TadeoSinay/planos_industrial_flama/referencias/Dimensionamiento Tecnico (3).docx

# Dimensionamiento Técnico

# Producto

# Procesos

A nivel listado de materiales los matafuegos en sus diferentes tamaños se componen de la cúpula (pieza embutida superior del matafuego), el cuerpo (chapa cilindrada) y el fondo (pieza embutida inferior). Todas ellas se procesan en paralelo con el objetivo de poder realizar la soldadura y ensamblaje y generar un buffer intermedio de cada uno de los semielaborados. Para todas las piezas únicamente para ABC realizadas a continuación se seleccionó un acero hipoeutectoide SAE 1010. Es un acero ordinario al carbono (perteneciente a la serie 10XX) con un muy bajo contenido de carbono, lo que le otorga una excelente ductilidad para ser embutido y soldado.

Sus componentes son Carbono (C): 0,08% - 0,13%, Manganeso (Mn): 0,30% - 0,60%, Fósforo (P): ≤ 0,040% (máximo), Azufre (S): ≤ 0,050% (máximo) y Hierro (Fe): El porcentaje restante (aproximadamente 99%), En el diagrama de hierro - carbono se ubica en el acero laminado en frío. En la escala de x se ubica en 0,10% de Carbono, lejos del punto eutectoide del 0,8% de carbono y su microestructura a temperatura ambiente (fase estable) está por debajo de la línea crítica inferior compuesto principalmente por ferrita (hierro alfa, muy blando y maleable) y perlita (láminas alternas de ferrita y cementita).

Fabricación de la cúpula del matafuego (formato 1, 2,5, 5, 10 kg ABC)

Se parte de una bobina de acero que se desenrolla como fleje continuo. Mediante un balancín, se corta un disco circular cuyo diámetro está calculado para conservar la superficie de chapa necesaria para la deformación plástica posterior. El sobrante de la tira, la bandera o scrap, es el material que queda alrededor del círculo recortado y va directo al chatarrero cómo recupero de chapa.

El disco se coloca sobre la matriz de embutido, cuya cavidad tiene tallada la forma negativa de la cúpula. El pisador sujeta el borde del disco con una fuerza controlada para evitar que la chapa se arrugue durante el flujo del material. El punzón desciende desde arriba y empuja el centro del disco hacia el interior de la cavidad, generando una deformación plástica progresiva. El borde periférico del disco fluye radialmente hacia adentro, se dobla sobre el radio de entrada de la matriz y se convierte en la virola, mientras el punzón le imprime al fondo la geometría levemente aplanada característica de la cúpula. Al finalizar el recorrido, el expulsor extrae la pieza de la cavidad.

Luego se punzona el orificio central donde irá el cuello, se le introduce un mandril simulando la válvula para marcar la posición angular de referencia, y finalmente el cuello se suelda a la cúpula en una soldadura orbital automática que rota la pieza 360° generando un cordón continuo y homogéneo apto para recipientes a presión.

PROPUESTA TÉCNICA (REVISAR CON ESPECIFICACIONES)

Sin conocer el diámetro exacto del disco ni el diámetro final de la cúpula no podemos calcular los valores reales, pero a modo orientativo para una cúpula de matafuego de 5 kg los órdenes de magnitud típicos son los siguientes.

La fuerza de embutido depende principalmente del perímetro del punzón, el espesor de chapa y la resistencia a la tracción del material. Para un acero SAE 1010 de 1.5 mm de espesor y un diámetro de punzón del orden de 130 mm, la fuerza de embutido ronda entre 70 y 100 kN. A esto se suma la fuerza del pisador, que suele representar entre el 20 y el 30% de la fuerza de embutido[^1] y resulta crítica para controlar el flujo del material sin generar arrugas ni adelgazamiento excesivo de la virola.

La holgura entre punzón y matriz se fija entre 1.1 y 1.3 veces el espesor de chapa, en este caso entre 1.65 y 1.95 mm, lo que permite el flujo del material sin reducir intencionalmente el espesor de la pared. El radio de entrada de la matriz suele ser entre 4 y 8 veces el espesor, es decir entre 6 y 12 mm, valor que condiciona directamente el riesgo de fractura en la zona de transición entre el fondo y la virola. La relación de embutido, definida como el cociente entre el diámetro del disco y el diámetro del punzón, no debe superar 2.0 para el SAE 1010[^2], límite a partir del cual sería necesario realizar la operación en dos o más pasadas con recocido intermedio.

Fabricación del cuerpo del matafuego (formato 2,5, 5, 10 kg ABC)

Se parte de una plancha de acero, cortada previamente en forma rectangular con las dimensiones exactas que determinarán el desarrollo plano del cilindro, es decir su longitud corresponde al perímetro final del cuerpo y su ancho a la altura del mismo.

Antes de cualquier conformado, la plancha plana recibe un grabado de identificación de lote mediante una estampa de punzonado. Un troquel con caracteres en relieve impacta sobre la superficie de la chapa generando una deformación plástica localizada que imprime la marca sin perforar el material. Esta operación se realiza sobre la chapa plana porque una vez conformado el cilindro resulta inaccesible para cualquier herramienta de estampado interior.

La plancha pasa luego a una roladora de tres rodillos, que es la máquina encargada de transformar la geometría plana en cilíndrica. Los tres rodillos están dispuestos en forma triangular: dos inferiores fijos que sirven de apoyo y uno superior regulable que ejerce la fuerza de curvatura descendiendo sobre la chapa. Al hacer pasar la plancha entre ellos, el rodillo superior aplica una carga perpendicular que supera el límite elástico del material generando una deformación plástica progresiva y continua a lo largo de toda la longitud de la chapa. La curvatura final depende de la distancia entre los rodillos inferiores y de la posición del rodillo superior. Cuanto más desciende este último, mayor es la curvatura impuesta. El proceso se regula hasta que los dos extremos de la plancha quedan enfrentados y alineados, conformando así un cilindro abierto en su costura longitudinal.

En este punto la pieza pasa a la etapa de soldadura. El operario presenta los extremos enfrentados de la plancha y ejecuta un cordón de soldadura longitudinal uniendo ambos bordes. Esta costura es la junta más crítica del cuerpo del matafuego ya que es la zona de mayor concentración de tensiones cuando el recipiente está bajo presión interna, razón por la cual la marca de la cúpula se alinea deliberadamente con ella durante el ensamble final para que la válvula no quede sobre esa línea. El resultado es un cilindro cerrado, con el cuerpo estructural del matafuego conformado y listo para recibir la cúpula y la base.

Fabricación del cuerpo del matafuego (formato 1 kg ABC)

En este caso, no se realiza ni numerado ni cilindrado. Se compran tubos de 6 metros de largo con un diámetro de 76 milímetros, los cuales se cortan con un largo de 2,25 metros para formar el cuerpo, sin requerir de soldadura longitudinal.

Fabricación del fondo del matafuego (formato 1, 2,5, 5, 10 kg ABC)

El proceso de obtención del fondo es análogo al de la cúpula. Se parte de la misma bobina, se corta un disco circular mediante balancín y el scrap resultante va directo al chatarrero. El disco se embute siguiendo el mismo principio ya descrito de deformación plástica progresiva con pisador, punzón y expulsor.

La diferencia respecto a la cúpula reside únicamente en la geometría de la matriz. El fondo es más simple, sin orificio central ni operaciones posteriores, y su curvatura cóncava hacia el interior del recipiente es más suave y uniforme, lo que garantiza una distribución homogénea de la presión interna en servicio. Al finalizar el recorrido del punzón el expulsor extrae la pieza y el proceso concluye.

Unión cuerpo y fondo (formato 1, 2,5, 5, 10 kg ABC)

Dado que el diámetro de la virola del fondo es ligeramente mayor que el diámetro interior del cuerpo, su inserción requiere una máquina con mandril expansor. El mandril ingresa contraído dentro de la concavidad del fondo, se expande radialmente hasta acoplar su geometría a la superficie interior del fondo y lo empuja axialmente desde la parte superior del cuerpo hacia abajo. La presión axial ejercida expande el diámetro del cuerpo lo suficiente para que la virola del fondo lo atraviese. Al llegar a su posición definitiva el cuerpo recupera su geometría por elasticidad y el fondo queda mecánicamente retenido por interferencia. En esta instancia no hay soldadura.

Bordoneado del extremo superior del cuerpo (formato 1, 2,5, 5, 10 kg ABC)

En el extremo superior del cuerpo, es decir el lado opuesto al fondo y abierto hacia el interior, se realiza un bordoneado mediante una máquina de rodillos. Un rodillo exterior y uno interior actúan simultáneamente sobre la pared del cilindro generando por deformación plástica localizada un resalto perimetral continuo hacia el interior del cilindro, sin remoción de material. Este reborde reduce localmente el diámetro interior del extremo superior y actúa como tope mecánico. Cuando la cúpula es presentada desde afuera, su pestaña apoya sobre ese reborde quedando retenida en posición y alineada respecto al cuerpo, a la espera de la soldadura orbital que completará la unión.

Soldadura del matafuego (formato 1, 2,5, 5, 10 kg ABC)

Una vez presentadas las tres piezas, fondo, cuerpo y cúpula, la unión estructural se realiza mediante dos procesos de soldadura MIG (GMAW) con alambre sólido ER70S-6 y gas de protección mixto 90% Argón / 10% CO₂. Este alambre de acero bajo carbono con alto contenido de manganeso y silicio garantiza cordones limpios, sin porosidad y con resistencia a la tracción mínima de 500 MPa según norma AWS A5.18, apto para recipientes a presión bajo norma IRAM 3523.

Vale aclarar que el matafuego de 1 kg no requiere de soldadura longitudinal, ya que su cuerpo proviene de tubos comprados directamente al proveedor. La descripción que sigue aplica a los modelos de acero SAE 1010: 1 kg versión acero, 2.5, 5 y 10 kg.

Soldadura longitudinal del cuerpo (formato 2,5, 5, 10 kg ABC)

La costura longitudinal, los dos bordes de la plancha enrollada que quedaron enfrentados, se ejecuta en una soldadora longitudinal automática de hilo continuo (linear seam welding machine). La máquina sujeta el cuerpo cilíndrico mediante mordazas de cobre que alinean y comprimen los bordes a tope, y un carro motorizado desplaza la antorcha MIG en dirección axial a velocidad constante y controlada por PLC (en axo welding) generando un cordón de penetración completa a lo largo de toda la junta. Las mordazas de cobre cumplen una doble función. Mantienen la alineación de los bordes y actúan como disipadores térmicos que evitan la deformación del cilindro por calor. Esta costura es la junta de mayor exigencia estructural del recipiente ya que trabaja bajo tensión circunferencial cuando el matafuego está presurizado.

El diámetro del alambre ER70S-6 se selecciona según el espesor de chapa de cada modelo. Para el de 1 kg acero (chapa ≈ 1.0 mm) se utiliza alambre de 0.6 mm con corriente de 40 a 80 A. Para los de 2.5 y 5 kg (chapa ≈ 1.5 mm) se utiliza 0.8 mm con corriente de 80 a 140 A. Para el de 10 kg (chapa ≈ 2.0 a 2.5 mm) se utiliza 0.8 o 1.0 mm con corriente de 100 a 180 A.

Soldadura circunferencial del fondo y la cúpula (formato 1, 2,5, 5, 10 kg ABC)

Las uniones perimetrales entre el fondo y el cuerpo, y entre la cúpula y el cuerpo, se ejecutan en una soldadura orbital automática de mandril rotante (circumferential seam welding machine). La pieza se posiciona sobre un eje motorizado que la hace rotar 360° a velocidad constante mientras la antorcha MIG permanece fija, generando un cordón circunferencial continuo y homogéneo. Se realizan dos pasadas orbitales. Una para el fondo en el extremo inferior y otra para la cúpula en el extremo superior, con el mismo criterio de selección de diámetro de alambre que la soldadura longitudinal. Con la finalización de estas dos soldaduras el matafuego queda conformado estructuralmente como recipiente cerrado y listo para prueba hidráulica, pintura y carga del agente extintor.

Prueba hidráulica de fabricación (PH de fábrica)

Es el ensayo que se realiza sobre cada recipiente recién soldado antes de salir de la línea de producción, según la norma IRAM 3523 (Matafuegos de polvo bajo presión manuales) con el método de ensayo definido en la norma IRAM 2587 (Cilindros y tubos de acero — Métodos de ensayo de presión hidrostática interna).

El recipiente se llena completamente con agua eliminando todo el aire interior y se lo conecta a una bomba hidráulica de pistón que eleva la presión interna de forma gradual y controlada hasta alcanzar la presión de ensayo de 3.5 MPa (35 kg/cm²), que equivale a 2.5 veces la presión de servicio nominal de 1.4 MPa. Estos valores están confirmados en las fichas técnicas oficiales de fabricantes con sello IRAM, como la del matafuego de 5 kg de Melisam[^3].La presión se mantiene durante el tiempo establecido por norma mientras el operario inspecciona visualmente la totalidad de la superficie del recipiente, prestando especial atención a las tres costuras soldadas. El recipiente aprueba si no presenta deformación permanente, fisuras, exudaciones ni pérdidas en ningún punto. El ensayo es obligatorio para el 100% de las unidades producidas y su resultado queda registrado individualmente, siendo requisito indispensable para obtener el sello IRAM 3523.

Granallado del cilindro ensamblado (formato 1, 2,5, 5, 10 kg ABC)

Una vez conformado y soldado el cuerpo del matafuego, la superficie exterior de acero presenta óxido, escama de laminación y residuos del proceso de soldadura que impedirían una correcta adhesión de la pintura. Para eliminarlos y generar el perfil de rugosidad necesario se realiza el granallado por turbina centrífuga en una cámara cerrada de tratamiento superficial.

El sistema utilizado es del tipo power and free. Los cilindros se cuelgan individualmente de ganchos que circulan suspendidos sobre un riel aéreo mediante un transportador de cadena, avanzando de forma continua e independiente a velocidad controlada a través de la cámara sin intervención del operario una vez cargada la línea.

Dentro de la cámara, las turbinas centrífugas accionadas por motores eléctricos aceleran la granalla mediante fuerza centrífuga. La granalla ingresa al centro de la turbina, un distribuidor la pre acelera hacia las paletas y es en las paletas donde adquiere la máxima velocidad de proyección, alcanzando valores típicos de industria de entre 60 y 90 m/s. A esa velocidad el impacto sobre el acero produce dos efectos simultáneos. Elimina óxido, escama y contaminantes, y genera una rugosidad superficial mediante deformación plástica localizada de la capa exterior, creando un perfil de anclaje que incrementa la superficie de contacto disponible para la pintura.

La granalla utilizada es granalla esférica de acero de alto carbono cuyas especificaciones de dureza, densidad y composición química están definidas por la norma ISO 11124-3, adoptada oficialmente en español por INTECO bajo la referencia INTE ISO 11124-2:2021. [^4]Esta norma establece que la granalla esférica de alto carbono debe contener entre 0,85 y 1,20% de carbono, con estructura interna de martensita revenida que le confiere alta resistencia al impacto repetido y permite su reutilización en cientos de ciclos. La granulometría utilizada para cilindros de este tipo corresponde a las denominaciones S330 o S390 (granalla esférica - centésimas de pulgada) según SAE J444, equivalentes a diámetros de aproximadamente 0,85 a 1,2 mm.

El grado de limpieza superficial obtenido corresponde al nivel Strahlmittelstrahlen (Sa- limpieza por proyección de abrasivo) 2.5 de la norma ISO 8501-1, adoptada oficialmente en español por AENOR bajo la referencia UNE-EN ISO 8501-1:2008 con el título "Preparación de substratos de acero antes de la aplicación de pinturas y productos relacionados. Evaluación visual de la limpieza de las superficies. Parte 1: Grados de óxido y de preparación de substratos de acero no pintados después de eliminar totalmente los recubrimientos anteriores". [^5]El nivel Sa 2.5 se define como granallado muy exhaustivo, con al menos el 95% de cada porción de la superficie libre de cualquier resto visible de óxido, escama o contaminante. El perfil de rugosidad resultante, medido como altura pico a valle (Rz) según norma ISO 8503, se sitúa típicamente entre 40 y 70 micrones para granalla S330/S390 sobre acero de 1,5 mm, rango que garantiza adherencia mecánica adecuada sin generar valles tan profundos que la pintura no alcance a cubrir los picos, lo que derivaría en corrosión prematura.

La granalla no se desperdicia, ya que la cámara cuenta con un sistema de recuperación mecánica continua que recoge, tamiza y recircula el abrasivo, separando los finos agotados y reponiendo únicamente el material en condiciones de uso.

En cuanto a la disposición final de los residuos generados por el proceso, la granalla desgastada y los finos separados por el tamiz son chatarra ferrosa sin carácter peligroso y se entregan al chatarrero como desperdicio final del proceso. El polvo capturado por el colector de mangas, en cambio, contiene partículas finas de óxido, escama y contaminantes superficiales y puede clasificar como residuo especial según la Ley Provincial 11.720 de Residuos Especiales, reglamentada por el Decreto 806/97, que rige en el Partido de Avellaneda como en todo el territorio bonaerense[^6]. Bajo esta normativa, disponible en, el generador está obligado a inscribirse en el Registro de Generadores de Residuos Especiales de la Provincia de Buenos Aires, presentar declaración jurada anual ante el OPDS (Organismo Provincial para el Desarrollo Sostenible) y contratar el retiro, transporte y disposición final del polvo únicamente con operadores y transportistas habilitados por la Provincia, utilizando el manifiesto de transporte establecido por la Resolución 118/11 como documento de trazabilidad obligatorio de cada movimiento de residuo.

Corrección de defectos (formato 1, 2,5, 5, 10 kg ABC)

Es una etapa menor dentro del flujo, de intervención acotada y baja incidencia en el tiempo de ciclo. Durante las soldaduras puede generarse salpicadura, es decir gotas del baño de fusión que saltan durante el arco y solidifican adheridas sobre la superficie exterior, por fuera del cordón. Es un fenómeno intrínseco al MIG/MAG en transferencia por cortocircuito o globular con mezcla rica en CO₂, de aparición intermitente y posición no predecible, por lo que su detección es visual. odos los formatos comparten este fenómeno en la medida en que tienen costura soldada. El de 1 kg, cuyo cuerpo proviene de tubo de acero al carbono SAE 1010 sin costura longitudinal, solo presenta salpicadura en las soldaduras circunferenciales del fondo y la cúpula, no en la generatriz, por lo que su corrección es de menor extensión que la de los formatos cilindrados de 2,5, 5 y 10 kg.

La remoción se resuelve de forma escalonada, con el granallado como operación principal. La mayor parte de la salpicadura (gotas finas y residuo superficial) se elimina durante el granallado, donde el impacto de la granalla a 60–90 m/s remueve las proyecciones de soldadura junto con el óxido y la escama de laminación. En consecuencia, esta etapa se limita al retiro puntual de la salpicadura adherente de mayor tamaño que haya sobrevivido, mediante un golpe seco de cincel (cortafierro) y martillo, ejecutado manualmente por un operario. La herramienta manual se justifica por el carácter intermitente y de posición variable del defecto, que no amortiza una estación automática, y porque el cincel actúa solo sobre la gota superpuesta de unión débil, sin desgastar metal base ni comprometer el espesor de diseño en paredes de 1 a 2,5 mm de recipiente a presión.[^7] El retoque se realiza sobre áreas mínimas y aisladas, sin afectar la preparación superficial del conjunto previa al pintado.

La relevancia de esta etapa depende directamente de la calidad de la soldadura aguas arriba: con transferencia por MIG pulsado y una mezcla de mayor contenido de argón (ver criterio de gas de protección), el volumen de salpicadura se reduce sensiblemente y la corrección tiende a limitarse a un control visual con retoque esporádico.[^8]

Criterio de selección del gas de protección (90/10 Ar/CO₂)

Para las costuras de los formatos de menor espesor se adopta una mezcla de protección 90/10 argón/CO₂, en lugar de la mezcla de propósito general 75/25 (C25). El criterio combina comportamiento de arco, costo y propiedades mecánicas.

En chapa fina, una mayor proporción de argón produce un arco más suave y una mínima generación de salpicadura, mientras que la C25 entrega salpicadura sólo relativamente baja; el CO₂ en mayor proporción vuelve el arco más errático, al punto que el CO₂ puro genera entre 25 y 40% más salpicadura que la 75/25. [^9] Menor salpicadura implica menor limpieza posterior, que es donde está el costo real: en la estructura de costos de soldadura el gas representa apenas un 2–5% del total y la mano de obra es el rubro dominante,[^10] de modo que un incremento menor en el precio del gas se compensa con creces al reducir el retrabajo. Un caso documentado del cambio de C25 a 90/10 registró un leve aumento del costo de gas frente a una reducción del costo total del trabajo del orden del 21%, por menor amolado y menos horas de mano de obra. [^11]

La elección no se lleva al extremo de argón puro por dos razones. Primero, el argón puro sobre acero desestabiliza el arco y produce mala calidad de soldadura, por lo que las mezclas para acero al carbono se mantienen en el rango de 75 a 95% de argón. [^12] Segundo, la composición del gas afecta las propiedades mecánicas: un mayor contenido de argón eleva la resistencia a la tracción y a la fluencia pero reduce la ductilidad, mientras que un mayor contenido de CO₂ mejora la ductilidad y la resistencia a la fisuración. [^13] Para un recipiente a presión, donde se requiere resistencia junto con tenacidad, el óptimo cae en una mezcla balanceada del tipo 85/15 a 90/10, que concilia arco estable, mínima salpicadura, bajo aporte térmico apto para chapa fina y un compromiso mecánico adecuado.

Pintado matafuego granallado (formato 1, 2,5, 5, 10 kg ABC)

Antes de aplicar la pintura el cuerpo del matafuego pasa por una etapa de pretratamiento químico que consta de dos pasos en túnel continuo integrado al sistema power and free. El primero es el desengrasado. La superficie granallada, aunque visualmente limpia, puede presentar trazas de aceite de embutido, lubricantes de soldadura y humedad residual que comprometerían la adherencia de la pintura y alterarían la conductividad eléctrica necesaria para el proceso electrostático. Se aplica un agente desengrasante alcalino por aspersión mientras la pieza avanza suspendida del riel. El segundo paso es el fosfatizado de hierro. Se deposita sobre el acero una capa microcristalina de fosfato que cumple una doble función, generar un perfil de anclaje químico que complementa el perfil mecánico obtenido por granallado, y crear una barrera pasivante que inhibe la oxidación bajo la película de pintura. Ambas etapas se ejecutan en el túnel de aspersión y van seguidas de enjuagues intermedios y un enjuague final antes de ingresar a la cámara de pintura.

La pintura utilizada es pintura en polvo de base poliéster termofija aplicada por el método electrostático en cámara cerrada. El proceso electrostático requiere que la pieza esté conectada a tierra y que su superficie tenga la rugosidad adecuada para que las partículas de polvo cargadas eléctricamente se adhieran de forma mecánica y electrostática antes del curado. Las partículas son cargadas en la pistola pulverizadora y proyectadas hacia el cilindro, generando una atracción que adhiere el polvo de forma uniforme sobre toda la superficie. El polvo no adherido es recuperado por el sistema de la cámara y reutilizado, con una eficiencia de transferencia superior al 90%.

El color es rojo, obligatorio por la norma IRAM 3523 para matafuegos de polvo bajo presión, con la referencia cromática definida en la norma IRAM-DEF D 1054 (Carta de colores para pinturas). La norma IRAM 3517-2 aclara explícitamente que se admiten pequeñas diferencias de tonalidad propias del proceso de fabricación, siendo las muestras de color puestas a disposición del IRAM. En la práctica industrial argentina el rojo aplicado en matafuegos de acero corresponde al RAL 3000 (rojo fuego) como referencia orientativa no obligatoria. Los recipientes de aluminio o acero inoxidable pueden entregarse sin pintar según la misma norma.

El espesor de capa varía según el tamaño del matafuego. Para los modelos de 1 y 2,5 kg se aplica entre 60 y 80 micrones, y para los de 5 y 10 kg entre 80 y 120 micrones. Un espesor insuficiente compromete la resistencia a la corrosión y al impacto; uno excesivo puede generar acumulaciones en bordes y soldaduras y dificultar el curado uniforme.

Una vez aplicado el polvo la pieza ingresa al horno de curado. La temperatura se sitúa entre 180 y 200°C y el tiempo de permanencia es de entre 10 y 20 minutos, parámetros dentro de los cuales el polvo se funde, nivela y polimeriza formando una película continua, homogénea y químicamente reticulada e irreversible. Los matafuegos de mayor masa térmica como el de 10 kg requieren un tiempo de residencia levemente mayor para asegurar que toda la pared del cilindro alcance la temperatura de curado de forma homogénea. El control de tiempo y temperatura se realiza mediante PLC con termocuplas en distintos puntos del horno para evitar el sobrecurado, que produce amarillamiento, pérdida de brillo y degradación de las propiedades mecánicas de la película.

Rellenado y conformado final del PT (formato 1, 2,5, 5, 10 kg ABC)

Con el matafuego pintado y enfriado comienza la etapa de rellenado y ensamblado final, que transforma el recipiente vacío en un equipo operativo listo para su uso.

El primer paso es la carga del polvo químico. Con la boca superior del cuerpo libre, se introduce el agente extintor, polvo químico seco ABC a base de fosfato monoamónico (MAP), por gravedad y vibración hasta alcanzar el peso de carga nominal correspondiente a cada modelo. El polvo debe cumplir con la norma IRAM 3569 para fuegos clase ABC. La carga se realiza antes de colocar la válvula porque una vez roscada el acceso a la boca queda bloqueado.

El segundo paso es el ensamblaje de la válvula. La válvula llega a la línea de ensamblado como un conjunto pre-ensamblado que integra el tubo pescante, el manómetro y el accionador. El tubo pescante es un caño que llega hasta el fondo del recipiente y conduce el polvo desde la base del cilindro hacia la válvula cuando el equipo se activa. Su material se selecciona en función del tamaño del modelo y las propiedades del agente extintor, siguiendo el criterio técnico de que el material debe siempre elegirse en base a los requisitos normativos y a las propiedades del agente extintor utilizado.[^14] En los modelos de 1 y 2,5 kg el tubo pescante puede fabricarse en PVC o PEAD (polietileno de alta densidad). Su menor longitud y la presión relativa del equipo permiten que estos materiales poliméricos mantengan la geometría sin deformaciones durante la vida útil del equipo, siendo además inertes frente al fosfato monoamónico y de menor peso y costo que el acero. En los modelos de 5 y 10 kg el tubo pescante es de acero al carbono SAE 1010, el mismo grado utilizado en el cuerpo del recipiente, cuya selección se justifica por la mayor longitud del caño necesaria para alcanzar el fondo de un cilindro más alto. A esa longitud, el PVC y el PEAD no garantizan la rigidez estructural suficiente para mantener el extremo inferior en contacto permanente con el polvo del fondo bajo presión interna sostenida de 1.4 MPa durante los 20 años de vida útil del equipo, mientras que el acero al carbono lo hace sin deformación, sin reacción química con el agente extintor y dentro del rango de temperaturas de operación de -20°C a +60°C exigido por norma. La ASTM A513, norma de referencia para tubos mecánicos de acero al carbono soldados y sin costura, define las especificaciones de resistencia y dimensionales del material empleado[^15].

El manómetro, con sello IRAM 3533 según norma ABNT NBR 15808, debe estar montado en el conjunto antes de roscar, ya que es el único indicador disponible para verificar la presión en el paso siguiente. Todo el conjunto se rosca sobre la boca de la cúpula con rosca M30, ajustándose con torque controlado para garantizar el sello hermético mediante el o-ring de caucho sintético alojado en el asiento de la válvula de latón cobreado forjado.

El tercer paso es la presurización con nitrógeno seco. A través de la válvula ya roscada se inyecta nitrógeno seco hasta alcanzar la presión de servicio de 1.4 MPa (14 kg/cm²). Se utiliza nitrógeno seco y no aire comprimido porque es un gas inerte que no aporta humedad al interior del recipiente, evitando la aglomeración del polvo y la corrosión interna del cilindro.

El cuarto paso es el ensamblaje de la manguera. La manguera de descarga, fabricada en caucho sintético resistente a los rayos UV, se monta por separado sobre el cuerpo del matafuego. En su extremo lleva la tobera o lanza de plástico industrial negro por donde se proyecta el polvo al accionar el equipo.

El quinto paso es la colocación del precinto de seguridad. Se inserta un anillo plástico sobre la válvula que impide su accionamiento accidental. El precinto no indica vencimiento ni año de mantenimiento a diferencia del marbete, sino que certifica que el equipo no fue utilizado ni manipulado desde su fabricación o recarga.

Etiquetado normalizado IRAM y QR (formato 1, 2,5, 5, 10 kg ABC)

La estación de etiquetado es la última etapa del proceso productivo antes de la distribución. Las etiquetas son de material plástico con tratamiento hidrofóbico, resistentes a la humedad, a los agentes químicos del entorno y al contacto con el polvo extintor, garantizando su legibilidad durante toda la vida útil del equipo de 20 años establecida por la Resolución 349/07[^16]

El contenido, formato y dimensiones de la placa de características están regulados por la norma IRAM 3534 (Matafuegos manuales y sobre ruedas — Placas de características), que establece que la placa debe ser proporcional a las dimensiones del cuerpo del equipo y contener información legible a la distancia de uso normal. Esto implica que la etiqueta varía físicamente entre modelos. El de 1 kg, al tener un cilindro notoriamente más pequeño en diámetro y altura, admite una placa de menor superficie que los de 5 y 10 kg, cuyos cilindros de mayor diámetro permiten y exigen una placa más grande que garantice legibilidad de todos los datos reglamentarios sin reducción de tipografía por debajo de los mínimos normativos. El contenido obligatorio, sin embargo, es idéntico para todos los formatos

Cada equipo recibe las siguientes identificaciones reglamentarias según las normas IRAM 3523 y 3534 y la Resolución 349/07. El cuerpo del matafuego lleva grabada de fábrica la marca del fabricante, el número de serie y los dos últimos dígitos del año de fabricación, acuñados directamente sobre el acero. La etiqueta principal contiene el tipo de agente extintor, las clases de fuego para las que es apto (A, B y C), las instrucciones de uso, la presión de servicio de 1.4 MPa, el peso de carga nominal específico de cada modelo, la fecha de fabricación, la vida útil máxima de 20 años y las leyendas obligatorias exigidas por norma, entre ellas "Presurizar únicamente con nitrógeno seco" y "El contenido de este matafuego está bajo presión".

La tarjeta de identificación DPS es el documento de trazabilidad exigido por el OPDS para los equipos fabricados, comercializados o recargados en el ámbito de la Provincia de Buenos Aires. No es una calcomanía sobre el cuerpo sino un documento independiente que acompaña al equipo y avala que el fabricante está inscripto en el Registro de Fabricantes, Recargadores y Comercializadores del OPDS[^17]. Para equipos comercializados en Ciudad de Buenos Aires la tarjeta equivalente es la tarjeta GCBA, generada a través del Sistema Digital de Gestión del Gobierno de la Ciudad, que incluye un código QR de lectura y validación de datos que permite verificar la identidad del fabricante, el número de serie del equipo y la trazabilidad del proceso, según lo establece el Registro de Fabricantes de Extintores de la Ciudad [^18]

Con el etiquetado completo el matafuego queda conformado, identificado, trazable y listo para su distribución y uso.

Proceso de fabricación de matafuegos rodantes ABC (formatos 25, 50, 70 y 100 kg)

Materia prima y recepción de la chapa (formatos 25, 50, 70 y 100 kg ABC)

El proceso comienza con la chapa. Cada formato parte de una plancha de acero SAE 1010 laminado en caliente cuyo espesor y dimensiones varían según la capacidad del equipo. Los de 25 kg se fabrican con chapa de 490 × 858 mm de 3,2 mm de espesor, los de 50 kg con chapa de 640 × 994 mm también de 3,2 mm, mientras que los de 70 y 100 kg, sometidos a mayores solicitaciones, usan chapa de 4,75 mm en planchas de 680 × 1212 mm y 900 × 1212 mm respectivamente. En todos los casos el largo de la plancha equivale al perímetro exterior del cilindro, que se obtiene multiplicando π por el diámetro exterior, y el ancho corresponde a la altura del cuerpo. La elección del laminado en caliente no es casual. Los espesores de 3,2 y 4,75 mm superan el límite del laminado en frío, que en Argentina llega hasta 3,0 mm según el catálogo de Ternium, de modo que el laminado en caliente, que cubre de 2,0 a 12,50 mm, es el único proceso capaz de proveer estas paredes. La chapa llega a la planta ya cortada a medida por el proveedor de acero, apilada como plancha plana cruda y lista para conformar. Solicitarla cortada evita tener que instalar una guillotina de gran porte para chapa gruesa y reduce el scrap de corte.

Cilindrado y cerrado del cuerpo (formatos 25, 50, 70 y 100 kg ABC)

La primera operación sobre la chapa es el cilindrado. La plancha entra a la roladora de tres rodillos, donde el rodillo superior ejerce una carga perpendicular que supera el límite elástico del acero y curva la chapa de forma progresiva y continua hasta que sus dos extremos se enfrentan y forman el cilindro. Como el espesor de los rodantes es mucho mayor que el de los manuales, la resistencia a la curvatura es también mayor, por lo que la cilindradora debe estar dimensionada para trabajar hasta 4,75 mm en anchos de hasta 900 mm. El operario ajusta la posición del rodillo superior hasta lograr el diámetro nominal de cada formato y verifica que la junta cierre correctamente.

Varilla de refuerzo (formatos 70 y 100 kg ABC)

En los formatos de 70 y 100 kg, de mayor diámetro y espesor, se coloca una varilla de refuerzo en el interior del cilindro, dispuesta longitudinalmente, durante el cilindrado. Esa varilla cumple una doble función. Por un lado rigidiza la generatriz del cuerpo, aportando resistencia estructural a un recipiente que, por su mayor tamaño, está sometido a mayores esfuerzos. Por otro lado, y sobre todo durante el conformado, mantiene alineados los dos bordes de la plancha mientras el cilindro se cierra, impidiendo que las puntas del cilindrado se desacoplen o se corran una respecto de la otra antes de fijarlas con el punteo. Es la referencia que garantiza que la junta longitudinal quede bien enfrentada para la soldadura posterior. En los formatos de 25 y 50 kg no se incorpora, porque su menor diámetro y espesor le dan a la propia chapa la rigidez suficiente para sostener la alineación de los bordes sin ayuda.

Punteo del cilindrado (formatos 25, 50, 70 y 100 kg ABC)

Con el cilindro cerrado y los bordes enfrentados, se ejecuta el punteo. Son cordones cortos y espaciados de soldadura a lo largo de la junta longitudinal que fijan la posición de los dos bordes y mantienen la geometría del cilindro mientras la pieza avanza hacia la soldadura definitiva. El punteo no es todavía la unión estructural, sino una fijación previa que evita que la junta se abra o se desalinee durante la manipulación. En los formatos de 70 y 100 kg, que llevan varilla, el punteo fija además la penetración sobre esa varilla interior, cuya fusión queda visible desde afuera del cilindro y sirve como indicador de control de que la unión quedó bien hecha.

Recepción de tapas tercerizadas, fondo y cúpula (formatos 25, 50, 70 y 100 kg ABC)

Mientras el cuerpo avanza, las tapas llegan por otro camino. El fondo y la cúpula no se fabrican en planta, sino que se reciben ya embutidos de un proveedor externo. El fondo es la tapa cóncava que cierra el extremo inferior y la cúpula es la tapa convexa superior, que llega con el cuello roscado ya soldado, también provisto por el mismo proveedor. Ambas piezas vienen conformadas en acero SAE 1010 del mismo espesor que el cuerpo y sin pintar, listas para ensamblar. El cuello roscado es la pieza tubular de acero, con rosca interior mecanizada, donde luego se enrosca la válvula. Esa rosca es NF 1¼ en el formato de 25 kg y BSP 2½ en los de 50, 70 y 100 kg, según el caudal de descarga y el diámetro de válvula que pide cada capacidad, y llega soldada a la cúpula con un cordón perimetral continuo que asegura la hermeticidad, ya que es un punto que soporta la presión interna del recipiente.

Colocación de tapas y soldadura longitudinal y circunferencial (formatos 25, 50, 70 y 100 kg ABC)

Reunidos el cuerpo cilindrado y punteado y las dos tapas, se pasa al ensamblado y a la soldadura estructural definitiva. El fondo se apoya y se puntea en el extremo inferior y la cúpula, con su cuello, en el superior. Una vez presentadas y fijadas ambas tapas, se ejecutan las tres soldaduras que dan integridad al recipiente. La longitudinal completa la costura del cuerpo que hasta entonces solo estaba punteada, generando un cordón continuo de penetración total a lo largo de toda la generatriz. Las dos circunferenciales unen el fondo y la cúpula al cuerpo mediante cordones perimetrales continuos, rotando la pieza 360° en cada junta. Todas se ejecutan por proceso MIG con alambre sólido ER70S-6, ajustando los parámetros al espesor. En los formatos de 70 y 100 kg, de 4,75 mm, se usa alambre de 1,2 mm con corriente de 200 a 280 A y tensión de 19 a 22 V, mientras que en los de 25 y 50 kg, de 3,2 mm, se baja a alambre de 1,0 mm con corriente de 130 a 180 A y tensión de 17 a 20 V. El mayor aporte térmico de los formatos gruesos es imprescindible para lograr penetración completa, porque una costura mal penetrada comprometería la integridad del recipiente bajo la presión de ensayo de 4,0 MPa. En todos los casos el gas de protección es la mezcla de 90% argón y 10% CO₂, elegida por su menor salpicadura, su arco estable en espesores medios y las propiedades mecánicas que exige un recipiente a presión según la norma AWS A5.18.

Mesa de armado de la estructura del carro (formatos 25, 50, 70 y 100 kg ABC)

Terminada la soldadura, el recipiente pasa a la mesa de armado, donde se le incorpora la estructura que lo convierte en carro. Allí se monta la manija, el arco tubular de acero con el que se maniobra el equipo, el eje de las ruedas, que se fija en la parte inferior del cuerpo, y los ganchos portamanguera, los soportes sobre los que se enrolla la manguera. Estos elementos se sueldan o se fijan mecánicamente al cuerpo según el diseño de cada formato. Que esta operación vaya antes de la prueba hidráulica y no después no es un detalle menor. Como el armado implica soldar sobre el recipiente, y toda soldadura debe quedar validada por el ensayo de presión, el orden correcto es armar primero y ensayar después, de manera que la prueba hidráulica verifique el conjunto completo, incluidas las zonas que el calor de esas soldaduras pudo afectar. Hacer el armado después del ensayo lo invalidaría.

Prueba hidráulica de fabricación (formatos 25, 50, 70 y 100 kg ABC)

El ensayo hidrostático de los rodantes se rige por la norma IRAM 3550, con el método definido en IRAM 2587. La presión de ensayo es de 4,0 MPa, es decir 40 kg/cm², por encima de los 3,5 MPa que se aplican a los formatos manuales bajo la norma IRAM 3523. Esa diferencia se explica porque la norma fija la presión de prueba en función del diámetro y la capacidad del recipiente, y los rodantes, más grandes, soportan mayores esfuerzos de membrana bajo presión interna. El procedimiento consiste en llenar el recipiente por completo con agua, eliminar el aire interior, elevar la presión de forma gradual con una bomba hidráulica de pistón hasta la presión de ensayo, mantenerla durante el tiempo que fija la norma e inspeccionar visualmente toda la superficie, con especial atención a las tres costuras soldadas, a la unión del cuello con la cúpula y a las zonas donde se soldaron la manija y los soportes. El recipiente aprueba si no muestra deformación permanente, fisuras, exudaciones ni pérdidas en ningún punto. El ensayo es obligatorio para el cien por ciento de las unidades y su resultado se registra individualmente, como requisito indispensable para obtener el sello IRAM 3550.

Pintura tercerizada (formatos 25, 50, 70 y 100 kg ABC)

El recipiente ya ensayado se envía a una fábrica externa especializada en pintura, donde recibe el tratamiento superficial y el pintado. El color rojo es obligatorio por la norma IRAM 3550, con la referencia cromática que define la norma IRAM-DEF D 1054. Una vez pintado, el recipiente vuelve a la planta para el ensamblado final.

Ensamblado final del producto terminado (formatos 25, 50, 70 y 100 kg ABC)

Con el recipiente pintado y de regreso en la planta, empieza el ensamblado final, la etapa que lo convierte en un equipo operativo. Comprende la carga del polvo químico, el montaje de la válvula con su tubo pescante, la colocación de la manguera, el montaje de las ruedas y la aplicación de los calcos. La carga del polvo químico seco ABC a base de fosfato monoamónico, conforme la norma IRAM 3569, se hace por la boca del cuello hasta alcanzar el peso nominal de cada formato. Luego se monta la válvula de latón forjado, que llega como conjunto preensamblado con el tubo pescante, el manómetro con sello IRAM 3533 y el accionador. El tubo pescante de los rodantes es de tubo estructural de acero al carbono de gran sección de paso, porque el mayor caudal de descarga que exigen los tiempos de vaciado de estos formatos, de entre 40 y 85 segundos, necesita una sección interior más amplia que la de los manuales. La válvula se enrosca sobre el cuello de la cúpula, con rosca NF 1¼ en el de 25 kg y BSP 2½ en los de 50, 70 y 100 kg, y el conjunto se presuriza con nitrógeno seco hasta la presión de servicio de 1,4 MPa, verificada en el manómetro. La manguera de descarga es de caucho sintético resistente a los rayos UV, de 5 metros con tobera de empuñadura y gatillo para los formatos de 25, 50 y 70 kg, y de 12 metros para el de 100 kg, cuya mayor longitud responde al alcance operativo que se necesita en las instalaciones industriales de alto riesgo a las que se destina, donde el operario debe mantener distancia del foco sin mover el equipo. Las ruedas se montan sobre el eje que ya quedó fijado en la mesa de armado, con diámetros que van de unos 300 mm en el de 25 kg hasta 500 mm en el de 100 kg. Por último se aplican los calcos, las etiquetas autoadhesivas con la información reglamentaria, las instrucciones de uso y las leyendas obligatorias.

Etiquetado y certificación (formatos 25, 50, 70 y 100 kg ABC)

El etiquetado sigue los criterios de la norma IRAM 3550 para matafuegos sobre ruedas. La placa de características lleva la presión de servicio de 1,4 MPa, la presión de ensayo de 4,0 MPa, el peso de carga nominal, la vida útil máxima de 20 años y las leyendas obligatorias. A eso se suman las certificaciones que exige la comercialización en Argentina. El sello IRAM 3550 avala la conformidad con la norma de fabricación. La tarjeta de identificación DPS del OPDS es el documento de trazabilidad para los equipos fabricados en la Provincia de Buenos Aires y acredita la inscripción del fabricante en el Registro de Fabricantes, Recargadores y Comercializadores. La tarjeta GCBA con código QR corresponde a los equipos que se comercializan en la Ciudad de Buenos Aires, según la Ordenanza 40473. Y el Certificado de Homologación de Autopartes de Seguridad, el CHAS, exigido por la Resolución 91/2001 de la Secretaría de Industria, es una certificación propia del componente carro y sus ruedas que no aplica a los formatos manuales.

Componentes y procesos tercerizados (formatos 25, 50, 70 y 100 kg ABC)

En la línea de rodantes hay tres etapas que se resuelven fuera de la planta, y cada una responde a una razón técnica y económica concreta.

La primera es el embutido de las tapas, fondo y cúpula. Conformar por embutido profundo discos de gran diámetro y espesor exige una prensa hidráulica de gran porte. En el caso más exigente, el fondo del formato de 100 kg, con un punzón de alrededor de 406 mm de diámetro y 4,75 mm de espesor en acero SAE 1010 laminado en caliente, de resistencia a la tracción de entre 310 y 400 MPa, la fuerza de embutido calculada con la fórmula F = π × d × e × Rm × factor ronda los 1.720 kN, es decir unas 175 toneladas. Eso obliga a una prensa de al menos 200 toneladas, muy por encima de las 50 a 80 toneladas que bastan para los manuales. Si se le suma que cada formato necesita su propio troquel de gran porte y alto costo, y que el volumen de rodantes es mucho menor que el de manuales, amortizar esa prensa y sus troqueles dentro de la planta no cierra. Un proveedor especializado en embutido de gran formato reparte esa inversión entre varios clientes y entrega la pieza a un costo menor que el de fabricarla en casa.

La segunda es el cuello roscado de la cúpula. Mecanizar una rosca NF 1¼ o BSP 2½ con la precisión que exige la hermeticidad de un recipiente a presión requiere torno y control de rosca, un proceso de mecanizado por arranque de viruta que no tiene nada que ver con el resto de la línea, basada en conformado y soldadura. Poner un torno y un operario calificado solo para esa pieza no se justifica cuando el mismo proveedor de las tapas la entrega ya mecanizada y soldada a la cúpula.

La tercera es la pintura, que se hace en una fábrica externa, y tiene una particularidad técnica importante frente a los manuales, porque ese proveedor no granalla sino que trata la superficie por quemado. Conviene explicar por qué. El granallado proyecta granalla de acero a alta velocidad para arrancar óxido y escama y dejar el perfil de rugosidad Sa 2.5 que ancla la pintura en polvo electrostática. Ese esquema está pensado para la chapa laminada en frío de los manuales, de superficie más limpia y espesor fino, cuya pintura poliéster se cura en horno a entre 180 y 200°C. Los rodantes, en cambio, son de chapa laminada en caliente y mayor espesor, con una escama de laminación más gruesa y adherida. El proveedor de pintura de los rodantes trabaja con un sistema por quemado, en el que el calor elimina escama, óxido y contaminantes por combustión y desprendimiento térmico en lugar de arrancarlos mecánicamente con granalla, un método que se ajusta mejor a las piezas grandes y gruesas de estos formatos y que no necesita cámara de granallado ni sistema de recuperación de abrasivo. Por eso la línea de rodantes de la planta propia no incluye granallado, ni pretratamiento químico, ni cabina de pintura, ni horno de curado. Toda esa etapa se traslada al proveedor externo, lo que saca cuatro puestos del dimensionamiento de la línea y reduce de manera significativa la inversión en equipamiento propio para estos formatos.

Aclaraciones técnicas del proceso

Prueba hidráulica de mantenimiento (PH periódica)

Es el ensayo que se realiza sobre el matafuego ya en uso, a cargo de un Prestador de Servicio de Mantenimiento (PRS) habilitado, según la norma IRAM 3517-2 (Extintores manuales y sobre ruedas — Dotación, control, mantenimiento y recarga).[^19]

Para matafuegos de polvo ABC bajo presión, la norma IRAM 3517-2 (edición 2020) establece que la PH periódica debe realizarse cada 5 años como máximo[^20].

El PRS despresuriza el equipo, retira la válvula, limpia completamente el interior eliminando todo rastro de polvo, llena el recipiente con agua y eleva la presión hidrostática hasta 3.5 MPa mediante bomba. A diferencia de la PH de fabricación, esta instancia incluye también una inspección interna del recipiente para detectar corrosión, picaduras, deformaciones por uso o manipulación y daños no visibles externamente. La presión de prueba aplicable es la que fija la norma de fabricación de cada tipo de extintor, para polvo ABC es la misma de fábrica. Si el recipiente se aprueba, el PRS estampa en el chasis los datos y la fecha de la PH mediante lápiz vibratorio y coloca la oblea reglamentaria, habilitando el equipo por 5 años más. Si reprueba, el matafuego debe ser inutilizado y dado de baja conforme al Anexo G de la norma. La vida útil máxima de los matafuegos ABC de hasta 10 kg es de 20 años, cumplida la cual deben ser retirados de servicio independientemente de su estado aparente.

Sobrepresurización y Subpresurización del matafuego rellenado

El matafuego de polvo bajo presión no cuenta con disco de ruptura ni válvula de alivio integrada. El único indicador de presión interna es el manómetro. Esto implica que si durante la presurización se supera la presión de servicio nominal de 1.4 MPa, el exceso no tiene mecanismo de liberación automática y representa un riesgo estructural para el recipiente. El mismo riesgo opera en sentido inverso, una subpresurización produce un equipo que no descargará el polvo con la potencia ni el alcance requeridos por norma, resultando ineficaz en una emergencia real.

La prevención de ambas condiciones se resuelve por tres mecanismos técnicos simultáneos. El primero es la estación de carga con regulador de presión calibrado. La línea de nitrógeno cuenta con un regulador que limita mecánicamente la presión máxima de salida al valor de consigna, impidiendo físicamente que se inyecte más presión de la establecida independientemente del tiempo de carga. El segundo es el manómetro patrón de referencia, la Resolución 349/07 del Ministerio de Ambiente de la Provincia de Buenos Aires establece en su artículo 20 que los fabricantes deben contrastar sus manómetros operativos con un manómetro patrón calibrado cada 15 días como mínimo[^21], asentando los resultados en planillas destinadas a tal fin.

Esta obligación garantiza que la presión indicada durante la carga sea la presión real y no una lectura errónea por deriva del instrumento. El tercero es el control visual del manómetro del equipo, una vez completada la carga el operario verifica que la aguja indique zona verde antes de liberar el equipo. Si la aguja queda fuera de zona verde en cualquier sentido el equipo no puede avanzar a la siguiente etapa y debe corregirse la presión.

En caso de sobrepresurización el riesgo principal es la falla del recipiente bajo presión interna excesiva, lo que puede derivar en una ruptura violenta del cuerpo de acero. En caso de subpresurización el riesgo es un equipo que aparentemente está operativo pero que en uso real no tendrá la presión necesaria para expulsar el polvo de forma efectiva. Ambos escenarios comprometen la seguridad del usuario y el cumplimiento de la norma IRAM 3523.

Cambio de matriz entre formatos (formato 1, 2,5, 5, 10 kg ABC)

Cada vez que la línea pasa de fabricar un formato a otro cambian las dimensiones del disco, del cuerpo y de la cúpula, lo que requiere intervenciones específicas en cada máquina. A continuación se describe el procedimiento de cambio en cada etapa del proceso.

Balancín - troquel de corte del disco

Cuando cambia el diámetro del disco se reemplaza el conjunto troquel completo, es decir el punzón y la matriz de corte como una unidad, ya que el juego de corte entre ambos está calculado específicamente para el diámetro y el espesor de chapa de cada formato. No es posible reutilizar solo uno de los dos componentes porque la holgura entre punzón y matriz es la variable que determina la calidad del corte y el acabado del canto del disco. Un juego incorrecto genera rebabas excesivas o deformación que afectan el embutido posterior. El conjunto se retira de la prensa como un bloque montado sobre su porta-herramientas y se reemplaza por el correspondiente al nuevo formato. El operario verifica la holgura correcta y ajusta el recorrido (carrera) de la prensa antes de retomar la producción[^22]

Prensa de embutido — troquel de embutido

Cuando cambia el formato se reemplaza el troquel de embutido completo. Punzón, matriz y pisador conforman un conjunto montado sobre una placa porta-herramientas que se instala y retira de la prensa como una unidad, según la práctica estándar de la industria para prensas de embutido profundo[^23][^24]. El cambio por unidad completa es necesario porque cada componente del troquel, radio del punzón (Rp), radio de la matriz (Rd), holgura y geometría del pisador, está calculado en función del diámetro y la profundidad de la pieza específica. Intercambiar componentes sueltos entre troqueles de distintos formatos introduciría incompatibilidades geométricas que derivarían en defectos de arrugado, desgarro o adelgazamiento excesivo de la virola.

Roladora de tres rodillos — cuerpo cilíndrico

La roladora de tres rodillos no requiere cambio de herramental entre formatos. Para obtener un diámetro de cilindro diferente basta con ajustar la posición vertical del rodillo superior mediante el accionamiento hidráulico de la máquina. Cuanto más desciende el rodillo superior respecto a los dos rodillos inferiores fijos, mayor es la curvatura impuesta a la chapa y menor el diámetro del cilindro resultante. Este ajuste es continuo y no requiere intervención mecánica sobre los rodillos, como confirma la documentación técnica de máquinas de tres rodillos[^25][^26]. El operario programa el nuevo diámetro objetivo y realiza piezas de prueba hasta verificar que el cilindro cierra correctamente en el diámetro nominal requerido.

Bordoneadora — reborde del extremo superior del cuerpo

Cuando cambia el diámetro del cilindro entre formatos se deben reemplazar los rodillos de perfil de la bordoneadora, ya que el rodillo interior y el rodillo exterior están dimensionados para acoplarse exactamente al diámetro interior y exterior del cilindro que se está conformando. Si se usara un set de rodillos de un formato diferente, el rodillo no apoyaría correctamente sobre la pared del cilindro y el reborde resultaría irregular, excéntrico o insuficientemente profundo para retener la cúpula. El cambio de rodillos se realiza retirando los ejes de los rodillos y montando el set correspondiente al nuevo diámetro, ajustando luego la profundidad del reborde mediante el mecanismo de regulación de la máquina, según el principio de operación descripto.[^27]

Soldadora longitudinal — costura del cuerpo

Al cambiar el diámetro del cuerpo se reemplazan las mordazas de cobre que sujetan y alinean los bordes del cilindro durante la soldadura longitudinal, ya que estas están mecanizadas con el radio interior correspondiente al diámetro específico de cada formato. Una mordaza de diámetro incorrecto no lograría la presión uniforme sobre la junta ni la disipación térmica homogénea necesaria para un cordón sin defectos. Además se ajustan los parámetros de soldadura MIG (velocidad de avance de la antorcha, intensidad de corriente y velocidad de alimentación del alambre) en función del espesor de chapa de cada modelo, que varía entre 1.0 mm para el de 1 kg y 2.0 a 2.5 mm para el de 10 kg.

Soldadora orbital — unión cúpula y fondo al cuerpo

Al cambiar el formato se reemplaza el mandril rotante que sujeta y centra la pieza durante la soldadura orbital, ya que este está dimensionado al diámetro exterior de cada modelo. Un mandril de diámetro incorrecto no centraría la pieza con la precisión necesaria para que el cordón circunferencial quede concéntrico y homogéneo. Al igual que en la soldadura longitudinal, los parámetros de soldadura MIG se ajustan para el espesor de chapa correspondiente al formato que se está produciendo.

Diagramas de proceso

- Proceso para matafuegos ABC manuales de 2,5/5/10 kg

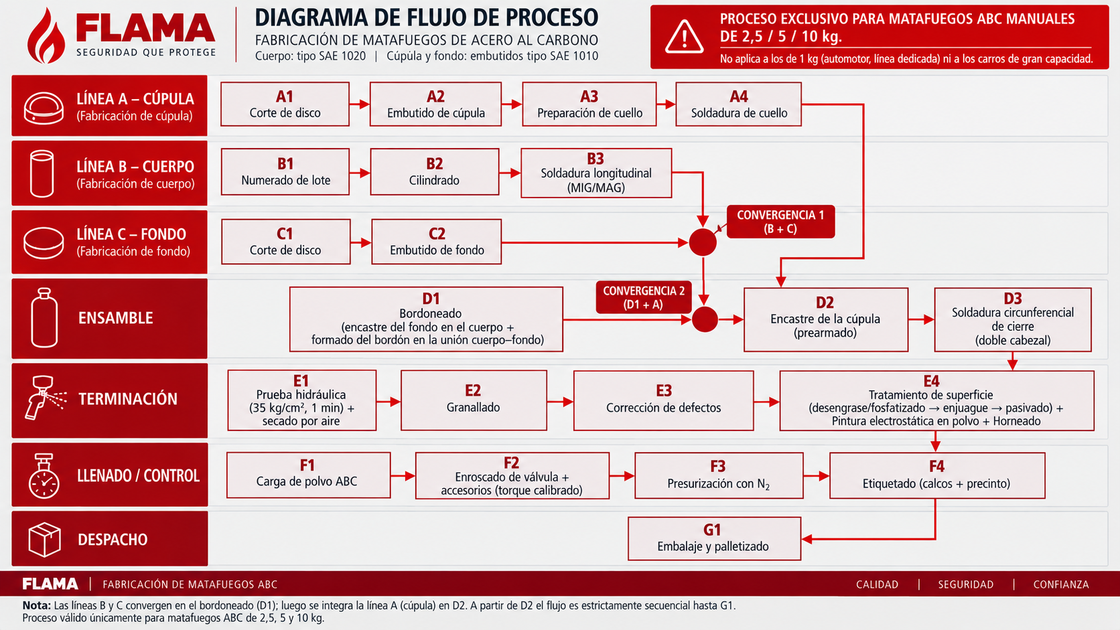
[picture p1: figure]

### Línea A — Cúpula (SAE 1010, bobina)

A1 · Corte de disco
Entra: bobina de acero SAE 1010 desenrollada como fleje. Sale: disco circular para embutir +bandera/scrap de chapa que va al chatarrero (con certificado de destino, como exige el reglamento ambiental).

A2 · Embutido de cúpula
Entra: disco de A1 + aceite de embutido. Sale: cúpula embutida (con virola). No genera scrap de chapa, pero deja trazas de aceite que se limpian después en E4.

A3 · Preparación de cuello
Entra: cúpula de A2 + el cuello roscado (pieza comprada, mecanizada por proveedor, ~15–20 días de lead time). Se punzona el orificio central y se marca la posición angular de referencia con un mandril. Sale: cúpula con orificio y cuello posicionado.

A4 · Soldadura de cuello
Entra: cúpula de A3 + alambre MIG + gas (mezcla Ar/CO₂ ~85/15). Soldadura orbital 360°. Sale: cúpula terminada, lista para el ensamble (buffer de semielaborados).

- Proceso para matafuegos ABC manuales de 1 kg

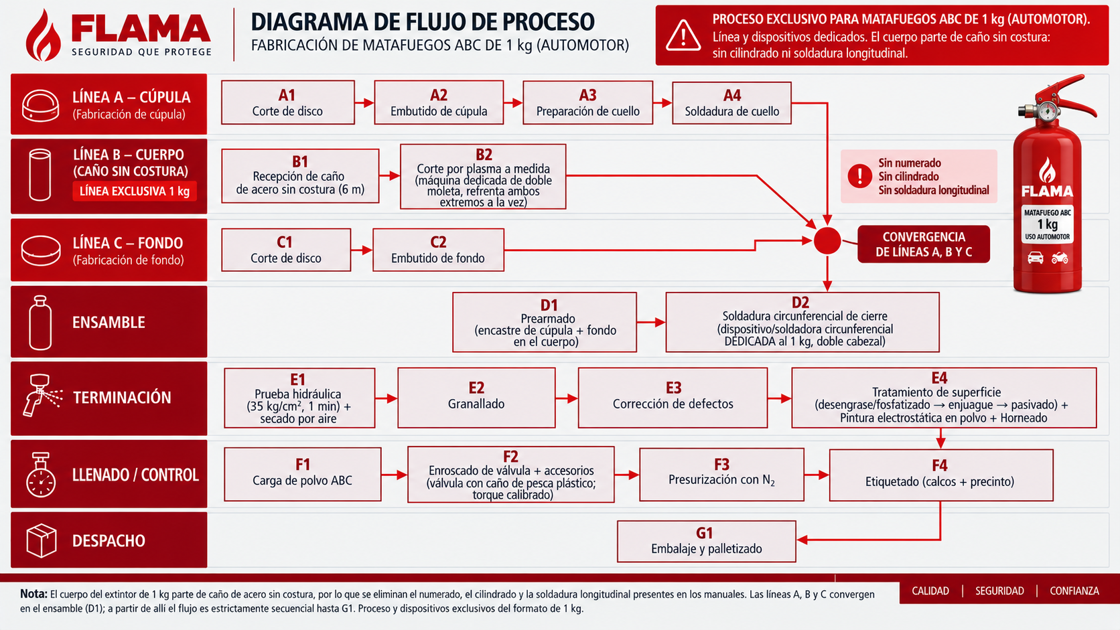
[picture p2: figure]

- Proceso para matafuegos ABC manuales de 25/50/70/100 kg

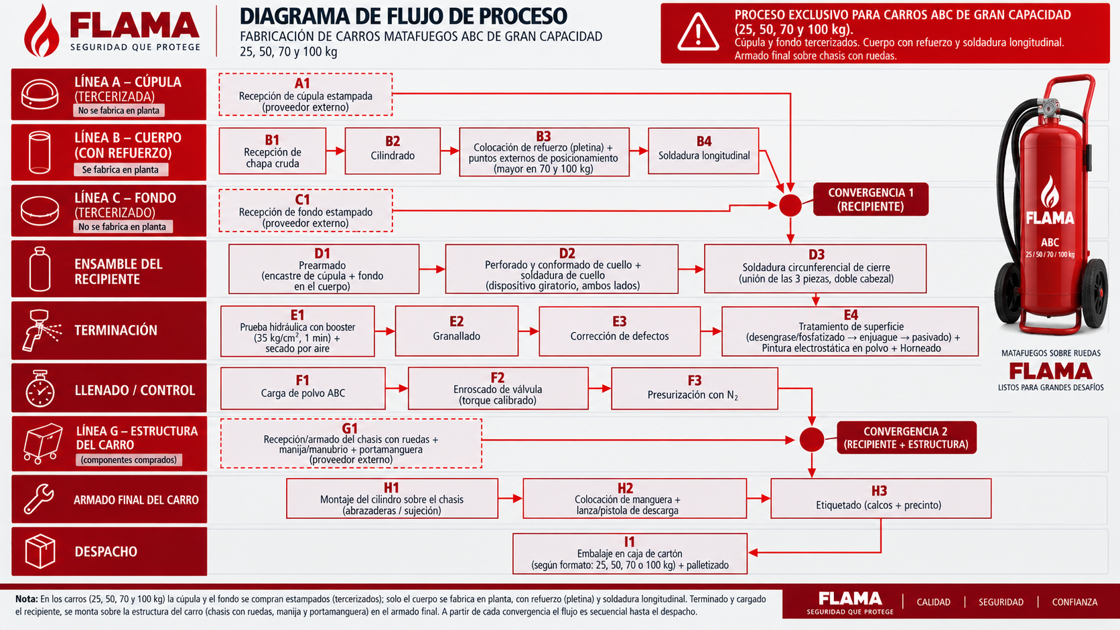
[picture p3: figure]

# Materiales y útiles. Mobiliario necesario

En la línea de cúpula las necesidades de mobiliario se concentran en tres puntos: el soporte de la bobina de alimentación, los puntos de apoyo para la preparación manual del cuello, y los buffers de piezas semielaboradas entre estaciones. El soporte porta-bobina con freno es el primer elemento de la cadena: sostiene la bobina de acero SAE 1010 y controla la tensión del fleje que alimenta la embutidora, evitando el sobreavance del material entre golpes de la prensa. A continuación, las mesas de trabajo de superficie de acero inoxidable ofrecen un plano limpio y resistente al aceite de embutido para las operaciones de preparación del cuello y clasificación visual de cúpulas. Los carros porta-piezas con ruedas y freno garantizan que las cúpulas se trasladen entre estaciones sin golpes ni contaminación, y los estantes de buffer permiten mantener un stock intermedio organizado y visible que sirve de referencia permanente para el control visual de la producción. Adicionalmente, el proceso de corte del disco genera una bandera o scrap perimetral que debe recolectarse en contenedores metálicos con tapa ubicados junto al balancín, para evitar que los recortes se acumulen en el piso generando riesgos de corte y tropiezos.

En la línea del cuerpo las mesas de apoyo para planchas cuentan con bordes de protección que evitan el deslizamiento del material durante su manipulación previa al grabado de lote y al cilindrado. Los carros porta-cilindros verticales con separadores son el elemento más crítico de traslado en esta línea, ya que el cuerpo cilíndrico es una pieza estructural delicada que no puede recibir golpes que deformen su geometría antes de la soldadura longitudinal. Para el formato de 1 kg, donde el cuerpo proviene de tubos de acero de 6 metros que se cortan a 225 mm, se requiere un soporte específico de apoyo de tubo largo que evite la flexión durante el proceso de corte. Los recortes extremos generados al seccionar los tubos se acumulan en un contenedor de scrap dedicado junto a la cortadora, para mantener el área de trabajo limpia y facilitar su entrega periódica al chatarrero.

El proceso de fabricación del fondo es análogo al de la cúpula en cuanto a mobiliario y equipamiento de soporte. El soporte porta-bobina, los carros de traslado y los estantes de buffer cumplen las mismas funciones que en la línea A, adaptadas al formato del fondo. Al igual que en la cúpula, el corte del disco mediante balancín genera una bandera o scrap perimetral que debe recolectarse en contenedores metálicos con tapa ubicados junto a la embutidora.

En la zona de ensamble las mesas de trabajo con superficie de acero ofrecen el plano de apoyo para el prearmado del recipiente y para la corrección manual de salpicaduras con cincel y martillo, mientras que los bancos con morsa permiten fijar piezas durante el repaso de soldadura con amoladora. Los carros de transferencia son los elementos de mayor importancia logística en esta etapa: el semielaborado avanza secuencialmente a través de múltiples estaciones y debe hacerlo en carros de capacidad suficiente para sostener el peso de los formatos más grandes. Se requieren suficientes unidades para que ninguna estación quede bloqueada esperando disponibilidad de carro, lo que interrumpiría el flujo continuo de producción. Adicionalmente, un soporte vertical giratorio para el semielaborado durante la corrección de defectos post-granallado, que facilita la inspección visual de toda la superficie exterior. y un estante porta-troqueles y utillaje de cambio de formato, indispensable para almacenar de forma organizada y segura los conjuntos punzón-matriz-pisador que se retiran de las prensas cada vez que la línea cambia de formato.

En el área de llenado y control las mesas de trabajo con superficie antideslizante evitan que el matafuego ruede durante el enroscado de la válvula con llave dinamométrica. Los soportes verticales regulables en altura sostienen el equipo en posición estable durante la presurización con nitrógeno, adaptándose a los distintos formatos sin necesidad de utillaje adicional. Para la carga de polvo extintor ABC, dos elementos resultan fundamentales: la tolva o embudo de carga, que canaliza el polvo hacia la boca del cilindro evitando el derrame, y la aspiradora industrial con filtro HEPA, que limpia el polvo derramado en la zona de trabajo.

El área administrativa y de control de calidad requiere mobiliario funcional que permita gestionar la trazabilidad documental completa que exigen las normas IRAM 3523, ISO 3834-2 y la Resolución 349/07 del OPDS. Los archiveros metálicos con llave son el elemento más crítico de esta área: los registros de soldadura y prueba hidráulica deben conservarse durante un mínimo de 20 años, coincidiendo con la vida útil del equipo. El armario para documentos normativos garantiza la disponibilidad permanente de las normas de referencia en planta. El pizarrón de producción es la herramienta central de la gestión visual: permite al supervisor y a todo el equipo conocer en tiempo real el estado del turno en términos de unidades producidas, rechazos y estado de los indicadores clave.

# Equipos Auxiliares

El aire comprimido es el segundo servicio industrial más demandado en la planta después de la electricidad. En el proceso productivo se utiliza en múltiples puntos simultáneos: herramientas neumáticas, componentes de máquinas, pistolas de soplado post-granallado y control de presión. El equipo central es un compresor de tornillo rotativo, tecnología que ofrece caudal constante, menor consumo energético y menor nivel de ruido que los compresores de pistón alternativos, siendo la solución adecuada para una demanda continua durante un turno completo de ocho horas. El tanque de reserva actúa como buffer de presión y reduce los arranques del motor, extendiendo su vida útil. El secador frigorífico es un componente obligatorio: la presencia de humedad en el aire comprimido contamina las soldaduras MIG, genera corrosión en la red de cañerías y deteriora los componentes neumáticos internos de las máquinas. La red de distribución se instala en anillo perimetral para garantizar presión uniforme en todos los puntos de consumo, y cada bajada cuenta con una unidad FRL (filtro-regulador-lubricador) que protege los equipos conectados de partículas, variaciones de presión y falta de lubricación.

El nitrógeno seco es el gas propelente utilizado para la presurización final de todos los formatos de matafuego a la presión de servicio de 1,4 MPa. El manifold de cilindros con conmutación automática garantiza que la presurización no se interrumpa durante el turno cuando un cilindro se agota. El regulador de presión calibrado es el elemento de seguridad más crítico de esta estación: limita mecánicamente la presión máxima de salida al valor de consigna, impidiendo físicamente la sobrepresurización del matafuego con independencia del tiempo de carga. Su uso es obligatorio conforme la Resolución 349/07 del OPDS, que también establece el contraste quincenal del manómetro patrón para garantizar que la presión indicada en la línea corresponde a la presión real inyectada. El detector de fugas fijo en la sala de cilindros es un elemento de seguridad ambiental: aunque el nitrógeno no es inflamable ni tóxico, en alta concentración desplaza el oxígeno y genera riesgo de asfixia.

Las herramientas manuales cubren tres grupos de necesidades concretas en el proceso productivo. La primera es la corrección de defectos de soldadura post-granallado: el cincel plano y el martillo son las herramientas estándar para la remoción puntual de salpicaduras de soldadura MIG/MAG que sobreviven al granallado. La amoladora angular con regulador de velocidad se reserva para defectos de mayor extensión que requieren repaso del cordón. El segundo grupo corresponde al ensamblaje y torque controlado: la llave dinamométrica es el instrumento central de la estación de enroscado de la válvula, ya que el torque correcto garantiza el sello hermético mediante el o-ring. El tercer grupo está compuesto por los consumibles de soldadura y corrección: cepillos de acero de copa, discos de desbaste y corte, y los kits de líquidos penetrantes en aerosol para los ensayos no destructivos.

El sistema de control en proceso definido en el Nivel 2 del Sistema de Gestión de Calidad se sostiene sobre un conjunto de instrumentos de medición que deben estar disponibles en cada puesto de control y cuya calibración periódica es un requisito de la norma ISO 9001:2015 y del AMFE de proceso. El calibre digital es el instrumento de uso más frecuente: verifica las dimensiones de planchas, discos y diámetros de cilindros en proceso, con un criterio de aceptación de más o menos un milímetro respecto a la dimensión nominal. El medidor de espesores magnéticos verifica que la capa de pintura electrostática cumpla los rangos especificados para cada formato. El comparador visual de rugosidad ISO 8501-1 es la referencia para evaluar el grado de limpieza superficial Sa 2.5 obtenido por el granallado antes de autorizar el ingreso de la pieza al pintado. El pH-metro y el termómetro de inmersión controlan los parámetros del baño de fosfatizado y del desengrasado, cuya desviación impacta directamente en la calidad de la adhesión de la pintura. La balanza industrial con corte programable es la herramienta de control más crítica de la estación de llenado, ya que un peso de carga fuera de tolerancia produce un equipo con potencial extintor insuficiente.

La iluminación no es un elemento accesorio sino un factor de seguridad y de calidad del proceso. Una iluminación insuficiente en los puestos de soldadura o en el puesto de inspección visual y líquidos penetrantes puede derivar en defectos no detectados que lleguen a la prueba hidráulica o, en el peor caso, al producto terminado. La Resolución SRT 295/03 establece los niveles mínimos de iluminación para cada tipo de tarea industrial: los puestos de soldadura y control de soldaduras requieren un mínimo de quinientos lux, mientras que el puesto de inspección por líquidos penetrantes demanda setecientos cincuenta lux para garantizar la sensibilidad visual necesaria para detectar indicaciones de pequeño tamaño. La nave de producción general se ilumina a trescientos lux con luminarias LED industriales en techo, y los depósitos a ciento cincuenta lux. Las luminarias de emergencia autónomas con autonomía mínima de una hora en salidas, pasillos y zonas de riesgo son de instalación obligatoria conforme el Decreto 351/79.

# Cálculo de Cuello de Botella

# Evolución del Parque de Máquinas en caso de ser Necesario

# Cálculo del Espacio Necesario. Dimensionamiento de la planta en función del Plan de ventas

# Almacenes, depósitos y MM. Descripción y función

# Manejo de materiales

# Planificación de los Requerimientos de Materiales e Insumos

# Planificación de la producción

# Estructura de Costos Directos

# Planta

## Factores obligatorios

Previo a la aplicación de la Matriz de Ponderación, se establecen criterios de carácter obligatorio que operan como filtro inicial. Toda localización que no cumpla con alguno de estos criterios queda automáticamente descartada del análisis, independientemente de su desempeño en los demás factores.

El primero de estos criterios se refiere a la zonificación industrial compatible. La parcela debe estar comprendida en una zona con uso del suelo habilitado para industria manufacturera, dado que el proceso productivo de FLAMA involucra soldadura MIG, pintura electrostática con horno de curado, llenado de cilindros a presión y almacenamiento de gases industriales. Estas actividades son incompatibles con zonificación residencial, comercial o mixta.

En segundo lugar, la localización debe permitir la habilitación para almacenamiento de gases comprimidos. El proceso productivo requiere almacenamiento permanente en planta de cilindros de nitrógeno industrial de pureza 99,5% utilizados como gas propelente, y el producto terminado es en sí mismo un recipiente bajo presión clasificado como Mercancía Peligrosa Clase 2 según la normativa nacional.

El tercer criterio es la disponibilidad de gas natural con categoría industrial. El proceso de curado de pintura en polvo requiere horno a gas natural con categoría de servicio industrial, lo que implica caudales y presiones de red superiores a los de uso residencial o comercial.

El cuarto criterio es la disponibilidad de suministro eléctrico trifásico de media tensión. Las principales máquinas del proceso productivo (soldadoras MIG, cabina de pintura electrostática, compresor de nitrógeno y banco de pruebas hidráulicas) requieren alimentación trifásica.

El quinto criterio refiere al acceso vial apto para transporte de carga pesada. La operación de FLAMA requiere ingreso y egreso regular de vehículos de gran porte. La localización debe contar con acceso directo o inmediato a ruta nacional o provincial habilitada para transporte pesado, sin restricciones de tonelaje en puentes o pasos urbanos intermedios que imposibiliten el tránsito de este tipo de vehículos.

El sexto criterio es que la parcela sea apta para construcción de nave industrial propia. La planta debe ser construida por lo que la localización debe ofrecer parcelas disponibles para adquisición y construcción de nave industrial nueva, sin restricciones urbanísticas que limiten la altura, la ocupación del suelo o el tipo de estructura admitida.

El séptimo y último criterio eliminatorio es el acceso a red cloacal industrial o la posibilidad de tratamiento de efluentes propio. El proceso de fosfatizado previo al pintado genera efluentes con contenido de fosfatos y restos de óxidos metálicos que requieren tratamiento antes de su disposición. La localización debe contar con conexión a red cloacal industrial, en cumplimiento de la normativa del OPDS para la Provincia de Buenos Aires o de la AGC para CABA.

## Factores de ponderación

El factor de mayor peso es la proximidad al mercado de canal directo y a la planta de recarga, con un 25%. Dado que el modelo de negocio se sostiene en gran medida sobre la venta directa en CABA y el GBA y sobre el servicio recurrente de recarga, la distancia entre la planta de fabricación y tanto el mercado como la planta comercial ubicada en el noreste de la Ciudad Autónoma de Buenos Aires impacta directamente en los costos operativos diarios, los tiempos de respuesta al cliente y la eficiencia logística del canal propio.

En segundo lugar, con un 20%, se pondera la proximidad a los proveedores críticos. Los insumos estratégicos del proyecto tienen proveedores concentrados geográficamente, y la distancia a ellos afecta directamente el lead time de reposición y el costo logístico de insumos que no admiten demoras sin impactar la producción.

El costo y disponibilidad del terreno pondera un 18%. Dado que la planta debe ser construida y no alquilada, la adquisición del terreno representa una inversión permanente de capital significativa. El costo por metro cuadrado varía considerablemente entre el primer y el segundo cordón del GBA sur, al igual que la disponibilidad de superficies adecuadas para una nave industrial de la escala proyectada.

La disponibilidad de mano de obra calificada pondera un 15%. El proceso productivo requiere soldadores certificados bajo norma WPS/WPQ y personal técnico con experiencia en procesos metalúrgicos, cuya oferta no es homogénea en todas las zonas del GBA sur. La escasez de este perfil en una zona determinada encarece la contratación y puede comprometer el cronograma de puesta en marcha.

La facilidad de habilitación municipal tiene un peso del 10%. Aunque todas las candidatas permiten en principio obtener las habilitaciones necesarias, la experiencia previa de cada municipio con industrias del rubro metalúrgico y químico determina la velocidad y complejidad del trámite, lo que puede impactar el cronograma de inicio de operaciones.

La infraestructura logística pondera un 7%, considerando la cercanía a operadores de carga de primera línea, nodos logísticos y la facilidad para la distribución nacional de producto terminado clasificado como mercancía peligrosa.

Finalmente, el potencial de expansión futura pondera un 5%. El plan de ventas proyecta un crecimiento sostenido durante 10 años que requerirá ampliar la capacidad productiva, por lo que la disponibilidad de superficie adicional en la zona para una eventual expansión de la nave es un factor a considerar, aunque de menor peso en la decisión inicial.

## Alternativas elegidas

Las cinco localizaciones que superan el filtro de criterios eliminatorios y avanzan a la Matriz de Ponderación son las siguientes.

Avellaneda, zona industrial sobre Av. Mitre y corredor Dock Sud, ubicada en el primer cordón sur e inmediatamente contigua a CABA, es el municipio industrialmente más consolidado de la región. Su principal fortaleza es la proximidad al mercado de canal directo, siendo la opción más cercana al centro del AMBA. Su limitación es que el tejido urbano está muy integrado con zonas residenciales en algunos sectores, lo que exige una selección cuidadosa de la parcela específica para garantizar la habilitación para almacenamiento de gases comprimidos.

Lanús, zona industrial de Monte Chingolo y corredor sobre Av. Hipólito Yrigoyen, también perteneciente al primer cordón, tiene una tradición metalúrgica fuerte y una zonificación industrial relativamente ordenada. El municipio tiene experiencia en habilitaciones industriales con materiales peligrosos, lo que reduce la fricción administrativa. Ofrece costos de terreno más competitivos que Avellaneda con una conectividad comparable.

Quilmes Oeste, zona industrial sobre corredor RN 2, presenta la ventaja de disponer de lotes de mayor superficie que los municipios del primer cordón, facilitando la construcción de una nave industrial nueva con margen para futura expansión del parque de máquinas. Su limitación relativa es una distancia algo mayor al centro del AMBA respecto a las opciones del primer cordón.

Florencio Varela, zona industrial sobre Ruta Provincial 53 y corredor de Av. Calchaquí, es la opción más atractiva del segundo cordón en términos de disponibilidad y costo de terreno, y el municipio del sur del GBA con mayor superficie disponible para desarrollo industrial de escala mediana. Su principal desventaja es la mayor distancia al centro del AMBA, que eleva los costos operativos del canal de venta directa.

Berazategui, zona industrial sobre Av. 14 y corredor RN 2, cuenta con una infraestructura industrial especialmente desarrollada en gas natural industrial de alto caudal y suministro eléctrico robusto, lo que lo hace particularmente conveniente para el horno de curado de pintura. Al igual que Florencio Varela, la distancia al centro del AMBA es algo mayor que en el primer cordón, pero lo compensa con una infraestructura de servicios industriales superior al promedio del segundo cordón.

## Matriz de Ponderación

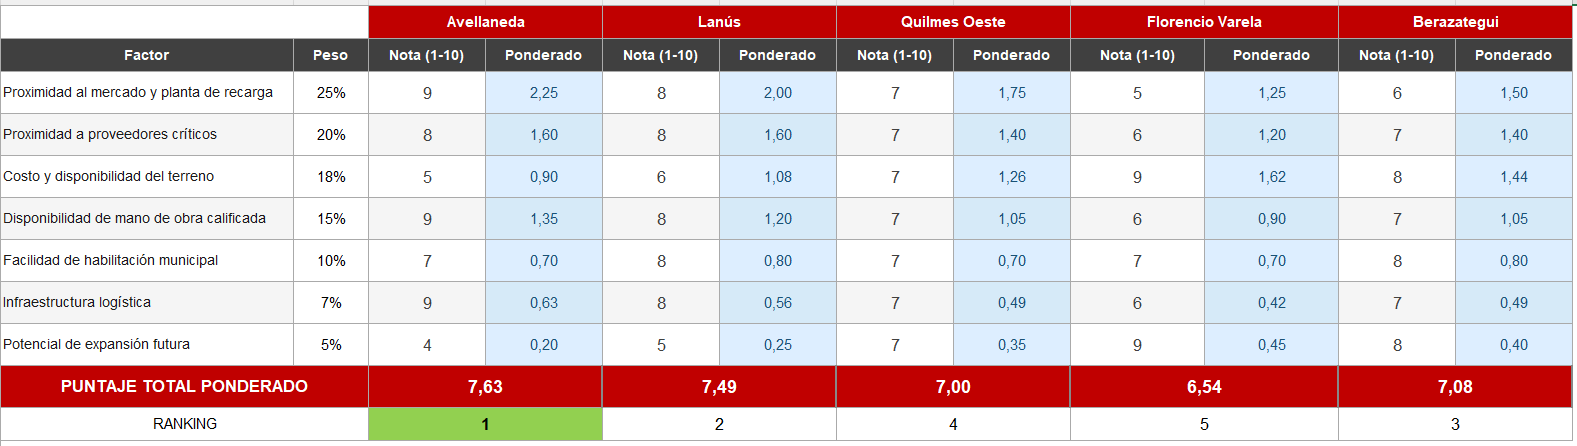
[picture p4: figure]

La localización seleccionada es Avellaneda, zona industrial, con un puntaje ponderado de 7,63 sobre 10.

La decisión está impulsada por los dos factores de mayor peso: la proximidad al mercado de canal directo y a la planta de recarga del noreste de CABA, donde Avellaneda lidera por ser el municipio más cercano a la Ciudad Autónoma de Buenos Aires del corredor sur, y la disponibilidad de mano de obra calificada, respaldada por la mayor tradición metalúrgica de la zona. En conjunto, estos dos factores representan el 40% de la ponderación total.

La principal limitación es el costo del terreno, el más elevado de las cinco alternativas, compensado por su ventaja en los factores operativos de mayor peso estratégico para el proyecto. Lanús quedó segunda con 7,49 puntos, diferencia que refleja la solidez de ambas opciones del primer cordón, pero la mayor proximidad a la planta de recarga y la oferta de mano de obra calificada inclinaron la balanza hacia Avellaneda.

## Ubicación

La empresa se localizará en el Parque Industrial Villa de Luján de Avellaneda (PIVLA), ubicado en Gral. Heredia 3220, Sarandí, partido de Avellaneda, Provincia de Buenos Aires[^28].

El PIVLA es un agrupamiento industrial de 32 hectáreas inscripto en el Registro Nacional de Parques Industriales (RENPI) y adherido a REDPARQUES, que cuenta actualmente con 31 empresas radicadas de rubros variados entre los que se incluye el metalúrgico, lo que confirma la compatibilidad del perfil productivo de FLAMA con la zonificación y la infraestructura del parque. Es el único parque industrial con Decreto de Homologación Provincial de la zona sur del GBA, condición que habilita el acceso a los beneficios impositivos previstos por la Ley de Promoción Industrial y que simplifica el proceso de habilitación ante el OPDS.

Su ubicación en Sarandí, a menos de 5 kilómetros de la Ciudad Autónoma de Buenos Aires y a 8 kilómetros de la terminal del Puerto de Buenos Aires, es la que mejor satisface el factor de mayor peso en la matriz: la proximidad al mercado de canal directo y a la planta comercial de recarga ubicada en el noreste de CABA.

El parque dispone de espacios disponibles para radicación de nuevas empresas, incluyendo lotes para construcción de nave industrial propia[^29]. La infraestructura del parque incluye calles internas, energía eléctrica, iluminación, servicios de agua y cloacas, y acceso desde las arterias principales del partido de Avellaneda con conexión directa a la Autopista Buenos Aires-La Plata y la RN3[^30].

# Planos

# Arquitectura del Producto (FRANCO)

# Calidad

# Marco normativo y referencias

Se basa en las siguientes normas y metodologías, aplicadas de forma complementaria para garantizar la conformidad del producto y la mejora continua de los procesos.

Norma / Metodología | Alcance | Aplicación
IRAM 3523 | Matafuegos de polvo bajo presión manuales | Requisitos de fabricación, prueba hidráulica y marcado de todos los formatos manuales
IRAM 3550 | Matafuegos de polvo bajo presión sobre ruedas | Requisitos de fabricación, prueba hidráulica y marcado de todos los formatos rodantes
IRAM 3517-2:2020 | Mantenimiento y recarga de matafuegos | Referencia para el control de manómetros y presurización con N₂
IRAM 3569 | Cargas para matafuegos — polvo ABC | Especificación del agente extintor MAP
IRAM 2587 | Ensayo de presión hidrostática en cilindros | Método de ensayo en prueba hidráulica de fabricación
ISO 9001:2015 | Sistema de gestión de la calidad | Marco general de referencia. No certificado actualmente. Orienta la estructura del SGC interno
ISO 3834-2 | Requisitos de calidad para soldadura por fusión | Control de procedimientos WPS, calificación de soldadores y trazabilidad de consumibles
AWS A5.18 | Alambre de soldadura ER70S-6 | Especificación del material de aporte para soldadura MIG
ISO 8501-1 (UNE-EN) | Preparación de sustratos — grado Sa 2.5 | Control del grado de limpieza en granallado
ISO 11124-3 (INTE) | Granalla esférica de acero de alto carbono | Especificación del abrasivo S330/S390
AMFE de Proceso (P-FMEA) | Análisis Modal de Fallos y Efectos | Herramienta de identificación y priorización de riesgos en cada etapa del proceso productivo
Ciclo PHVA | Planificar, Hacer, Verificar, Actuar | Metodología de mejora continua aplicada a todas las etapas del SGC

Estructura del sistema de gestión de calidad

Se organiza en cuatro niveles que cubren la totalidad de la cadena de valor, desde la recepción de materias primas hasta la entrega del producto terminado.

## Nivel 1 — Control de proveedores y recepción de materias primas

Este nivel abarca la evaluación y homologación de proveedores críticos y el control de recepción de todos los materiales e insumos que ingresan a la planta.

Proveedor / Insumo | Parámetros a controlar en recepción | Frecuencia | Criterio de aceptación | Documento de referencia
Bobina de chapa SAE 1010 (LAF/LAC) | Espesor nominal, tolerancia dimensional, certificado de calidad del proveedor con Rm, Re y elongación | Por bobina | Rm 290–320 MPa, A ≥ 28% (LAF). Rm 310–400 MPa, A ≥ 24% (LAC). Espesor ±0,1 mm | Certificado de calidad Ternium.
Casquetes tercerizados (cúpula y fondo rodantes) | Diámetro nominal, espesor, geometría, ausencia de grietas o deformaciones | Por lote | Diámetro ±1 mm. Espesor ±0,15 mm. Sin defectos visuales | Especificación técnica por formato
Válvulas de latón forjado | Estanqueidad, torque de apertura, manómetro en zona verde (1,4 MPa), rosca conforme | Muestreo por lote (NQA 1,0) | Sin pérdidas a 1,5 MPa. Manómetro calibrado. Rosca NF 1¼ o BSP 2½ según formato | IRAM 3533.
Polvo químico ABC (MAP) | Certificado de lote, humedad, granulometría | Por lote | Humedad < 0,25%. Granulometría según IRAM 3569 | IRAM 3569
Alambre de soldadura ER70S-6 | Certificado de composición química y propiedades mecánicas | Por bobina | Conforme AWS A5.18 | AWS A5.18
Nitrógeno seco (N₂) | Pureza, humedad, presión de suministro | Por carga | Pureza ≥ 99,9%. Punto de rocío < -40°C | IRAM 3517-2

## Nivel 2 — Control en proceso

Este nivel define los puntos de control durante la fabricación, los parámetros a verificar en cada etapa, los instrumentos de medición y los criterios de aceptación y rechazo. Sigue la secuencia del proceso productivo descripta en el dimensionamiento técnico.

Etapa del proceso | Parámetro controlado | Instrumento | Frecuencia | Criterio de aceptación | Acción ante desvío
Corte de chapa — cuerpo | Largo y ancho de la plancha | Cinta métrica / calibre | 100% de las piezas | ±1 mm respecto a dimensión nominal | Refiletar o rechazar plancha
Grabado de lote | Legibilidad y posición de la marca | Visual | 100% | Marca legible, sin perforación del material | Regrabado antes del rolado
Rolado del cuerpo | Diámetro del cilindro, alineación de la junta longitudinal | Calibre de diámetro exterior | 100% | Diámetro ±1 mm. Junta alineada sin escalón | Corrección en roladora o rechazo
Soldadura longitudinal | Aspecto visual del cordón, ausencia de porosidades, salpicaduras y falta de fusión | Visual + ensayo de líquidos penetrantes (LP) selectivo | 100% visual. LP en 5% de las piezas por turno | Sin porosidades, grietas ni falta de fusión. Penetración completa | Repaso de soldadura o descarte según severidad del defecto
Prearmado (cúpula + fondo + cuerpo) | Holgura entre pestaña y bordoneado, posición axial del fondo | Visual + calibre | 100% | Holgura uniforme ≤ 1 mm. Fondo en posición sin juego visible | Reposicionar o rechazar pieza
Soldadura circunferencial | Aspecto visual, geometría del cordón, ausencia de defectos | Visual + LP selectivo | 100% visual. LP en 5% por turno | Sin porosidades, mordeduras ni falta de fusión | Repaso o descarte
Prueba hidráulica | Presión de ensayo y estanqueidad | Manómetro patrón calibrado + inspección visual | 100% de las unidades | 3,5 MPa manuales / 4,0 MPa rodantes. Sin fugas, deformaciones ni exudaciones | Descarte obligatorio. No reparable
Granallado | Grado de limpieza superficial Sa 2.5 | Comparador visual ISO 8501-1 | Muestreo cada 2 hs de producción | Sa 2.5 mínimo. Rz 40–70 micrones | Repetir granallado
Fosfatizado | pH y temperatura de la solución, tiempo de inmersión | pH-metro + termómetro + cronómetro | Cada 4 hs de producción | pH 4,5–5,5. Temperatura ±3°C del set point. Tiempo ±10% | Ajuste de la solución. Repetir pretratamiento si fuera necesario
Pintura electrostática | Espesor de capa, adherencia, cobertura de zonas críticas (soldaduras) | Medidor de espesores magnético | Muestreo por turno (5 piezas) | 60–80 µm manuales. 80–120 µm 5/10 kg. 100–140 µm rodantes | Reaplicar pintura. Repasar zona defectuosa
Horno de curado | Temperatura y tiempo de ciclo | PLC + termocuplas en 3 zonas del horno | Continuo por PLC | 180–200°C durante 10–20 min según formato | Ajuste de parámetros. Reproceso si la pieza no curó correctamente
Carga de polvo | Peso de carga neto | Balanza con corte programable | 100% | Peso nominal ±50 g manuales. ±200 g rodantes | Ajuste de carga hasta dentro de tolerancia
Presurización con N₂ | Presión de servicio | Manómetro del equipo + manómetro patrón cada 15 días (Res. 349/07) | 100% | 1,4 MPa. Zona verde del manómetro | Corrección de presión antes de continuar
Armado final — manguera y válvula | Torque de apriete de válvula, estanqueidad del conjunto | Llave dinamométrica + visual | 100% | Torque según especificación de válvula. Sin pérdidas visibles | Retorque o reemplazo de o-ring
Etiquetado | Legibilidad, contenido reglamentario, posición | Visual | 100% | Conforme IRAM 3534. Sin etiquetas mal adheridas ni incompletas | Reaplicar etiqueta

## Nivel 3 — Control del producto terminado

Antes del despacho, cada unidad o lote de producto terminado pasa por un control final que verifica la conformidad integral del equipo.

Control | Parámetro | Criterio de aceptación
Inspección visual exterior | Pintura sin ralladuras, abolladuras ni zonas sin cubrir. Etiqueta completa y legible | Sin defectos visibles a distancia de 1 metro
Verificación de presión | Manómetro en zona verde | Aguja en zona verde (1,4 MPa)
Verificación de precinto | Precinto intacto sobre válvula | Precinto original sin signos de manipulación
Verificación de trazabilidad | Número de serie grabado, fecha de fabricación, tarjeta DPS/GCBA | Todos los campos completos y legibles
Verificación de manguera y lanza | Conexión firme, sin dobladuras, tobera en posición | Sin deformaciones. Conexión sin juego
Peso del equipo cargado | Peso total del equipo terminado | Dentro de ±3% del peso nominal

## Nivel 4 — Trazabilidad y registros

Toda unidad producida debe contar con trazabilidad completa desde la materia prima hasta el despacho. Los registros mínimos requeridos son los siguientes.

Registro | Contenido mínimo | Responsable | Retención
Registro de recepción de materia prima | Proveedor, fecha, número de remito, resultado de control de recepción, número de lote | Responsable de calidad | 5 años
Registro de soldadura | Número de pieza, soldador, parámetros WPS aplicados, resultado de inspección visual y LP | Supervisor de producción | 20 años (vida útil del equipo)
Registro de prueba hidráulica | Número de serie, fecha, presión aplicada, tiempo, resultado, firma del operario | Operario de prueba hidráulica | 20 años
Registro de calibración de manómetros | Fecha de contraste, resultado, manómetro patrón utilizado, firma | Responsable de calidad | 5 años (Res. 349/07 OPDS)
Registro de producción diario | Cantidad producida por formato, rechazos, causa del rechazo, acción tomada | Supervisor de producción | 3 años
Registro de no conformidades | Descripción del defecto, lote afectado, acción correctiva, verificación de eficacia | Responsable de calidad | 5 años

# Análisis Modal de Fallos y Efectos (AMFE de Proceso)

El AMFE de proceso (P-FMEA) es la herramienta central de gestión de riesgos del sistema de calidad de FLAMA S.A. Identifica de forma sistemática los modos de fallo posibles en cada etapa del proceso, sus efectos sobre la seguridad del producto y del usuario, y las acciones de control que deben implementarse para reducir el riesgo a niveles aceptables.

Cada modo de fallo se cuantifica mediante el Número de Prioridad de Riesgo (NPR), calculado como el producto de tres índices.

Índice | Escala | Descripción
S — Severidad | 1 (inapreciable) a 10 (catastrófico) | Gravedad del efecto del fallo sobre el producto, el usuario o el proceso
O — Ocurrencia | 1 (improbable) a 10 (casi seguro) | Probabilidad de que el modo de fallo se produzca
D — Detección | 1 (certeza de detección) a 10 (indetectable) | Capacidad de los controles actuales para detectar el fallo antes de que llegue al cliente
NPR = S × O × D | 1 a 1000 | Valores NPR ≥ 100 requieren acción correctiva prioritaria. NPR ≥ 200: acción inmediata

La matriz AMFE completa con todos los modos de fallo, efectos, causas, controles actuales, NPR y acciones correctivas se encuentra en el archivo Excel adjunto (AMFE_Calidad_FLAMA.xlsx). A continuación se resumen los modos de fallo de mayor criticidad identificados.

Etapa | Modo de fallo crítico | Efecto | S | O | D | NPR | Acción prioritaria
Prueba hidráulica | Recipiente con fisura no detectada que pasa la PH | Falla en servicio bajo presión. Riesgo de explosión | 10 | 2 | 2 | 40 | Calibración bimestral de bomba. LP en 10% de soldaduras
Soldadura longitudinal | Falta de fusión en la raíz de la costura | Costura sin resistencia estructural. Falla bajo presión | 10 | 3 | 4 | 120 | Ensayo de LP al 10% por turno. Calificación WPS documentada
Soldadura circunferencial | Porosidad en el cordón de cierre | Pérdida de hermeticidad en servicio | 9 | 3 | 4 | 108 | LP selectivo. Inspección visual 100% con luz adecuada
Presurización | Sobrepresurización por falla del regulador | Deformación plástica del recipiente. Riesgo de falla | 10 | 2 | 3 | 60 | Calibración quincenal del regulador y manómetro patrón (Res. 349/07)
Presurización | Subpresurización no detectada | Equipo inoperante en emergencia. Riesgo para el usuario | 8 | 3 | 3 | 72 | Verificación 100% con manómetro patrón antes del precintado
Granallado | Cobertura insuficiente en zonas de soldadura | Falla de adhesión de la pintura. Corrosión prematura bajo recubrimiento | 7 | 3 | 4 | 84 | Control visual Sa 2.5 cada 2 hs. Ajuste de velocidad de cadena
Carga de polvo | Carga incorrecta de agente extintor (peso fuera de tolerancia) | Equipo con potencial extintor insuficiente. No conformidad IRAM 3523 | 8 | 2 | 2 | 32 | Balanza con corte programable. Verificación 100% de peso
Recepción casquetes | Casquete con grieta de embutido no detectada en recepción | Falla del recipiente bajo presión | 10 | 2 | 5 | 100 | Inspección visual 100% de casquetes en recepción. LP en muestreo
Recepción chapa | Espesor de chapa fuera de tolerancia no detectado | Resistencia del recipiente por debajo de diseño | 9 | 2 | 4 | 72 | Medición de espesor en recepción por bobina con calibre de ultrasonido
Pintado | Espesor de capa insuficiente | Corrosión prematura. Falla estética. No conformidad | 6 | 3 | 3 | 54 | Medición de espesor con medidor magnético por turno

NPR ≥ 100: requiere acción correctiva documentada. NPR ≥ 200: acción inmediata con parada de producción si es necesario.

Esquema de contingencia ante unidades defectuosas

El esquema de contingencia define el camino de decisión que debe seguir el operario o supervisor al detectar una no conformidad en cualquier etapa del proceso. El principio fundamental es que ninguna unidad con defecto que comprometa la seguridad puede avanzar al paso siguiente ni llegar al cliente.

## Clasificación de defectos

Clase | Definición | Ejemplos | Acción inmediata
Clase A — Crítico | Defecto que compromete la seguridad del usuario o la integridad del recipiente bajo presión | Fisura en soldadura. Falla en prueba hidráulica. Recipiente deformado. Chapa fuera de espesor mínimo | Rechazo inmediato y definitivo. Pieza a destruir. No reprocesable. Registro obligatorio
Clase B — Mayor | Defecto que genera no conformidad con norma IRAM o que impide la función del equipo, pero sin riesgo inmediato para el usuario | Carga de polvo fuera de tolerancia. Presión fuera de zona verde. Etiqueta incompleta. Manguera con falla de conexión | Retener lote. Reproceso inmediato si es posible. Reinspección 100% del lote asociado
Clase C — Menor | Defecto estético o de acabado que no compromete la seguridad ni la funcionalidad | Rayón en pintura. Salpicadura de soldadura visible en exterior. Etiqueta levemente desplazada | Reproceso en línea. Documentar. No retiene producción

## Árbol de decisión ante no conformidad detectada

Paso 1 — Detección y clasificación

El operario o inspector detecta el defecto y lo clasifica en Clase A, B o C según la tabla anterior. En caso de duda entre Clase A y Clase B, se aplica siempre el criterio más restrictivo.

Paso 2 — Segregación inmediata

La unidad o el lote afectado se retira físicamente de la línea de producción y se coloca en la zona de no conformes (área delimitada y señalizada en rojo dentro de la planta). Se coloca una etiqueta de identificación con la descripción del defecto, la fecha, el operario que lo detectó y la etapa del proceso.

Paso 3 — Evaluación por el responsable de calidad

El responsable de calidad evalúa el defecto, determina la causa raíz mediante el método de los 5 Por Qué y decide la disposición final de la pieza según el árbol de decisión siguiente.

¿El defecto compromete la seguridad? | ¿Es reprocesable? | Disposición final
Sí (Clase A) | No aplica | Rechazo definitivo. Destrucción o inutilización de la pieza. Registro de no conformidad. Análisis de causa raíz obligatorio
No (Clase B o C) | Sí | Reproceso. Reinspección 100% después del reproceso. Si aprueba, continúa. Si no aprueba, pasa a rechazo
No (Clase B o C) | No | Rechazo definitivo. Registro de no conformidad. Análisis de causa raíz
No aplica (defecto en MP) | No aplica | Devolución al proveedor. Registro de reclamación. Evaluación del proveedor en el sistema de homologación

Paso 4 — Análisis de causa raíz y acción correctiva

Para todo defecto Clase A y para defectos Clase B que se repitan más de una vez en el mismo turno, el responsable de calidad inicia un análisis de causa raíz mediante el método de los 5 Por Qué o el diagrama de Ishikawa según la complejidad del problema. La acción correctiva resultante se documenta en el registro de no conformidades con fecha de implementación y fecha de verificación de eficacia.

Paso 5 — Comunicación y cierre

El supervisor de producción comunica el resultado del análisis y la acción correctiva al equipo de operarios en el inicio del turno siguiente. El registro de no conformidad se cierra cuando la acción correctiva ha sido verificada como eficaz mediante al menos un ciclo de producción sin recurrencia del defecto.

## Contingencias específicas por etapa crítica

### Falla en la prueba hidráulica

La pieza es rechazada de forma definitiva e inutilizada. No existe posibilidad de reproceso de un recipiente que haya fallado la prueba hidráulica, ya que la falla implica una pérdida de integridad estructural de las soldaduras o del material base que no puede recuperarse sin comprometer la seguridad. Se registra el número de serie, la fecha, la presión alcanzada, la descripción de la falla (fuga, deformación o fisura) y la ubicación del defecto. Si se producen más de dos fallas hidráulicas en el mismo turno, se detiene la producción y se revisan los parámetros de soldadura, el estado de las mordazas y el manómetro patrón.

### Defecto en soldadura detectado por líquidos penetrantes

Si el defecto es superficial y de extensión menor a 5 mm, el operario de soldadura calificado puede realizar un repaso localizado conforme al WPS documentado, seguido de nueva inspección por LP. Si el defecto es mayor a 5 mm, tiene continuidad longitudinal o aparece en más de un punto del mismo cordón, la pieza se rechaza. En ningún caso puede avanzar a la prueba hidráulica una pieza con defecto de soldadura sin haber completado el reproceso y la reinspección.

### Defecto en recepción de casquetes tercerizados

El lote completo se retiene en cuarentena. El responsable de calidad comunica el defecto al proveedor con descripción fotográfica y solicita el reemplazo del lote. Se registra el incidente en el historial del proveedor. Si el mismo proveedor genera dos lotes rechazados en forma consecutiva, se inicia el proceso de re-evaluación de proveedor y se activa la búsqueda de proveedor alternativo.

### Defecto de pintura detectado en control final

Si el espesor de capa es inferior al mínimo en más del 20% de la superficie, la pieza vuelve a la línea de granallado para repetir el pretratamiento y la aplicación de pintura. Si el defecto es localizado (zona puntual menor a 5 cm²), se realiza retoque localizado con pintura en polvo y curado parcial. La pieza retocada recibe una marca de reproceso en su registro interno. Si la pieza ha sido ya presurizados y etiquetada, se despresuriza de forma segura antes de cualquier operación de pintura.

# Indicadores de calidad (KPIs)

Los siguientes indicadores deben medirse y registrarse mensualmente por el responsable de calidad para monitorear la evolución del sistema y detectar tendencias negativas antes de que se conviertan en problemas sistémicos.

Indicador | Fórmula | Frecuencia | Meta | Alerta
Tasa de rechazo en PH | (Piezas rechazadas en PH / Total piezas ensayadas) × 100 | Mensual | < 0,5% | ≥ 1%: análisis de causa raíz obligatorio
Tasa de reproceso global | (Piezas reprocesadas / Total piezas producidas) × 100 | Mensual | < 3% | ≥ 5%: revisión de parámetros de proceso
Tasa de rechazo de proveedores | (Lotes rechazados / Total lotes recibidos) × 100 | Mensual | < 2% | ≥ 5%: re-evaluación del proveedor
Defectos de soldadura por LP | (Piezas con defecto / Total piezas inspeccionadas por LP) × 100 | Mensual | < 1% | ≥ 2%: revisión de calificación WPS y soldadores
Conformidad de espesor de pintura | (Piezas dentro de tolerancia / Total piezas medidas) × 100 | Mensual | ≥ 97% | < 95%: revisión de parámetros de cabina y horno
Precisión de carga de polvo | (Piezas dentro de tolerancia de peso / Total) × 100 | Mensual | ≥ 99% | < 98%: revisión de balanza y máquina de carga
NPR promedio del AMFE | Promedio de NPR de todos los modos de fallo activos | Semestral | < 80 | ≥ 100: revisión del AMFE y actualización de controles

# Mejora continua y hoja de ruta hacia ISO 9001

El esquema de calidad descripto en este documento está diseñado para ser compatible con los requisitos de la norma ISO 9001:2015, de modo que su implementación sistemática constituya la base sobre la cual FLAMA S.A. pueda alcanzar la certificación formal en una etapa posterior.

Etapa | Acciones | Plazo orientativo
Etapa 1 — Implementación básica (actual) | Implementar los controles de recepción, en proceso y producto terminado descriptos en este documento. Comenzar el registro sistemático de no conformidades y KPIs. Documentar los procedimientos WPS de soldadura | 0–6 meses desde inicio de producción
Etapa 2 — Consolidación | Completar el AMFE de proceso con todos los modos de fallo. Implementar el sistema de calificación de proveedores. Capacitar a todo el personal de producción en los procedimientos de calidad. Auditoría interna de cumplimiento | 6–12 meses
Etapa 3 — Madurez del sistema | Análisis de tendencias de KPIs. Revisión semestral del AMFE. Implementación de acciones preventivas basadas en tendencias. Evaluación de conformidad con ISO 9001:2015 | 12–24 meses
Etapa 4 — Certificación ISO 9001 (opcional) | Auditoría de pre-certificación por organismo externo. Corrección de desvíos. Auditoría de certificación | 24–30 meses
Horizonte — ISO 3834-2 | Certificación específica del proceso de soldadura para recipientes a presión. Requerida para exportación a mercados con exigencias de EN 13480 o ASME | A definir según mercados objetivo

Fuentes: IRAM 3523, IRAM 3550, IRAM 3517-2, ISO 9001:2015, ISO 3834-2, AWS A5.18, ISO 8501-1 (UNE-EN), ISO 11124-3 (INTE), Resolución OPDS 349/07, metodología AMFE según AIAG-VDA FMEA Handbook 2019.

# Seguridad Industrial (TOMI)

## Detección de riesgos

# Gestion ambiental

# Marco normativo ambiental aplicable

La planta de FLAMA S.A. está ubicada en el Partido de Avellaneda, Provincia de Buenos Aires, y desarrollará actividades industriales de fabricación metalmecánica con soldadura, granallado, tratamiento superficial y pintura. La normativa ambiental aplicable es la siguiente.

Norma | Descripción | Aplicación
Ley 11.723/95 | Ley Integral del Medio Ambiente y los Recursos Naturales de la Provincia de Buenos Aires. Establece el sistema de Evaluación de Impacto Ambiental (EIA) y la Declaración de Impacto Ambiental (DIA) | FLAMA debe obtener la DIA antes de iniciar actividades. Trámite ante OPDS. Disponible en opds.gba.gov.ar
Ley 11.459/93 y Decreto 531/19 | Radicación Industrial. Define el Nivel de Complejidad Ambiental (NCA) y las tres categorías de industrias. Obliga a obtener el Certificado de Aptitud Ambiental (CAA) | FLAMA debe calcular su NCA y obtener el CAA en tres fases: CNCA, autorización de construcción y autorización de funcionamiento
Ley 11.720/95 y Decreto 806/97 | Residuos Especiales de la Provincia de Buenos Aires. Obliga a inscribirse como generador y a gestionar los residuos especiales con transportista y dispositor habilitados | FLAMA genera residuos especiales en granallado (polvo de filtro), fosfatizado (solución agotada) y pintura. Debe inscribirse en el Registro OPDS
Ley 5.965/58 y Decreto 2009/60 | Protección de fuentes de provisión y cuerpos receptores de agua y atmósfera. Limita los vuelcos de efluentes líquidos y las emisiones gaseosas | Las aguas del pretratamiento (fosfatizado, enjuague) no pueden volcarse a la red cloacal sin tratamiento previo. Las emisiones del horno deben cumplir los límites
Ley 13.592/04 | Gestión Integral de Residuos Sólidos Urbanos | El scrap metálico, embalajes y residuos no especiales deben gestionarse conforme esta ley y la normativa municipal de Avellaneda
Ley Nacional 24.051/91 | Residuos Peligrosos (nivel nacional). Aplica cuando los residuos cruzan límites provinciales | Aplica si FLAMA contrata transportistas interprovinciales para residuos especiales
ISO 14001:2015 | Sistema de Gestión Ambiental. No obligatoria pero recomendada como marco de gestión | Marco de referencia para el SGA de FLAMA. No certificado actualmente
Res. OPDS 118/11 | Manifiesto de transporte de residuos especiales | Documento obligatorio en cada movimiento de residuos especiales fuera de la planta

# Categorización ambiental — NCA (Ley 11.459)

Antes de iniciar cualquier obra o actividad, FLAMA debe presentar ante la Municipalidad de Avellaneda la solicitud de categorización conforme la Ley 11.459. La Municipalidad remite el expediente al OPDS, que calcula el Nivel de Complejidad Ambiental (NCA) mediante la siguiente fórmula:

NCA = Ru (Rubro) + ER (Efluentes y Residuos) + Ri (Riesgos potenciales) + Di (Dimensionamiento) + Lo (Localización)

Según los parámetros de la planta de FLAMA, la estimación preliminar del NCA indica que la planta quedará clasificada en Segunda o Tercera Categoría, dado que combina actividades con efluentes líquidos del fosfatizado, residuos especiales del granallado, emisiones gaseosas del horno de curado y riesgos asociados a la presión interna de los recipientes fabricados. La categorización exacta debe realizarla un profesional habilitado por el OPDS.

Categoría | NCA | Obligaciones principales
Primera | Hasta 11 puntos | Memoria descriptiva ante el Municipio. No requiere EIA. CAA tramitado ante el Municipio
Segunda | 12 a 25 puntos | Estudio de Impacto Ambiental (EsIA) ante OPDS. CAA en tres fases. Renovación periódica
Tercera | Mayor a 25 puntos | EIA completo ante OPDS. Audiencia pública posible. CAA en tres fases. Mayor exigencia de monitoreo

## Proceso de obtención del Certificado de Aptitud Ambiental (CAA)

El CAA es el documento habilitante que permite operar la planta. Se obtiene en tres fases sucesivas conforme el Decreto 531/19 reglamentario de la Ley 11.459.

Fase | Denominación | Contenido | Plazo OPDS
Fase 1 | Clasificación NCA (CNCA) | Presentación del formulario de categorización ante la Municipalidad de Avellaneda. El OPDS calcula el NCA y notifica la categoría asignada | 90 días hábiles
Fase 2 | Autorización de construcción | Presentación del EIA o EsIA según la categoría. El OPDS evalúa y emite la autorización para construir e instalar los equipos con los condicionantes ambientales que correspondan | 90 días hábiles desde presentación del EIA
Fase 3 | Autorización de funcionamiento | Verificación en campo de que las obras e instalaciones cumplen lo aprobado en Fase 2. El OPDS emite el CAA definitivo que habilita el inicio de producción | A coordinar con OPDS

Fuente: Ley 11.459 Art. 8°, Decreto 531/19, Guía de Trámites OPDS — opds.gba.gov.ar

# Identificación de aspectos e impactos ambientales por proceso

Se identifican todos los aspectos ambientales generados por el proceso productivo de FLAMA, sus impactos potenciales y las medidas de control y mitigación preventivas a implementar desde el diseño de la planta.

## Residuos sólidos y semisólidos

Fuente / Proceso | Residuo generado | Clasificación | Cantidad estimada | Gestión prevista | Normativa
Corte de chapa — cuerpo, cúpula y fondo | Scrap metálico ferroso (bandera de disco, retales de plancha) | Residuo no peligroso — chatarra ferrosa | 3 a 8 ton/mes según volumen de producción | Venta al chatarrero. Recupero económico. No requiere manifiesto | Ley 13.592/04. Municipal Avellaneda
Granallado — filtro de mangas | Polvo de acero oxidado, escama y contaminantes superficiales del cilindro | Residuo especial (Ley 11.720 Anexo I — Y31 residuos metálicos inorgánicos) | 50 a 150 kg/mes estimado | Transportista y dispositor habilitado por OPDS. Manifiesto obligatorio por movimiento (Res. 118/11) | Ley 11.720. Decreto 806/97. Res. OPDS 118/11
Granalla agotada (finos descartados) | Granalla de acero fragmentada fuera de rango S330/S390 | Residuo no peligroso — chatarra metálica | 10 a 30 kg/mes | Venta al chatarrero como recupero de acero | Ley 13.592/04
Soldadura — salpicadura y escoria | Salpicaduras de acero y restos de alambre ER70S-6 | Residuo no peligroso — chatarra ferrosa | Menor a 5 kg/mes | Recolección y venta al chatarrero | Ley 13.592/04
Pretratamiento — lodos de fosfatizado | Lodo de fosfato de hierro precipitado al agotar la solución | Residuo especial (Ley 11.720 Anexo I — Y26 compuestos de fósforo inorgánico) | 20 a 60 kg por renovación de baño | Transportista y dispositor habilitado. Manifiesto OPDS | Ley 11.720. Decreto 806/97
Pintura electrostática — polvo recuperado | Polvo de pintura poliéster no adherido recuperado por el sistema de cabina | Reutilizable en proceso | Variable — mayoría se recircula | Recirculación en el sistema de cabina. El residuo final no recuperable: transportista habilitado si es peligroso | ISO 14001. Ley 11.720 si contiene solventes
Embalajes de materias primas | Pallets de madera, flejes de metal, film plástico de bobinas | Residuo no peligroso — RSU industrial | Variable | Pallets: devolución o venta. Flejes y film: chatarrero o reciclador | Ley 13.592/04
Recipientes de lubricantes y aceites de embutido | Bidones plásticos o metálicos con restos de aceite | Residuo especial (Y8 — aceites minerales no aptos para uso previsto) | 1 a 3 bidones/mes | Devolución al proveedor o transportista habilitado. Nunca volcar a red pluvial o cloacal | Ley 11.720. Ley Nacional 24.051

## Efluentes líquidos

Los efluentes líquidos son el aspecto ambiental de mayor criticidad en esta planta, dado que el proceso de pretratamiento químico (desengrasado y fosfatizado) genera soluciones acuosas con cargas contaminantes que no pueden volcarse a la red cloacal sin tratamiento previo, conforme la Ley 5.965/58 y las normas de vuelco de AySA o ABSA según corresponda al área de Avellaneda.

Fuente | Efluente generado | pH estimado | Contaminantes principales | Volumen estimado | Gestión prevista
Desengrasado alcalino | Solución alcalina agotada con aceites emulsionados | pH 10–12 | Aceites emulsionados. Tensoactivos. Hidróxido de sodio | 100 a 300 L por renovación de baño (cada 2–4 semanas) | Neutralización en planta hasta pH 6–9 antes del vuelco o retiro por transportista habilitado
Enjuague post-desengrase | Agua de enjuague con trazas de desengrasante | pH 8–9 | Trazas de tensoactivos. DBO moderada | 50 a 150 L/día | Tratamiento en planta. Neutralización y sedimentación antes del vuelco a red cloacal conforme límites
Fosfatizado de hierro | Solución de fosfato agotada | pH 4–5 | Fosfatos. Hierro disuelto. Manganeso | 100 a 300 L por renovación (cada 1–3 meses) | Retiro por transportista habilitado. No volcar a red
Enjuague post-fosfatizado | Agua de enjuague con fosfatos en solución | pH 5–7 | Fosfatos. Hierro disuelto en baja concentración | 50 a 150 L/día | Neutralización y precipitación de fosfatos en planta antes del vuelco
Agua de la prueba hidráulica | Agua utilizada en el ensayo hidrostático | pH neutro | Sin contaminantes químicos. Posibles trazas de aceite del interior del recipiente | 50 a 200 L/día según producción | Reutilizar en el proceso (mismo recipiente o relleno del siguiente ensayo). Vuelco a red cloacal al final del turno

Sistema de tratamiento de efluentes líquidos requerido

La planta debe diseñar e instalar desde el inicio un sistema de tratamiento de efluentes que incluya como mínimo un tanque de neutralización con control de pH, un sistema de sedimentación o coagulación-floculación para la remoción de fosfatos y sólidos en suspensión, y una pileta de retención de emergencia para contener eventuales derrames. El vuelco final a la red cloacal debe cumplir los límites establecidos por AySA o ABSA y los de la Ley 5.965/58, que establecen entre otros: pH 6,0 a 9,5, sólidos sedimentables máximo 1 ml/L, aceites y grasas máximo 50 mg/L, y fósforo total máximo 4 mg/L.

## Emisiones gaseosas y material particulado

Fuente | Emisión generada | Contaminante principal | Control preventivo requerido
Soldadura MIG (longitudinal y circunferencial) | Humos metálicos de soldadura (óxidos de hierro, manganeso, silicio) | Material particulado respirable PM10 y PM2,5. Gases NOx | Aspiración localizada con campana extractora sobre cada puesto de soldadura. Filtro de mangas o HEPA en el sistema de extracción. Ventilación forzada del local conforme Res. SRT 295/03
Granallado — turbina centrífuga | Polvo metálico fino generado por el impacto de granalla | Material particulado ferroso. PM10 | Cámara de granallado hermética. Colector de polvo de mangas con eficiencia ≥ 99%. El polvo colectado es el residuo especial descripto en sección 3.1
Horno de curado de pintura (180–200°C) | Emisiones de compuestos orgánicos volátiles (COV) por la polimerización de la pintura poliéster | COV totales. Posibles trazas de formaldehído según formulación de la pintura | Postcombustor térmico u oxidador catalítico si los COV superan los límites de la Ley 5.965/58. Certificado ambiental del proveedor de pintura con datos de emisión a temperatura de curado
Pretratamiento — vapores del desengrasado | Vapores alcalinos del baño caliente de desengrase | NaOH en aerosol a baja concentración | Ventilación localizada sobre el túnel de pretratamiento. Extractor con filtro de carbón activado si la concentración supera los TLV de ACGIH
Circulación de montacargas y apiladores a gas | Emisiones de combustión de GLP o GNC si los equipos de movimiento interno son a gas | CO, NOx, CO₂ | Preferir equipos eléctricos dentro de la planta. Si se usan equipos a gas: ventilación permanente del sector y control semestral de emisiones del equipo

## Ruido industrial

La planta de FLAMA generará ruido en múltiples procesos. El ruido es un aspecto ambiental que afecta tanto a los trabajadores internos como a los vecinos del entorno industrial de Avellaneda. La normativa aplicable es el Decreto 1741/96 (niveles máximos de inmisión de ruido por zona) y la Resolución SRT 295/03 y 85/12 para ruido en el ámbito laboral.

Fuente de ruido | Nivel estimado (dB) | Control preventivo requerido
Granalladora de turbina centrífuga | 85–100 dB en proximidad | Cabina insonorizada. EPP auditivo obligatorio (protectores de copa). Nivel de exposición laboral diaria ≤ 85 dB(A) conforme Res. SRT 85/12
Soldadura MIG — arco y salpicadura | 80–90 dB | EPP auditivo en zona de soldadura. Pantallas acústicas entre puestos
Roladora de chapa | 75–85 dB | EPP auditivo. Mantenimiento preventivo de rodamientos y engranajes
Horno de curado — quemadores y ventiladores | 70–85 dB | Aislación acústica del local del horno. Silenciadores en tomas de aire
Sistema power and free — cadena aérea | 70–80 dB | Lubricación periódica de la cadena. Amortiguadores en puntos de contacto
Compresor de aire y estación de N₂ | 75–90 dB | Sala de compresores separada con paredes insonorizadas. Nivel exterior ≤ 55 dB(A) de día conforme Decreto 1741/96 para zona industrial

## Consumo de recursos — agua, energía y materias primas

Recurso | Fuente de consumo principal | Medida de eficiencia preventiva
Agua | Pretratamiento (desengrase y fosfatizado). Prueba hidráulica. Sanitarios | Circuito cerrado de enjuague por cascada inversa para reducir el consumo de agua limpia en el túnel de pretratamiento. Reutilización del agua de PH entre ensayos consecutivos. Medidor de caudal por sector para detectar fugas
Energía eléctrica | Horno de curado (mayor consumidor). Granalladora. Soldadoras. Sistema power and free. Compresor | Horno con aislamiento térmico de alta eficiencia. Variadores de frecuencia en motores de granalladora y sistema de cadena. Iluminación LED en toda la planta. Medidor de energía por sector
Gas natural o GLP | Horno de curado (si es a gas). Eventual calefacción del túnel de pretratamiento | Optimizar el ciclo térmico del horno. Sensores de temperatura en múltiples zonas para evitar sobreconsumo. Evaluar horno eléctrico como alternativa de menor emisión
Nitrógeno seco (N₂) | Presurización de todos los formatos (1 a 100 kg) | Sistema de recuperación de N₂ en la línea de presurización para reutilizar el gas que se purga entre cargas. Cañería de distribución sin pérdidas (control con detector de fugas semestral)
Materias primas metálicas | Chapa LAF y LAC. Alambre ER70S-6. Casquetes tercerizados | Optimización del ancho de bobina para minimizar el scrap de corte de discos. Registro mensual de índice de aprovechamiento de chapa (material en pieza / material comprado)

# Plan de Gestión Ambiental (PGA)

El Plan de Gestión Ambiental es el documento operativo que traduce los requisitos normativos y los aspectos identificados en acciones concretas, responsables y plazos. Es el corazón del sistema de gestión ambiental de FLAMA y el documento que el OPDS revisará en el proceso de obtención del CAA.

## Hoja de ruta para la habilitación ambiental

Acción | Descripción | Plazo | Responsable | Normativa
Contratar profesional habilitado OPDS | Ingeniero o licenciado con habilitación del OPDS para firmar el EIA y el formulario de categorización | Inmediato (antes de iniciar obras) | Dirección | Ley 11.723. Res. OPDS 492/19
Presentar formulario de categorización (Fase 1) | Ante la Municipalidad de Avellaneda. Incluye descripción de actividades, materias primas, efluentes, residuos y riesgos | Mes 1 | Profesional habilitado + Dirección FLAMA | Ley 11.459. Decreto 531/19
Obtener disposición de categorización del OPDS | El OPDS notifica la categoría (Segunda o Tercera). Plazo legal: 90 días hábiles | Mes 2–4 | OPDS (externo) | Ley 11.459 Art. 8°
Elaborar y presentar EIA o EsIA (Fase 2) | Según la categoría asignada. Incluye descripción del proyecto, identificación de impactos, medidas de mitigación y PGA | Mes 3–5 (en paralelo con Fase 1) | Profesional habilitado | Res. OPDS 489/19. Ley 11.723
Inscribirse como generador de residuos especiales (Ley 11.720) | En el Registro OPDS. Obliga a presentar declaración jurada anual de residuos generados | Antes de iniciar producción | Dirección | Ley 11.720. Decreto 806/97
Contratar transportista habilitado para RE | Para el retiro de polvo de filtro de granallado, lodos de fosfatizado y otros RE | Antes de iniciar producción | Dirección | Ley 11.720. Res. OPDS 118/11
Diseñar e instalar sistema de tratamiento de efluentes | Tanque de neutralización, sedimentación y retención de emergencia. Debe estar operativo en Fase 3 | Durante la construcción de la planta | Dirección FLAMA + Ingeniero ambiental | Ley 5.965/58. AySA/ABSA
Instalar sistemas de extracción y filtrado de humos | En todos los puestos de soldadura y sobre la granalladora. El colector de polvo de granallado es obligatorio antes de operar | Durante la construcción | Dirección FLAMA | Res. SRT 295/03. Ley 5.965/58
Obtener autorización de funcionamiento (Fase 3) | El OPDS verifica en campo el cumplimiento de las condiciones del EIA aprobado y emite el CAA definitivo | Mes 8–12 (estimado) | OPDS (externo) + Dirección FLAMA | Ley 11.459. Decreto 531/19
Declaración jurada anual de residuos especiales | Presentación anual ante OPDS con el volumen generado por tipo de residuo, transportista utilizado y disposición final | Anual — antes del 31 de marzo de cada año | Profesional ambiental | Ley 11.720 Art. 25

## Procedimientos operativos ambientales

### Manejo de residuos especiales en planta

Los residuos especiales generados en la planta deben almacenarse en un sector específico, techado, con piso impermeable, ventilación y señalización de riesgo conforme la Ley 11.720. El tiempo máximo de almacenamiento transitorio en planta es de 90 días. Cada movimiento de residuos especiales fuera de la planta debe estar acompañado del manifiesto de transporte conforme la Resolución OPDS 118/11. El manifiesto es un documento en tres copias: una para el generador (FLAMA), una para el transportista y una para el dispositor final. FLAMA debe conservar su copia durante 5 años.

### Control del sistema de tratamiento de efluentes

El operario responsable del área de pretratamiento debe controlar el pH de la solución de neutralización al inicio y al final de cada turno, registrando los resultados en el libro de control ambiental. Antes de cualquier vuelco de efluentes a la red cloacal se debe verificar que el pH esté entre 6,0 y 9,5 y que los sólidos sedimentables sean menores a 1 ml/L. Los lodos generados en el sistema de tratamiento se retiran con el transportista habilitado con la misma periodicidad que los lodos del fosfatizado.

### Control de emisiones del horno de curado

El proveedor de la pintura en polvo debe proveer la ficha técnica y la declaración de contenido de COV por kilogramo de polvo aplicado. Si la emisión estimada de COV del horno supera el umbral establecido por la Ley 5.965/58, se debe instalar un postcombustor térmico o un oxidador catalítico antes de poner en marcha el horno. Se realizará una medición de emisiones al inicio de la operación y una vez por año, con laboratorio habilitado por el OPDS.

### Respuesta ante derrames

La planta debe contar con un kit de control de derrames en el área de pretratamiento y en la zona de almacenamiento de residuos especiales, compuesto por material absorbente mineral o de vermiculita, contenedores etiquetados y procedimiento de respuesta escrito y conocido por todo el personal. Ante cualquier derrame que alcance la red pluvial o que supere los 200 litros, se debe notificar al OPDS dentro de las 24 horas.

# Indicadores ambientales (KPIs)

Los siguientes indicadores deben medirse y registrarse mensualmente para verificar el desempeño ambiental de la planta y detectar tendencias negativas.

Indicador | Fórmula | Frecuencia | Meta | Alerta
Generación de residuos especiales (kg/mes) | Suma de todos los RE generados en el mes pesados al momento del retiro | Mensual | Tendencia decreciente anual | Aumento sostenido en 3 meses consecutivos: revisar proceso
Índice de aprovechamiento de chapa | (Masa de chapa en piezas terminadas / Masa de chapa comprada) × 100 | Mensual | ≥ 75% | < 70%: revisar optimización de corte y scrap
pH de efluente final (promedio mensual) | Promedio de las mediciones diarias de pH antes del vuelco | Diario + promedio mensual | 6,0 – 9,5 | Fuera del rango en más de 3 mediciones/mes: revisión del sistema de tratamiento
Consumo de agua (m³/ton producida) | Agua total consumida en el mes / Toneladas de acero procesadas | Mensual | Tendencia decreciente | Aumento >20% respecto al mes anterior: verificar fugas
Consumo de energía eléctrica (kWh/ton producida) | kWh totales del mes / Toneladas de acero procesadas | Mensual | Tendencia decreciente | Aumento >15% respecto al promedio trimestral: auditoría energética
Manifiestos de RE emitidos en plazo | Manifiestos emitidos dentro de los 90 días de generación del RE / Total | Mensual | 100% | < 100%: riesgo de infracción Ley 11.720
Nivel de ruido en límite de planta | Medición en dB(A) en el límite con la propiedad lindante | Semestral | ≤ 55 dB(A) diurno (Decreto 1741/96 zona industrial) | > 55 dB(A): implementar medidas de atenuación adicionales
Incidentes ambientales | Número de derrames, vuelcos no conformes o notificaciones al OPDS | Mensual | 0 | ≥ 1: análisis de causa raíz y acción correctiva inmediata

Fuentes normativas: Ley 11.723/95, Ley 11.459/93, Decreto 531/19, Ley 11.720/95, Decreto 806/97, Ley 5.965/58, Res. OPDS 118/11, Res. OPDS 489/19, Decreto 1741/96, Res. SRT 295/03, ISO 14001:2015.

Trámites OPDS: opds.gba.gov.ar | Ley 11.459: normas.gba.gob.ar/documentos/V9OJlsPx.html | Ley 11.720: normas.gba.gob.ar/documentos/ByznJc4V.html | Res. 349/07 OPDS: ambiente.gba.gob.ar

# Ergonomía (TOMI)

# Logística (Propia – Contratada). Recursos Necesarios

# Plan de Mantenimiento

# RSE

# Gantt de implementación.

[^1] chrome-extension://efaidnbmnnnibpcajpcglclefindmkaj/https://www.ijert.org/research/evaluation-of-deep-drawing-force-in-sheet-metal-forming-IJERTV8IS070378.pdf
[^2] https://mechcodex.com/calculators/manufacturing/deep-drawing
[^3] https://melisam.com/producto/extintor-manual-abc-5-kg/
[^4] https://inteco.org/tienda/catalogo/INTEISO1112422021
[^5] https://www.une.org/encuentra-tu-norma/busca-tu-norma/norma?c=N0041368
[^6] https://normas.gba.gob.ar/documentos/Vr1egUOB.html
[^7] https://www.welders-supply.com/welding-techniques/weld-defects/weld-spatter-causes-reduction/
[^8] https://www.lincolnelectric.com/en/Welding-and-Cutting-Resource-Center/Process-and-Theory/Pulsed-MIG-Welding
[^9] https://westairgases.com/blog/co2-vs-argon-mig-welding/
[^10] https://beadboard.app/tools/weld-cost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
[^11] https://weldinganswers.com/the-real-cost-of-welding-spatter/
[^12] https://welders-supply.com/welding-consumables/shielding-gas/argon-tank-sizes-and-prices/
[^13] https://www.hobartbrothers.com/resources/technical-articles/welding-shielding-gas/
[^14] https://www.abiprofils.co.uk/fire-extinguisher-dip-tube-choose-material/
[^15] https://www.tottentubes.com/spec-sheets.
[^16] https://www.ambiente.gba.gob.ar/sites/default/files/RESOLUCION%20349%2007.pdf
[^17] (http://www.opds.gba.gov.ar)www.opds.gba.gov.ar
[^18] https://buenosaires.gob.ar/tramites/registro-de-fabricantes-de-extintores
[^19] https://www.matafuegosrojo.com.ar/images/demo/img/iram3517_2.pdf
[^20] https://protecmatafuegos.com.ar/wp-content/uploads/2022/01/Norma-IRAM-3517-de-Matafuegos-2020.pdf,
[^21] https://www.ambiente.gba.gob.ar/sites/default/files/RESOLUCION%20349%2007.pdf.
[^22] https://www.harsle.com/es/change-the-power-press-stroke-and-die/
[^23] https://atacosteel.com/deep-draw-tooling-design/
[^24] https://www.cssdmetal.com/news/deep-drawing-parts-manufacturing-process-explained.html
[^25] http://metalworking-machine.com.ar/6-2-3-roll-plate-bending-machine.html
[^26] https://www.machinemfg.com/es/three-roller-roll-bending-machine-operation-manual/
[^27] https://www.stmachineries.com/blog/how-to-set-up-the-parameters-of-a-bead-rolling-machine-237626.html
[^28] https://pivla.com.ar/
[^29] https://pivla.com.ar/plano-parque/
[^30] https://pivla.com.ar/accesos-y-ubicacion/
