TadeoSinay/planos_industrial_flama/referencias/RECOMENDACIONES ALE-CATEDRA.docx

El profesor dio una serie de recomendaciones y pautas muy detalladas para el diseño y la optimización de su planta de fabricación de matafuegos:

1. Criterios de Soldadura y Seguridad

- Relación de alambre y chapa: Explicó que a chapa fina se debe aplicar alambre fino, y a chapa gruesa, alambre grueso. Advirtió que si usan un alambre demasiado grueso (como de 1.6 mm), tenderán a perforar la chapa en vez de soldarla.
- Medidas recomendadas: Para los matafuegos chicos de 1.25, sugirió usar alambre de 0.9 mm. Para los matafuegos grandes o carros que tienen más de 2 mm de espesor, recomendó alambre de 1.2 mm.
- Capacitación y tecnología: Destacó que soldar con tecnología MIG es mucho más fácil que con la eléctrica convencional. Ante la dificultad de conseguir soldadores calificados en el mercado, sugirió que probablemente tengan que armar una "escuelita de soldadura" dentro de la fábrica.
- Equipamiento de los operarios: Recomendó entregar a los soldadores caretas autooscurecentes automáticas, ya que las caretas viejas de vidrio fijo atrasan el trabajo al tener que estar subiendo y bajando la máscara constantemente.
- Protección del entorno: Remarcó que los puestos de soldadura deben estar rodeados con mamparas para evitar que las proyecciones lumínicas y la radiación "flechen" (encandilen o quemen) al resto del personal.

2. Corte de Chapa y Aprovechamiento (Nesting)

- Métodos de corte según espesor: Aconsejó utilizar corte láser para las chapas finas, ya que ofrece mejor terminación y velocidad. Para chapas gruesas (de 15 mm, 19 mm o 20 mm), recomendó utilizar plasma, que resulta más eficiente en esos espesores.
- Optimización de material (Nesting): Explicó que el aprovechamiento de la chapa se denomina nesting (el "nido" de piezas dibujado para el corte). Detalló que las partes cilíndricas (como círculos) siempre dejarán un descarte o scrap, mientras que las partes cuadradas permiten un aprovechamiento superior.
- Logística de corte: Indicó que cuanto más grande sea la lámina de chapa a cortar, mayor será el tiempo de autonomía del láser, dándole tiempo al operario para ordenar las piezas terminadas en el pulmón y retirar el scrap.

3. Flujo de Trabajo y Cuellos de Botella

- Tiempos operativos vs. logísticos: Estimó que un soldador tarda unos 3 minutos en soldar un matafuegos de 5 kg. Subrayó la importancia de que el soldador reciba las piezas en carritos y se le retiren los productos terminados; de lo contrario, si debe trasladarse a buscar sus propios insumos, el tiempo pasa de ser operativo a logístico (demorando unos 5 minutos por pieza).
- Cálculo del sistema (Push o Pull): Recomendó calcular cuánto se tarda en cortar con el láser frente al tiempo de cilindrado para determinar cuál proceso es más rápido, lo que les permitirá saber si su sistema de producción será Mire (Pull) o Empuje (Push).
- Aumento de volumen físico: Advirtió que al cilindrar las chapas cortadas se empieza a "almacenar aire", lo que significa que los semielaborados cilindrados ocuparán mucho más espacio físico (volumen) que las chapas planas, agrandando la necesidad de espacio en la planta.

4. Diseño del Layout y Logística de Planta

- Movimiento interno: Aconsejó transportar los productos en carros. Señaló que, debido al bajo peso general de los materiales (salvo los matafuegos grandes), no será necesario usar un autoelevador dentro de la planta.
- Descarga de materia prima: Recomendó usar un puente grúa con una percha (una araña que agarra el paquete desde arriba) para descargar los camiones con chapa. Si decidieran usar un autoelevador, advirtió que los paquetes de chapa deberán ser chicos para evitar que se curven y se vuelvan inestables.
- Distribución de espacios clave: El layout de la planta debe incluir:
  - Un playón de carga y descarga para que el camión ingrese a la planta.
  - Un sector de oficinas.
  - Estacionamientos específicos para los carros y los autoelevadores.
  - Un sector delimitado y con fácil acceso exterior para almacenar el scrap, facilitando que el chatarrero lo retire sin tener que transitar por el medio de las máquinas.

Al finalizar, el profesor los felicitó mencionando que "van bien" y que es una alegría saber que están "en la ruta". Los instó a diseñar la distribución desde cero con "ojos de ingenieros", aprovechando la oportunidad de planificar flujos limpios y ordenados en lugar de replicar los desórdenes habituales de plantas que crecieron de forma improvisada.
