TadeoSinay/planos_industrial_flama/referencias/PREGUNTAS VISITA A PLANTA.docx

# Cuestionario FABRICANTE de matafuegos

## Cuestionario para la visita a FADESA — Proyecto Final "Flama" (matafuegos)

## Bloque 1 · Producto y materia prima

Alimenta: "Datos técnicos por formato" y hoja "Materiales" del modelo; Descripción del Producto y Materias Primas de la guía.

1. ¿Con qué material fabrican el cuerpo? (acero al carbono SAE 1010/1008, laminado en frío/caliente, ¿o acero inoxidable / aluminio para algún formato?)
2. ¿Qué espesor de chapa usan por cada diámetro/formato? (yo estoy suponiendo 1,0–2,5 mm según formato).
3. ¿Cuánto pesa el acero neto por cilindro y cuánto termina en scrap? (mi supuesto es 25% de scrap en el corte de discos, ¿es realista?).
4. ¿La chapa entra en rollo (coil), fleje o chapa cortada? ¿En qué formato la compran?
5. ¿Qué acabado aplican (fosfatizado/pretratamiento + pintura en polvo termoconvertida)? ¿Gramaje de pintura por pieza?
6. ¿Qué componentes comprados lleva el conjunto? (válvula, tubo sifón/pescante, aro de cuello, boss, junta).

## Bloque 2 · Proceso productivo y diagrama de flujo

Alimenta: Diagrama de Operaciones, Flujograma, "Definición del Proceso Productivo" (slide 15).

7. ¿Me pueden describir la secuencia completa de fabricación, estación por estación? (yo tengo: corte de discos → embutido 1ª → embutido 2ª/necking → recorte+rebordeado → soldadura de aro/boss → soldadura circular de cuerpo → soldadura de accesorios → prueba hidráulica → pintura → armado).
8. El cuerpo, ¿es de una sola pieza embutida o de dos mitades soldadas por costura circular? (cambia todo el balance de línea). En caso de usar un tipo por que no usan otro tipo (EJ POR COSTOS)
9. ¿Qué proceso de soldadura usan (MIG/MAG, resistencia, por costura, orbital)? ¿Consumo de alambre por cilindro?
10. ¿Hay tratamiento térmico / distensionado después de soldar? ¿En qué formatos?
11. ¿La planta es monoproducto, multiproducto o multipropósito? ¿Cómo cambian de formato (tiempos de setup)?
12. ¿Qué etapas hacen en paralelo y por qué? (balancear equipos continuos vs. discontinuos — slide 18).

## Bloque 3 · Máquinas, capacidad y consumo

Alimenta: hoja "Dimensionamiento" y "Máquinas" de la guía (cuáles/cuántas/origen/capacidad/consumo energético).

13. Para cada estación clave (prensa de embutido, soldadora, banco de prueba hidráulica): ¿marca, modelo y origen (nacional/importada)?
14. ¿Cuál es la capacidad real de cada máquina en piezas/hora? (necesito esto para validar mis tiempos de ciclo: embutido ~12 s, soldadura circular ~50 s, prueba hidráulica ~45 s por cilindro).
15. ¿Qué OEE / eficiencia real manejan? (uso 85%, ¿es alto o bajo para este rubro?).
16. ¿Trabajan a 1, 2 o 3 turnos? ¿Cuántos días/año efectivos y horas por turno? (base mía: 250 días × 8 h).
17. ¿Cuál es hoy su cuello de botella? (yo estimo la soldadura circular y la prueba hidráulica).
18. ¿Cuál es el consumo energético de las máquinas grandes (kW instalados de la prensa, la soldadora, el horno de pintura)? ¿Y consumo de aire comprimido, agua y gas?
19. ¿Qué tamaño de lote manejan y cuánto stock intermedio (WIP) queda entre estaciones?

## Bloque 4 · Balance de línea, cuello de botella y crecimiento

Alimenta: Cálculo de Cuello de Botella, Balance de Línea (slide 22), Evolución del Parque de Máquinas.

20. Con su parque actual, ¿cuántos cilindros/día y cilindros/año producen a máxima capacidad?
21. Cuando la demanda creció, ¿cómo escalaron: más turnos, más máquinas o tercerización? (esto es exactamente el árbol de decisión de las slides 23–24).
22. ¿Qué máquina es la primera que saturan y duplican cuando suben volumen?
23. ¿Qué plazo de entrega tiene una máquina nueva (prensa/soldadora) desde que la piden? (el PPT remarca que los tiempos de entrega de las máquinas importan).

## Bloque 5 · Calidad, ensayos, normas y homologación

Alimenta: Calidad, Normas y Reglamentos de Homologación (guía técnica y legal), Plan de Ensayos (slide 12).

24. ¿Bajo qué norma fabrican y homologan el cilindro? (IRAM, normas de recipientes a presión, ¿reglamentación de matafuegos / autoridad que aprueba?).
25. ¿La prueba hidráulica es al 100% de la producción o por muestreo? ¿A qué presión de prueba?
26. ¿Tienen certificación ISO 9001 u otra? ¿Qué exige el cliente/organismo para aprobar el lote?
27. ¿Qué ensayos hacen (estanqueidad/hermeticidad, presión de rotura, espesores, ensayo destructivo por muestreo)?
28. ¿Qué instrumentos de metrología y control usan en línea?
29. ¿Qué % de rechazo/retrabajo típico tienen y en qué etapa aparece?

## Bloque 6 · Materiales, insumos y proveedores

Alimenta: hoja "Materiales", Proveedores, MRP / Planificación de requerimientos, Política de Inventario.

30. ¿Quiénes son sus proveedores de chapa y de válvulas? ¿Nacionales o importados?
31. ¿Con cuánta anticipación compran la chapa y qué stock mínimo / punto de pedido manejan?
32. ¿Hay estacionalidad en la demanda o en el abastecimiento? ¿Cómo la absorben?
33. ¿Cómo manejan la trazabilidad del acero (colada/certificado de material)?

## Bloque 7 · Personal y turnos

Alimenta: hoja "Personal", Planificación de la producción, y Factibilidad Legal (perfiles, salarios, sindicato).

34. ¿Cuánta gente directa tiene la línea por turno y cómo se reparte por estación?
35. Los soldadores, ¿necesitan calificación WPS/WPQ? ¿Cómo los forman y cuánto tardan? (tengo 6 soldadores calificados en el modelo).
36. ¿Qué convenio / sindicato aplica (UOM u otro)? ¿Rangos salariales por categoría?
37. ¿Qué perfil pide el puesto de operador de prensa y el de prueba hidráulica?
38. Relación operarios directos vs. indirectos (mantenimiento, calidad, almacén, supervisión).

## Bloque 8 · Layout, superficies, almacenes y logística

Alimenta: hoja "Layout", Planos (Lay-Out, hilos), Almacenes, Manejo de materiales, Logística.

39. ¿Cuántos m² cubiertos ocupa la línea de fabricación y cuánto los almacenes? (mi supuesto total ≈ 3.770 m² cubiertos + terreno ≈ 2,5×).
40. ¿Cómo es el flujo de materiales en planta (recepción → producción → PT → despacho)? ¿Hay cruces o contraflujos?
41. ¿Qué manejo de materiales usan (autoelevador, transpaleta, cintas, monorriel para cilindros)?
42. ¿Cómo dimensionan el almacén de producto terminado y el de materia prima? (relación con el Cuadro de Evolución de Mercaderías del PPT).
43. Si hacen recarga/intercambio de equipos, ¿cuánta flota en circulación manejan y qué turnaround (días de ciclo de intercambio)?

## Bloque 9 · Mantenimiento

Alimenta: Plan de Mantenimiento.

44. ¿Mantenimiento preventivo, correctivo o predictivo? ¿Con qué frecuencia paran cada máquina?
45. ¿Qué máquina les da más problemas y qué repuestos críticos stockean?
46. ¿El mantenimiento es propio o tercerizado? ¿Cuánta gente afecta?

## Bloque 10 · Seguridad industrial y medio ambiente

Alimenta: Seguridad Industrial, Cuidado del Medio Ambiente, Ergonomía.

47. ¿Cuáles son los riesgos principales de la línea (prensas, soldadura, presión) y qué EPP usan?
48. ¿Cómo tratan el scrap de acero (venta a chatarra, retorno)? ¿Cuánto valor recuperan?
49. ¿Generan residuos peligrosos o efluentes (baños de fosfatizado, pintura)? ¿Cómo los tratan?
50. ¿Qué medidas de protección contra incendio / carga de fuego tiene la planta? (útil porque tu producto justamente es el matafuegos).

## Bloque 11 · Comercial: precios, mercado y cadena

Alimenta: Factibilidad Comercial — Precio (estructura con/sin IVA, márgenes de la cadena), Proveedores, Market Share, PxQ.

51. ¿A qué precio venden el cilindro (o el matafuego terminado) y a quién: distribuidor, negocio, consumidor final? ¿Con y sin IVA?
52. ¿Qué margen deja cada eslabón de la cadena? ¿Manejan lista de precios?
53. ¿Cuál es su volumen anual y a qué segmentos venden (industria, edificios, automotor, etc.)?
54. ¿Cómo ven el mercado y quiénes son los competidores relevantes? ¿Hay importación fuerte?
55. Si te venderían cilindros: precio unitario por formato, cantidad mínima (MOQ) y plazo de entrega. (Esto define tu make-or-buy y el análisis de tercerización).

## Bloque 12 · Inversión y costos

Alimenta: Factibilidad Económica–Financiera (Plan de Inversión, Sistema de Costeo, Estructura de Costos Directos).

56. Orden de magnitud de la inversión en las máquinas clave (prensa de embutido, soldadora, banco hidráulico, horno de pintura).
57. ¿Cómo componen el costo directo de un cilindro? (peso de material × precio de chapa, % de mano de obra, energía, insumos).
58. ¿Cuánto pesa la energía y la mano de obra en el costo total? (la guía dice que en un proyecto industrial la MO ronda cierto % — te sirve para el punto de equilibrio).
59. ¿La planta la construyeron o compraron nave? ¿Costo aproximado de obra civil por m²? (la guía exige planta construida, no alquilada).

## Bloque 13 · Localización e implementación

Alimenta: Localización / Matriz de Ponderación, Gantt de implementación.

60. ¿Por qué eligieron esta localización? (cercanía a proveedores de acero, mano de obra, logística, energía).
61. Desde la decisión hasta arrancar a producir, ¿cuánto tardó el montaje de la planta? (para tu Gantt de implementación).

### Cierre práctico

- Pedí llevarte: plano/ficha del cilindro, listado de máquinas (marca/modelo/origen), y si se puede cotización + plazo.
- Sacá fotos del layout y de cada estación (para tus planos, diagrama de hilos y diagrama de operaciones).
- Anotá tiempos de ciclo reales de las estaciones que puedas cronometrar en el recorrido: con eso corregís directamente la hoja Parámetros y Dimensionamiento del modelo.

# Cuestionario RECARGADOR + REVENDEDOR de matafuegos

Cuestionario para el contacto: RECARGADOR + REVENDEDOR de matafuegos

## Bloque 1 · Proceso de recarga

Alimenta: hoja "Parametros" (tiempos de ciclo de recarga) y "Dimensionamiento" (línea de recarga), Diagrama de Operaciones / Flujograma.

1. ¿Me describís el paso a paso de una recarga? (yo tengo: vaciado + recuperación de agente → inspección + prueba hidráulica → recarga de agente → presurización → prueba de hermeticidad → tarjeta + precinto).
2. ¿Cuánto tarda recargar un matafuego promedio, de punta a punta? ¿Y cuánto de eso es tiempo de máquina vs. de mano de obra? (necesito validar tiempos tipo 45–60 s por etapa).
3. ¿La prueba hidráulica se le hace a todos o según antigüedad/vencimiento? ¿A qué presión y con qué banco?
4. ¿Qué equipos usan para recargar (llenadora de polvo, banco de N₂, recuperador de polvo, banco hidráulico)? ¿Marca/origen y capacidad?
5. ¿Cuántos matafuegos recargan por día y cuál es su cuello de botella en el taller?
6. ¿Reutilizan/recuperan el agente (polvo ABC) o lo descartan? ¿Qué % se pierde por recarga?
7. ¿Trabajan a 1, 2 o 3 turnos? ¿Cuántos días/año efectivos?
8. ¿Cuánta gente tiene el taller de recarga y qué hace cada uno? (mi modelo tiene 17 operarios de recarga).
9. ¿Qué calificación necesita el personal? ¿Hay que estar matriculado/certificado para recargar?

## Bloque 2 · Modelo de intercambio y flota (loaners)

Alimenta: hoja "Layout" (flota en circulación, % con intercambio, turnaround) y Logística del PPT.

10. Cuando un cliente recarga, ¿le dejás un equipo prestado (intercambio) o se lleva el mismo? ¿Qué % de clientes usa intercambio? (yo asumí 100%, ¿es realista?).
11. ¿Cuántos días de ciclo (turnaround) pasa un matafuego afuera hasta que vuelve? (uso 10 días).
12. ¿Cuántos equipos de flota necesitás tener en circulación por cada cliente con intercambio?
13. ¿Cómo controlás la trazabilidad de la flota (qué equipo está en qué cliente)?

## Bloque 3 · Compra de matafuegos nuevos y cilindros

Alimenta: Proveedores, "Matafuegos comprados (reventa)" de la hoja Materiales, y el análisis make-or-buy (slides 23–24 del PPT).

14. ¿A quién le comprás los matafuegos nuevos y los cilindros? ¿Nacionales o importados?
15. ¿Precio de compra por formato (1 kg, 2,5 kg, 5 kg, 10 kg, CO₂, etc.) y cantidad mínima (MOQ)?
16. ¿Qué plazo de entrega te dan y con cuánta anticipación pedís?
17. ¿Hay faltantes o problemas de importación que te hayan dejado sin stock?
18. ¿Comprás el equipo completo o comprás cilindro por un lado y armás vos (válvula, sifón, carga)?

## Bloque 4 · Insumos de recarga y proveedores

Alimenta: hoja "Materiales" (polvo ABC, agentes, obleas, precintos), MRP, Política de Inventario.

19. ¿A quién le comprás el polvo ABC y los otros agentes (CO₂, AFFF, agua, Clase K/D)? ¿Precio por kg/litro?
20. ¿Qué stock mínimo / punto de pedido manejás de agentes y repuestos?
21. ¿De dónde salen las obleas/tarjetas de recarga y los precintos? ¿Cuánto cuestan?
22. ¿Cada cuánto reponés válvulas, manómetros y juntas? ¿Proveedor?

## Bloque 5 · Precios, márgenes y cadena comercial

Alimenta: Factibilidad Comercial — Precio (con/sin IVA, estructura, márgenes de cada eslabón, lista, política de venta).

23. ¿Cuánto cobrás una recarga por formato? ¿Con y sin IVA?
24. ¿A qué precio vendés un matafuego nuevo al consumidor final? ¿Y si es a un negocio o empresa (por volumen)?
25. ¿Qué margen te queda en la recarga vs. en la venta del equipo nuevo? ¿Cuál te conviene más?
26. Desde que sale de fábrica hasta el cliente final, ¿cómo es la remarcación en cada paso (fábrica → distribuidor → negocio → consumidor)?
27. ¿Tenés lista de precios y política de venta (descuentos por volumen, cuenta corriente, contado)?
28. ¿La recarga es el negocio recurrente que sostiene la empresa? ¿Qué peso tiene contra la venta de equipos?

## Bloque 6 · Cliente, mercado y competencia

Alimenta: Dimensionamiento del Mercado — Cliente, Segmentación, Market Share, Penetración; Macro/Microentorno.

29. ¿Quiénes son tus clientes y en qué segmentos están (industria, edificios/consorcios, comercios, autos, salud, hoteles, educación)?
30. ¿Qué peso tiene cada segmento en tu facturación?
31. ¿Cuántos matafuegos maneja un cliente típico de cada segmento y cada cuánto recarga?
32. ¿Cómo conseguís clientes (recomendación, licitación, inspecciones de bomberos, service anual)?
33. ¿Quiénes son tus competidores y cómo compiten (precio, servicio, cercanía)?
34. ¿Qué market share dirías que tenés en tu zona y cuánto está importado?

## Bloque 7 · Normas, habilitación y legal

Alimenta: Normas y Reglamentos de Homologación (legal), Factibilidad Administrativa Legal (habilitaciones, seguros, impuestos).

35. ¿Bajo qué norma recargás? (IRAM 3517-2 u otra) ¿Quién audita/habilita el taller?
36. ¿La oblea de recarga tiene vencimiento y quién la emite/controla?
37. ¿Qué habilitaciones y seguros necesitás para operar (municipal, bomberos, ART, RT)?
38. ¿Cada cuánto por norma hay que recargar y hacer prueba hidráulica cada formato? (define tu demanda recurrente).
39. ¿Hay matrícula profesional obligatoria para el responsable técnico?

## Bloque 8 · Estacionalidad y logística

Alimenta: Política de Inventario (¿hay estacionalidad?), Logística, Manejo de materiales, Cuadro de Evolución de Mercaderías.

40. ¿Hay estacionalidad en recargas o ventas? (fin de año, vencimientos, inspecciones). ¿Cómo la absorbés?
41. ¿La logística de retiro y entrega es propia o tercerizada? ¿Qué recursos usás (vehículo, radio de reparto)?
42. ¿Cómo almacenás los matafuegos cargados, descargados y la flota? ¿Cuánto lugar te ocupa?

## Bloque 9 · Seguridad y medio ambiente

Alimenta: Seguridad Industrial, Cuidado del Medio Ambiente (residuos, efluentes).

43. ¿Qué riesgos tiene el taller (presión, polvo, manejo de cilindros) y qué EPP usan?
44. ¿Qué hacés con los residuos (polvo vencido, agentes, cilindros dados de baja)? ¿Hay residuos peligrosos?
45. ¿Cómo dás de baja un cilindro que no pasa la prueba hidráulica?

### Cierre práctico

- Llevate la lista de precios (recarga y venta) y, si se puede, precios de compra de equipos e insumos.
- Con las respuestas de los bloques 1 y 2 corregís directo las hojas Parametros, Dimensionamiento y Layout del modelo.
- Con el bloque 5 armás la estructura de precios y márgenes de la cadena que pide la guía (fábrica → distribuidor → negocio → consumidor final).
- Preguntá también cuántos años hace que trabaja y cómo creció el volumen: te ayuda a estimar penetración y evolución a 10 años del plan de ventas.
