TadeoSinay/planos_industrial_flama/referencias/Comparacion_corte.xlsx

Sheet: Indice
Corte de chapa para cuerpos, cúpulas y fondos — Bobina, hojas, bobina madre y fleje a medida
FLAMA S.A. — aprovechamiento, proceso y costos 2026–2035
Hoja | Contenido
Supuestos | Datos editables: parámetros, bobinas/stock, productividad, cotizaciones de acero recibidas, precio por espesor y forma de compra, y equipos por opción.
Demanda | Unidades por formato y año (terminados + cilindros), del Excel V2.
Nesting | Cuerpos y discos: piezas por hoja, por bobina y por fleje; aprovechamientos. Medidas y formatos editables.
BobinaMadre | Opción C: ancho de madre, patrones de corte longitudinal (tiras y % de uso) y cálculo anual por espesor.
Bobinas | Peso de bobina por SKU: recomendado según la demanda y ELEGIDO (editable), largo, días que dura y bobinas por año.
Calculo | Cálculo anual de toneladas, scrap, stock, horas y costos de cada opción.
Proceso | Cómo funciona cada opción: flujo, máquinas, materia prima, consumo, manejo y personal.
Comparacion | Resumen, valor actual, ranking, puntos de equilibrio, sensibilidades y gráficos.
Decision | Por qué se elige la opción D, con los números que la sostienen y cuándo habría que revisarla.
Resumen D | Todos los datos de la opción elegida año por año: costos, acero comprado, compras, stock, personal, equipos y proveedores.
Colores
250 | Azul con fondo amarillo: dato editable. Ej.: precio del scrap en USD/t.
2 | Negro: fórmula, no editar.
1.3561 | Verde: vínculo a otra hoja (ej.: precio de hoja de 0,9 mm en USD/kg).
Opciones
• A — Bobina por formato: cuerpos desde bobinas de ancho estándar (línea de corte transversal); cúpulas y fondos desde flejes comprados cortados.
• B — Hojas: todo desde hojas estándar; cuerpos en guillotina; discos desde tiras cargadas a mano en el balancín.
• C — Bobina madre: una bobina ancha por espesor, corte longitudinal propio en flejes de cuerpo y de disco.
• D — Hojas + fleje a medida: cuerpos desde hojas en guillotina; cúpulas y fondos desde bobinas angostas hechas a medida para cada disco.
• Referencia: situación actual (cuerpos cortados a medida), solo para comparar.

Sheet: Supuestos
Supuestos editables
Texto azul con fondo amarillo = dato editable. Todo lo demás se calcula.
Concepto | Valor | Unidad | Fuente / nota
1. Scrap y materia prima (los precios de acero están en la sección 7, tomados de las cotizaciones)
Precio de venta del scrap | 250 | USD/t | Ref.: acero reciclado $300–1.200/kg (Reaquila, mar-2026) con dólar ~$1.480 ≈ USD 0,20–0,80/kg.
2. Parámetros técnicos de corte
Densidad del acero SAE 1010 | 7.87 | g/cm³ | Planilla 'Dimensiones de chapa'.
Margen mínimo de borde a lo ancho de la bobina | 10 | mm | Bordes de laminación y tolerancia de ancho.
Despunte de cabeza y cola de bobina | 0.5% | % | Supuesto.
Puente entre discos y al borde del fleje (s) | 3 | mm | Supuesto (≈ 1,5–3 × espesor). Ancho de fleje = D + 2s; paso = D + s.
¿Mezclar 70 y 100 kg en la misma hoja? (SI/NO) | SI | SI/NO | Solo opción hojas. Ver bloque en Nesting.
3. Financieros
Tasa de descuento anual (USD) | 12.0% | % | Igual a la Evaluación Económica del Excel V2 (12% real).
Mantenimiento anual de equipos | 3.0% | % de la inversión | SUPUESTO.
4. Bobinas y stock
Año de referencia para recomendar pesos de bobina | 2035 | año | Los pesos recomendados se calculan con el consumo de este año.
Cobertura objetivo de una bobina | 1.00 | meses de consumo | Criterio de recomendación: una bobina dura ~1 mes.
Peso mínimo de bobina que se compra | 0.5 | t | Mínimo razonable de un fraccionado.
Diámetro exterior máximo de bobina aceptado | 1500 | mm | Limita el peso según el ancho (bobinas angostas pesan poco).
Diámetro interior de bobina | 508 | mm | Estándar de mercado.
Capacidad del desbobinador de la línea de corte transversal | 10.0 | t | Especificar al comprar la línea.
Capacidad del desbobinador de fleje del balancín (discos) | 3.0 | t | Especificar al comprar.
Capacidad del desbobinador de la cortadora longitudinal | 14.0 | t | Pradecon: la bobina madre completa pesa 13–14 t.
Cobertura máxima de stock por bobina | 3.00 | meses | En años de poca demanda se compran bobinas más chicas: el stock por SKU no supera este consumo.
Stock de seguridad | 2 | semanas de consumo | Supuesto.
Lote de compra de hojas / chapa a medida | 1.00 | meses de consumo | Supuesto: compra mensual.
Días hábiles por año | 240 | días | 20 días/mes × 12 (Excel V2).
5. Productividad y mano de obra
Línea de corte transversal: golpes efectivos por hora | 1200 | golpes/h | Supuesto.
Guillotina: cortes efectivos por hora | 180 | cortes/h | Supuesto (3 cortes/min con carga manual).
Carga manual de una tira de hoja en el balancín (opción B) | 15 | s/tira | Supuesto.
Cambio de fleje en el desbobinador del balancín | 15 | min/fleje | Supuesto.
Cortadora longitudinal: velocidad efectiva | 40 | m/min | Supuesto (máquinas de 60–120 m/min nominales).
Cortadora: armado de cuchillas por bobina madre | 45 | min/bobina | Supuesto (cambio de patrón).
Operarios en la cortadora longitudinal | 2 | personas | Supuesto.
Horas productivas por operario y año | 1800 | h/año | 150 h/mes × 12 (Excel V2).
Costo mensual operario con cargas (P2) | 1337922 | ARS/mes | Planilla 'Costo oportunidad operario-maquina', CCT 260/75 ago-2026.
Horas por mes | 150 | h/mes | Excel V2.
Tipo de cambio | 1420 | ARS/USD | Dólar BNA billete usado por Pradecon en sus presupuestos del 28/09/2026.
Guillotina Molinari HG 6×3200 (referencia): precio sin IVA | 36651584 | ARS | MercadoLibre, Molinari Maquinarias S.A.: $40,5 M con IVA 10,5%. Falta confirmar recorrido del tope trasero.
Bobina madre: diferencia de precio sobre la bobina flejada | 0.0% | % | ESTIMADO. Pradecon (mail 28/09/2026): la bobina completa cuesta lo mismo que la flejada (no cobran el flejado).
Costo hora operario | 6.28 | USD/h | Calculado.
Peso máximo por mm de ancho (por diámetro exterior) | 0.0123 | t por mm de ancho | Calculado.
7. Cotizaciones de acero recibidas (precios sin IVA)
Proveedor / documento | Producto | Espesor (mm) | Formato / ancho | Moneda | Precio por kg | TC de la cotización | USD por kg | Nota
Q1 · Pradecon 173170 | Bobina LAF flejada | 0.90 | Ancho 1.220 | USD | 1.2629 | 1545 | 1.2629 | Flejado sin cargo: sirve también como fleje a medida.
Q2 · Pradecon 173170 | Bobina LAF flejada | 1.25 | Ancho 1.220 | USD | 1.2506 | 1545 | 1.2506
Q3 · Pradecon 173170 | Bobina LAF flejada | 1.60 | Ancho 1.220 (también 1.000) | USD | 1.2506 | 1545 | 1.2506
Q4 · Pradecon 173170 | Bobina LAF flejada | 2.00 | Ancho 1.220 (también 1.000) | USD | 1.2629 | 1545 | 1.2629
Q5 · Pradecon 173170 | Bobina LAC flejada | 3.20 | Ancho 1.245 (también 1.500) | USD | 1.1137 | 1545 | 1.1137
Q6 · Pradecon 173170 | Hoja LAC | 4.75 | 1500 × 3000 | USD | 1.0579 | 1545 | 1.0579 | Mismo producto que Q11 cotizado en USD.
Q7 · Pradecon 173195 | Hoja LAF (C16) | 1.60 | 1000 × 2000 | ARS | 2051.0200 | 1545 | 1.3275
Q8 · Pradecon 173195 | Hoja LAF (C18) | 1.25 | 1220 × 2440 | ARS | 1993.5100 | 1545 | 1.2903
Q9 · Pradecon 173195 | Hoja LAF (C14) | 2.00 | 1500 × 3000 | ARS | 1978.2200 | 1545 | 1.2804
Q10 · Pradecon 173195 | Hoja LAC (1/8) | 3.20 | 1500 × 3000 | ARS | 1702.4900 | 1545 | 1.1019
Q11 · Pradecon 173195 | Hoja LAC (3/16) | 4.75 | 1500 × 3000 | ARS | 1685.5600 | 1545 | 1.0910
Q12 · Hierros Parrotta 413329 | Hoja doble decapada N°20 | 0.90 | 1220 × 2440 | USD | 1.3561 | 1 | 1.3561 | Neto con 6,84% de descuento, pago contado.
Q13 · Hierros Parrotta 413329 | Hoja doble decapada N°20 | 0.90 | 1000 × 2000 | USD | 1.3993 | 1 | 1.3993
Q14 · Hierros Parrotta 413329 | Hoja doble decapada N°18 (1,2) | 1.25 | 1220 × 2440 | USD | 1.3464 | 1 | 1.3464
Q15 · Hierros Parrotta 413329 | Hoja doble decapada N°16 | 1.60 | 1220 × 2440 | USD | 1.3443 | 1 | 1.3443
Q16 · Hierros Parrotta 413329 | Hoja doble decapada N°14 | 2.00 | 1220 × 2440 | USD | 1.3605 | 1 | 1.3605
Q17 · Hierros Parrotta 413329 | Hoja LAC 1/8 | 3.20 | 1500 × 3000 | USD | 1.1607 | 1 | 1.1607
Q18 · Hierros Parrotta 413329 | Hoja LAC 3/16 | 4.75 | 1500 × 3000 | USD | 1.1678 | 1 | 1.1678
Q19 · Pacheco Chapas PR 42021 | Rollo LAF (fleje) | 1.25 | Ancho 200 | USD | 1.1860 | 1530 | 1.1860 | Discos 2,5 kg. 6 rollos en 2.951 kg (~0,5 t c/u).
Q20 · Pacheco Chapas PR 42021 | Rollo LAF (fleje) | 1.60 | Ancho 200 y 250 | USD | 1.1860 | 1530 | 1.1860 | Discos 5 kg. Rollos de ~0,5 y ~0,6 t.
Q21 · Pacheco Chapas PR 42021 | Rollo LAF (fleje) | 2.00 | Ancho 249 y 300 | USD | 1.1980 | 1530 | 1.1980 | Discos 10 kg. Rollos de ~0,5 y ~0,74 t.
Q22 · Pacheco Chapas PR 42021 | Plancha cortada a medida LAF | 1.25 | 1220 × 540 (3×2 cuerpos) | USD | 1.4260 | 1530 | 1.4260 | Referencia: chapa a medida.
Q23 · Pacheco Chapas PR 42021 | Plancha cortada a medida LAF | 1.60 | 1000 × 475 (3 cuerpos) | USD | 1.4530 | 1530 | 1.4530
Q24 · Pacheco Chapas PR 42021 | Plancha cortada a medida LAF | 2.00 | 1500 × 563 (3 cuerpos) | USD | 1.4290 | 1530 | 1.4290
Q25 · Pacheco Chapas PR 42021 | Plancha cortada a medida LAC | 3.20 | 1500 × 2584 / 1988 | USD | 1.2560 | 1530 | 1.2560
Q26 · Pacheco Chapas PR 42024 | Plancha cortada a medida LAC | 4.75 | 1245 × 1360 / 1800 | USD | 1.2360 | 1530 | 1.2360
Bobina madre: sin cotización todavía (se usa el precio de la bobina flejada más la diferencia de la sección 4). Polimetal (chapa a medida) quedó descartado y no se usa.
8. Precio del acero por espesor y forma de compra (USD por kg) — lo que usa el cálculo
Espesor (mm) | Bobina ancho estándar (A, cuerpos) | Hoja estándar (B y D) | Fleje a medida (discos A, D y referencia) | Bobina madre (C) | Chapa cortada a medida (referencia) | Diferencia hoja vs. bobina | Fuente
0.90 | 1.2629 | 1.3561 | 1.2629 | 1.2629 | 1.2629 | 7.4% | Bobina y fleje: Pradecon Q1 · Hoja: Parrotta Q12 · A medida: no aplica (se usa fleje)
1.25 | 1.2506 | 1.2903 | 1.1860 | 1.2506 | 1.4260 | 3.2% | Bobina: Pradecon Q2 · Hoja: Pradecon Q8 · Fleje: Pacheco Q19 · A medida: Pacheco Q22
1.60 | 1.2506 | 1.3275 | 1.1860 | 1.2506 | 1.4530 | 6.2% | Bobina: Pradecon Q3 · Hoja: Pradecon Q7 · Fleje: Pacheco Q20 · A medida: Pacheco Q23
2.00 | 1.2629 | 1.2804 | 1.1980 | 1.2629 | 1.4290 | 1.4% | Bobina: Pradecon Q4 · Hoja: Pradecon Q9 · Fleje: Pacheco Q21 · A medida: Pacheco Q24
3.20 | 1.1137 | 1.1019 | 1.1137 | 1.1137 | 1.2560 | -1.1% | Bobina: Pradecon Q5 · Hoja: Pradecon Q10 · Fleje: no aplica · A medida: Pacheco Q25
4.75 | 1.1137 | 1.0910 | 1.1137 | 1.1137 | 1.2360 | -2.0% | Bobina: ESTIMADO (sin cotización; igual a LAC 3,2) · Hoja: Pradecon Q11 · A medida: Pacheco Q26
Si cambia un espesor en Nesting, tiene que existir la misma fila acá (el cálculo busca el precio por espesor).
6. Equipos e inversión (precios y cantidades editables)
¿El puente grúa ya está previsto en el layout por otro motivo? (SI/NO) | NO |  | Si es SI, no se carga a las opciones A y C (la cátedra ya recomendó puente grúa para descargar chapa).
Equipo | Precio unitario (USD) | Cant. A: bobina por formato | Cant. B: hojas | Cant. C: bobina madre | Cant. D: hojas + fleje | Cant. referencia (a medida) | Subtotal A | Subtotal B | Subtotal C | Subtotal D | Subtotal referencia | Fuente / nota
Línea de corte transversal 1–6 mm × 1.600 (desbobinador, aplanadora, alimentador servo, cizalla) | 80000 | 1 | 0 | 1 | 0 | 0 | 80000 | 0 | 80000 | 0 | 0 | ESTIMADO. Hener publica USD 45.000 para 0,2–3 mm × 1.250; con rodantes (hasta 4,75 mm) se requiere una línea más pesada. Cotizar.
Guillotina hidráulica 6 × 3.200 mm con tope motorizado | 25810.97465 | 1 | 1 | 0 | 1 | 0 | 25810.97465 | 25810.97465 | 0 | 25810.97465 | 0 | Molinari HG 6×3200 (MercadoLibre), sin IVA, convertido al TC de Supuestos. En A separa las tiras de la línea.
Cortadora longitudinal (slitter) 0,3–3,2 × 1.600 | 60000 | 0 | 0 | 1 | 0 | 0 | 0 | 0 | 60000 | 0 | 0 | ESTIMADO. Cangzhou Zunsheng publica USD 28.600–59.620 FOB (0,3–3,0 mm × 1.500, 10 t).
Puente grúa monoviga 10 t (incluye carrilera) | 30000 | 1 | 0 | 1 | 0 | 0 | 30000 | 0 | 30000 | 0 | 0 | Dongqi Crane: 10 t básico USD 10.000–50.000. Cantidad automática según 'ya previsto'.
Pinza en C portabobinas + cunas | 6000 | 1 | 0 | 1 | 0 | 0 | 6000 | 0 | 6000 | 0 | 0 | ESTIMADO.
Desbobinador + enderezador + alimentador servo para la prensa de discos | 12000 | 1 | 0 | 1 | 1 | 1 | 12000 | 0 | 12000 | 12000 | 12000 | ESTIMADO. En cotización (Cena, Henli, AEK, King Jime, Segura Llunell).
Estantería porta-flejes | 3000 | 1 | 0 | 1 | 1 | 1 | 3000 | 0 | 3000 | 3000 | 3000 | ESTIMADO.
Autoelevador eléctrico 2,5 t | 20000 | 0 | 1 | 0 | 1 | 0 | 0 | 20000 | 0 | 20000 | 0 | MercadoLibre GBA, nuevos 2026: USD 13.700–26.700 (EISEN).
Mesa elevadora de tijera 1500 × 3000 mm, 3 t, elevación ~1 m (paquete de hojas a la altura de la guillotina) | 7000 | 0 | 1 | 0 | 1 | 0 | 0 | 7000 | 0 | 7000 | 0 | ESTIMADO. Referencia: mesas de 3 t con plataforma 3500 × 1500 y 3,5 m de elevación ~EUR 11.750 (SIA Suministros); una de ~1 m de elevación es más barata. Cotizar.
Apoyos con bolas (mesa de bolas) entre la mesa elevadora y la guillotina | 1500 | 0 | 1 | 0 | 1 | 0 | 0 | 1500 | 0 | 1500 | 0 | ESTIMADO. Consultar si la guillotina trae brazos delanteros con bolas: en ese caso no hace falta.
Racks por espesor en el almacén de MP y carros porta-desarrollos | 2000 | 0 | 1 | 0 | 1 | 0 | 0 | 2000 | 0 | 2000 | 0 | ESTIMADO.
Mesa de alimentación de tiras al balancín | 1500 | 0 | 1 | 0 | 0 | 0 | 0 | 1500 | 0 | 0 | 0 | ESTIMADO. Discos desde tiras de hoja (opción B).
TOTAL |  |  |  |  |  |  | 156810.9746 | 57810.97465 | 191000 | 71310.97465 | 15000
Precios en USD sin IVA. El balancín/prensa de discos y la cilindradora existen en todas las opciones y no se incluyen.

Sheet: Demanda
Demanda por formato (unidades/año)
Fuente: Dimensionamiento_TecnicoV2.xlsx, hoja datos_base. Cada unidad lleva 1 cuerpo, 1 cúpula y 1 fondo (el 1 kg lleva cuerpo de tubo comprado).
Matafuegos terminados
Formato | Línea | 2026 | 2027 | 2028 | 2029 | 2030 | 2031 | 2032 | 2033 | 2034 | 2035
1 kg | Manual | 4179 | 5997 | 6852 | 8467 | 12681 | 15620 | 20333 | 25132 | 28573 | 32073
2,5 kg | Manual | 295 | 709 | 987 | 1501 | 2312 | 3252 | 4103 | 5105 | 6195 | 7425
5 kg | Manual | 2256 | 3847 | 5094 | 6823 | 10819 | 14606 | 18878 | 23368 | 26968 | 30751
10 kg | Manual | 92 | 177 | 253 | 358 | 603 | 872 | 1127 | 1395 | 1612 | 1841
25 kg | Rodante | 34 | 58 | 76 | 100 | 156 | 212 | 273 | 338 | 393 | 453
50 kg | Rodante | 75 | 128 | 166 | 221 | 343 | 466 | 599 | 743 | 866 | 997
70 kg | Rodante | 16 | 29 | 36 | 48 | 74 | 101 | 131 | 163 | 189 | 218
100 kg | Rodante | 11 | 18 | 24 | 33 | 50 | 67 | 87 | 108 | 126 | 145
TOTAL |  | 6958 | 10963 | 13488 | 17551 | 27038 | 35196 | 45531 | 56352 | 64922 | 73903
Cilindros vendidos vacíos
Formato | Línea | 2026 | 2027 | 2028 | 2029 | 2030 | 2031 | 2032 | 2033 | 2034 | 2035
1 kg | Manual | 0 | 0 | 7662 | 26695 | 49435 | 71680 | 101341 | 131001 | 146820 | 170548
2,5 kg | Manual | 0 | 0 | 300 | 1044 | 1933 | 2803 | 3963 | 5123 | 5741 | 6669
5 kg | Manual | 0 | 0 | 1479 | 5152 | 9541 | 13834 | 19559 | 25283 | 28336 | 32915
10 kg | Manual | 0 | 0 | 90 | 315 | 583 | 846 | 1195 | 1545 | 1731 | 2011
25 kg | Rodante | 0 | 0 | 14 | 50 | 93 | 135 | 191 | 247 | 277 | 322
50 kg | Rodante | 0 | 0 | 32 | 111 | 205 | 298 | 421 | 544 | 610 | 708
70 kg | Rodante | 0 | 0 | 7 | 24 | 45 | 65 | 92 | 119 | 133 | 155
100 kg | Rodante | 0 | 0 | 5 | 16 | 30 | 43 | 60 | 78 | 88 | 102
TOTAL |  | 0 | 0 | 9589 | 33407 | 61865 | 89704 | 126822 | 163940 | 183736 | 213430
TOTAL UNIDADES A FABRICAR
Formato | Línea | 2026 | 2027 | 2028 | 2029 | 2030 | 2031 | 2032 | 2033 | 2034 | 2035
1 kg | Manual | 4179 | 5997 | 14514 | 35162 | 62116 | 87300 | 121674 | 156133 | 175393 | 202621
2,5 kg | Manual | 295 | 709 | 1287 | 2545 | 4245 | 6055 | 8066 | 10228 | 11936 | 14094
5 kg | Manual | 2256 | 3847 | 6573 | 11975 | 20360 | 28440 | 38437 | 48651 | 55304 | 63666
10 kg | Manual | 92 | 177 | 343 | 673 | 1186 | 1718 | 2322 | 2940 | 3343 | 3852
25 kg | Rodante | 34 | 58 | 90 | 150 | 249 | 347 | 464 | 585 | 670 | 775
50 kg | Rodante | 75 | 128 | 198 | 332 | 548 | 764 | 1020 | 1287 | 1476 | 1705
70 kg | Rodante | 16 | 29 | 43 | 72 | 119 | 166 | 223 | 282 | 322 | 373
100 kg | Rodante | 11 | 18 | 29 | 49 | 80 | 110 | 147 | 186 | 214 | 247
TOTAL |  | 6958 | 10963 | 23077 | 50958 | 88903 | 124900 | 172353 | 220292 | 248658 | 287333
Discos de rodantes (25–100 kg): se compran tercerizados embutidos, no entran en este análisis.

Sheet: Nesting
Nesting: cuántas piezas salen de cada hoja, bobina y fleje
Editables: medidas de piezas, formato de hoja y ancho de bobina de cada formato.
A) CUERPOS |  |  |  |  |  |  | Hoja estándar + guillotina (opción B) |  |  |  |  |  |  |  | Bobina de ancho estándar + línea de corte (opción A)
Formato | Línea | Alto cuerpo (mm) | Perímetro = largo desarrollo (mm) | Espesor (mm) | Acero | Masa del desarrollo (kg) | HOJA ancho (mm) | HOJA largo (mm) | Piezas orient. 1 | Piezas orient. 2 | Piezas por hoja | Aprovech. hoja | Masa hoja (kg) | Cortes guillotina por hoja | BOBINA ancho (mm) | Piezas a lo ancho (alto cruzado) | Aprov. (alto cruzado) | Piezas a lo ancho (perím. cruzado) | Aprov. (perím. cruzado) | Piezas por golpe | Avance por golpe (mm) | Aprovech. bobina | Orientación
2,5 kg | Manual | 269.5 | 385.5 | 1.25 | LAF | 1.02 | 1220 | 2440 | 24 | 27 | 27 | 94.2% | 29.28 | 30 | 1220 | 4 | 88.4% | 3 | 94.8% | 3 | 269.5 | 94.3% | Perímetro a lo ancho
5 kg | Manual | 330.0 | 474.5 | 1.60 | LAF | 1.97 | 1000 | 2000 | 12 | 12 | 12 | 94.0% | 25.18 | 15 | 1000 | 3 | 99.0% | 2 | 94.9% | 3 | 474.5 | 98.5% | Alto a lo ancho
10 kg | Manual | 495.0 | 563.0 | 2.00 | LAF | 4.39 | 1500 | 3000 | 15 | 12 | 15 | 92.9% | 70.83 | 18 | 1000 | 2 | 99.0% | 1 | 56.3% | 2 | 563.0 | 98.5% | Alto a lo ancho
25 kg | Rodante | 490.0 | 858.0 | 3.20 | LAC | 10.59 | 1500 | 3000 | 9 | 6 | 9 | 84.1% | 113.33 | 12 | 1500 | 3 | 98.0% | 1 | 57.2% | 3 | 858.0 | 97.5% | Alto a lo ancho
50 kg | Rodante | 640.0 | 994.0 | 3.20 | LAC | 16.02 | 1500 | 3000 | 6 | 4 | 6 | 84.8% | 113.33 | 8 | 1500 | 2 | 85.3% | 1 | 66.3% | 2 | 994.0 | 84.9% | Alto a lo ancho
70 kg | Rodante | 680.0 | 1212.0 | 4.75 | LAC | 30.81 | 1500 | 3000 | 4 | 4 | 4 | 73.3% | 168.22 | 6 | 1245 | 1 | 54.6% | 1 | 97.3% | 1 | 680.0 | 96.9% | Perímetro a lo ancho
100 kg | Rodante | 900.0 | 1212.0 | 4.75 | LAC | 40.78 | 1500 | 3000 | 2 | 3 | 3 | 72.7% | 168.22 | 4 | 1245 | 1 | 72.3% | 1 | 97.3% | 1 | 900.0 | 96.9% | Perímetro a lo ancho
Mezcla de 70 y 100 kg en la misma hoja (usa el formato de hoja del 70 kg)
Cuerpos de 100 kg por hoja mixta |  |  |  |  |  | 1
Cuerpos de 70 kg por hoja mixta |  |  |  |  |  | 3
Largo ocupado (mm) |  |  |  |  |  | 2940
¿Entra? (perímetros a lo ancho, altos a lo largo, mismo espesor) |  |  |  |  |  | SI
Aprovechamiento hoja mixta |  |  |  |  |  | 79.2%
Masa hoja mixta (kg) |  |  |  |  |  | 168.22
Cortes por hoja mixta |  |  |  |  |  | 5
Mezcla activa en el cálculo |  |  |  |  |  | SI
B) CÚPULAS Y FONDOS (discos de manuales) |  |  |  |  |  |  |  |  | Hoja estándar → tiras en guillotina → balancín (opción B)
Formato | Pieza | Diámetro del disco (mm) | Espesor (mm) | Acero | Masa del disco (kg) | Ancho de fleje = D+2s (mm) | Paso = D+s (mm) | Aprovech. fleje (1 fila) | HOJA ancho (mm) | HOJA largo (mm) | Tiras orient. 1 | Discos/tira o.1 | Piezas o.1 | Tiras orient. 2 | Discos/tira o.2 | Piezas o.2 | Discos por hoja | Aprovech. hoja | Masa hoja (kg) | Tiras por hoja | Discos por tira | FLEJE COMPRADO: ancho (mm) | Aprovech. fleje comprado | Nota
1 kg | Cúpula | 108.0 | 0.90 | LAF | 0.065 | 114.0 | 111.0 | 72.0% | 1220 | 2440 | 10 | 21 | 210 | 21 | 10 | 210 | 210 | 64.6% | 21.08 | 10 | 21 | 114 | 72.0% | ESTIMADO: deducido de la masa de pieza del registro (0,0461 kg) / 0,71 (relación pieza/disco de las otras cúpulas). Confirmar. Fleje: estimado D+2s (Pradecon corta a medida sin cargo).
1 kg | Fondo | 100.0 | 0.90 | LAF | 0.056 | 106.0 | 103.0 | 71.6% | 1000 | 2000 | 9 | 19 | 171 | 18 | 9 | 162 | 171 | 67.2% | 14.17 | 9 | 19 | 106 | 71.6% | ESTIMADO: deducido de la masa de pieza (0,0497 kg) / 0,90 (relación de los otros fondos). Confirmar. Fleje: estimado D+2s (Pradecon corta a medida sin cargo).
2,5 kg | Cúpula | 179.0 | 1.25 | LAF | 0.248 | 185.0 | 182.0 | 74.4% | 1220 | 2440 | 6 | 13 | 78 | 13 | 6 | 78 | 78 | 65.9% | 29.28 | 6 | 13 | 200 | 68.8% | Planilla 'Dimensiones de chapa'. Fleje: Pacheco Chapas.
2,5 kg | Fondo | 148.0 | 1.25 | LAF | 0.169 | 154.0 | 151.0 | 73.6% | 1220 | 2440 | 7 | 16 | 112 | 15 | 8 | 120 | 120 | 69.3% | 29.28 | 15 | 8 | 200 | 56.7% | Planilla 'Dimensiones de chapa'. Fleje: Pacheco Chapas.
5 kg | Cúpula | 221.0 | 1.60 | LAF | 0.483 | 227.0 | 224.0 | 75.1% | 1220 | 2440 | 5 | 10 | 50 | 10 | 5 | 50 | 50 | 64.4% | 37.48 | 5 | 10 | 250 | 68.2% | Planilla 'Dimensiones de chapa'. Fleje: Pacheco Chapas.
5 kg | Fondo | 177.0 | 1.60 | LAF | 0.310 | 183.0 | 180.0 | 74.3% | 1000 | 2000 | 5 | 11 | 55 | 10 | 5 | 50 | 55 | 67.7% | 25.18 | 5 | 11 | 200 | 68.0% | Planilla 'Dimensiones de chapa'. Fleje: Pacheco Chapas.
10 kg | Cúpula | 258.0 | 2.00 | LAF | 0.823 | 264.0 | 261.0 | 75.5% | 1500 | 3000 | 5 | 11 | 55 | 11 | 5 | 55 | 55 | 63.9% | 70.83 | 5 | 11 | 300 | 66.4% | Registro de referencia (FADESA) usa 1,6 mm en la cúpula del 10 kg; se toma 2,0 mm según tabla FLAMA. Editable. Fleje: Pacheco Chapas.
10 kg | Fondo | 205.0 | 2.00 | LAF | 0.520 | 211.0 | 208.0 | 74.8% | 1500 | 3000 | 7 | 14 | 98 | 14 | 7 | 98 | 98 | 71.9% | 70.83 | 7 | 14 | 249 | 63.4% | Tabla FLAMA ('Dimensiones de chapa'). Fleje: Pacheco Chapas.
Ancho de fleje D+2s (columna G) = el que cortan ustedes (opciones B y C). Ancho comprado (columna W) = el cotizado a Pacheco para A, D y referencia; si es más ancho que D+2s, baja el aprovechamiento. Los discos se cortan en una fila por fleje (troquel simple). Un troquel de 2 filas escalonadas mejora el aprovechamiento ~8–10 puntos; queda como mejora futura.

Sheet: BobinaMadre
Opción C — Bobina madre de ancho estándar + corte longitudinal propio
Se compra una bobina ancha por espesor y se corta en flejes: de cuerpo (van a la línea de corte transversal) y de disco (van al balancín).
Patrones y participaciones optimizados por programación lineal sobre la demanda 2026–2035 (mínimo acero comprado). Editables: ancho de madre, orientación, tiras por patrón y % de cada patrón.
Grupo 0,9 mm
Ancho de bobina madre (mm) | 1220 | Espesor (mm) | 0.90 | Acero | LAF | kg por metro de madre | 8.64
Tira (fleje) | Orientación (1 = alto a lo ancho, 2 = perímetro a lo ancho) | Ancho de tira (mm) | Avance por unidad (mm) | Patrón 1 (tiras) | Patrón 2 (tiras) | Patrón 3 (tiras) | Tiras por metro de madre (ponderado)
Cúpula 1 kg | — | 114.0 | 111.0 | 5 | 10 | 0 | 5.639
Fondo 1 kg | — | 106.0 | 103.0 | 6 | 0 | 0 | 5.233
Participación de cada patrón (% de los metros de madre) |  |  |  | 87.2% | 12.8% | 0.0% | Suma 100% OK
Ancho usado por patrón (mm) |  |  |  | 1206.0 | 1140.0 | 0.0
Orilla (scrap de borde) por patrón (mm) |  |  |  | 14.0 | 80.0 | 0.0
¿Entra en la madre? (orilla ≥ margen) |  |  |  | OK | OK | sin uso
Cálculo anual |  |  | 2026 | 2027 | 2028 | 2029 | 2030 | 2031 | 2032 | 2033 | 2034 | 2035
Metros necesarios: Cúpula 1 kg |  |  | 463.869 | 665.667 | 1611.054 | 3902.982 | 6894.876 | 9690.3 | 13505.814 | 17330.763 | 19468.623 | 22490.931
Metros necesarios: Fondo 1 kg |  |  | 430.437 | 617.691 | 1494.942 | 3621.686 | 6397.948 | 8991.9 | 12532.422 | 16081.699 | 18065.479 | 20869.963
Metros de bobina madre a cortar |  |  | 82.26063525 | 118.046669 | 285.6977411 | 692.1388984 | 1222.709169 | 1718.438252 | 2395.065933 | 3073.366778 | 3452.486145 | 3988.44991
Acero de madre comprado (t) |  |  | 0.7 | 1.0 | 2.5 | 6.0 | 10.6 | 14.9 | 20.8 | 26.7 | 30.0 | 34.6
Acero neto en piezas del grupo (t) |  |  | 0.5 | 0.7 | 1.7 | 4.2 | 7.5 | 10.5 | 14.7 | 18.8 | 21.1 | 24.4
Aprovechamiento del grupo |  |  | 70.5% | 70.5% | 70.5% | 70.5% | 70.5% | 70.5% | 70.5% | 70.5% | 70.5% | 70.5%
Bobinas madre por año |  |  | 0.2 | 0.3 | 0.8 | 2.0 | 3.5 | 5.0 | 6.9 | 8.9 | 10.0 | 11.5
Flejes de disco generados por año |  |  | 2.6 | 3.7 | 9.0 | 21.8 | 38.5 | 54.1 | 75.4 | 96.7 | 108.7 | 125.5
Horas de corte longitudinal |  |  | 0.2128771584 | 0.3054855992 | 0.739339334 | 1.791143011 | 3.164172666 | 4.447038987 | 6.198041486 | 7.953373862 | 8.934473185 | 10.32146033
Grupo 1,25 mm
Ancho de bobina madre (mm) | 1000 | Espesor (mm) | 1.25 | Acero | LAF | kg por metro de madre | 9.84
Tira (fleje) | Orientación (1 = alto a lo ancho, 2 = perímetro a lo ancho) | Ancho de tira (mm) | Avance por unidad (mm) | Patrón 1 (tiras) | Patrón 2 (tiras) | Patrón 3 (tiras) | Tiras por metro de madre (ponderado)
Cuerpo 2,5 kg | 1 | 269.5 | 385.5 | 1 | 2 | 3 | 2.306
Cúpula 2,5 kg | — | 185.0 | 182.0 | 3 | 2 | 0 | 1.089
Fondo 2,5 kg | — | 154.0 | 151.0 | 1 | 0 | 1 | 0.903
Participación de cada patrón (% de los metros de madre) |  |  |  | 29.8% | 9.7% | 60.5% | Suma 100% OK
Ancho usado por patrón (mm) |  |  |  | 978.5 | 909.0 | 962.5
Orilla (scrap de borde) por patrón (mm) |  |  |  | 21.5 | 91.0 | 37.5
¿Entra en la madre? (orilla ≥ margen) |  |  |  | OK | OK | OK
Cálculo anual |  |  | 2026 | 2027 | 2028 | 2029 | 2030 | 2031 | 2032 | 2033 | 2034 | 2035
Metros necesarios: Cuerpo 2,5 kg |  |  | 113.7225 | 273.3195 | 496.1385 | 981.0975 | 1636.4475 | 2334.2025 | 3109.443 | 3942.894 | 4601.328 | 5433.237
Metros necesarios: Cúpula 2,5 kg |  |  | 53.69 | 129.038 | 234.234 | 463.19 | 772.59 | 1102.01 | 1468.012 | 1861.496 | 2172.352 | 2565.108
Metros necesarios: Fondo 2,5 kg |  |  | 44.545 | 107.059 | 194.337 | 384.295 | 640.995 | 914.305 | 1217.966 | 1544.428 | 1802.336 | 2128.194
Metros de bobina madre a cortar |  |  | 49.31569762 | 118.5248461 | 215.1501791 | 425.4523744 | 709.6445302 | 1012.22559 | 1348.408193 | 1709.833747 | 1995.363277 | 2356.120143
Acero de madre comprado (t) |  |  | 0.5 | 1.2 | 2.1 | 4.2 | 7.0 | 10.0 | 13.3 | 16.9 | 19.7 | 23.3
Acero neto en piezas del grupo (t) |  |  | 0.4 | 1.0 | 1.9 | 3.7 | 6.1 | 8.7 | 11.6 | 14.7 | 17.2 | 20.3
Aprovechamiento del grupo |  |  | 87.1% | 87.1% | 87.1% | 87.1% | 87.1% | 87.1% | 87.1% | 87.1% | 87.1% | 87.1%
Bobinas madre por año |  |  | 0.2 | 0.6 | 1.1 | 2.1 | 3.5 | 5.0 | 6.7 | 8.5 | 9.9 | 11.6
Flejes de disco generados por año |  |  | 0.5 | 1.2 | 2.1 | 4.2 | 7.0 | 10.0 | 13.3 | 16.8 | 19.7 | 23.2
Horas de corte longitudinal |  |  | 0.2033911126 | 0.4888281317 | 0.8873368202 | 1.75467926 | 2.926763638 | 4.174688769 | 5.561195642 | 7.051811186 | 8.229411255 | 9.717268954
Grupo 1,6 mm
Ancho de bobina madre (mm) | 1000 | Espesor (mm) | 1.60 | Acero | LAF | kg por metro de madre | 12.59
Tira (fleje) | Orientación (1 = alto a lo ancho, 2 = perímetro a lo ancho) | Ancho de tira (mm) | Avance por unidad (mm) | Patrón 1 (tiras) | Patrón 2 (tiras) | Patrón 3 (tiras) | Tiras por metro de madre (ponderado)
Cuerpo 5 kg | 1 | 330.0 | 474.5 | 0 | 1 | 3 | 1.931
Cúpula 5 kg | — | 227.0 | 224.0 | 1 | 2 | 0 | 0.911
Fondo 5 kg | — | 183.0 | 180.0 | 4 | 1 | 0 | 0.732
Participación de cada patrón (% de los metros de madre) |  |  |  | 7.9% | 41.6% | 50.5% | Suma 100% OK
Ancho usado por patrón (mm) |  |  |  | 959.0 | 967.0 | 990.0
Orilla (scrap de borde) por patrón (mm) |  |  |  | 41.0 | 33.0 | 10.0
¿Entra en la madre? (orilla ≥ margen) |  |  |  | OK | OK | OK
Cálculo anual |  |  | 2026 | 2027 | 2028 | 2029 | 2030 | 2031 | 2032 | 2033 | 2034 | 2035
Metros necesarios: Cuerpo 5 kg |  |  | 1070.472 | 1825.4015 | 3118.8885 | 5682.1375 | 9660.82 | 13494.78 | 18238.3565 | 23084.8995 | 26241.748 | 30209.517
Metros necesarios: Cúpula 5 kg |  |  | 505.344 | 861.728 | 1472.352 | 2682.4 | 4560.64 | 6370.56 | 8609.888 | 10897.824 | 12388.096 | 14261.184
Metros necesarios: Fondo 5 kg |  |  | 406.08 | 692.46 | 1183.14 | 2155.5 | 3664.8 | 5119.2 | 6918.66 | 8757.18 | 9954.72 | 11459.88
Metros de bobina madre a cortar |  |  | 554.6025676 | 945.7252117 | 1615.869981 | 2943.867796 | 5005.189839 | 6991.532368 | 9449.139579 | 11960.09287 | 13595.62961 | 15651.29746
Acero de madre comprado (t) |  |  | 7.0 | 12.0 | 20.4 | 37.3 | 63.3 | 88.5 | 119.6 | 151.4 | 172.1 | 198.1
Acero neto en piezas del grupo (t) |  |  | 6.2 | 10.6 | 18.2 | 33.1 | 56.3 | 78.6 | 106.3 | 134.5 | 152.9 | 176.0
Aprovechamiento del grupo |  |  | 88.9% | 88.9% | 88.9% | 88.9% | 88.9% | 88.9% | 88.9% | 88.9% | 88.9% | 88.9%
Bobinas madre por año |  |  | 0.6 | 1.0 | 1.7 | 3.1 | 5.3 | 7.4 | 10.0 | 12.6 | 14.3 | 16.5
Flejes de disco generados por año |  |  | 1.0 | 1.6 | 2.8 | 5.1 | 8.7 | 12.1 | 16.4 | 20.7 | 23.6 | 27.1
Horas de corte longitudinal |  |  | 0.6697499516 | 1.142078042 | 1.951359234 | 3.555077868 | 6.044374563 | 8.44312439 | 11.41098355 | 14.44326458 | 16.41837381 | 18.90084238
Grupo 2,0 mm
Ancho de bobina madre (mm) | 1000 | Espesor (mm) | 2.00 | Acero | LAF | kg por metro de madre | 15.74
Tira (fleje) | Orientación (1 = alto a lo ancho, 2 = perímetro a lo ancho) | Ancho de tira (mm) | Avance por unidad (mm) | Patrón 1 (tiras) | Patrón 2 (tiras) | Patrón 3 (tiras) | Tiras por metro de madre (ponderado)
Cuerpo 10 kg | 1 | 495.0 | 563.0 | 0 | 0 | 2 | 1.396
Cúpula 10 kg | — | 264.0 | 261.0 | 2 | 3 | 0 | 0.647
Fondo 10 kg | — | 211.0 | 208.0 | 2 | 0 | 0 | 0.516
Participación de cada patrón (% de los metros de madre) |  |  |  | 25.8% | 4.4% | 69.8% | Suma 100% OK
Ancho usado por patrón (mm) |  |  |  | 950.0 | 792.0 | 990.0
Orilla (scrap de borde) por patrón (mm) |  |  |  | 50.0 | 208.0 | 10.0
¿Entra en la madre? (orilla ≥ margen) |  |  |  | OK | OK | OK
Cálculo anual |  |  | 2026 | 2027 | 2028 | 2029 | 2030 | 2031 | 2032 | 2033 | 2034 | 2035
Metros necesarios: Cuerpo 10 kg |  |  | 51.796 | 99.651 | 193.109 | 378.899 | 667.718 | 967.234 | 1307.286 | 1655.22 | 1882.109 | 2168.676
Metros necesarios: Cúpula 10 kg |  |  | 24.012 | 46.197 | 89.523 | 175.653 | 309.546 | 448.398 | 606.042 | 767.34 | 872.523 | 1005.372
Metros necesarios: Fondo 10 kg |  |  | 19.136 | 36.816 | 71.344 | 139.984 | 246.688 | 357.344 | 482.976 | 611.52 | 695.344 | 801.216
Metros de bobina madre a cortar |  |  | 37.09252363 | 71.36279003 | 138.2906044 | 271.339874 | 478.1710112 | 692.6625609 | 936.1830421 | 1185.348038 | 1347.829419 | 1553.047837
Acero de madre comprado (t) |  |  | 0.6 | 1.1 | 2.2 | 4.3 | 7.6 | 11.0 | 14.8 | 18.8 | 21.3 | 24.6
Acero neto en piezas del grupo (t) |  |  | 0.5 | 1.0 | 2.0 | 3.9 | 6.8 | 9.8 | 13.3 | 16.8 | 19.2 | 22.1
Aprovechamiento del grupo |  |  | 89.8% | 89.8% | 89.8% | 89.8% | 89.8% | 89.8% | 89.8% | 89.8% | 89.8% | 89.8%
Bobinas madre por año |  |  | 0.2 | 0.5 | 0.9 | 1.7 | 3.0 | 4.4 | 5.9 | 7.5 | 8.5 | 9.8
Flejes de disco generados por año |  |  | 0.3 | 0.5 | 1.0 | 2.0 | 3.5 | 5.1 | 6.9 | 8.7 | 9.9 | 11.4
Horas de corte longitudinal |  |  | 0.19148627 | 0.3684029326 | 0.7139107676 | 1.400763693 | 2.468507785 | 3.575797956 | 4.832946946 | 6.119235151 | 6.958028269 | 8.017446871
Grupo 3,2 mm
Ancho de bobina madre (mm) | 1500 | Espesor (mm) | 3.20 | Acero | LAC | kg por metro de madre | 37.78
Tira (fleje) | Orientación (1 = alto a lo ancho, 2 = perímetro a lo ancho) | Ancho de tira (mm) | Avance por unidad (mm) | Patrón 1 (tiras) | Patrón 2 (tiras) | Patrón 3 (tiras) | Tiras por metro de madre (ponderado)
Cuerpo 25 kg | 1 | 490.0 | 858.0 | 0 | 3 | 0 | 0.622
Cuerpo 50 kg | 1 | 640.0 | 994.0 | 2 | 0 | 0 | 1.586
Participación de cada patrón (% de los metros de madre) |  |  |  | 79.3% | 20.7% | 0.0% | Suma 100% OK
Ancho usado por patrón (mm) |  |  |  | 1280.0 | 1470.0 | 0.0
Orilla (scrap de borde) por patrón (mm) |  |  |  | 220.0 | 30.0 | 0.0
¿Entra en la madre? (orilla ≥ margen) |  |  |  | OK | OK | sin uso
Cálculo anual |  |  | 2026 | 2027 | 2028 | 2029 | 2030 | 2031 | 2032 | 2033 | 2034 | 2035
Metros necesarios: Cuerpo 25 kg |  |  | 29.172 | 49.764 | 77.22 | 128.7 | 213.642 | 297.726 | 398.112 | 501.93 | 574.86 | 664.95
Metros necesarios: Cuerpo 50 kg |  |  | 74.55 | 127.232 | 196.812 | 330.008 | 544.712 | 759.416 | 1013.88 | 1279.278 | 1467.144 | 1694.77
Metros de bobina madre a cortar |  |  | 47.01690212 | 80.24217962 | 124.2277992 | 208.1281534 | 343.6969112 | 478.9671815 | 640.4633205 | 807.480695 | 925.2926337 | 1069.739382
Acero de madre comprado (t) |  |  | 1.8 | 3.0 | 4.7 | 7.9 | 13.0 | 18.2 | 24.3 | 30.7 | 35.1 | 40.6
Acero neto en piezas del grupo (t) |  |  | 1.6 | 2.7 | 4.1 | 6.9 | 11.4 | 15.9 | 21.3 | 26.8 | 30.7 | 35.5
Aprovechamiento del grupo |  |  | 87.5% | 87.5% | 87.5% | 87.4% | 87.5% | 87.5% | 87.4% | 87.5% | 87.5% | 87.5%
Bobinas madre por año |  |  | 0.5 | 0.9 | 1.3 | 2.3 | 3.7 | 5.2 | 6.9 | 8.8 | 10.0 | 11.6
Flejes de disco generados por año |  |  | 0.0 | 0.0 | 0.0 | 0.0 | 0.0 | 0.0 | 0.0 | 0.0 | 0.0 | 0.0
Horas de corte longitudinal |  |  | 0.4020980201 | 0.6862472876 | 1.062421169 | 1.779953902 | 2.939365234 | 4.09622384 | 5.477371359 | 6.905737598 | 7.913289035 | 9.148626732
Grupo 4,75 mm
Ancho de bobina madre (mm) | 1245 | Espesor (mm) | 4.75 | Acero | LAC | kg por metro de madre | 46.54
Tira (fleje) | Orientación (1 = alto a lo ancho, 2 = perímetro a lo ancho) | Ancho de tira (mm) | Avance por unidad (mm) | Patrón 1 (tiras) | Patrón 2 (tiras) | Patrón 3 (tiras) | Tiras por metro de madre (ponderado)
Cuerpo 70 y 100 kg (fleje compartido) | 2 (fijo) | 1212.0 | alto de cada uno | 1 | 0 | 0 | 1.000
Participación de cada patrón (% de los metros de madre) |  |  |  | 100.0% | 0.0% | 0.0% | Suma 100% OK
Ancho usado por patrón (mm) |  |  |  | 1212.0 | 0.0 | 0.0
Orilla (scrap de borde) por patrón (mm) |  |  |  | 33.0 | 0.0 | 0.0
¿Entra en la madre? (orilla ≥ margen) |  |  |  | OK | sin uso | sin uso
Cálculo anual |  |  | 2026 | 2027 | 2028 | 2029 | 2030 | 2031 | 2032 | 2033 | 2034 | 2035
Metros necesarios: Cuerpo 70 y 100 kg (fleje compartido) |  |  | 20.78 | 35.92 | 55.34 | 93.06 | 152.92 | 211.88 | 283.94 | 359.16 | 411.56 | 475.94
Metros de bobina madre a cortar |  |  | 20.78 | 35.92 | 55.34 | 93.06 | 152.92 | 211.88 | 283.94 | 359.16 | 411.56 | 475.94
Acero de madre comprado (t) |  |  | 1.0 | 1.7 | 2.6 | 4.4 | 7.2 | 9.9 | 13.3 | 16.8 | 19.3 | 22.3
Acero neto en piezas del grupo (t) |  |  | 0.9 | 1.6 | 2.5 | 4.2 | 6.9 | 9.6 | 12.9 | 16.3 | 18.6 | 21.6
Aprovechamiento del grupo |  |  | 96.9% | 96.9% | 96.9% | 96.9% | 96.9% | 96.9% | 96.9% | 96.9% | 96.9% | 96.9%
Bobinas madre por año |  |  | 0.5 | 0.8 | 1.3 | 2.2 | 3.6 | 5.0 | 6.6 | 8.4 | 9.6 | 11.1
Flejes de disco generados por año |  |  | 0.0 | 0.0 | 0.0 | 0.0 | 0.0 | 0.0 | 0.0 | 0.0 | 0.0 | 0.0
Horas de corte longitudinal |  |  | 0.3731532061 | 0.6450271012 | 0.9937583458 | 1.671108631 | 2.746034085 | 3.804797946 | 5.098802759 | 6.449552719 | 7.390516531 | 8.546609091
TOTALES OPCIÓN C
Concepto |  |  | 2026 | 2027 | 2028 | 2029 | 2030 | 2031 | 2032 | 2033 | 2034 | 2035
Acero de madre comprado (t) |  |  | 11.6 | 20.0 | 34.6 | 64.0 | 108.7 | 152.5 | 206.1 | 261.2 | 297.5 | 343.4
Acero neto en piezas (t) |  |  | 10.2 | 17.7 | 30.4 | 56.0 | 95.0 | 133.2 | 180.0 | 228.0 | 259.7 | 299.9
Bobinas madre por año |  |  | 2.3 | 4.1 | 7.1 | 13.4 | 22.7 | 31.9 | 43.1 | 54.6 | 62.4 | 72.3
Flejes de disco por año |  |  | 4.3 | 7.0 | 14.9 | 33.1 | 57.7 | 81.3 | 111.9 | 143.0 | 161.8 | 187.3
Horas de corte longitudinal |  |  | 2.052755719 | 3.636069095 | 6.34812567 | 11.95272637 | 20.28921797 | 28.54167189 | 38.57934174 | 48.9229751 | 55.84409209 | 64.65225436
Acero de madre LAF (t) |  |  | 8.8 | 15.3 | 27.2 | 51.8 | 88.5 | 124.4 | 168.5 | 213.7 | 243.1 | 280.6
Acero de madre LAC (t) |  |  | 2.8 | 4.7 | 7.3 | 12.3 | 20.2 | 28.1 | 37.6 | 47.5 | 54.4 | 62.9

Sheet: Bobinas
Peso de bobina por SKU: recomendado según la demanda y elegido (editable)
Recomendado = consumo mensual del año de referencia × cobertura objetivo, redondeado a 0,5 t, entre el peso mínimo y el máximo que permiten el diámetro exterior y el desbobinador.
Opción A — bobinas de cuerpo (ancho estándar) y flejes de disco (cortados por el proveedor)
SKU | Tipo | Espesor (mm) | Ancho (mm) | kg por metro | Consumo año de referencia (t) | Consumo mensual (t) | Máx. por diámetro exterior (t) | Capacidad del desbobinador (t) | PESO RECOMENDADO (t) | PESO ELEGIDO (t) | Largo de la bobina (m) | Piezas por bobina | Días que dura | Bobinas por año
Cuerpo 2,5 kg | Bobina cuerpo | 1.25 | 1220 | 12.00 | 15.3 | 1.27 | 15.02 | 10.0 | 1.5 | 1.5 | 124.9817735 | 1391.262785 | 23.57269427 | 10.2
Cuerpo 5 kg | Bobina cuerpo | 1.60 | 1000 | 12.59 | 127.4 | 10.62 | 12.31 | 10.0 | 10.0 | 10.0 | 794.1550191 | 5021.001174 | 18.8328948 | 12.7
Cuerpo 10 kg | Bobina cuerpo | 2.00 | 1000 | 15.74 | 17.2 | 1.43 | 12.31 | 10.0 | 1.5 | 1.5 | 95.29860229 | 338.5385516 | 20.98728093 | 11.4
Cuerpo 25 kg | Bobina cuerpo | 3.20 | 1500 | 37.78 | 8.4 | 0.70 | 18.47 | 10.0 | 1.0 | 1.0 | 26.47183397 | 92.55886003 | 28.52007197 | 8.4
Cuerpo 50 kg | Bobina cuerpo | 3.20 | 1500 | 37.78 | 32.2 | 2.68 | 18.47 | 10.0 | 3.0 | 3.0 | 79.41550191 | 159.7897423 | 22.37993575 | 10.7
Cuerpo 70 kg | Bobina cuerpo | 4.75 | 1245 | 46.54 | 11.9 | 0.99 | 15.33 | 10.0 | 1.0 | 1.0 | 21.48633321 | 31.59754885 | 20.22920822 | 11.9
Cuerpo 100 kg | Bobina cuerpo | 4.75 | 1245 | 46.54 | 10.4 | 0.87 | 15.33 | 10.0 | 1.0 | 1.0 | 21.48633321 | 23.87370357 | 23.08113528 | 10.4
Fleje Cúpula 1 kg | Fleje disco | 0.90 | 114 | 0.81 | 18.3 | 1.52 | 1.40 | 3.0 | 1.0 | 1.0 | 1238.448373 | 11157.19255 | 13.14936547 | 18.3
Fleje Fondo 1 kg | Fleje disco | 0.90 | 106 | 0.75 | 15.7 | 1.31 | 1.31 | 3.0 | 1.0 | 1.0 | 1331.916175 | 12931.225 | 15.24016034 | 15.7
Fleje Cúpula 2,5 kg | Fleje disco | 1.25 | 200 | 1.97 | 5.1 | 0.42 | 2.46 | 3.0 | 0.5 | 0.5 | 254.1296061 | 1396.316517 | 23.65832157 | 10.1
Fleje Fondo 2,5 kg | Fleje disco | 1.25 | 200 | 1.97 | 4.2 | 0.35 | 2.46 | 3.0 | 0.5 | 0.5 | 254.1296061 | 1682.977524 | 28.51532799 | 8.4
Fleje Cúpula 5 kg | Fleje disco | 1.60 | 250 | 3.15 | 45.1 | 3.76 | 3.08 | 3.0 | 3.0 | 0.6 | 190.5972046 | 850.8803776 | 3.191503065 | 75.2
Fleje Fondo 5 kg | Fleje disco | 1.60 | 200 | 2.52 | 29.0 | 2.42 | 2.46 | 3.0 | 2.0 | 0.5 | 198.5387548 | 1102.993082 | 4.137133603 | 58.0
Fleje Cúpula 10 kg | Fleje disco | 2.00 | 300 | 4.72 | 4.8 | 0.40 | 3.69 | 3.0 | 0.5 | 0.8 | 158.8310038 | 608.5479073 | 37.72617868 | 6.4
Fleje Fondo 10 kg | Fleje disco | 2.00 | 249 | 3.92 | 3.2 | 0.26 | 3.07 | 3.0 | 0.5 | 0.5 | 127.5751035 | 613.3418436 | 38.02337286 | 6.3
Opción C — bobinas madre (una por espesor)
SKU | Tipo | Espesor (mm) | Ancho (mm) | kg por metro | Consumo año de referencia (t) | Consumo mensual (t) | Máx. por diámetro exterior (t) | Capacidad del desbobinador (t) | PESO RECOMENDADO (t) | PESO ELEGIDO (t) | Largo de la bobina (m) | Piezas por bobina | Días hábiles que dura | Bobinas por año
Madre 0,9 mm | Bobina madre | 0.90 | 1220 | 8.64 | 34.6 | 2.89 | 15.02 | 14.0 | 3.0 | 3.0 | 347.171593 | según patrón | 20.78616462 | 11.5
Madre 1,25 mm | Bobina madre | 1.25 | 1000 | 9.84 | 23.3 | 1.94 | 12.31 | 14.0 | 2.0 | 2.0 | 203.3036849 | según patrón | 20.60545176 | 11.6
Madre 1,6 mm | Bobina madre | 1.60 | 1000 | 12.59 | 198.1 | 16.51 | 12.31 | 14.0 | 12.0 | 12.0 | 952.9860229 | según patrón | 14.54020428 | 16.5
Madre 2,0 mm | Bobina madre | 2.00 | 1000 | 15.74 | 24.6 | 2.05 | 12.31 | 14.0 | 2.5 | 2.5 | 158.8310038 | según patrón | 24.42219924 | 9.8
Madre 3,2 mm | Bobina madre | 3.20 | 1500 | 37.78 | 40.6 | 3.38 | 18.47 | 14.0 | 3.5 | 3.5 | 92.65141889 | según patrón | 20.68275619 | 11.6
Madre 4,75 mm | Bobina madre | 4.75 | 1245 | 46.54 | 22.3 | 1.86 | 15.33 | 14.0 | 2.0 | 2.0 | 42.97266643 | según patrón | 21.56127399 | 11.1
• Cómo leerlo: si una bobina dura muy poco (pocos días) conviene subir el peso; si dura muchos meses, bajarlo para no inmovilizar stock.
• El peso elegido es el máximo que se compra: en los primeros años, con poca demanda, el stock se calcula con bobinas más chicas (cobertura máxima en Supuestos).
• Las bobinas angostas (flejes de disco) quedan limitadas por el diámetro exterior: a igual diámetro, un fleje de 200 mm pesa ~5 veces menos que una bobina de 1.000 mm.

Sheet: Calculo
Cálculo anual por opción
No editar: todo sale de Supuestos, Demanda, Nesting, BobinaMadre y Bobinas.
Concepto | Espesor (mm) | Acero | 2026 | 2027 | 2028 | 2029 | 2030 | 2031 | 2032 | 2033 | 2034 | 2035
Período k (para descontar) |  |  | 1 | 2 | 3 | 4 | 5 | 6 | 7 | 8 | 9 | 10
Unidades a fabricar
1 kg |  |  | 4179 | 5997 | 14514 | 35162 | 62116 | 87300 | 121674 | 156133 | 175393 | 202621
2,5 kg |  |  | 295 | 709 | 1287 | 2545 | 4245 | 6055 | 8066 | 10228 | 11936 | 14094
5 kg |  |  | 2256 | 3847 | 6573 | 11975 | 20360 | 28440 | 38437 | 48651 | 55304 | 63666
10 kg |  |  | 92 | 177 | 343 | 673 | 1186 | 1718 | 2322 | 2940 | 3343 | 3852
25 kg |  |  | 34 | 58 | 90 | 150 | 249 | 347 | 464 | 585 | 670 | 775
50 kg |  |  | 75 | 128 | 198 | 332 | 548 | 764 | 1020 | 1287 | 1476 | 1705
70 kg |  |  | 16 | 29 | 43 | 72 | 119 | 166 | 223 | 282 | 322 | 373
100 kg |  |  | 11 | 18 | 29 | 49 | 80 | 110 | 147 | 186 | 214 | 247
Total |  |  | 6958 | 10963 | 23077 | 50958 | 88903 | 124900 | 172353 | 220292 | 248658 | 287333
Acero neto en CUERPOS (t) — precio: chapa cortada a medida (referencia) |  |  |  |  |  |  |  |  |  |  |  |  | USD/kg
2,5 kg | 1.25 | LAF | 0.3 | 0.7 | 1.3 | 2.6 | 4.3 | 6.2 | 8.2 | 10.5 | 12.2 | 14.4 | 1.4260
5 kg | 1.60 | LAF | 4.4 | 7.6 | 13.0 | 23.6 | 40.1 | 56.1 | 75.8 | 95.9 | 109.0 | 125.5 | 1.4530
10 kg | 2.00 | LAF | 0.4 | 0.8 | 1.5 | 3.0 | 5.2 | 7.5 | 10.2 | 12.9 | 14.7 | 16.9 | 1.4290
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
DESCUENTO
Factor de descuento 1/(1+i)^k |  |  | 0.8929 | 0.7972 | 0.7118 | 0.6355 | 0.5674 | 0.5066 | 0.4523 | 0.4039 | 0.3606 | 0.3220

Sheet: Proceso
Cómo sería el proceso en cada opción
Los números se calculan solos. Salvo aclaración, corresponden al año de referencia de Supuestos.
 | Año de referencia: 2035
 | OPCIÓN A — BOBINA DE ANCHO ESTÁNDAR POR FORMATO (cuerpos) + FLEJE A MEDIDA (cúpulas y fondos)
 | Idea: para cada cuerpo se compra una bobina del ancho comercial que mejor se aprovecha (ver Nesting) y se corta al largo en la línea de corte transversal. Para cúpulas y fondos se compran flejes ya cortados por el proveedor al ancho del disco (D + 2s) y alimentan el balancín en continuo.
 | Flujo del proceso — cuerpos
1 | Recepción: el puente grúa con pinza en C baja cada bobina y la apoya en cunas por espesor. Control de recepción (Nivel 1 SGC): certificado, espesor ±0,1 mm.
2 | Carga en el desbobinador de la línea con el puente grúa.
3 | Aplanado: la aplanadora saca la curvatura de bobina; el despunte inicial va a scrap.
4 | Corte transversal: el alimentador servo avanza el largo programado y la cizalla corta una tira con 1 a 3 desarrollos de ancho.
5 | Separación en guillotina de los desarrollos de la tira y refilado de orillas.
6 | Apilado en carros → grabado de lote → cilindradora. Scrap a contenedor con salida al exterior.
 | Flujo del proceso — cúpulas y fondos
1 | Recepción de flejes (bobinas angostas) con el puente grúa; se guardan en la estantería porta-flejes por diámetro de disco.
2 | Carga del fleje en el desbobinador del balancín; el alimentador servo avanza un paso (D + s) por golpe.
3 | El balancín corta el disco; el esqueleto del fleje se trocea y va a scrap (~25%, inherente al disco).
4 | Los discos pasan al embutido (cúpula/fondo) según el proceso ya definido en el Doc.
 | Máquinas y equipos
 | Equipo |  |  |  | Cantidad | Precio unit. (USD) | Subtotal (USD)
 | Línea de corte transversal 1–6 mm × 1.600 (desbobinador, aplanadora, alimentador servo, cizalla) |  |  |  | 1 | 80000 | 80000
 | Guillotina hidráulica 6 × 3.200 mm con tope motorizado |  |  |  | 1 | 25810.97465 | 25810.97465
 | Cortadora longitudinal (slitter) 0,3–3,2 × 1.600 |  |  |  | 0 | 60000 | 0
 | Puente grúa monoviga 10 t (incluye carrilera) |  |  |  | 1 | 30000 | 30000
 | Pinza en C portabobinas + cunas |  |  |  | 1 | 6000 | 6000
 | Desbobinador + enderezador + alimentador servo para la prensa de discos |  |  |  | 1 | 12000 | 12000
 | Estantería porta-flejes |  |  |  | 1 | 3000 | 3000
 | Autoelevador eléctrico 2,5 t |  |  |  | 0 | 20000 | 0
 | Mesa elevadora de tijera 1500 × 3000 mm, 3 t, elevación ~1 m (paquete de hojas a la altura de la guillotina) |  |  |  | 0 | 7000 | 0
 | Apoyos con bolas (mesa de bolas) entre la mesa elevadora y la guillotina |  |  |  | 0 | 1500 | 0
 | Racks por espesor en el almacén de MP y carros porta-desarrollos |  |  |  | 0 | 2000 | 0
 | Mesa de alimentación de tiras al balancín |  |  |  | 0 | 1500 | 0
 | TOTAL OPCIÓN A |  |  |  |  |  | 156810.9746
 | Materia prima, peso de bobina y consumo
 | SKU | Ancho (mm) | Espesor (mm) | Peso elegido (t) | Consumo (t/año) | Bobinas por año | Días que dura cada bobina | Piezas por bobina
 | Cuerpo 2,5 kg | 1220 | 1.25 | 1.5 | 15.3 | 10.2 | 23.57269427 | 1391.262785
 | Cuerpo 5 kg | 1000 | 1.60 | 10.0 | 127.4 | 12.7 | 18.8328948 | 5021.001174
 | Cuerpo 10 kg | 1000 | 2.00 | 1.5 | 17.2 | 11.4 | 20.98728093 | 338.5385516
 | Cuerpo 25 kg | 1500 | 3.20 | 1.0 | 8.4 | 8.4 | 28.52007197 | 92.55886003
 | Cuerpo 50 kg | 1500 | 3.20 | 3.0 | 32.2 | 10.7 | 22.37993575 | 159.7897423
 | Cuerpo 70 kg | 1245 | 4.75 | 1.0 | 11.9 | 11.9 | 20.22920822 | 31.59754885
 | Cuerpo 100 kg | 1245 | 4.75 | 1.0 | 10.4 | 10.4 | 23.08113528 | 23.87370357
 | Fleje Cúpula 1 kg | 114 | 0.90 | 1.0 | 18.3 | 18.3 | 13.14936547 | 11157.19255
 | Fleje Fondo 1 kg | 106 | 0.90 | 1.0 | 15.7 | 15.7 | 15.24016034 | 12931.225
 | Fleje Cúpula 2,5 kg | 200 | 1.25 | 0.5 | 5.1 | 10.1 | 23.65832157 | 1396.316517
 | Fleje Fondo 2,5 kg | 200 | 1.25 | 0.5 | 4.2 | 8.4 | 28.51532799 | 1682.977524
 | Fleje Cúpula 5 kg | 250 | 1.60 | 0.6 | 45.1 | 75.2 | 3.191503065 | 850.8803776
 | Fleje Fondo 5 kg | 200 | 1.60 | 0.5 | 29.0 | 58.0 | 4.137133603 | 1102.993082
 | Fleje Cúpula 10 kg | 300 | 2.00 | 0.8 | 4.8 | 6.4 | 37.72617868 | 608.5479073
 | Fleje Fondo 10 kg | 249 | 2.00 | 0.5 | 3.2 | 6.3 | 38.02337286 | 613.3418436
 | Manejo, personal y stock
 | Acero comprado (t/año) |  |  |  | 348.0
 | Scrap (t/año) |  |  |  | 48.2
 | Stock promedio (t) |  |  |  | 25.6
 | Horas-hombre de corte por año |  |  |  | 544.8808431
 | Operarios equivalentes |  |  |  | 0.30
 | Costo anual (USD) |  |  |  | 421272.6453
 | Ventajas: excelente aprovechamiento en cuerpos, cortes exactos, cambio de formato sin herramental, discos en continuo. Desventajas: la inversión más alta de las opciones sin slitter (línea de corte + puente grúa), 15 SKUs distintos en stock, bobinas pesadas y una línea de 12–15 m.
 | OPCIÓN B — HOJAS ESTÁNDAR (cuerpos, cúpulas y fondos)
 | Idea: todo se compra en hojas de medida comercial. Los cuerpos se cortan en guillotina (franjas y piezas). Para los discos, la hoja se corta en tiras de ancho D + 2s y cada tira se carga a mano en el balancín.
 | Flujo del proceso
1 | Recepción de paquetes (2–3 t) con autoelevador; racks por espesor y formato.
2 | Cuerpos: el paquete se apoya en la mesa elevadora de tijera; la hoja de arriba se desliza por la mesa de bolas hasta la guillotina, que corta franjas y luego desarrollos; sobrante a scrap; carros a cilindrado.
3 | Discos: la guillotina corta la hoja en tiras; las tiras se apilan en la mesa de alimentación del balancín.
4 | El operario carga cada tira en el balancín y la avanza contra tope; el balancín corta los discos; el esqueleto y la punta de tira van a scrap.
5 | Cambio de formato: reprogramar el tope trasero de la guillotina y cambiar de paquete.
 | Máquinas y equipos
 | Equipo |  |  |  | Cantidad | Precio unit. (USD) | Subtotal (USD)
 | Línea de corte transversal 1–6 mm × 1.600 (desbobinador, aplanadora, alimentador servo, cizalla) |  |  |  | 0 | 80000 | 0
 | Guillotina hidráulica 6 × 3.200 mm con tope motorizado |  |  |  | 1 | 25810.97465 | 25810.97465
 | Cortadora longitudinal (slitter) 0,3–3,2 × 1.600 |  |  |  | 0 | 60000 | 0
 | Puente grúa monoviga 10 t (incluye carrilera) |  |  |  | 0 | 30000 | 0
 | Pinza en C portabobinas + cunas |  |  |  | 0 | 6000 | 0
 | Desbobinador + enderezador + alimentador servo para la prensa de discos |  |  |  | 0 | 12000 | 0
 | Estantería porta-flejes |  |  |  | 0 | 3000 | 0
 | Autoelevador eléctrico 2,5 t |  |  |  | 1 | 20000 | 20000
 | Mesa elevadora de tijera 1500 × 3000 mm, 3 t, elevación ~1 m (paquete de hojas a la altura de la guillotina) |  |  |  | 1 | 7000 | 7000
 | Apoyos con bolas (mesa de bolas) entre la mesa elevadora y la guillotina |  |  |  | 1 | 1500 | 1500
 | Racks por espesor en el almacén de MP y carros porta-desarrollos |  |  |  | 1 | 2000 | 2000
 | Mesa de alimentación de tiras al balancín |  |  |  | 1 | 1500 | 1500
 | TOTAL OPCIÓN B |  |  |  |  |  | 57810.97465
 | Materia prima y consumo
 | Pieza | Hoja (mm) | Espesor (mm) | Piezas por hoja | Aprovech. | Hojas por año | Acero (t/año) | Tiras por año
 | Cuerpo 2,5 kg | 1220 × 2440 | 1.25 | 27 | 94.2% | 522 | 15.3 | —
 | Cuerpo 5 kg | 1000 × 2000 | 1.60 | 12 | 94.0% | 5305.5 | 133.6 | —
 | Cuerpo 10 kg | 1500 × 3000 | 2.00 | 15 | 92.9% | 256.8 | 18.2 | —
 | Cuerpo 25 kg | 1500 × 3000 | 3.20 | 9 | 84.1% | 86.11111111 | 9.8 | —
 | Cuerpo 50 kg | 1500 × 3000 | 3.20 | 6 | 84.8% | 284.1666667 | 32.2 | —
 | Cuerpo 70 kg | 1500 × 3000 | 4.75 | 4 | 73.3% | 0 | 0.0 | —
 | Cuerpo 100 kg | 1500 × 3000 | 4.75 | 3 | 72.7% | 40.88888889 | 6.9 | —
 | Hojas mixtas 70/100 | 1500 × 3000 | 4.75 | 4 | 79.2% | 124.3333333 | 20.9 | —
 | Cúpula 1 kg | 1220 × 2440 | 0.90 | 210 | 64.6% | 964.8619048 | 20.3 | 9648.619048
 | Fondo 1 kg | 1000 × 2000 | 0.90 | 171 | 67.2% | 1184.918129 | 16.8 | 10664.26316
 | Cúpula 2,5 kg | 1220 × 2440 | 1.25 | 78 | 65.9% | 180.6923077 | 5.3 | 1084.153846
 | Fondo 2,5 kg | 1220 × 2440 | 1.25 | 120 | 69.3% | 117.45 | 3.4 | 1761.75
 | Cúpula 5 kg | 1220 × 2440 | 1.60 | 50 | 64.4% | 1273.32 | 47.7 | 6366.6
 | Fondo 5 kg | 1000 × 2000 | 1.60 | 55 | 67.7% | 1157.563636 | 29.2 | 5787.818182
 | Cúpula 10 kg | 1500 × 3000 | 2.00 | 55 | 63.9% | 70.03636364 | 5.0 | 350.1818182
 | Fondo 10 kg | 1500 × 3000 | 2.00 | 98 | 71.9% | 39.30612245 | 2.8 | 275.1428571
 | Manejo, personal y stock
 | Acero comprado (t/año) |  |  |  | 367.3
 | Scrap (t/año) |  |  |  | 67.5
 | Stock promedio (t) |  |  |  | 29.4
 | Horas-hombre de corte por año |  |  |  | 926.9400804
 | Operarios equivalentes |  |  |  | 0.51
 | Costo anual (USD) |  |  |  | 465758.7321
 | Ventajas: inversión mínima, máquinas simples, compras chicas. Desventajas: todo el acero a precio de hoja, dos bordes perdidos por hoja, discos desde tiras con peor aprovechamiento que el fleje, carga manual de miles de tiras al balancín (más horas y riesgo ergonómico), hojas de hasta 170 kg que exigen mesa elevadora y mesa de bolas.
 | OPCIÓN C — BOBINA MADRE DE ANCHO ESTÁNDAR + CORTE LONGITUDINAL PROPIO
 | Idea: se compra una sola bobina ancha por espesor (ancho comercial, p. ej. 1.000 / 1.250 / 1.500 mm) al precio de bobina. En planta, la cortadora longitudinal la divide en flejes según un patrón de cuchillas que combina, en la misma pasada, flejes de cuerpo y flejes de cúpula y fondo. Así las orillas se minimizan y no se paga el servicio de corte al proveedor.
 | Flujo del proceso
1 | Recepción de la bobina madre con puente grúa y pinza en C; cunas por espesor. Control de recepción (Nivel 1 SGC).
2 | Planificación del corte: según stock de flejes y demanda se elige el patrón de cuchillas (hoja BobinaMadre: tiras por patrón y % de uso de cada patrón).
3 | Armado de la cortadora: se colocan cuchillas circulares y separadores en el eje según el patrón (tiempo de armado en Supuestos).
4 | Corte longitudinal: la madre se desenrolla, pasa por el cabezal de cuchillas y se separa en flejes; las orillas se enrollan en el enrollador de orillas (scrap).
5 | Rebobinado: cada fleje se rebobina por separado, se fleja, se etiqueta (espesor, ancho, colada) y se guarda en la estantería porta-flejes.
6 | Flejes de cuerpo (ancho = alto o perímetro del cuerpo): van a la línea de corte transversal, que corta 1 desarrollo por golpe sin necesidad de guillotina.
7 | Flejes de disco (ancho = D + 2s): van al desbobinador del balancín, igual que en la opción A.
8 | Excedentes: si un patrón produce más metros de un fleje que los necesarios, quedan en stock para la próxima campaña (el modelo los cuenta como scrap para ser conservador).
 | Máquinas y equipos
 | Equipo |  |  |  | Cantidad | Precio unit. (USD) | Subtotal (USD)
 | Línea de corte transversal 1–6 mm × 1.600 (desbobinador, aplanadora, alimentador servo, cizalla) |  |  |  | 1 | 80000 | 80000
 | Guillotina hidráulica 6 × 3.200 mm con tope motorizado |  |  |  | 0 | 25810.97465 | 0
 | Cortadora longitudinal (slitter) 0,3–3,2 × 1.600 |  |  |  | 1 | 60000 | 60000
 | Puente grúa monoviga 10 t (incluye carrilera) |  |  |  | 1 | 30000 | 30000
 | Pinza en C portabobinas + cunas |  |  |  | 1 | 6000 | 6000
 | Desbobinador + enderezador + alimentador servo para la prensa de discos |  |  |  | 1 | 12000 | 12000
 | Estantería porta-flejes |  |  |  | 1 | 3000 | 3000
 | Autoelevador eléctrico 2,5 t |  |  |  | 0 | 20000 | 0
 | Mesa elevadora de tijera 1500 × 3000 mm, 3 t, elevación ~1 m (paquete de hojas a la altura de la guillotina) |  |  |  | 0 | 7000 | 0
 | Apoyos con bolas (mesa de bolas) entre la mesa elevadora y la guillotina |  |  |  | 0 | 1500 | 0
 | Racks por espesor en el almacén de MP y carros porta-desarrollos |  |  |  | 0 | 2000 | 0
 | Mesa de alimentación de tiras al balancín |  |  |  | 0 | 1500 | 0
 | TOTAL OPCIÓN C |  |  |  |  |  | 191000
 | Materia prima, patrones y consumo por espesor
 | Grupo | Ancho madre (mm) | Peso de madre elegido (t) | Acero de madre (t/año) | Bobinas madre por año | Flejes de disco por año | Horas de cortadora por año | Aprovech. del grupo
 | 0,9 mm | 1220 | 3.0 | 34.6 | 11.5 | 125.5 | 10.32146033 | 70.5%
 | 1,25 mm | 1000 | 2.0 | 23.3 | 11.6 | 23.2 | 9.717268954 | 87.1%
 | 1,6 mm | 1000 | 12.0 | 198.1 | 16.5 | 27.1 | 18.90084238 | 88.9%
 | 2,0 mm | 1000 | 2.5 | 24.6 | 9.8 | 11.4 | 8.017446871 | 89.8%
 | 3,2 mm | 1500 | 3.5 | 40.6 | 11.6 | 0.0 | 9.148626732 | 87.5%
 | 4,75 mm | 1245 | 2.0 | 22.3 | 11.1 | 0.0 | 8.546609091 | 96.9%
 | Ejemplo de patrón (1,6 mm, madre de 1.000 mm): Patrón 3 = 3 flejes de cuerpo de 330 mm (990 mm); Patrón 2 = 1 cuerpo + 2 cúpulas + 1 fondo (967 mm); Patrón 1 = 1 cúpula + 4 fondos (959 mm). Alternando los tres en la proporción indicada se producen cuerpos, cúpulas y fondos del 5 kg en la misma relación que pide la demanda.
 | Manejo, personal y stock
 | Acero comprado (t/año) |  |  |  | 343.4
 | Scrap (t/año) |  |  |  | 43.6
 | Stock promedio: madres + flejes (t) |  |  |  | 38.2
 | Horas de cortadora (máquina) por año |  |  |  | 64.65225436
 | Horas-hombre de corte por año |  |  |  | 246.7217588
 | Operarios equivalentes |  |  |  | 0.14
 | Costo anual (USD) |  |  |  | 423638.6716
 | Ventajas: todo el acero a precio de bobina, 6 SKUs de materia prima en lugar de 15, orillas mínimas combinando cuerpos y discos, independencia del proveedor para anchos especiales. Desventajas: inversión y espacio de la cortadora (línea de ~15–20 m), bobinas madre pesadas, planificación de patrones, stock de flejes intermedios, 2 operarios en la cortadora. En rodantes (3,2 y 4,75 mm) la madre de ancho comercial casi no necesita corte longitudinal.
 | OPCIÓN D — HOJAS ESTÁNDAR (cuerpos) + FLEJE A MEDIDA (cúpulas y fondos) — OPCIÓN ELEGIDA
 | Idea: los cuerpos (manuales y rodantes) se cortan de hojas de medida comercial en una sola guillotina 6 × 3.200 mm. Las cúpulas y fondos se cortan directamente desde rollos de fleje comprados al ancho de cada disco, que alimentan la prensa en continuo. Es la opción con menor valor actual de las que cortan en planta (ver hoja Decision).
 | Por qué el fleje se compra 'a medida' y no a la acería: las acerías laminan bobinas de 600 mm o más de ancho (Ternium LAF 600–1.500 mm); los anchos de disco (106–300 mm) solo se consiguen cortando una bobina ancha en un centro de servicio. Pacheco Chapas cotizó los rollos al ancho de cada disco y Pradecon corta a medida sin cargo. Si el corte se hiciera en planta, sería la opción C.
 | Flujo del proceso
1 | Cuerpos — recepción: el autoelevador descarga los paquetes de hojas y los ubica en los racks por espesor del almacén de MP.
2 | Cuerpos — preparación: el autoelevador lleva el paquete del formato a cortar a la mesa elevadora de tijera, al lado de la guillotina. Se corta por tandas de un mismo formato; al terminar, el paquete vuelve al almacén.
3 | Cuerpos — carga: la mesa sube hasta que la hoja de arriba queda a la altura de la guillotina y el operario la desliza sobre la mesa de bolas, sin levantarla (las hojas pesan de 25 a 170 kg).
4 | Cuerpos — primer corte: la guillotina corta la hoja en franjas con el tope trasero (si la franja supera el recorrido del tope, se corta el sobrante del otro lado).
5 | Cuerpos — segundo corte: cada franja se corta en desarrollos; los desarrollos van en carros al grabado de lote y a la cilindradora.
6 | Cuerpos — sobrante: las orillas que no alcanzan para otra pieza (10 a 290 mm) van a scrap. No sirven para discos: el disco más chico necesita un fleje continuo de 106 mm, y la orilla sale cortada en tramos.
7 | Discos — recepción: los rollos de fleje (0,5 a 0,75 t en Pacheco) se guardan en la estantería porta-flejes, un SKU por disco.
8 | Discos — alimentación: el rollo se monta en el desbobinador, el enderezador lo aplana y el alimentador servo avanza un paso (D + s) por golpe de la prensa.
9 | Discos — corte y embutido: la prensa corta el disco y lo embute; el esqueleto del fleje se trocea y va a scrap.
10 | Cambio de formato: en cuerpos se reprograma el tope de la guillotina; en discos se cambia el rollo y el troquel.
 | Guillotina: especificación y secuencia de cortes por formato
 | Guillotina hidráulica 6 × 3.200 mm con tope trasero motorizado (idealmente 1.000 mm), ángulo de corte y luz de cuchillas regulables, sostén de chapa trasero y seguridades (barreras, protección de garganta, pedal). Referencia cotizada: Molinari HG 6×3200; alternativas en consulta: Machcenter Modena QC11K y Odyssey QC12K.
 | Formato | Hoja (mm) | Espesor (mm) | 1er corte: franja (mm) | Franjas por hoja | 2º corte: pieza (mm) | Piezas por franja | Piezas por hoja | Orilla que sobra (mm) | Aprovech.
 | 2,5 kg | 1220 × 2440 | 1.25 | 385.5 | 3 | 269.5 | 9 | 27 | 63.5 | 94.2%
 | 5 kg | 1000 × 2000 | 1.60 | 330.0 | 3 | 474.5 | 4 | 12 | 10.0 | 94.0%
 | 10 kg | 1500 × 3000 | 2.00 | 495.0 | 3 | 563.0 | 5 | 15 | 15.0 | 92.9%
 | 25 kg | 1500 × 3000 | 3.20 | 490.0 | 3 | 858.0 | 3 | 9 | 30.0 | 84.1%
 | 50 kg | 1500 × 3000 | 3.20 | 640.0 | 2 | 994.0 | 3 | 6 | 220.0 | 84.8%
 | 70 kg | 1500 × 3000 | 4.75 | 680.0 | 2 | 1212.0 | 2 | 4 | 140.0 | 73.3%
 | 100 kg | 1500 × 3000 | 4.75 | 1212.0 | 1 | 900.0 | 3 | 3 | 288.0 | 72.7%
 | Mixta 70+100 | 1500 × 3000 | 4.75 | 1212.0 | 1 | 900×1 + 680×3 | 4 | 4 | 288.0 | 79.2%
 | Máquinas y equipos
 | Equipo |  |  |  | Cantidad | Precio unit. (USD) | Subtotal (USD)
 | Línea de corte transversal 1–6 mm × 1.600 (desbobinador, aplanadora, alimentador servo, cizalla) |  |  |  | 0 | 80000 | 0
 | Guillotina hidráulica 6 × 3.200 mm con tope motorizado |  |  |  | 1 | 25810.97465 | 25810.97465
 | Cortadora longitudinal (slitter) 0,3–3,2 × 1.600 |  |  |  | 0 | 60000 | 0
 | Puente grúa monoviga 10 t (incluye carrilera) |  |  |  | 0 | 30000 | 0
 | Pinza en C portabobinas + cunas |  |  |  | 0 | 6000 | 0
 | Desbobinador + enderezador + alimentador servo para la prensa de discos |  |  |  | 1 | 12000 | 12000
 | Estantería porta-flejes |  |  |  | 1 | 3000 | 3000
 | Autoelevador eléctrico 2,5 t |  |  |  | 1 | 20000 | 20000
 | Mesa elevadora de tijera 1500 × 3000 mm, 3 t, elevación ~1 m (paquete de hojas a la altura de la guillotina) |  |  |  | 1 | 7000 | 7000
 | Apoyos con bolas (mesa de bolas) entre la mesa elevadora y la guillotina |  |  |  | 1 | 1500 | 1500
 | Racks por espesor en el almacén de MP y carros porta-desarrollos |  |  |  | 1 | 2000 | 2000
 | Mesa de alimentación de tiras al balancín |  |  |  | 0 | 1500 | 0
 | TOTAL OPCIÓN D |  |  |  |  |  | 71310.97465
 | Materia prima (año de referencia)
 | Pieza | Compra | Espesor (mm) | Proveedor de referencia | USD/kg | Acero (t/año) | Unidades de compra por año
 | Cuerpo 2,5 kg | Hoja 1220 × 2440 | 1.25 | Pradecon (hojas) | 1.2903 | 15.3 | 522 hojas
 | Cuerpo 5 kg | Hoja 1000 × 2000 | 1.60 | Pradecon (hojas) | 1.3275 | 133.6 | 5.306 hojas
 | Cuerpo 10 kg | Hoja 1500 × 3000 | 2.00 | Pradecon (hojas) | 1.2804 | 18.2 | 257 hojas
 | Cuerpo 25 kg | Hoja 1500 × 3000 | 3.20 | Pradecon (hojas) | 1.1019 | 9.8 | 86 hojas
 | Cuerpo 50 kg | Hoja 1500 × 3000 | 3.20 | Pradecon (hojas) | 1.1019 | 32.2 | 284 hojas
 | Cuerpo 70 kg | Hoja 1500 × 3000 | 4.75 | Pradecon (hojas) | 1.0910 | 0.0 | 0 hojas
 | Cuerpo 100 kg | Hoja 1500 × 3000 | 4.75 | Pradecon (hojas) | 1.0910 | 6.9 | 41 hojas
 | Hoja mixta 70/100 | Hoja 1500 × 3000 | 4.75 | Pradecon (hojas) | 1.0910 | 20.9 | 124 hojas
 | Cúpula 1 kg | Rollo de fleje 114 mm | 0.90 | Pradecon (a medida) | 1.2629 | 18.3 | 18,3 rollos de 1,00 t
 | Fondo 1 kg | Rollo de fleje 106 mm | 0.90 | Pradecon (a medida) | 1.2629 | 15.7 | 15,7 rollos de 1,00 t
 | Cúpula 2,5 kg | Rollo de fleje 200 mm | 1.25 | Pacheco Chapas | 1.1860 | 5.1 | 10,1 rollos de 0,50 t
 | Fondo 2,5 kg | Rollo de fleje 200 mm | 1.25 | Pacheco Chapas | 1.1860 | 4.2 | 8,4 rollos de 0,50 t
 | Cúpula 5 kg | Rollo de fleje 250 mm | 1.60 | Pacheco Chapas | 1.1860 | 45.1 | 75,2 rollos de 0,60 t
 | Fondo 5 kg | Rollo de fleje 200 mm | 1.60 | Pacheco Chapas | 1.1860 | 29.0 | 58,0 rollos de 0,50 t
 | Cúpula 10 kg | Rollo de fleje 300 mm | 2.00 | Pacheco Chapas | 1.1980 | 4.8 | 6,4 rollos de 0,75 t
 | Fondo 10 kg | Rollo de fleje 249 mm | 2.00 | Pacheco Chapas | 1.1980 | 3.2 | 6,3 rollos de 0,50 t
 | Manejo, personal y stock
 | Acero comprado (t/año) |  |  |  | 362.2
 | Scrap (t/año) |  |  |  | 62.3
 | Stock promedio: hojas + flejes (t) |  |  |  | 26.5
 | Horas-hombre de corte por año |  |  |  | 627.1489759
 | Operarios equivalentes |  |  |  | 0.35
 | Costo anual (USD) |  |  |  | 442735.2859
 | Ventajas: la menor inversión de las opciones que alimentan discos desde fleje, sin puente grúa ni línea de 12–15 m, una sola guillotina para todos los formatos (incluidos rodantes de 4,75 mm), compras mensuales con poco stock, discos en continuo sin carga manual. Desventajas: aprovecha menos chapa que la bobina en los cuerpos, más manipulación de hojas (mesa elevadora y mesa de bolas), 8 SKUs de fleje más las hojas.
 | REFERENCIA — SITUACIÓN ACTUAL
 | Cuerpos comprados cortados a medida y discos desde fleje a medida. No requiere máquinas de corte de cuerpos. Solo para comparar: no cumple la consigna de cortar en planta.

Sheet: Comparacion
Comparación de opciones (cuerpos + cúpulas + fondos)
Horizonte 2026–2035, con los precios de acero cotizados. VA = valor actual de costos + inversiones (menor es mejor).
Indicador | A: bobina por formato + fleje | B: hojas (todo) | C: bobina madre | D: hojas + fleje | Referencia a medida | Unidad / nota
Inversión inicial | 156810.9746 | 57810.97465 | 191000 | 71310.97465 | 15000 | USD
Acero comprado 2026–2035 | 1519.6 | 1604.1 | 1499.6 | 1581.7 | 1481.0 | t
Scrap generado 2026–2035 | 209.6 | 294.1 | 189.6 | 271.7 | 171.0 | t
Aprovechamiento global de chapa | 86.2% | 81.7% | 87.4% | 82.8% | 88.5% | acero en piezas / acero comprado
Costo del acero acumulado 10 años (nominal) | 1839705.575 | 2054099.592 | 1840424.857 | 1957422.77 | 1963235.24 | USD
Costo anual en el año de referencia | 421272.6453 | 465758.7321 | 423638.6716 | 442735.2859 | 444537.0274 | USD/año
Costo operativo acumulado 10 años (nominal) | 1870310.638 | 2042947.541 | 1892177.92 | 1946376.616 | 1944677.935 | USD, sin inversión
VALOR ACTUAL 10 AÑOS (costos + inversión) | 970647.5632 | 941470.0199 | 1016372.249 | 914216.354 | 854876.9068 | USD. Menor = más conveniente
Ranking por VA (1 = más barata) | 4 | 3 | 5 | 2 | 1
Ranking entre opciones que cortan en planta (sin referencia) | 3 | 2 | 4 | 1 | —
Diferencia de VA contra la opción D | 56431.20917 | 27253.66586 | 102155.8946 | 0 | -59339.44722 | USD. Positivo = cuesta más que D
Stock promedio en el año de referencia | 25.6 | 29.4 | 38.2 | 26.5 | 24.6 | t
Horas-hombre de corte en el año de referencia | 544.8808431 | 926.9400804 | 246.7217588 | 627.1489759 | 49.61125981 | h/año
Operarios de corte equivalentes | 0.30 | 0.51 | 0.14 | 0.35 | 0.03 | personas
Opción más conveniente que corta en planta | D: hojas + fleje
Suba del precio de las hojas que iguala D con A (equilibrio) | 10.0%
Suba del precio del fleje que iguala D con B (equilibrio) | 9.7%
Solo cúpulas y fondos: ¿fleje a medida o tiras de hoja? (año de referencia)
Fuente de los discos | Acero comprado (t/año) | Aprovech. | Costo del acero (USD/año) | Scrap (t/año) | Horas-hombre (h/año) | Costo neto (USD/año)
Fleje a medida (A, D, referencia) | 125.3 | 68.6% | 151352.6366 | 39.4 | 49.61125981 | 141816.7286
Tiras cortadas de hojas (B) | 130.5 | 65.9% | 173594.1009 | 44.5 | 349.4023644 | 164652.9649
Diferencia a favor del fleje (USD/año) |  |  |  |  |  | 22836.23627
No incluye inversión ni stock. La bobina madre (C) mezcla discos y cuerpos y se ve en la tabla general.
Sensibilidad 1: variación del precio de las hojas (mueve B y D)
Variación precio hoja | A | B | C | D | Más barata
-10.0% | 970647.5632 | 852854.4683 | 1016372.249 | 857962.0506 | B
-5.0% | 970647.5632 | 897162.2441 | 1016372.249 | 886089.2023 | D
0.0% | 970647.5632 | 941470.0199 | 1016372.249 | 914216.354 | D
5.0% | 970647.5632 | 985777.7956 | 1016372.249 | 942343.5057 | D
10.0% | 970647.5632 | 1030085.571 | 1016372.249 | 970470.6574 | D
15.0% | 970647.5632 | 1074393.347 | 1016372.249 | 998597.8091 | A
20.0% | 970647.5632 | 1118701.123 | 1016372.249 | 1026724.961 | A
Sensibilidad 2: variación del precio del fleje (mueve A y D)
Variación precio fleje | A | B | C | D | Más barata
-10.0% | 942439.284 | 941470.0199 | 1016372.249 | 886008.0748 | D
0.0% | 970647.5632 | 941470.0199 | 1016372.249 | 914216.354 | D
10.0% | 998855.8423 | 941470.0199 | 1016372.249 | 942424.6332 | B
20.0% | 1027064.121 | 941470.0199 | 1016372.249 | 970632.9123 | B
30.0% | 1055272.401 | 941470.0199 | 1016372.249 | 998841.1915 | B
Sensibilidad 3: precio de la línea de corte transversal (mueve A y C)
Precio línea (USD) | A | B | C | D | Más barata
40000 | 923867.2955 | 941470.0199 | 969591.981 | 914216.354 | D
60000 | 947257.4294 | 941470.0199 | 992982.1148 | 914216.354 | D
80000 | 970647.5632 | 941470.0199 | 1016372.249 | 914216.354 | D
100000 | 994037.697 | 941470.0199 | 1039762.382 | 914216.354 | D
130000 | 1029122.898 | 941470.0199 | 1074847.583 | 914216.354 | D
Sensibilidad 4: precio de la cortadora longitudinal (mueve C)
Precio cortadora (USD) | A | B | C | D | Más barata
30000 | 970647.5632 | 941470.0199 | 981287.0479 | 914216.354 | D
45000 | 970647.5632 | 941470.0199 | 998829.6482 | 914216.354 | D
60000 | 970647.5632 | 941470.0199 | 1016372.249 | 914216.354 | D
90000 | 970647.5632 | 941470.0199 | 1051457.449 | 914216.354 | D
120000 | 970647.5632 | 941470.0199 | 1086542.65 | 914216.354 | D
Sensibilidades aproximadas: no recalculan el costo financiero del stock.

Sheet: Decision
Decisión: opción D — hojas estándar para cuerpos + fleje a medida para cúpulas y fondos
Todo se recalcula con Supuestos. Si cambian los precios, la primera fila avisa si la decisión sigue en pie.
✔ Con los precios cargados, la opción D sigue siendo la más conveniente de las que cortan en planta.
1. Cifras clave
Indicador | D: hojas + fleje | A: bobina + fleje | B: hojas (todo) | C: bobina madre | Unidad
Valor actual 10 años (costos + inversión) | 914216.354 | 970647.5632 | 941470.0199 | 1016372.249 | USD
Diferencia contra D | 0 | 56431.20917 | 27253.66586 | 102155.8946 | USD (positivo = más caro que D)
Inversión inicial | 71310.97465 | 156810.9746 | 57810.97465 | 191000 | USD
Aprovechamiento global de chapa | 82.8% | 86.2% | 81.7% | 87.4% | %
Costo del acero acumulado 10 años | 1957422.77 | 1839705.575 | 2054099.592 | 1840424.857 | USD
Costo anual en el año de referencia | 442735.2859 | 421272.6453 | 465758.7321 | 423638.6716 | USD/año
Stock promedio en el año de referencia | 26.5 | 25.6 | 29.4 | 38.2 | t
Horas-hombre de corte en el año de referencia | 627.1489759 | 544.8808431 | 926.9400804 | 246.7217588 | h/año
2. Por qué D
1 | Es la de menor valor actual a 10 años entre las opciones que cortan en planta. Ahorro frente a A (bobina + fleje): |  |  |  | 56431.20917
 | Ahorro frente a B (todo en hojas): |  |  |  | 27253.66586
 | Ahorro frente a C (bobina madre, precio estimado): |  |  |  | 102155.8946
2 | Invierte mucho menos que las opciones con bobina: no necesita línea de corte ni puente grúa. Inversión de D: |  |  |  | 71310.97465
 | Inversión adicional que requeriría A: |  |  |  | 85500
3 | Según las cotizaciones, la hoja cuesta casi lo mismo que la bobina, así que la bobina no compensa su mayor inversión con acero más barato. Diferencia hoja vs. bobina, mínima y máxima entre los espesores de cuerpo (1,25 a 4,75 mm): |  |  |  | -2,0% a 6,2%
4 | Margen de seguridad: el precio de las hojas tendría que subir este porcentaje (manteniendo el de la bobina) para que A iguale a D: |  |  |  | 10.0%
5 | Cúpulas y fondos desde fleje a medida: la prensa se alimenta sola (sin cargar tiras a mano, más seguro) y aprovecha mejor la chapa que las tiras de hoja. Ahorro anual frente a tiras de hoja en el año de referencia: |  |  |  | 22836.23627
6 | Una sola guillotina 6 × 3.200 mm corta todos los cuerpos, de 1,25 a 4,75 mm, incluidos los rodantes. Horas-hombre de corte por año: |  |  |  | 627.1489759
7 | Stock parecido al de A, pero comprado en paquetes mensuales de hojas en lugar de bobinas de hasta 10 t, que exigen puente grúa y depósito propio. Stock de D contra A: |  |  |  | 26,5 t contra 25,6 t
8 | Cumple la consigna de cortar en planta y es la más simple de operar, mantener y ubicar en el layout (una guillotina de ~4 m contra una línea de 12–15 m con depósito de bobinas).
3. Qué resigna D
• | Aprovecha menos chapa que A en los cuerpos (dos bordes perdidos por hoja). Aprovechamiento global D contra A: |  |  |  | 82,8% contra 86,2%
• | Scrap adicional frente a A en 10 años (t): |  |  |  | 62.2
• | Más manipulación de hojas: las de 71 a 170 kg (2 a 4,75 mm × 1500 × 3000) no se pueden mover a mano; se resuelve con la mesa elevadora de tijera y la mesa de bolas, deslizando la hoja sin levantarla.
4. Cuándo habría que revisar la decisión
• | Si el precio de las hojas sube respecto del de la bobina más que este porcentaje (A pasaría a convenir): |  |  |  | 10.0%
• | Si el precio del fleje sube más que este porcentaje (B pasaría a convenir): |  |  |  | 9.7%
• | Si la línea de corte transversal o el puente grúa resultan mucho más baratos de lo estimado, o el puente grúa ya está previsto en el layout (ver Sensibilidad 3 en Comparacion y la celda 'ya previsto' en Supuestos).
• | Si la demanda crece bastante más de lo previsto: la bobina escala mejor con volumen.
5. Datos todavía estimados (reemplazar cuando lleguen las cotizaciones)
• | Guillotina: se usa la Molinari HG 6×3200 como referencia; falta confirmar el recorrido del tope trasero (≥ 900–1.000 mm).
• | Desbobinador + alimentador de la prensa de discos, mesa elevadora de tijera, mesa de bolas y autoelevador: precios estimados.
• | Bobina LAC 4,75 mm (solo afecta a A): sin cotización, se toma igual a la de 3,2 mm.
• | Bobina madre (opción C): sin cotización; Pradecon indicó que cuesta lo mismo que la bobina flejada.
• | Diámetros de los discos del 1 kg y espesor de la cúpula del 10 kg: a confirmar con los planos.

Sheet: Resumen D
Resumen de la opción elegida: D — hojas estándar para cuerpos + fleje a medida para cúpulas y fondos
Todo vinculado al cálculo. Años 2026–2035; la columna N suma los 10 años.
1. Indicadores principales
Indicador | Valor | Unidad
Valor actual 10 años (costos + inversión, tasa de Supuestos) | 914216.354 | USD
Inversión inicial en equipos | 71310.97465 | USD
Costo operativo acumulado 10 años (nominal) | 1946376.616 | USD
Acero comprado en 10 años | 1581.7 | t
Scrap generado en 10 años | 271.7 | t
Aprovechamiento global de chapa | 82.8% | %
Costo anual en el año de referencia | 442735.2859 | USD/año
Stock promedio en el año de referencia | 26.5 | t
Horas-hombre de corte en el año de referencia | 627.1489759 | h/año
Operarios de corte equivalentes | 0.35 | personas
Ahorro de VA frente a A / B / C | 56.431 / 27.254 / 102.156 | USD
Año de referencia | 2035
2. Costos anuales (USD)
Concepto | Unidad |  | 2026 | 2027 | 2028 | 2029 | 2030 | 2031 | 2032 | 2033 | 2034 | 2035 | Total 10 años
Acero: hojas para cuerpos | USD |  | 10612.58163 | 18532.96998 | 31085.05346 | 55918.62272 | 94442.76307 | 132310.931 | 178168.7455 | 225415.457 | 257235.1049 | 296951.2465 | 1300673.476
Acero: fleje para cúpulas y fondos | USD |  | 4457.930589 | 7572.966482 | 14002.5872 | 27633.33881 | 47515.76786 | 66734.71386 | 90882.62657 | 115500.6325 | 131096.0935 | 151352.6366 | 656749.2939
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
 | 0 | 60000 | 0
 | 0 | 30000 | 0
 | 0 | 6000 | 0
Desbobinador + enderezador + alimentador servo para la prensa de discos | 1 | 12000 | 12000
Estantería porta-flejes | 1 | 3000 | 3000
Autoelevador eléctrico 2,5 t | 1 | 20000 | 20000
Mesa elevadora de tijera 1500 × 3000 mm, 3 t, elevación ~1 m (paquete de hojas a la altura de la guillotina) | 1 | 7000 | 7000
Apoyos con bolas (mesa de bolas) entre la mesa elevadora y la guillotina | 1 | 1500 | 1500
Racks por espesor en el almacén de MP y carros porta-desarrollos | 1 | 2000 | 2000
 | 0 | 1500 | 0
TOTAL |  |  | 71310.97465
Las filas en blanco son equipos que no usa la opción D.
8. Materia prima: formato, proveedor y precio
Pieza | Compra | Espesor (mm) | USD/kg | Proveedor de referencia | Consumo año de referencia (t)
Cuerpo 2,5 kg | Hoja 1220 × 2440 | 1.25 | 1.2903 | Pradecon | 15.3
Cuerpo 5 kg | Hoja 1000 × 2000 | 1.60 | 1.3275 | Pradecon | 133.6
Cuerpo 10 kg | Hoja 1500 × 3000 | 2.00 | 1.2804 | Pradecon | 18.2
Cuerpo 25 kg | Hoja 1500 × 3000 | 3.20 | 1.1019 | Pradecon | 9.8
Cuerpo 50 kg | Hoja 1500 × 3000 | 3.20 | 1.1019 | Pradecon | 32.2
Cuerpo 70 kg | Hoja 1500 × 3000 | 4.75 | 1.0910 | Pradecon | 0.0
Cuerpo 100 kg | Hoja 1500 × 3000 | 4.75 | 1.0910 | Pradecon | 6.9
Cúpula 1 kg | Rollo de fleje 114 mm | 0.90 | 1.2629 | Pradecon (a medida) | 18.3
Fondo 1 kg | Rollo de fleje 106 mm | 0.90 | 1.2629 | Pradecon (a medida) | 15.7
Cúpula 2,5 kg | Rollo de fleje 200 mm | 1.25 | 1.1860 | Pacheco Chapas | 5.1
Fondo 2,5 kg | Rollo de fleje 200 mm | 1.25 | 1.1860 | Pacheco Chapas | 4.2
Cúpula 5 kg | Rollo de fleje 250 mm | 1.60 | 1.1860 | Pacheco Chapas | 45.1
Fondo 5 kg | Rollo de fleje 200 mm | 1.60 | 1.1860 | Pacheco Chapas | 29.0
Cúpula 10 kg | Rollo de fleje 300 mm | 2.00 | 1.1980 | Pacheco Chapas | 4.8
Fondo 10 kg | Rollo de fleje 249 mm | 2.00 | 1.1980 | Pacheco Chapas | 3.2
