TadeoSinay/planos_industrial_flama/referencias/MP_Abastecimiento_Almacenamiento_FLAMA_OpcionD.xlsx

Sheet: Indice
ÍNDICE
Hoja | Contenido
Resumen | Resultados principales 2035, conclusiones y recomendaciones
Volumenes | Producción y recargas 2026–2035 (Drive)
Geometria Acero | Medidas, masas de acero, soldadura y pintura por formato
Coef Fabricacion | Consumo de cada MP por unidad fabricada
Coef Recargas | Consumo de cada MP por recarga
Consumo Anual | Consumo por año de cada MP (2026–2035)
MP Abastecimiento | TABLA PRINCIPAL: cómo viene cada MP, cada cuánto llega, stock, almacenamiento, descarga y zona
Almacen MP | m² por zona vs. layout, ubicación recomendada, recepciones y scrap
Manipulacion | Cómo se descarga y se mueve cada unidad de carga; equipos
Pallets PT | Unidades por pallet de cilindros y matafuegos; stock de PT
Corte Opcion D | Opción elegida: hojas estándar + guillotina CENA + flejes a medida. Acero por SKU, nesting y cortes, guillotina, equipos y manejo en el puesto
Dudas | Inconsistencias encontradas y supuestos a validar
Fuentes | Documentos del Drive y fuentes web
Referencias
Dato | Dato editable (número en azul; en las tablas de parámetros va en negrita)
Fórmula | Cálculo o vínculo a otra hoja (negro): no editar
 | Total o resultado principal
 | Sección de la hoja
A | Duda de prioridad A (hoja Dudas): cambia decisiones o superficies
Confianza del dato
DRIVE | Dato tomado de un archivo del Drive del proyecto
COTIZ | Cotización o mail recibido de un proveedor
WEB | Fuente web (ver hoja Fuentes)
EST | Estimación de ingeniería: validar antes de cerrar

Sheet: Resumen
FLAMA S.A. — MATERIAS PRIMAS, ABASTECIMIENTO Y ALMACENAMIENTO (año de diseño 2035)
Armado el 27/09/2026 a partir del Drive del proyecto (INVESTIGACION PROVEEDORES + Dimensionamiento (13)) y fuentes web. Todo lo calculado es fórmula: cambiar los datos azules recalcula el libro.
ALCANCE
• Fabricación de matafuegos ABC 1–100 kg (terminados) y de cilindros vendidos vacíos, más las recargas de la PLANTA INDUSTRIAL.
• No incluye las recargas de la planta comercial (otro sitio), ni servicios, EPP ni repuestos de máquinas (están en 'Investigación mercado').
• Año de diseño de stock y superficies: 2035 (el máximo del horizonte). El consumo 2026–2035 está en Consumo Anual.
RESULTADOS PRINCIPALES 2035
Indicador | Valor | Unidad | Dónde se calcula
Acero total (hojas, flejes, caño y casquetes) | 506.2327001 | t/año | Corte Opcion D A
Polvo ABC (fabricación + recargas) | 403.50998 | t/año | Consumo Anual MP-33
Gas Ar/CO₂ para soldadura | 602.4618154 | m³/mes promedio | Consumo Anual MP-25
Nitrógeno | 394.1982807 | m³/mes promedio | Consumo Anual MP-34
Alambre MIG (0,9 + 1,2 mm) | 7.3 | t/año | Consumo Anual
Stock máximo de MP | 187.64379 | t | MP Abastecimiento
Superficie de almacenamiento de MP requerida (incl. pasillos) | 377.0186417 | m² | Almacen MP 2
· AL-1 acero (requerido) | 148.3061 | m² | vs ≈116 m² netos para acero en AL-1 (layout v3)
· Pañol de insumos pesados (requerido) | 35.20733333 | m² | No existe junto a P1 en el layout v3
· Polvo químico (requerido) | 23.12091667 | m²
· Insumos de terminación y embalaje (requerido) | 97.523375 | m² | No existe en el layout v3
· Jaula de gases (requerido) | 48.78 | m² | vs 16 m² dibujados
Recepciones de MP | 5.0 | camiones/semana | Almacen MP 5
Pallets de PT despachados | 1201.525786 | pallets/año | Pallets PT D
Posiciones de PT requeridas vs layout (122) | 88 | posiciones | Pallets PT D
Cilindros de 1 kg por pallet (a granel) | 780 | u/pallet | Pallets PT A
Cilindros de 5 kg por pallet (a granel) | 126 | u/pallet | Pallets PT A
Scrap ferroso | 68.84783317 | t/año | Almacen MP 6
Inversión en corte y manejo de chapa (opción D, guillotina CENA) | 82300 | USD/año | Corte Opcion D D
CONCLUSIONES Y RECOMENDACIONES (para debatir)
Chapa | Opción D: cuerpos desde hojas estándar (1220×2440, 1000×2000, 1500×3000) cortadas en guillotina propia CENA 8×3200 con tope de 1.000 mm; cúpulas y fondos desde flejes a medida (Pacheco / Pradecon). La comparación de alternativas está en Comparacion_corte.xlsx.
Chapa | Especificar en la orden de compra: paquetes de hojas ≤2 t, un formato por paquete, sobre tacos; rollos de fleje de 0,5–1 t parados sobre cama de madera, zunchos radiales.
Manipulación | Sin puente grúa: autoelevador 2,5 t con prolongaciones y espolón. En la guillotina, mesa elevadora de tijera 3 t + mesa de bolas: las hojas de 25–168 kg se deslizan, no se levantan (ver Corte Opcion D).
Autoelevador | Autoelevador eléctrico de 2,0–2,5 t (no 1,5 t) para big bags de polvo, pallets de 1 t en rack y rollos con espolón; transpaletas y carros para la línea (cátedra).
Pañol | Separar un pañol de INSUMOS PESADOS junto a AL-1 y al portón P1 (alambre, granalla, cuplas, asientos, consumibles): hoy el pañol está en la esquina opuesta.
Terminación | Falta un depósito de insumos de terminación y embalaje junto a S3a/AL-3 (válvulas, cajas, etiquetas, film, pallets).
Polvo | Big bag de 1 t con estación de descarga sobre la tolva de carga: en 2035 se consumen ≈2 t/día de polvo.
Cilindros | Cilindros vendidos a granel, parados, con separador de cartón por capa, tapón de rosca y film (ver Pallets PT).
Validar | Antes de cerrar: ver hoja Dudas (prioridad A). En especial, % de polvo nuevo en recargas, medidas de caja y los mails a proveedores con volúmenes equivocados.

Sheet: Volumenes
VOLÚMENES DE PRODUCCIÓN Y RECARGAS 2026–2035
Fuente: Dimensionamiento_Tecnico_con_Recargas (13).xlsx › hoja datos_base (Drive, subido 27/09/2026). Recargas = PLANTA INDUSTRIAL sin la fila 'TOTAL CARROS' (es subtotal de 25–100 kg y duplicaba 1.427 u en 2035).
A. MATAFUEGOS TERMINADOS (fabricados + cargados) — unidades/año
Año | 1 kg | 2,5 kg | 5 kg | 10 kg | 25 kg | 50 kg | 70 kg | 100 kg | Total
2026 | 4179 | 295 | 2256 | 92 | 34 | 75 | 16 | 11 | 6958
2027 | 5997 | 709 | 3847 | 177 | 58 | 128 | 29 | 18 | 10963
2028 | 6852 | 987 | 5094 | 253 | 76 | 166 | 36 | 24 | 13488
2029 | 8467 | 1501 | 6823 | 358 | 100 | 221 | 48 | 33 | 17551
2030 | 12681 | 2312 | 10819 | 603 | 156 | 343 | 74 | 50 | 27038
2031 | 15620 | 3252 | 14606 | 872 | 212 | 466 | 101 | 67 | 35196
2032 | 20333 | 4103 | 18878 | 1127 | 273 | 599 | 131 | 87 | 45531
2033 | 25132 | 5105 | 23368 | 1395 | 338 | 743 | 163 | 108 | 56352
2034 | 28573 | 6195 | 26968 | 1612 | 393 | 866 | 189 | 126 | 64922
2035 | 32073 | 7425 | 30751 | 1841 | 453 | 997 | 218 | 145 | 73903
B. CILINDROS VENDIDOS VACÍOS (pintados y probados, sin válvula) — unidades/año
Año | 1 kg | 2,5 kg | 5 kg | 10 kg | 25 kg | 50 kg | 70 kg | 100 kg | Total
2026 | 0 | 0 | 0 | 0 | 0 | 0 | 0 | 0 | 0
2027 | 0 | 0 | 0 | 0 | 0 | 0 | 0 | 0 | 0
2028 | 7662 | 300 | 1479 | 90 | 14 | 32 | 7 | 5 | 9589
2029 | 26695 | 1044 | 5152 | 315 | 50 | 111 | 24 | 16 | 33407
2030 | 49435 | 1933 | 9541 | 583 | 93 | 205 | 45 | 30 | 61865
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
Factor del mes pico (% del consumo anual) | 12% | Supuesto: perfil 1 kg = 12 % (ene/dic). Dimensiona lotes y stock.
Días hábiles por mes | 20 | Dimensionamiento (13): 20 días hábiles/mes
Días hábiles por año | 240
Semanas operativas por año | 48 | EST (descontando feriados y vacaciones)

Sheet: Geometria Acero
GEOMETRÍA, ACERO Y CONSUMIBLES DE PROCESO POR RECIPIENTE
Medidas: registro FADESA (Dimensiones de chapa), ET's Matafuegos, Materias Primas › Lineamientos, cotizaciones Pacheco N°42021 / Pradecon 173170-173195 y Comparacion_corte.xlsx (opción D elegida: hojas estándar en guillotina propia + fleje a medida). Cuando los archivos se contradicen se anotó en 'Dudas'.
PARÁMETROS GENERALES
Parámetro | Unidad | Valor | Fuente / criterio
Densidad del acero | kg/m³ | 7850 | Valor estándar acero al carbono (Corte_chapa.docx)
Caño cuerpo 1 kg — Ø exterior | mm | 76.2 | Metalprisa: caño c/c LF Ø76,2 (mail 09/09/2026)
Caño cuerpo 1 kg — espesor | mm | 1.25 | Metalprisa Ø76,2 × 1,25 = $37.044 + IVA la barra de 6 m
Largo de barra de caño | mm | 6000 | Metalprisa (caño de 6 m); Ternium: largo estándar 6.000 mm
Merma de corte por cuerpo (ranura + despunte) | mm | 3 | EST
Masa por metro de caño | kg/m | 2.310 | Fórmula
Masa por barra de caño | kg | 13.863 | Fórmula
Puente entre discos en el fleje | mm | 3 | Comparacion_corte (opción D): puente s = 3 mm (≈1,5–3 × e); paso = D₀ + s
Pintura en polvo — peso específico | g/cm³ | 1.5 | EST (poliéster 1,4–1,7). Rendimiento teórico = 1000/(ρ·e) (pinturaenpolvo.org)
Pintura — espesor de película | µm | 70 | Mail a Sinteplast: 60–80 µm en manuales (Drive)
Pintura — pérdidas de aplicación | % | 25% | Rendimiento práctico 25–30 % menor que el teórico (pinturaenpolvo.org)
Pintura — consumo práctico | kg/m² | 0.140 | Fórmula
Factor de área de cúpula/fondo embutidos vs. círculo plano | - | 1.15 | EST
Rendimiento de depósito del alambre | % | 90% | EST (salpicaduras + despuntes)
Caudal de gas — manuales | L/min | 14 | EST (12–15 L/min según BOM del Drive)
Caudal de gas — rodantes | L/min | 16 | EST
Factor pre/post-flujo y purgas de gas | - | 1.25 | EST
Granalla — consumo por hora de granallado | kg/h | 6 | EST; referencia web ≈9 kg/h en una granalladora comercial (metalmecanica.com)
Granalladora — capacidad real | u/h | 81.2 | Dimensionamiento (13) › Parametros › Granallado = 81,2 u/h
Desengrasante concentrado por m² pintado | L/m² | 0.01 | EST — pedir dato al proveedor del túnel (SP Ingeniería/Electricolor)
Fosfatizante concentrado por m² pintado | L/m² | 0.01 | EST — ídem
Recorrido del tope trasero de la guillotina (CENA 8×3200) | mm | 1000 | Cotización CENA (Drive): versión con tope trasero 20–1.000 mm, USD 36.800 + IVA
Peso máximo por paquete de hojas (orden de compra) | kg | 2000 | Opción D: paquetes ≤2 t (autoelevador 2,5 t y mesa elevadora de 3 t)
DATOS POR FORMATO (una columna por formato)
Concepto | Unidad | 1 kg | 2,5 kg | 5 kg | 10 kg | 25 kg | 50 kg | 70 kg | 100 kg | Fuente / criterio
Tipo de cuerpo | - | Caño | Hoja LAF (guillotina) | Hoja LAF (guillotina) | Hoja LAF (guillotina) | Hoja LAC (guillotina) | Hoja LAC (guillotina) | Hoja LAC (guillotina) | Hoja LAC (guillotina) | Opción D: cuerpos desde hoja estándar cortada en guillotina propia; 1 kg desde caño
Espesor del cuerpo | mm | 1.2 | 1.2 | 1.6 | 2.0 | 3.2 | 3.2 | 4.8 | 4.8 | FADESA / cotizaciones Pacheco

Sheet: Coef Fabricacion
COEFICIENTES DE CONSUMO POR UNIDAD — FABRICACIÓN
Cada fila es una MP. Consumo anual = Σ coef × volumen (hoja Consumo Anual). R = por recipiente fabricado (terminado + cilindro) · T = por matafuego terminado · C = por cilindro vendido vacío.
PARÁMETROS
Parámetro | Unidad | Valor | Fuente / criterio
Densidad aparente del polvo ABC | kg/L | 0.95 | EST (0,9–1,1)
Volumen libre para el gas (fracción del volumen interior) | % | 25% | EST
Presión de carga absoluta (1,4 MPa + 1 bar) | bar | 15 | IRAM 3523: servicio 1,4 MPa (mails del Drive)
Factor de pérdidas de N₂ en la carga (purga, mangueras) | - | 1.3 | EST
Merma de polvo en el llenado | % | 1% | EST
Matafuegos de 1 kg por caja | u | 6 | ET's Matafuegos (caja × 6)
Tapones de enmascarado — ciclos de vida | ciclos | 50 | EST
Alambre por punta de contacto | kg | 4 | EST
Recipientes por disco de amolado | u | 150 | EST
Film stretch por pallet | kg | 0.35 | EST (con pre-estirado, recubridor EDOS PS5)
Esquineros por pallet | u | 4 | EST
Masa válvula 1 kg (M22) | kg | 0.2 | EST
Masa válvula M30 + manómetro | kg | 0.35 | EST
Carga nominal de polvo por formato (kg) | kg |  |  |  |  |  |  |  |  |  | 1.0 | 2.5 | 5.0 | 10.0 | 25.0 | 50.0 | 70.0 | 100.0
 |  |  | R — por RECIPIENTE fabricado |  |  |  |  |  |  |  | T — por matafuego TERMINADO |  |  |  |  |  |  |  | C — por CILINDRO vendido vacío
Código | Materia prima / insumo | Unidad | 1 kg | 2,5 kg | 5 kg | 10 kg | 25 kg | 50 kg | 70 kg | 100 kg | 1 kg | 2,5 kg | 5 kg | 10 kg | 25 kg | 50 kg | 70 kg | 100 kg | 1 kg | 2,5 kg | 5 kg | 10 kg | 25 kg | 50 kg | 70 kg | 100 kg | Criterio / fuente | Confianza
MP-01 | Caño SAE 1010 c/costura Ø76,2 × 1,25 mm × 6 m (cuerpo 1 kg) | barra | 0.0435 | 0.0000 | 0.0000 | 0.0000 | 0.0000 | 0.0000 | 0.0000 | 0.0000 | 0.0000 | 0.0000 | 0.0000 | 0.0000 | 0.0000 | 0.0000 | 0.0000 | 0.0000 | 0.0000 | 0.0000 | 0.0000 | 0.0000 | 0.0000 | 0.0000 | 0.0000 | 0.0000 | Barras por cuerpo = 1 / cuerpos por barra (Geometria) | COTIZ + EST
MP-02 | Hoja LAF 1,25 × 1220 × 2440 mm (cuerpos 2,5 kg; 27 por hoja) | hoja | 0.0000 | 0.0370 | 0.0000 | 0.0000 | 0.0000 | 0.0000 | 0.0000 | 0.0000 | 0.0000 | 0.0000 | 0.0000 | 0.0000 | 0.0000 | 0.0000 | 0.0000 | 0.0000 | 0.0000 | 0.0000 | 0.0000 | 0.0000 | 0.0000 | 0.0000 | 0.0000 | 0.0000 | Hojas por cuerpo (Geometria, opción D) | COTIZ + nesting
MP-03 | Hoja LAF 1,6 × 1000 × 2000 mm (cuerpos 5 kg; 12 por hoja) | hoja | 0.0000 | 0.0000 | 0.0833 | 0.0000 | 0.0000 | 0.0000 | 0.0000 | 0.0000 | 0.0000 | 0.0000 | 0.0000 | 0.0000 | 0.0000 | 0.0000 | 0.0000 | 0.0000 | 0.0000 | 0.0000 | 0.0000 | 0.0000 | 0.0000 | 0.0000 | 0.0000 | 0.0000 | Hojas por cuerpo (Geometria, opción D) | COTIZ + nesting
MP-04 | Hoja LAF 2,0 × 1500 × 3000 mm (cuerpos 10 kg; 15 por hoja) | hoja | 0.0000 | 0.0000 | 0.0000 | 0.0667 | 0.0000 | 0.0000 | 0.0000 | 0.0000 | 0.0000 | 0.0000 | 0.0000 | 0.0000 | 0.0000 | 0.0000 | 0.0000 | 0.0000 | 0.0000 | 0.0000 | 0.0000 | 0.0000 | 0.0000 | 0.0000 | 0.0000 | 0.0000 | Hojas por cuerpo (Geometria, opción D) | COTIZ + nesting
MP-05 | Fleje LAF 0,9 × 114 mm (cúpula 1 kg) | kg | 0.0894 | 0.0000 | 0.0000 | 0.0000 | 0.0000 | 0.0000 | 0.0000 | 0.0000 | 0.0000 | 0.0000 | 0.0000 | 0.0000 | 0.0000 | 0.0000 | 0.0000 | 0.0000 | 0.0000 | 0.0000 | 0.0000 | 0.0000 | 0.0000 | 0.0000 | 0.0000 | 0.0000 | Masa bruta de fleje por cúpula (Geometria) | COTIZ + EST
MP-06 | Fleje LAF 1,25 × 200 mm (cúpula Ø179 + fondo Ø148, 2,5 kg) | kg | 0.0000 | 0.6535 | 0.0000 | 0.0000 | 0.0000 | 0.0000 | 0.0000 | 0.0000 | 0.0000 | 0.0000 | 0.0000 | 0.0000 | 0.0000 | 0.0000 | 0.0000 | 0.0000 | 0.0000 | 0.0000 | 0.0000 | 0.0000 | 0.0000 | 0.0000 | 0.0000 | 0.0000 | Masa bruta de fleje cúpula + fondo | COTIZ
MP-07 | Fleje LAF 1,6 × 250 mm (cúpula Ø221, 5 kg) | kg | 0.0000 | 0.0000 | 0.7034 | 0.0000 | 0.0000 | 0.0000 | 0.0000 | 0.0000 | 0.0000 | 0.0000 | 0.0000 | 0.0000 | 0.0000 | 0.0000 | 0.0000 | 0.0000 | 0.0000 | 0.0000 | 0.0000 | 0.0000 | 0.0000 | 0.0000 | 0.0000 | 0.0000 | Masa bruta de fleje por cúpula | COTIZ
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
MP-64 | Esquineros de cartón | u | 0.0000 | 0.0000 | 0.0000 | 0.0000 | 0.0000 | 0.0000 | 0.0000 | 0.0000 | 0.0111 | 0.0238 | 0.0476 | 0.0667 | 0.0000 | 0.0000 | 0.0000 | 0.0000 | 0.0051 | 0.0139 | 0.0317 | 0.0667 | 0.1667 | 0.4444 | 0.6667 | 0.6667 | 4 por pallet | EST

Sheet: Consumo Anual
CONSUMO ANUAL DE MATERIAS PRIMAS E INSUMOS 2026–2035
Fórmula por celda: Σ(coef R × recipientes) + Σ(coef T × terminados) + Σ(coef C × cilindros) + Σ(coef recarga × recargas).
Código | Materia prima / insumo | Unidad | 2026 | 2027 | 2028 | 2029 | 2030 | 2031 | 2032 | 2033 | 2034 | 2035 | Crecimiento 2035/2028
MP-01 | Caño SAE 1010 c/costura Ø76,2 × 1,25 mm × 6 m (cuerpo 1 kg) | barra | 181.6956522 | 260.7391304 | 631.0434783 | 1528.782609 | 2700.695652 | 3795.652174 | 5290.173913 | 6788.391304 | 7625.782609 | 8809.608696 | 14.0×
MP-02 | Hoja LAF 1,25 × 1220 × 2440 mm (cuerpos 2,5 kg; 27 por hoja) | hoja | 10.92592593 | 26.25925926 | 47.66666667 | 94.25925926 | 157.2222222 | 224.2592593 | 298.7407407 | 378.8148148 | 442.0740741 | 522 | 11.0×
MP-03 | Hoja LAF 1,6 × 1000 × 2000 mm (cuerpos 5 kg; 12 por hoja) | hoja | 188 | 320.5833333 | 547.75 | 997.9166667 | 1696.666667 | 2370 | 3203.083333 | 4054.25 | 4608.666667 | 5305.5 | 9.7×
MP-04 | Hoja LAF 2,0 × 1500 × 3000 mm (cuerpos 10 kg; 15 por hoja) | hoja | 6.133333333 | 11.8 | 22.86666667 | 44.86666667 | 79.06666667 | 114.5333333 | 154.8 | 196 | 222.8666667 | 256.8 | 11.2×
MP-05 | Fleje LAF 0,9 × 114 mm (cúpula 1 kg) | kg | 373.6047313 | 536.1348585 | 1297.559002 | 3143.500733 | 5553.202079 | 7804.664523 | 10877.71765 | 13958.36983 | 15680.22365 | 18114.42074 | 14.0×
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
MP-65 | Pintura de retoque (esmalte rojo) — recargas | L | 17.52 | 78.75 | 157.89 | 292.86 | 431.0775 | 586.7475 | 728.715 | 828.4575 | 891.0975 | 955.05 | 6.0×

Sheet: MP Abastecimiento
MATERIAS PRIMAS E INSUMOS: PRESENTACIÓN, FRECUENCIA DE ENTREGA, STOCK Y ALMACENAMIENTO (año de diseño 2035)
Una fila por MP. Consumo 2035 desde Consumo Anual. Lote = MAX(consumo diario pico × frecuencia; 1 unidad de carga). Stock máx. = lote entregado + stock de seguridad.
Código | Materia prima / insumo | Especificación técnica | Uso (proceso / puesto) | Proveedor (Drive) / alternativas | Precio y estado (Drive) | Presentación: cómo viene | Unidad de consumo | Unidad de carga (UC) | Contenido por UC (unid. consumo) | Peso por UC (kg) | Consumo 2035 (unid./año) | Consumo mes pico 2035 | Consumo diario de diseño | Lead time (días háb.) | Frecuencia de entrega (días háb.) | Lote por entrega (unid.) | UC por entrega | Entregas por año | Cobertura de cada entrega (días háb.) | Stock de seguridad (días háb.) | Stock máximo (unid.) | Stock máximo (UC) | Peso del stock máximo (t) | Tipo de almacenamiento | UC por posición | Posiciones extra (en uso / vacíos) | Posiciones requeridas | m² requeridos (incl. pasillos) | Zona sugerida | Descarga del camión | Movimiento interno | Frecuencia sugerida | Fuente | Confianza | Dudas / a validar | Grupo de entrega | Peso por entrega (kg)
MP-01 | Caño SAE 1010 c/costura Ø76,2 × 1,25 mm × 6 m (cuerpo 1 kg) | SAE 1010 c/c, laminado en frío, Ø76,2 × 1,25 mm, barra 6 m. El 1 kg no se granalla (tubo limpio). | Cuerpo 1 kg — corte de caño (E-01) | Metalprisa/Prilux (CABA). Alt.: Comercial MID, SIAT, Tenaris | $37.044 + IVA por barra de 6 m (Metalprisa, 09/09/2026). Comercial MID cotizó Ø76 × 2,6 mm (no corresponde) | Barras de 6 m en atados hexagonales flejados | barra | Atado de 61 barras (EST) | 61 | 845.6336669 | 8809.608696 | 1057.153043 | 52.9 | 5 | 5 | 264.2882609 | 5 | 28.9 | 5.77021467 | 5 | 569.2882609 | 10 | 8.46 | Cantiléver (atados 6 m) | 1 | 0 | 10 | 25.7 | AL-1 Acero (junto a P1) | Autoelevador 2,5 t con prolongaciones de horquilla ≥1,8 m (o 2 eslingas + balancín) | Autoelevador → cargador de atados de E-01 (N1) | Semanal en 2035 (≈5 atados); quincenal en los primeros años | Drive: Materias Primas; mail Metalprisa 09/09/2026. Web: Ternium tubos (largo estándar 6.000 mm) | COTIZ + EST | Confirmar barras por atado y peso. Largo de corte 255 mm (FADESA) vs 298 mm (ET's): 23 vs 19 cuerpos/barra. | Metalprisa (caño) | 4228.168334
MP-02 | Hoja LAF 1,25 × 1220 × 2440 mm (cuerpos 2,5 kg; 27 por hoja) | LAF SAE 1010 1,25 mm (apta rolado), hoja comercial 1220 × 2440 mm. En planta: 3 franjas de 385,5 mm → 27 desarrollos de 385,5 × 269,5 mm (94 %) | Cuerpo 2,5 kg: guillotina CENA 8×3200 → grabado de lote → cilindrado → soldadura longitudinal | Pradecon (cot. 173195). Alt.: Hierros Parrotta (cot. 413329) | USD 1,290/kg sin IVA (Pradecon 173195: $1.993,51/kg a TC 1.545). Parrotta: USD 1,346/kg | Paquete de hojas flejado sobre tacos de madera, un formato por paquete | hoja | Paquete ≤2 t (hojas de 29 kg) | 68 | 1986.2698 | 522 | 62.64 | 3.1 | 10 | 20 | 68 | 1 | 7.7 | 21.71136654 | 10 | 99.32 | 2 | 3.97 | Piso paquetes de hoja estándar (2 alturas) | 2 | 0 | 1 | 3.1 | AL-1 Acero (junto a P1) | Autoelevador 2,5 t con prolongaciones de horquilla (la opción D no usa puente grúa) | Autoelevador → mesa elevadora de tijera de la guillotina (tandas por formato); el paquete vuelve al almacén | Mensual (lote de 1 mes y 2 semanas de stock de seguridad, Comparacion_corte) | Comparacion_corte (opción D); Pradecon 173195; Parrotta 413329 | COTIZ | Pedir en la OC paquetes ≤2 t, un formato por paquete, sobre tacos con luz para horquillas. | Pradecon (hojas + fleje 0,9) | 1986.2698
MP-03 | Hoja LAF 1,6 × 1000 × 2000 mm (cuerpos 5 kg; 12 por hoja) | LAF SAE 1010 1,6 mm, hoja comercial 1000 × 2000 mm. En planta: 3 franjas de 330 mm → 12 desarrollos de 474,5 × 330 mm (94 %) | Cuerpo 5 kg: guillotina CENA 8×3200 → grabado de lote → cilindrado | Pradecon (cot. 173195). Alt.: Hierros Parrotta | USD 1,328/kg sin IVA (Pradecon 173195: $2.051,02/kg a TC 1.545). Parrotta: USD 1,344/kg en 1220 × 2440 | Paquete de hojas flejado sobre tacos de madera, un formato por paquete | hoja | Paquete ≤2 t (hojas de 25 kg) | 79 | 1984.48 | 5305.5 | 636.66 | 31.8 | 10 | 20 | 636.66 | 9 | 7.5 | 22.33531241 | 10 | 1029.33 | 14 | 27.78 | Piso paquetes de hoja estándar (2 alturas) | 2 | 0 | 7 | 15.7 | AL-1 Acero (junto a P1) | Autoelevador 2,5 t con prolongaciones de horquilla (la opción D no usa puente grúa) | Autoelevador → mesa elevadora de tijera de la guillotina (tandas por formato); el paquete vuelve al almacén | Mensual (lote de 1 mes y 2 semanas de stock de seguridad, Comparacion_corte) | Comparacion_corte (opción D); Pradecon 173195; Parrotta 413329 | COTIZ | Ítem de acero de mayor volumen (≈440 hojas/mes en 2035): negociar precio anual; evaluar entregas quincenales para bajar el stock. | Pradecon (hojas + fleje 0,9) | 17860.32
MP-04 | Hoja LAF 2,0 × 1500 × 3000 mm (cuerpos 10 kg; 15 por hoja) | LAF SAE 1010 2,0 mm, hoja comercial 1500 × 3000 mm. En planta: 3 franjas de 495 mm → 15 desarrollos de 563 × 495 mm (93 %) | Cuerpo 10 kg: guillotina CENA 8×3200 → grabado de lote → cilindrado | Pradecon (cot. 173195). Alt.: Hierros Parrotta | USD 1,280/kg sin IVA (Pradecon 173195: $1.978,22/kg a TC 1.545). Parrotta: USD 1,361/kg en 1220 × 2440 | Paquete de hojas flejado sobre tacos de madera, un formato por paquete | hoja | Paquete ≤2 t (hojas de 71 kg) | 28 | 1978.2 | 256.8 | 30.816 | 1.5 | 10 | 20 | 30.816 | 2 | 4.6 | 36.34475597 | 10 | 71.408 | 3 | 5.93 | Piso paquetes de hoja estándar (2 alturas) | 2 | 0 | 2 | 8.9 | AL-1 Acero (junto a P1) | Autoelevador 2,5 t con prolongaciones de horquilla (la opción D no usa puente grúa) | Autoelevador → mesa elevadora de tijera de la guillotina (tandas por formato); el paquete vuelve al almacén | Mensual (lote de 1 mes y 2 semanas de stock de seguridad, Comparacion_corte) | Comparacion_corte (opción D); Pradecon 173195; Parrotta 413329 | COTIZ | Hoja de 71 kg: se desliza sobre la mesa de bolas, no se levanta. | Pradecon (hojas + fleje 0,9) | 3956.4
MP-05 | Fleje LAF 0,9 × 114 mm (cúpula 1 kg) | LAF SAE 1010 0,9 mm calidad embutido (DDQ), fleje de 114 mm (Ø108 + 2 × 3 mm), 1 disco por ancho | Cúpula 1 kg: desbobinador + enderezador + alimentador servo → prensa de corte y embutido (E-05) | Pradecon (bobina LAF flejada, cot. 173170). Alt.: Pacheco / Carflej | USD 1,263/kg sin IVA (Pradecon 173170, LAF 0,9 mm; flejado sin cargo) | Rollo de fleje DI 508 mm, parado sobre cama de madera, zunchos radiales + perimetral | kg | Rollo ≈1 t (DE ≈1,3 m) | 1000 | 1000 | 18114.42074 | 2173.730488 | 108.7 | 10 | 5 | 1000 | 1 | 18.1 | 9.200772638 | 10 | 2086.865244 | 3 | 3.00 | Piso 1 altura (rollos de fleje) | 1 | 0 | 3 | 4.8 | AL-1 Acero (junto a P1) | Autoelevador con espolón para rollos | Autoelevador con espolón → desbobinador de la prensa E-05 (N2) | Semanal en 2035 | Comparacion_corte (opción D); Pradecon 173170 | COTIZ + EST | Ø del disco de 1 kg estimado (108 mm): medir. Rollo de 1 t × 114 mm ≈ DE 1,3 m: confirmar que entra en el desbobinador (máx. 1,5 m). | Pradecon (hojas + fleje 0,9) | 1000
MP-06 | Fleje LAF 1,25 × 200 mm (cúpula Ø179 + fondo Ø148, 2,5 kg) | LAF 1,25 mm, ancho 200 mm | Cúpula y fondo 2,5 kg (E-05) | Pacheco Chapas (cot. 42021). Alt.: Pradecon (corta a medida sin cargo) | USD 1,186/kg; 6 rollos = 2.951 kg (≈492 kg/rollo) — Pacheco N°42021. Materias Primas: $892.186 por rollo | Rollo de fleje DI 508 mm sobre cama de madera | kg | Rollo ≈492 kg | 492 | 492 | 9210.605175 | 1105.272621 | 55.3 | 10 | 10 | 552.6363105 | 2 | 9.4 | 17.80556184 | 10 | 1536.636311 | 4 | 1.97 | Piso 1 altura (rollos de fleje) | 1 | 0 | 4 | 6.4 | AL-1 Acero (junto a P1) | Autoelevador con espolón para rollos | Autoelevador con espolón → devanadora E-05 | Quincenal | Drive: Pacheco N°42021; Materias Primas | COTIZ | Para el fondo Ø148, un fleje de 150 mm ahorra ≈25 % de chapa (FADESA usa 179 y 147/148 mm). | Pacheco (flejes) | 984
MP-07 | Fleje LAF 1,6 × 250 mm (cúpula Ø221, 5 kg) | LAF 1,6 mm, ancho 250 mm | Cúpula 5 kg (E-05) | Pacheco Chapas (cot. 42021). Alt.: Pradecon (corta a medida sin cargo) | USD 1,186/kg; 4 rollos = 2.459 kg (≈615 kg/rollo) — Pacheco N°42021 | Rollo de fleje DI 508 mm sobre cama de madera | kg | Rollo ≈615 kg | 615 | 615 | 44780.11776 | 5373.614131 | 268.7 | 10 | 5 | 1343.403533 | 3 | 24.3 | 6.86688681 | 10 | 4531.807066 | 8 | 4.92 | Piso 1 altura (rollos de fleje) | 1 | 0 | 8 | 12.8 | AL-1 Acero (junto a P1) | Autoelevador con espolón para rollos | Autoelevador con espolón → devanadora E-05 | Semanal en 2035 | Drive: Pacheco N°42021 | COTIZ | Ancho óptimo ≈223–225 mm (Ø221): −10 % de chapa. | Pacheco (flejes) | 1845
MP-08 | Fleje LAF 1,6 × 200 mm (fondo Ø177, 5 kg) | LAF 1,6 mm, ancho 200 mm | Fondo 5 kg (E-05) | Pacheco Chapas (cot. 42021). Alt.: Pradecon (corta a medida sin cargo) | USD 1,186/kg; 6 rollos = 2.951 kg (≈492 kg/rollo) — Pacheco N°42021 | Rollo de fleje DI 508 mm sobre cama de madera | kg | Rollo ≈492 kg | 492 | 492 | 28787.21856 | 3454.466227 | 172.7 | 10 | 5 | 863.6165568 | 2 | 29.3 | 5.696972761 | 10 | 2711.233114 | 6 | 2.95 | Piso 1 altura (rollos de fleje) | 1 | 0 | 6 | 9.6 | AL-1 Acero (junto a P1) | Autoelevador con espolón para rollos | Autoelevador con espolón → devanadora E-05 | Semanal en 2035 | Drive: Pacheco N°42021 | COTIZ | 'Materias Primas' dice 1.412 discos/rollo: con 1,6 mm salen ≈1.094 (se calculó con 1,25 mm). El fondo sale ≈29 % más caro de lo previsto. | Pacheco (flejes) | 984
MP-09 | Fleje LAF 2,0 × 300 mm (cúpula Ø258, 10 kg) | LAF 2,0 mm, ancho 300 mm | Cúpula 10 kg (E-05) | Pacheco Chapas (cot. 42021). Alt.: Pradecon (corta a medida sin cargo) | Pacheco cotizó 2,0 × 300: USD 1,198/kg, 4 rollos = 2.951 kg (≈738 kg/rollo) | Rollo de fleje DI 508 mm sobre cama de madera | kg | Rollo ≈738 kg | 738 | 738 | 4735.30212 | 568.2362544 | 28.4 | 10 | 20 | 738 | 1 | 6.4 | 25.97511138 | 10 | 1022.118127 | 2 | 1.48 | Piso 1 altura (rollos de fleje) | 1 | 0 | 2 | 3.2 | AL-1 Acero (junto a P1) | Autoelevador con espolón para rollos | Autoelevador con espolón → devanadora E-05 | Mensual / bimestral (bajo volumen) | Drive: Pacheco N°42021; Comparacion_corte (opción D) | COTIZ | FADESA indica 1,6 mm para la cúpula del 10 kg; la opción D toma 2,0 mm (ver Dudas). | Pacheco (flejes) | 738
MP-10 | Fleje LAF 2,0 × 249 mm (fondo Ø205, 10 kg) | LAF 2,0 mm, ancho 249 mm | Fondo 10 kg (E-05) | Pacheco Chapas (cot. 42021). Alt.: Pradecon (corta a medida sin cargo) | USD 1,198/kg; 6 rollos = 2.988 kg (≈498 kg/rollo, ancho 249) — Pacheco N°42021 | Rollo de fleje DI 508 mm sobre cama de madera | kg | Rollo ≈498 kg | 498 | 498 | 3132.193709 | 375.8632451 | 18.8 | 10 | 20 | 498 | 1 | 6.3 | 26.49899965 | 10 | 685.9316225 | 2 | 1.00 | Piso 1 altura (rollos de fleje) | 1 | 0 | 2 | 3.2 | AL-1 Acero (junto a P1) | Autoelevador con espolón para rollos | Autoelevador con espolón → devanadora E-05 | Mensual / bimestral | Drive: Pacheco N°42021 | COTIZ | Ancho óptimo ≈207–210 mm (Ø205): −16 % de chapa. | Pacheco (flejes) | 498
MP-11 | Hoja LAC 3,2 × 1500 × 3000 mm (cuerpos 25 kg: 9 por hoja; 50 kg: 6 por hoja) | LAC SAE 1010 3,2 mm (1/8"), hoja 1500 × 3000 mm. 25 kg: 3 franjas de 490 → 9 desarrollos de 858 × 490 (84 %). 50 kg: 2 franjas de 640 → 6 desarrollos de 994 × 640 (85 %) | Cuerpos 25 y 50 kg: guillotina CENA 8×3200 → roladora E-15 (celda rodantes S1b) | Pradecon (cot. 173195). Alt.: Hierros Parrotta | USD 1,102/kg sin IVA (Pradecon 173195: $1.702,49/kg a TC 1.545). Parrotta: USD 1,161/kg | Paquete de hojas flejado sobre tacos de madera, un formato por paquete | hoja | Paquete ≤2 t (hojas de 113 kg) | 17 | 1921.68 | 370.2777778 | 44.43333333 | 2.2 | 10 | 20 | 44.43333333 | 3 | 7.3 | 22.95573893 | 10 | 73.21666667 | 5 | 9.61 | Piso paquetes de hoja estándar (2 alturas) | 2 | 0 | 3 | 13.4 | AL-1 Acero (junto a P1) | Autoelevador 2,5 t con prolongaciones de horquilla (la opción D no usa puente grúa) | Autoelevador → mesa elevadora de la guillotina; desarrollos en carro a la roladora E-15 (S1b) | Mensual (lote de 1 mes y 2 semanas de stock de seguridad, Comparacion_corte) | Comparacion_corte (opción D); Pradecon 173195; Parrotta 413329 | COTIZ | Hoja de 113 kg y desarrollos de 10,6 / 16 kg: deslizar, no levantar. Cortes de 858 y 994 mm: requieren el tope de 1.000 mm. | Pradecon (hojas + fleje 0,9) | 5765.04
MP-12 | Hoja LAC 4,75 × 1500 × 3000 mm (cuerpos 70 y 100 kg; hoja mixta 3 × 70 + 1 × 100) | LAC SAE 1010 4,75 mm (3/16"), hoja 1500 × 3000 mm. Hoja mixta: franja de 1212 → 1 cuerpo de 100 kg (900) + 3 de 70 kg (680), 79 %. Resto de 100 kg: 3 por hoja (73 %) | Cuerpos 70 y 100 kg: guillotina CENA 8×3200 → roladora E-15 (celda rodantes S1b) | Pradecon (cot. 173195). Alt.: Hierros Parrotta | USD 1,091/kg sin IVA (Pradecon 173195: $1.685,56/kg a TC 1.545). Parrotta: USD 1,168/kg | Paquete de hojas flejado sobre tacos de madera, un formato por paquete | hoja | Paquete ≤2 t (hojas de 168 kg) | 11 | 1845.73125 | 165.2222222 | 19.82666667 | 1.0 | 10 | 20 | 19.82666667 | 2 | 7.5 | 22.19233356 | 10 | 31.91333333 | 3 | 5.54 | Piso paquetes de hoja estándar (2 alturas) | 2 | 0 | 2 | 8.9 | AL-1 Acero (junto a P1) | Autoelevador 2,5 t con prolongaciones de horquilla (la opción D no usa puente grúa) | Autoelevador → mesa elevadora de la guillotina; desarrollos en carro a la roladora E-15 (S1b) | Mensual (lote de 1 mes y 2 semanas de stock de seguridad, Comparacion_corte) | Comparacion_corte (opción D); Pradecon 173195; Parrotta 413329 | COTIZ | Hoja de 168 kg y franja de 136 kg: solo deslizar sobre la mesa de bolas, entre dos. La franja de 1212 sale cortando primero la orilla de 288 mm. | Pradecon (hojas + fleje 0,9) | 3691.4625
MP-13 | Fleje LAF 0,9 × 106 mm (fondo 1 kg) | LAF SAE 1010 0,9 mm calidad embutido (DDQ), fleje de 106 mm (Ø100 + 2 × 3 mm), 1 disco por ancho | Fondo 1 kg: desbobinador + enderezador + alimentador servo → prensa de corte y embutido (E-05) | Pradecon (bobina LAF flejada, cot. 173170). Alt.: Pacheco / Carflej | USD 1,263/kg sin IVA (Pradecon 173170, LAF 0,9 mm; flejado sin cargo) | Rollo de fleje DI 508 mm, parado sobre cama de madera, zunchos radiales + perimetral | kg | Rollo ≈1 t (DE ≈1,3 m) | 1000 | 1000 | 15629.30659 | 1875.516791 | 93.8 | 10 | 5 | 1000 | 1 | 15.6 | 10.66372751 | 10 | 1937.758395 | 2 | 2.00 | Piso 1 altura (rollos de fleje) | 1 | 0 | 2 | 3.2 | AL-1 Acero (junto a P1) | Autoelevador con espolón para rollos | Autoelevador con espolón → desbobinador de la prensa E-05 (N2) | Semanal en 2035 | Comparacion_corte (opción D); Pradecon 173170 | COTIZ + EST | Ø del fondo de 1 kg estimado (100 mm): medir. | Pradecon (hojas + fleje 0,9) | 1000
MP-15 | Casquete embutido 10" × 3,2 mm (carro 25 kg) | Casquete SAE 1010 3,2 mm, 10" (F195 FADESA, 2,44 kg); cúpula con agujero para cupla | Cúpula y fondo carro 25 kg | Tercerizado: EKC (EAU/India), chinafiresafety, firesafer o matricería local | A cotizar | Casquetes anidados en pallet, flejados | u | Pallet 100 u (EST) | 100 | 244 | 1550 | 186 | 9.3 | 60 | 40 | 372 | 4 | 3.9 | 43.01075269 | 20 | 586 | 6 | 1.46 | Piso apilado 2 alturas (paquetes/pallets) | 2 | 0 | 3 | 2.7 | AL-1 Acero (junto a P1) | Autoelevador 2,5 t en muelle / playón (o transpaleta si hay muelle a nivel de caja) | Autoelevador / zorra → celda rodantes (S1b) | Bimestral (si es importado, 1–2 compras por año) | Drive: Investigación mercado; Dimensiones de chapa (FADESA) | DRIVE + EST | Proveedor sin definir; si se importa, el lead time (≥60 días) obliga a más stock. | Casquetes (tercerizado) | 976
MP-16 | Casquete embutido 12" × 3,2 mm (carro 50 kg) | Casquete 3,2 mm, 12" (F196, 3,36 kg) | Carro 50 kg | Tercerizado (ídem) | A cotizar | Casquetes anidados en pallet | u | Pallet 80 u (EST) | 80 | 268.8 | 3410 | 409.2 | 20.5 | 60 | 40 | 818.4 | 11 | 3.9 | 43.01075269 | 20 | 1289.2 | 17 | 4.57 | Piso apilado 2 alturas (paquetes/pallets) | 2 | 0 | 9 | 8.1 | AL-1 Acero (junto a P1) | Autoelevador 2,5 t en muelle / playón (o transpaleta si hay muelle a nivel de caja) | Autoelevador / zorra → S1b | Bimestral | Drive: FADESA | DRIVE + EST | Ídem MP-15 | Casquetes (tercerizado) | 2956.8
MP-17 | Casquete embutido 15" × 4,75 mm (carros 70 y 100 kg) | Casquete 4,75 mm, 15" (F198, 6,64 kg) | Carros 70 y 100 kg | Tercerizado (ídem) | A cotizar | Casquetes anidados en pallet | u | Pallet 60 u (EST) | 60 | 398.4 | 1240 | 148.8 | 7.4 | 60 | 40 | 297.6 | 5 | 4.1 | 40.32258065 | 20 | 448.8 | 8 | 3.19 | Piso apilado 2 alturas (paquetes/pallets) | 2 | 0 | 4 | 3.6 | AL-1 Acero (junto a P1) | Autoelevador 2,5 t en muelle / playón (o transpaleta si hay muelle a nivel de caja) | Autoelevador / zorra → S1b | Bimestral | Drive: FADESA | DRIVE + EST | Masa del casquete de 100 kg sin dato (se asumió igual al 70 kg). | Casquetes (tercerizado) | 1992
MP-18 | Asiento de válvula roscado M22 (cúpula 1 kg) | Anillo/niple SAE 1020 rosca M22 (válvula HZ de 1 kg es M-22), soldable a la cúpula | Cúpula 1 kg: soldadura de cuello (E-07) | Torneado/estampado: Eli-Met (Mataderos), Indumatic | Sin cotizar | Caja de cartón × 1.000 u | u | Pallet 12 cajas = 12.000 u (EST) | 12000 | 720 | 202621 | 24314.52 | 1215.7 | 28 | 20 | 24314.52 | 3 | 5.6 | 29.61193558 | 10 | 48157.26 | 5 | 3.60 | Rack selectivo 3 niveles | 1 | 0 | 5 | 6.5 | Pañol de insumos pesados (junto a AL-1 / P1) | Autoelevador 2,5 t en muelle / playón (o transpaleta si hay muelle a nivel de caja) | Carro de reparto → E-07 (N2) | Mensual | Drive: lista de precios (válvula HZ M-22 para 1 kg); layout v3 (pallets 'Asientos de válvula' en N2) | EST | Rosca M22 vs M30 para el 1 kg. Con más de 200.000 u/año conviene pieza estampada o forjada, no torneada. | Eli-Met (cuplas/asientos) | 2160
MP-19 | Asiento de válvula roscado M30 × 1,5 (cúpula 2,5–10 kg) | Anillo SAE 1020 rosca M30 × 1,5, soldable | Cúpulas 2,5–10 kg (E-07) | Eli-Met / Indumatic | Sin cotizar (Eli-Met cotizó la cupla M30 de carros a $5.261) | Caja de cartón × 1.000 u | u | Pallet 8 cajas = 8.000 u (EST) | 8000 | 640 | 81612 | 9793.44 | 489.7 | 28 | 20 | 9793.44 | 2 | 5.1 | 32.67493342 | 10 | 20896.72 | 3 | 1.92 | Rack selectivo 3 niveles | 1 | 0 | 3 | 3.9 | Pañol de insumos pesados (junto a AL-1 / P1) | Autoelevador 2,5 t en muelle / playón (o transpaleta si hay muelle a nivel de caja) | Carro de reparto → E-07 | Mensual | Drive: Investigación mercado (rosca M30 × 1,5) | EST | — | Eli-Met (cuplas/asientos) | 1280
MP-20 | Cupla soldable M30 × 1,5 (carros 25 y 50 kg) | Cupla soldable M30 × 1,5 (material + mano de obra) | Casquete superior carros 25/50 kg | Eli-Met | $5.261 c/u + IVA; entrega 35–40 días; 30 % anticipo, saldo a 30 días | Caja de cartón | u | Caja 200 u (EST) | 200 | 50 | 2480 | 297.6 | 14.9 | 28 | 40 | 595.2 | 3 | 4.1 | 40.32258065 | 20 | 897.6 | 5 | 0.25 | Estantería pañol (metro lineal) | 2 | 0 | 3 | 3.6 | Pañol de insumos pesados (junto a AL-1 / P1) | Transpaleta manual / a mano (bultos chicos) | Carro de reparto → S1b | Bimestral | Drive: Cotizaciones de MP – wpp (ELIMET) | COTIZ | — | Eli-Met (cuplas/asientos) | 150
MP-21 | Cupla soldable 2½" BSP (carros 70 y 100 kg) | Cupla soldable 2½" BSP | Casquete superior carros 70/100 kg | Eli-Met | $13.479 c/u + IVA; 35–40 días | Caja de cartón | u | Caja 50 u (EST) | 50 | 30 | 620 | 74.4 | 3.7 | 28 | 40 | 148.8 | 3 | 4.1 | 40.32258065 | 20 | 224.4 | 5 | 0.15 | Estantería pañol (metro lineal) | 2 | 0 | 3 | 3.6 | Pañol de insumos pesados (junto a AL-1 / P1) | Transpaleta manual / a mano (bultos chicos) | Carro de reparto → S1b | Bimestral / trimestral | Drive: Cotizaciones de MP – wpp (ELIMET) | COTIZ | — | Eli-Met (cuplas/asientos) | 90
MP-22 | Varilla de refuerzo (carros 70 y 100 kg) | Barra de 6 m (medida a definir por cálculo) | Refuerzo interior longitudinal 70/100 kg | Aceros Inoxidables Caseros | $15.000/kg + IVA (barras de 6 m; las dos medidas igual precio) | Barras de 6 m sueltas / atado | kg | Atado ≈200 kg (EST) | 200 | 200 | 930 | 111.6 | 5.6 | 10 | 60 | 334.8 | 2 | 2.3 | 71.68458781 | 20 | 511.6 | 3 | 0.60 | Cantiléver (atados 6 m) | 2 | 0 | 2 | 5.1 | AL-1 Acero (junto a P1) | Autoelevador / a mano | Autoelevador → sierra → S1b | Trimestral | Drive: Cotizaciones de MP – wpp | COTIZ + EST | Precio de acero inoxidable: ¿la varilla es inoxidable? Soldar inoxidable a SAE 1010 no es lo habitual; confirmar material y medida. | Aceros (varilla) | 400
MP-23 | Alambre MIG ER70S-6 Ø0,9 mm (manuales 1–10 kg) | AWS A5.18 ER70S-6, Ø0,9 mm, cobreado | Soldaduras de cuello, longitudinal y circunferencial (N1, N2, N3) | ESAB / Conarco / Indura (vía Oxicas, Air Liquide) | Sin cotizar | Carrete de 15 kg (estándar). Para soldadoras automáticas conviene tambor de 250 kg (Marathon Pac) | kg | Pallet 60 carretes × 15 kg = 900 kg (EST) | 900 | 930 | 5982.476692 | 717.8972031 | 35.9 | 5 | 20 | 900 | 1 | 6.6 | 25.07322765 | 5 | 1079.474301 | 2 | 1.86 | Rack selectivo 3 niveles | 1 | 0 | 2 | 2.6 | Pañol de insumos pesados (junto a AL-1 / P1) | Autoelevador 2,5 t en muelle / playón (o transpaleta si hay muelle a nivel de caja) | Carro de reparto a los puestos de soldadura | Mensual (1 pallet) | Web: presentaciones de 15 kg (2sonline, Conarco); ESAB Marathon Pac 250 kg. Drive: recomendación cátedra (Ø0,9) | WEB + EST | Consumo estimado por sección de cordón; validar con el proveedor de las soldadoras. | Soldadura (alambre y consumibles) | 930
MP-24 | Alambre MIG ER70S-6 Ø1,2 mm (carros 25–100 kg) | AWS A5.18 ER70S-6, Ø1,2 mm | Celda rodantes (S1b) | ESAB / Conarco / Indura | Sin cotizar | Carrete de 15–18 kg | kg | Pallet 60 carretes = 900 kg (EST) | 900 | 930 | 1308.265178 | 156.9918213 | 7.8 | 5 | 40 | 900 | 1 | 1.5 | 114.6556543 | 10 | 978.4959107 | 2 | 1.86 | Rack selectivo 3 niveles | 1 | 0 | 2 | 2.6 | Pañol de insumos pesados (junto a AL-1 / P1) | Autoelevador 2,5 t en muelle / playón (o transpaleta si hay muelle a nivel de caja) | Carro de reparto → S1b | Bimestral / trimestral | Web: ESAB (1,2 mm en carrete y tambor) | WEB + EST | — | Soldadura (alambre y consumibles) | 930
MP-25 | Gas de protección Ar + 8 % CO₂ (ARCAL 21) | Mezcla Ar/CO₂ 92/8 (ISO 14175 M20-ArC-8) | Todas las soldaduras MIG | Air Liquide (esquema 'sodero' en comodato) | $8.800/m³ molécula + $1.000/m³ acarreo + $50.000/mes alquiler por batería; entrega D+1 | Batería de 11 cilindros de 50 L con salida única = 115,5 m³ (Drive). Alternativa: bloque 12 × 50 L = 132 m³ | m³ | Batería 115,5 m³ | 115.5 | 1000 | 7229.541785 | 867.5450142 | 43.4 | 1 | 5 | 216.8862536 | 2 | 31.3 | 5.325372084 | 2 | 317.7545014 | 3 | 3.00 | Jaula de gases (baterías) | 1 | 2 | 5 | 9.9 | Jaula de gases (exterior, con acceso de camión) | Camión del proveedor con hidrogrúa (baterías en comodato); la jaula necesita acceso de camión | Fija: manifold + cañería a los puestos | Semanal (recambio de baterías) | Drive: Cotizaciones de MP – wpp (Air Liquide); Datos técnicos ARCAL. Web: bloque 12×50 L ≈ 290 kg de bastidor (PWENT) | DRIVE + EST | Drive: 500–600 m³/mes en el año 10 y '4 baterías con recambio mensual' = 462 m³/mes, que no alcanza. Con volúmenes de este orden, evaluar mezclador y tanque a granel. | Air Liquide (gases) | 2000
MP-26 | Puntas de contacto y toberas MIG | Puntas CuCrZr Ø0,9 / Ø1,2 + toberas | Antorchas MIG | ESAB / Binzel (distribuidores de soldadura) | Sin cotizar | Caja × 25 u | u | Caja 25 u | 25 | 0.3 | 1822.685468 | 218.7222561 | 10.9 | 5 | 20 | 218.7222561 | 9 | 8.1 | 20.57403796 | 10 | 334.3611281 | 14 | 0.0042 | Estantería pañol (metro lineal) | 10 | 0 | 2 | 2.4 | Pañol de insumos pesados (junto a AL-1 / P1) | Transpaleta manual / a mano (bultos chicos) | Entrega en pañol contra vale | Mensual | EST | EST | — | Soldadura (alambre y consumibles) | 2.7
MP-27 | Discos de amolado y corte Ø115 mm | Grano 60 + corte 1,0 mm, para acero | Corrección de defectos / despunte | Norton / Pferd / 3M | Sin cotizar | Caja × 25 u | u | Caja 25 u | 25 | 3 | 1915.553333 | 229.8664 | 11.5 | 5 | 20 | 229.8664 | 10 | 7.7 | 21.75176537 | 10 | 364.9332 | 15 | 0.04 | Estantería pañol (metro lineal) | 10 | 0 | 2 | 2.4 | Pañol de insumos pesados (junto a AL-1 / P1) | Transpaleta manual / a mano (bultos chicos) | Pañol | Mensual | EST (BOM del Drive lo lista como consumible menor) | EST | — | Soldadura (alambre y consumibles) | 30
MP-28 | Granalla de acero S330/S390 (reposición) | Granalla esférica alto carbono, SAE J444 / ISO 11124-3 | Granalladora E-13 (Sa 2,5) | CYM Materiales (cymba@cym.com.ar) | $2.000/kg (Investigación mercado) | Bolsa 25 kg; pallet de 40 bolsas = 1 t; big bag 1 t | kg | Pallet 1.000 kg | 1000 | 1035 | 6030.44335 | 723.653202 | 36.2 | 7 | 60 | 2170.959606 | 3 | 2.0 | 82.91264357 | 20 | 3723.653202 | 4 | 4.14 | Rack selectivo 3 niveles | 1 | 0 | 4 | 5.2 | Pañol de insumos pesados (junto a AL-1 / P1) | Autoelevador 2,5 t en muelle / playón (o transpaleta si hay muelle a nivel de caja) | Autoelevador; 1 pallet al pie de la granalladora (N4) | Bimestral | Drive: Investigación mercado (CYM). Web: 25 kg / 40 bolsas por pallet / big bag 1 t | COTIZ + EST | Consumo por hora supuesto (6 kg/h); pedir el dato a CYM para el modelo CAB-TUN. | CYM (granalla) | 3105
MP-29 | Desengrasante alcalino (pretratamiento) | Desengrasante alcalino por aspersión | Túnel de pretratamiento (S2) | Henkel (Bonderite) / Chemetall / Quimguard / SP Ingeniería | Sin cotizar | Bidón 20–25 L o tambor 200 L | L | Tambor 200 L | 200 | 220 | 356.4430542 | 42.7731665 | 2.1 | 10 | 60 | 200 | 1 | 1.8 | 93.51657423 | 20 | 242.7731665 | 2 | 0.44 | Batea antiderrame (tambores/bidones) | 4 | 0 | 1 | 2.5 | Depósito de químicos y agentes líquidos (con batea) | Autoelevador 2,5 t en muelle / playón (o transpaleta si hay muelle a nivel de caja) | Autoelevador con pinza de tambor / carro portatambor | Bimestral / trimestral | Drive: Investigación mercado | EST | Consumo supuesto (10 mL/m²) + llenado inicial de cubas: pedir al proveedor del túnel. | Químicos pretratamiento | 220
MP-30 | Fosfatizante (fosfato de hierro) | Fosfato de hierro microcristalino | Túnel de pretratamiento (S2) | Henkel / Chemetall | Sin cotizar | Bidón 20–25 L o tambor 200 L | L | Tambor 200 L | 200 | 240 | 356.4430542 | 42.7731665 | 2.1 | 10 | 60 | 200 | 1 | 1.8 | 93.51657423 | 20 | 242.7731665 | 2 | 0.48 | Batea antiderrame (tambores/bidones) | 4 | 0 | 1 | 2.5 | Depósito de químicos y agentes líquidos (con batea) | Autoelevador 2,5 t en muelle / playón (o transpaleta si hay muelle a nivel de caja) | Carro portatambor | Bimestral / trimestral | Drive: Investigación mercado | EST | Ídem MP-29 | Químicos pretratamiento | 240
MP-31 | Pintura en polvo poliéster RAL 3000 (rojo) | Poliéster termofijo exterior, RAL 3000, curado 180–200 °C, 60–80 µm | Línea de pintura E-20 (1–10 kg; carros tercerizados) | Sinteplast Industria / Tersuave (nacionales); AkzoNobel, Sherwin (importados) | Sin cotizar (mail enviado a Sinteplast) | Caja de 20 kg con bolsa PE interior | kg | Pallet 30 cajas = 600 kg (EST) | 600 | 620 | 4990.202758 | 598.824331 | 29.9 | 10 | 20 | 600 | 1 | 8.3 | 20.03926591 | 10 | 899.4121655 | 2 | 1.24 | Rack selectivo 3 niveles | 1 | 0 | 2 | 2.6 | Depósito de pintura en polvo (junto a S2) | Autoelevador 2,5 t en muelle / playón (o transpaleta si hay muelle a nivel de caja) | Transpaleta → cabina | Mensual | Web: caja 20 kg (Sinteplast/Tersuave); rendimiento 1000/(ρ·e), pinturaenpolvo.org. Drive: mails Sinteplast | WEB + EST | El BOM (0,04–0,10 kg/u) es ≈3× el consumo teórico; se usó el cálculo por área. Depósito fresco (<30 °C) y seco. | Pintura | 620
MP-32 | Tapones de enmascarado (silicona) para rosca | Tapón cónico de silicona 250 °C | Protección de rosca en granallado y pintura | Distribuidores de enmascarado | Sin cotizar | Bolsa × 100 | u | Caja 500 u | 500 | 5 | 5684.66 | 682.1592 | 34.1 | 10 | 60 | 2046.4776 | 5 | 2.3 | 73.29667327 | 20 | 3182.1592 | 7 | 0.04 | Estantería pañol (metro lineal) | 4 | 0 | 2 | 2.4 | Pañol de insumos pesados (junto a AL-1 / P1) | Transpaleta manual / a mano (bultos chicos) | Pañol → línea de pintura | Trimestral | EST | EST | — | Pintura | 25
MP-33 | Polvo químico ABC (MAP ≥55 %, IRAM 3569) | Fosfato monoamónico ≥55 %, siliconado, humedad <0,25 %, IRAM 3569 | Carga E-21 (fabricación) y R-03 (recargas) | Polvex (principal) / DEMSA (2.ª fuente) / Sancibrao | ABC 55: $3.450/kg en bolsa de 25 kg; −10 % por más de 1.000 kg (lista de precios del Drive). El modelo usa $3.500/kg | Bolsa 25 kg doble PE; pallet con film. DEMSA: big bag 1.000 kg | kg | Big bag 1.000 kg (o pallet 40 bolsas) | 1000 | 1010 | 403509.98 | 48421.1976 | 2421.1 | 7 | 5 | 12105.2994 | 13 | 31.0 | 5.369549141 | 10 | 37210.5988 | 38 | 38.38 | Piso big bag apilado 2 | 2 | 0 | 19 | 20.5 | Depósito de polvo químico (seco) | Autoelevador 2,5 t en muelle / playón (o transpaleta si hay muelle a nivel de caja) | Autoelevador → estación de descarga de big bag sobre la tolva E-21 (polipasto 2 t); bolsas a la sala de polvo | Semanal (≈1 camión de 10–13 t en 2035) | Drive: lista de precios (bolsa 25 kg); BOM (SS ≈10 días). Web: DEMSA ABC 55 bolsa 25 kg y big bag 1.000 kg | COTIZ + WEB + EST | El % de polvo nuevo en recargas (25 %) pesa ≈90 t/año. Confirmar si Polvex entrega en big bag. Con 25 kg por bolsa, manipular a mano ~100 bolsas por día no es aceptable (ergonomía). | Polvo (Polvex/DEMSA) | 13130
MP-34 | Nitrógeno seco (≥99,8 %, rocío ≤ −40 °C) | N₂ comprimido, punto de rocío ≤ −40 °C (IRAM: no se admite aire) | Presurización E-23 y recargas R-10 | Air Liquide | $1.800/m³ + $1.000/m³ acarreo + $50.000/mes alquiler de batería | Batería 11 × 50 L 200 bar (≈9,4 m³ c/u ⇒ ≈103 m³). Alternativa: bloque 16 × 50 L = 150 m³ | m³ | Batería ≈103 m³ | 103 | 1000 | 4730.379368 | 567.6455242 | 28.4 | 1 | 10 | 283.8227621 | 3 | 15.3 | 10.88707606 | 3 | 394.1468286 | 4 | 4.00 | Jaula de gases (baterías) | 1 | 2 | 6 | 11.9 | Jaula de gases (exterior, con acceso de camión) | Camión del proveedor con hidrogrúa (baterías en comodato); la jaula necesita acceso de camión | Fija: manifold N₂ (S3a) y sala de recargas | Quincenal | Drive: Cotizaciones de MP – wpp; Datos técnicos N₂ (50 L 200 bar = 9,4 m³) | DRIVE + EST | Drive: 300 m³/mes. Este cálculo da otro valor (ver Consumo Anual). Validar midiendo en una prueba de carga. | Air Liquide (gases) | 3000
MP-35 | Polvo químico BC (recargas) | Bicarbonato, IRAM 3569 | Recargas BC (equipo exclusivo FS-ZR01) | Polvex | $2.505/kg, bolsa 25 kg (lista de precios del Drive) | Bolsa 25 kg | kg | Bolsa 25 kg | 25 | 25 | 206.25 | 24.75 | 1.2 | 7 | 60 | 74.25 | 3 | 2.8 | 60.60606061 | 20 | 99.75 | 4 | 0.10 | Rack selectivo 3 niveles | 40 | 0 | 1 | 1.3 | Depósito de polvo químico (seco) | Transpaleta manual / a mano (bultos chicos) | Sala de polvo, separado del ABC (no mezclar) | Trimestral / semestral | Drive: lista de precios | COTIZ | — | Agentes para recargas | 75
MP-36 | Polvo clase D (recargas) | Polvo para metales combustibles | Recargas clase D (manual, embudo) | A definir | Sin cotizar | Bolsa/balde 25 kg (EST) | kg | Bolsa 25 kg | 25 | 25 | 450 | 54 | 2.7 | 15 | 120 | 324 | 13 | 1.4 | 120.3703704 | 20 | 379 | 16 | 0.40 | Rack selectivo 3 niveles | 40 | 0 | 1 | 1.3 | Depósito de polvo químico (seco) | Transpaleta manual / a mano (bultos chicos) | Sala de polvo (recipiente exclusivo) | Semestral | EST | EST | Tipo de polvo según el metal; carga por equipo supuesta 10 kg. | Agentes para recargas | 325
MP-37 | CO₂ líquido (recargas) | CO₂ grado industrial, cilindro con sifón | Trasvasador de CO₂ (recargas) | Air Liquide / Linde / Air Products | Sin cotizar (pedido en mail a Air Liquide) | Cilindro con tubo sifón de 25–30 kg; a granel: termo/tanque en comodato | kg | Cilindro 25 kg | 25 | 95 | 11114.18 | 1333.7016 | 66.7 | 2 | 10 | 666.8508 | 27 | 16.5 | 10.12220425 | 5 | 1008.4254 | 41 | 3.90 | Jaula de gases (cilindros sueltos) | 1 | 1 | 42 | 21.0 | Jaula de gases (exterior, con acceso de camión) | Camión del proveedor con hidrogrúa (baterías en comodato); la jaula necesita acceso de camión | Carro portacilindros → trasvasador | Quincenal | Drive: mails a Air Liquide; Parametros Recargas (35 % se vacían) | DRIVE + EST | Con ≈10 t/año conviene evaluar un termo de CO₂ a granel. | Air Liquide (gases) | 2565
MP-38 | Agente limpio HCFC/HFC (recargas) | HCFC-123 / HFC-236fa (IRAM 3526-1) | Recargas de agente limpio | A definir | Sin cotizar | Cilindro 50–100 kg | kg | Cilindro 50 kg | 50 | 110 | 801.15 | 96.138 | 4.8 | 30 | 60 | 288.414 | 6 | 2.7 | 62.41028522 | 20 | 396.138 | 8 | 0.88 | Jaula de gases (cilindros sueltos) | 1 | 1 | 9 | 4.5 | Jaula de gases (exterior, con acceso de camión) | Transpaleta manual / a mano (bultos chicos) | Carro portacilindros → recuperadora FS-FM2 | Semestral | Drive: mails (POLVEX/DEMSA) | EST | Tipo de agente y restricciones del Protocolo de Montreal para HCFC. | Agentes para recargas | 660
MP-39 | Argón (presurización de agente limpio) | Argón comprimido | Presurización de agente limpio | Air Liquide | Sin cotizar | Cilindro 50 L 200 bar (≈10 m³) | m³ | Cilindro ≈9,5 m³ | 9.5 | 75 | 3.052 | 0.36624 | 0.018312 | 2 | 120 | 9.5 | 1 | 0.3 | 518.7854958 | 20 | 9.86624 | 2 | 0.15 | Jaula de gases (cilindros sueltos) | 1 | 1 | 3 | 1.5 | Jaula de gases (exterior, con acceso de camión) | Camión del proveedor con hidrogrúa (baterías en comodato); la jaula necesita acceso de camión | Carro portacilindros | Anual (consumo muy bajo) | Drive: mails a Air Liquide | EST | — | Air Liquide (gases) | 75
MP-40 | Concentrado AFFF (recargas) | AFFF 3 % o 6 %, 0 °C | Recargas de espuma | Distribuidor de la lista / DEMSA | AFFF 6 %: USD 6,70/L; AFFF 3 %: USD 7,32/L (bidón 20 L) | Bidón 20 L; DEMSA también tambor 200 L e IBC 1.000 L | L | Bidón 20 L | 20 | 21 | 1191 | 142.92 | 7.1 | 7 | 60 | 428.76 | 22 | 2.7 | 61.57290792 | 20 | 582.92 | 30 | 0.63 | Batea antiderrame (tambores/bidones) | 24 | 0 | 2 | 5.1 | Depósito de químicos y agentes líquidos (con batea) | Transpaleta manual / a mano (bultos chicos) | Batea → estación de llenado FS-SJML01 | Trimestral | Drive: lista de precios. Web: DEMSA (bidón 20 L, tambor 200 L, IBC 1.000 L) | COTIZ + WEB | — | Agentes para recargas | 462
MP-41 | Solución clase K — acetato de potasio (recargas) | Acetato de potasio (IRAM 3697) | Recargas clase K | Distribuidor de la lista (Gastro K) | $4.468/L, bidones de 10, 20 y 30 L (lista de precios del Drive) | Bidón 10/20/30 L | L | Bidón 20 L | 20 | 26 | 8562 | 1027.44 | 51.4 | 7 | 20 | 1027.44 | 52 | 8.2 | 20.24449116 | 10 | 1553.72 | 78 | 2.03 | Batea antiderrame (tambores/bidones) | 24 | 0 | 4 | 10.1 | Depósito de químicos y agentes líquidos (con batea) | Transpaleta manual / a mano (bultos chicos) | Batea → llenado de líquidos | Mensual | Drive: lista de precios | COTIZ + EST | Supuesto: se reemplaza el 100 % de la carga en cada recarga. | Agentes para recargas | 1352
MP-42 | Válvula M-22 para 1 kg con tubo de pesca | Latón, rosca M22, con tubo de pesca plástico y O-ring nitrilo | Ensamblaje E-22 (1 kg) | HZ Firetec (vía distribuidor) / Georgia / Mozart / importación China | $4.200 c/u (lista de precios del Drive, marca HZ) | Caja de cartón × 100 u (EST) | u | Pallet 30 cajas = 3.000 u (EST) | 3000 | 600 | 34089.18 | 4090.7016 | 204.5 | 20 | 20 | 4090.7016 | 2 | 5.7 | 29.3348212 | 15 | 9068.0262 | 4 | 2.40 | Rack selectivo 3 niveles | 1 | 0 | 4 | 5.2 | Depósito de insumos de terminación y embalaje (junto a S3a / AL-3) | Autoelevador 2,5 t en muelle / playón (o transpaleta si hay muelle a nivel de caja) | Transpaleta → bancos E-22 | Mensual | Drive: lista de precios (HZ) | COTIZ | Si se importa: lead time 75–95 días ⇒ ≈4 meses de stock (BOM del Drive). | Válvulas y componentes | 1200
MP-43 | Válvula M-30 con resorte para 2,5–10 kg | Latón forjado M30 × 1,5, palanca de acero, O-ring N70, tubo 7/8" | Ensamblaje E-22 | HZ Firetec / Georgia / Mozart / China | $6.800 c/u (lista de precios del Drive, marca HZ) | Caja de cartón × 50 u (EST) | u | Pallet 30 cajas = 1.500 u (EST) | 1500 | 525 | 41451.78 | 4974.2136 | 248.7 | 20 | 20 | 4974.2136 | 4 | 6.9 | 24.12441637 | 15 | 9730.6602 | 7 | 3.67 | Rack selectivo 3 niveles | 1 | 0 | 7 | 9.1 | Depósito de insumos de terminación y embalaje (junto a S3a / AL-3) | Autoelevador 2,5 t en muelle / playón (o transpaleta si hay muelle a nivel de caja) | Transpaleta → E-22 | Mensual | Drive: lista de precios; Investigación mercado | COTIZ | Ítem crítico (Kraljic). Mozart es a la vez proveedor y competidor: mantener 2.ª fuente. | Válvulas y componentes | 2100
MP-44 | Válvula para carro 25–100 kg (con traba, manija y resorte) | Válvula de carro 7/8" (25 kg) / 50–100 kg | Armado de carros | HZ Firetec / Georgia | $7.500 c/u (lista de precios del Drive) | Caja × 10 u (EST) | u | Caja 10 u | 10 | 12 | 1864.42 | 223.7304 | 11.2 | 20 | 20 | 223.7304 | 23 | 8.1 | 20.56046027 | 10 | 341.8652 | 35 | 0.42 | Rack selectivo 3 niveles | 20 | 0 | 2 | 2.6 | Depósito de insumos de terminación y embalaje (junto a S3a / AL-3) | Transpaleta manual / a mano (bultos chicos) | Carro → armado de carros | Bimestral | Drive: lista de precios | COTIZ | — | Válvulas y componentes | 276
MP-45 | Manómetro IRAM 3533 (1,4 MPa) | Latón + inoxidable, visor plástico, zona verde 1,4 MPa, IRAM 3533 | Ensamblaje E-22 / recargas | Georgia / Securitá / Maxiseguridad; importación Anke, Safefire | Sin cotizar | Caja × 100 u | u | Caja 100 u | 100 | 8 | 83242.68 | 9989.1216 | 499.5 | 20 | 20 | 9989.1216 | 100 | 8.3 | 20.02178049 | 15 | 17491.8412 | 175 | 1.40 | Rack selectivo 3 niveles | 30 | 0 | 6 | 7.8 | Depósito de insumos de terminación y embalaje (junto a S3a / AL-3) | Autoelevador 2,5 t en muelle / playón (o transpaleta si hay muelle a nivel de caja) | Transpaleta → E-22 | Mensual | Drive: Investigación mercado | EST | 'Materiales y útiles' dice que la válvula llega pre-armada con manómetro y pescante; la lista HZ no lo aclara. Confirmar. | Válvulas y componentes | 800
MP-46 | Tubo pescante PP/PEAD (2,5–10 kg) | PP homopolímero, cortado a medida (alto interior − 5 mm) | Ensamblaje E-22 | Mozart / Securitá / LACAR / China | Sin cotizar | Caja × 200 u | u | Caja 200 u | 200 | 6 | 41451.78 | 4974.2136 | 248.7 | 15 | 20 | 4974.2136 | 25 | 8.3 | 20.10368031 | 10 | 7487.1068 | 38 | 0.23 | Rack selectivo 3 niveles | 30 | 0 | 2 | 2.6 | Depósito de insumos de terminación y embalaje (junto a S3a / AL-3) | Transpaleta manual / a mano (bultos chicos) | E-22 | Mensual | Drive: BOM / Investigación mercado | EST | — | Válvulas y componentes | 150
MP-47 | Tubo pescante de acero (carros) | Tubo acero SAE 1010 a medida | Armado de carros | Georgia / Securitá / metalúrgica | Sin cotizar | Atado/caja × 20 u | u | Caja 20 u | 20 | 30 | 1864.42 | 223.7304 | 11.2 | 15 | 20 | 223.7304 | 12 | 7.8 | 21.45439332 | 10 | 351.8652 | 18 | 0.54 | Rack selectivo 3 niveles | 10 | 0 | 2 | 2.6 | Depósito de insumos de terminación y embalaje (junto a S3a / AL-3) | Transpaleta manual / a mano (bultos chicos) | Armado de carros | Bimestral | Drive: Investigación mercado | EST | — | Válvulas y componentes | 360
MP-48 | Manguera + tobera (2,5–10 kg) | EPDM/NBR con trenzado, ≥400 mm, 25 bar de trabajo | Ensamblaje E-22 | Mozart / Fonseca / China | Sin cotizar (catálogo pedido a HZ) | Caja × 50 u | u | Caja 50 u | 50 | 10 | 42938 | 5152.56 | 257.6 | 15 | 20 | 5152.56 | 104 | 8.3 | 20.18414148 | 10 | 7776.28 | 156 | 1.56 | Rack selectivo 3 niveles | 30 | 0 | 6 | 7.8 | Depósito de insumos de terminación y embalaje (junto a S3a / AL-3) | Transpaleta manual / a mano (bultos chicos) | E-22 | Mensual | Drive: BOM / mail HZ Firetec | EST | — | Válvulas y componentes | 1040
MP-49 | Manguera + lanza/pistola para carro | Manguera armada 5 m + lanza con gatillo | Armado de carros | Georgia / Securitá / China | Sin cotizar | Caja × 10 u | u | Caja 10 u | 10 | 15 | 1898.7 | 227.844 | 11.4 | 15 | 20 | 227.844 | 23 | 8.3 | 20.1892523 | 10 | 343.922 | 35 | 0.53 | Rack selectivo 3 niveles | 12 | 0 | 3 | 3.9 | Depósito de insumos de terminación y embalaje (junto a S3a / AL-3) | Transpaleta manual / a mano (bultos chicos) | Armado de carros | Bimestral | Drive: Investigación mercado | EST | — | Válvulas y componentes | 345
MP-50 | O-ring NBR 70 | NBR 70 Shore A, medida según válvula | Ensamblaje y recargas | Gasket Argentina / O-Ring Argentina / Securitá | Sin cotizar | Bolsa × 1.000 u | u | Bolsa 1.000 u | 1000 | 1 | 388342 | 46601.04 | 2330.1 | 10 | 20 | 46601.04 | 47 | 8.3 | 20.17122365 | 10 | 70300.52 | 71 | 0.07 | Estantería pañol (metro lineal) | 20 | 0 | 4 | 4.8 | Depósito de insumos de terminación y embalaje (junto a S3a / AL-3) | Transpaleta manual / a mano (bultos chicos) | Pañol de terminación | Mensual | Drive: BOM | EST | — | Válvulas y componentes | 47
MP-51 | Pasador + precinto de seguridad numerado | Pasador AISI 304 + precinto plástico numerado | Ensamblaje y recargas | Securitá / Intermet / HZ | Sin cotizar (pedido a HZ) | Bolsa × 1.000 u | u | Bolsa 1.000 u | 1000 | 3 | 201243 | 24149.16 | 1207.5 | 10 | 20 | 24149.16 | 25 | 8.0 | 20.70465391 | 10 | 37074.58 | 38 | 0.11 | Estantería pañol (metro lineal) | 20 | 0 | 2 | 2.4 | Depósito de insumos de terminación y embalaje (junto a S3a / AL-3) | Transpaleta manual / a mano (bultos chicos) | Pañol de terminación | Mensual | Drive: BOM; mail HZ | EST | — | Válvulas y componentes | 75
MP-52 | Soporte de pared (1–10 kg) | Acero estampado galvanizado o PP, con tornillo y taco | Se entrega con el matafuego | Local / China / HZ | Sin cotizar (pedido a HZ) | Caja × 100 u | u | Caja 100 u | 100 | 20 | 72090 | 8650.8 | 432.5 | 15 | 20 | 8650.8 | 87 | 8.3 | 20.11374671 | 10 | 13025.4 | 131 | 2.62 | Rack selectivo 3 niveles | 30 | 0 | 5 | 6.5 | Depósito de insumos de terminación y embalaje (junto a S3a / AL-3) | Transpaleta manual / a mano (bultos chicos) | Encajonado E-25 | Mensual | Drive: BOM; mail HZ | EST | — | Válvulas y componentes | 1740
MP-53 | Estructura de carro (chasis, eje, manija, ganchos) | Chasis soldado, CHAS Res. 91/2001 | Armado de carros (S1b) | Metalúrgica a medida (comprada armada) | Sin cotizar | Estructuras apiladas en pallet | u | Pallet 20 u (EST) | 20 | 500 | 1813 | 217.56 | 10.9 | 20 | 10 | 108.78 | 6 | 15.1 | 11.0314396 | 5 | 174.39 | 9 | 4.50 | Piso apilado 2 alturas (paquetes/pallets) | 2 | 0 | 5 | 4.5 | AL-1 Acero (junto a P1) | Autoelevador 2,5 t en muelle / playón (o transpaleta si hay muelle a nivel de caja) | Autoelevador → S1b | Bimestral | Drive: Investigación mercado | EST | — | Carros (estructura y ruedas) | 3000
MP-54 | Ruedas de carro (par) Ø300–500 mm | Chapa + goma, trocha 400–520 mm | Armado de carros | Ruedar (fábrica nacional) / Arda | Sin cotizar | Pallet × 36 pares (EST) | par | Pallet 36 pares | 36 | 360 | 1813 | 217.56 | 10.9 | 15 | 20 | 217.56 | 7 | 7.2 | 23.16602317 | 10 | 360.78 | 11 | 3.96 | Piso apilado 2 alturas (paquetes/pallets) | 2 | 0 | 6 | 5.4 | AL-1 Acero (junto a P1) | Autoelevador 2,5 t en muelle / playón (o transpaleta si hay muelle a nivel de caja) | Autoelevador → S1b | Bimestral | Drive: Investigación mercado | EST | — | Carros (estructura y ruedas) | 2520
MP-55 | Conjunto de seguridad CO₂ (IRAM 2736) | Disco de ruptura / conjunto de seguridad | Recargas de CO₂ | Georgia / HZ | Sin cotizar | Bolsa × 100 u | u | Bolsa 100 u | 100 | 2 | 3655.4 | 438.648 | 21.9 | 15 | 60 | 1315.944 | 14 | 2.6 | 63.83250351 | 20 | 1838.648 | 19 | 0.04 | Estantería pañol (metro lineal) | 20 | 0 | 1 | 1.2 | Depósito de insumos de terminación y embalaje (junto a S3a / AL-3) | Transpaleta manual / a mano (bultos chicos) | Recargas | Trimestral | Drive: Notas (IRAM 2736, reemplazo en cada vaciado) | DRIVE | — | Válvulas y componentes | 28
MP-56 | Oblea/etiqueta IRAM 3534 + calcos + QR (fabricación) | Autoadhesivo PP/vinilo UV, datos IRAM obligatorios | Etiquetado E-24 | Imprenta de autoadhesivos industriales | Sin cotizar | Rollo × 1.000 etiquetas | u | Rollo 1.000 u | 1000 | 1.5 | 73903 | 8868.36 | 443.4 | 10 | 20 | 8868.36 | 9 | 8.2 | 20.29687563 | 10 | 13434.18 | 14 | 0.02 | Estantería pañol (metro lineal) | 20 | 0 | 1 | 1.2 | Depósito de insumos de terminación y embalaje (junto a S3a / AL-3) | Transpaleta manual / a mano (bultos chicos) | E-24 | Mensual | Drive: BOM / Investigación mercado | EST | — | Imprenta (etiquetas) | 13.5
MP-57 | Marbete/oblea de mantenimiento IRAM 3517-2 (recargas) | Oblea de mantenimiento + marbete | Recargas R-17 | Imprenta | Sin cotizar (pedido a HZ) | Rollo/paquete × 1.000 | u | Paquete 1.000 u | 1000 | 1.5 | 127340 | 15280.8 | 764.0 | 10 | 20 | 15280.8 | 16 | 8.0 | 20.94131197 | 10 | 23640.4 | 24 | 0.04 | Estantería pañol (metro lineal) | 20 | 0 | 2 | 2.4 | Depósito de insumos de terminación y embalaje (junto a S3a / AL-3) | Transpaleta manual / a mano (bultos chicos) | Recargas | Mensual | Drive: Parametros Recargas (etiquetado 100 %) | EST | — | Imprenta (etiquetas) | 24
MP-58 | Tarjeta de control / mantenimiento | Cartulina plastificada / PVC | Terminados y recargas | Imprenta | Sin cotizar | Paquete × 500 | u | Paquete 500 u | 500 | 2 | 201243 | 24149.16 | 1207.5 | 10 | 20 | 24149.16 | 49 | 8.2 | 20.29056083 | 10 | 36574.58 | 74 | 0.15 | Estantería pañol (metro lineal) | 20 | 0 | 4 | 4.8 | Depósito de insumos de terminación y embalaje (junto a S3a / AL-3) | Transpaleta manual / a mano (bultos chicos) | E-24 / recargas | Mensual | Drive: BOM | EST | — | Imprenta (etiquetas) | 98
MP-59 | Caja de cartón corrugado (individual 2,5–10 kg; × 6 para 1 kg) | Corrugado doble canal, impresa 1 color | Encajonado E-25 | Smurfit Kappa / Cartocor / Zucamor | $1.500 por caja 2,5–10 kg (Evaluación económica del Dimensionamiento) | Plegadas en fardos de 25, sobre pallet | u | Pallet ≈600 cajas plegadas (EST) | 600 | 250 | 45362.5 | 5443.5 | 272.2 | 10 | 10 | 2721.75 | 5 | 15.1 | 11.0223202 | 5 | 4360.875 | 8 | 2.00 | Rack selectivo 3 niveles | 1 | 0 | 8 | 10.4 | Depósito de insumos de terminación y embalaje (junto a S3a / AL-3) | Autoelevador 2,5 t en muelle / playón (o transpaleta si hay muelle a nivel de caja) | Transpaleta → E-25 | Quincenal (voluminoso) | Drive: Evaluación económica; ET's Matafuegos | EST | Las medidas de caja de ET's son menores que el Ø del matafuego (ver Pallets PT y Dudas). | Embalaje | 1250
MP-60 | Pallet ARLOG 1200 × 1000 (despacho de PT) | IRAM 10016, 1200 × 1000 × 145 mm, 35 kg | Despacho de terminados y cilindros | Palletec / Intrapal / Samer | Sin cotizar | Pila de 15 pallets | u | Pila 15 u | 15 | 525 | 1201.525786 | 144.1830943 | 7.2 | 5 | 10 | 72.09154716 | 5 | 16.0 | 10.40343882 | 5 | 111.0457736 | 8 | 4.20 | Piso pila de pallets vacíos | 1 | 0 | 8 | 14.4 | Depósito de insumos de terminación y embalaje (junto a S3a / AL-3) | Autoelevador 2,5 t en muelle / playón (o transpaleta si hay muelle a nivel de caja) | Autoelevador → envolvedora E-26 | Quincenal | Web: Pallet ARLOG IRAM 10016 (2.000 kg dinámica / 4.000 estática / 1.500 en rack; 35 kg) | WEB + EST | — | Pallets | 2625
MP-61 | Separador de capa (cartón) para pallets de cilindros | Plancha de cartón 1200 × 1000 | Palletizado de cilindros vendidos | Cartocor / Smurfit | Sin cotizar | Pallet × 500 planchas | u | Pallet 500 u | 500 | 300 | 2637.758295 | 316.5309954 | 15.8 | 10 | 20 | 500 | 1 | 5.3 | 31.59248271 | 10 | 658.2654977 | 2 | 0.60 | Rack selectivo 3 niveles | 1 | 0 | 2 | 2.6 | Depósito de insumos de terminación y embalaje (junto a S3a / AL-3) | Autoelevador 2,5 t en muelle / playón (o transpaleta si hay muelle a nivel de caja) | Terminación de cilindros (E-28) | Mensual | EST | EST | — | Embalaje | 300
MP-62 | Tapón protector de rosca (cilindros vendidos) | Tapón plástico M22 / M30 / 2½" | Protección de rosca (E-28) | Inyectora local | Sin cotizar | Bolsa × 1.000 | u | Caja 5.000 u | 5000 | 25 | 213430 | 25611.6 | 1280.6 | 10 | 20 | 25611.6 | 6 | 7.1 | 23.42688469 | 10 | 42805.8 | 9 | 0.23 | Rack selectivo 3 niveles | 8 | 0 | 2 | 2.6 | Depósito de insumos de terminación y embalaje (junto a S3a / AL-3) | Transpaleta manual / a mano (bultos chicos) | E-28 | Mensual | Layout v3 (E-28 banco de protección de rosca) | EST | — | Embalaje | 150
MP-63 | Film stretch 500 mm (bobina ≈16 kg) | Film stretch 500 mm × 23 µm; bobina Ø ≤250 mm (recubridor EDOS) | Envolvedora E-26 | Distribuidor de embalaje | Sin cotizar | Bobina ≈16 kg | kg | Bobina 16 kg | 16 | 16 | 420.5340251 | 50.46408301 | 2.5 | 5 | 20 | 50.46408301 | 4 | 6.6 | 25.36457464 | 10 | 89.23204151 | 6 | 0.10 | Rack selectivo 3 niveles | 50 | 0 | 1 | 1.3 | Depósito de insumos de terminación y embalaje (junto a S3a / AL-3) | Transpaleta manual / a mano (bultos chicos) | E-26 | Mensual | Drive: mail EDOS (bobina 500 mm, Ø máx. 250 mm) | COTIZ + EST | — | Embalaje | 64
MP-64 | Esquineros de cartón | Esquinero de cartón 50 × 50 × 1.200 mm | Palletizado | Cartocor / Smurfit | Sin cotizar | Paquete × 100 | u | Paquete 100 u | 100 | 15 | 4806.103144 | 576.7323773 | 28.8 | 10 | 20 | 576.7323773 | 6 | 8.0 | 20.80687763 | 10 | 888.3661886 | 9 | 0.14 | Rack selectivo 3 niveles | 20 | 0 | 1 | 1.3 | Depósito de insumos de terminación y embalaje (junto a S3a / AL-3) | Transpaleta manual / a mano (bultos chicos) | E-26 | Mensual | EST | EST | — | Embalaje | 90
MP-65 | Pintura de retoque (esmalte rojo) — recargas | Esmalte sintético rojo RAL 3000 | Cabina de retoque de recargas | Sinteplast / Tersuave | Sin cotizar | Lata 4 L | L | Lata 4 L | 4 | 5 | 955.05 | 114.606 | 5.7 | 5 | 20 | 114.606 | 29 | 8.2 | 20.24326824 | 10 | 173.303 | 44 | 0.22 | Estantería pañol (metro lineal) | 50 | 0 | 1 | 1.2 | Depósito de químicos y agentes líquidos (con batea) | Transpaleta manual / a mano (bultos chicos) | Recargas | Trimestral | Drive: Parametros Recargas (15 % con pintura deteriorada) | DRIVE + EST | — | Pintura | 145
TOTAL |  |  |  |  |  |  |  |  |  |  |  |  |  |  |  |  |  | 559.9580414 |  |  |  |  | 187.6 |  |  |  | 279 | 377.0186417

Sheet: Almacen MP
ALMACENAMIENTO DE MATERIAS PRIMAS: SUPERFICIE, UBICACIÓN Y REGLAS
Posiciones y m² salen de MP Abastecimiento (stock máximo 2035). m² por posición según tipo de almacenamiento (incluye pasillos).
1. SUPERFICIE POR POSICIÓN SEGÚN TIPO DE ALMACENAMIENTO
Rack: ancho de módulo (m) | 2.3 | Rack: pallets por nivel | 2 | Rack: profundidad (m) | 1.2 | Pasillo autoelevador (m) | 3.5
Tipo de almacenamiento | Descripción / regla | Huella por posición incl. ½ pasillo (m²) | Niveles / alturas | Factor de circulación | m² por posición | Condiciones
Rack selectivo 3 niveles | Rack selectivo de 3 niveles (piso + 2), pallets ≤1.000 kg; vigas para 2 pallets | 3.39 | 3 | 1.15 | 1.30 | Carga ≤1.500 kg por posición (ARLOG). Chapas de pie o rollos: NO en rack sin decking.
Piso apilado 2 alturas (paquetes/pallets) | Paquetes de chapa / pallets apilados de a 2 con tacos de madera | 1.20 | 2 | 1.50 | 0.90 | Paquetes planos y estables, peso ≤1,5 t, identificados por formato; FIFO por fila.
Piso 1 altura (rollos de fleje) | Rollos de fleje parados (ojo vertical) sobre cama de madera, 1 altura | 1.00 | 1 | 1.60 | 1.60 | No apilar rollos. Calzas si se acuestan. Acceso con autoelevador con espolón o gancho C.
Piso big bag apilado 2 | Big bags de 1 t apilados de a 2 (si el big bag es apilable) | 1.44 | 2 | 1.50 | 1.08 | Área seca (HR ≤70 %, como la sala de polvo del layout), sobre pallet, lejos de la prueba hidráulica.
Cantiléver (atados 6 m) | Rack cantiléver de brazos para atados de 6 m (12 atados por módulo 7 × 2,4 m + 1 m libre por lado) | 2.57 | 1 | 1.00 | 2.57 | Acceso con autoelevador con prolongaciones. Atados identificados por medida.
Jaula de gases (baterías) | Baterías / bloques de cilindros en jaula ventilada | 0.99 | 1 | 2.00 | 1.98 | Exterior o local ventilado, piso firme, cadenas, lejos de fuentes de calor; + 2 posiciones (en uso y vacía).
Jaula de gases (cilindros sueltos) | Cilindros sueltos encadenados en jaula | 0.25 | 1 | 2.00 | 0.50 | Separar llenos y vacíos; CO₂ a la sombra.
Batea antiderrame (tambores/bidones) | Tambores / bidones sobre batea antiderrame | 1.69 | 1 | 1.50 | 2.54 | Batea ≥110 % del mayor envase; kit de derrames; separado de oxidantes (Ley 11.720).
Estantería pañol (metro lineal) | Estantería de pañol (posición = metro lineal, 5 estantes) | 0.60 | 1 | 2.00 | 1.20 | Pañol cerrado, entrega contra vale; FIFO.
Piso pila de pallets vacíos | Pila de 15 pallets vacíos (≈2,2 m) | 1.20 | 1 | 1.50 | 1.80 | Lejos de la envolvedora y de rutas de evacuación.
Piso paquetes de hoja estándar (2 alturas) | Paquetes de hojas 1000×2000 / 1220×2440 / 1500×3000 apilados de a 2 sobre tacos, un formato y espesor por fila | según formato: (ancho + 0,3) × (largo + 0,3) | 2 | 1.50 | ver MP Abastecimiento col. AC | Paquetes ≤2 t. Acceso con autoelevador por el lado corto (prolongaciones de horquilla). Opción D.
2. REQUERIMIENTO POR ZONA (stock máximo 2035)
Zona | Posiciones requeridas | m² requeridos (incl. pasillos) | Peso de stock máx. (t) | Superficie en el layout v3 (m²) | Diferencia (m²) | Comentario
AL-1 Acero (junto a P1) | 81 | 148.3061 | 96.9 | 116 | -32.3061 | AL-1 = 9,6 × 20 m = 192 m² brutos − pasillo (≈59 m²) = 133 m² netos, de los que ≈17 m² son big bags de polvo ⇒ ≈116 m² para acero. Opción D: paquetes de hoja por formato (hasta 1,5 × 3 m), rollos de fleje y atados de caño; se opera con autoelevador (sin puente grúa).
Pañol de insumos pesados (junto a AL-1 / P1) | 28 | 35.20733333 | 13.9 | 0 | -35.20733333 | No existe: hoy el pañol + mantenimiento (≈50 m²) está en N5, en la esquina NE, lejos de P1. Ver sección 4.
Depósito de polvo químico (seco) | 21 | 23.12091667 | 38.9 | 17 | -6.120916667 | Layout v3: 12 posiciones de big bag × 2 alturas dentro de AL-1 (≈17 m²) + 1 big bag en S3a.
Depósito de insumos de terminación y embalaje (junto a S3a / AL-3) | 73 | 97.523375 | 21.1 | 1 | -96.523375 | No existe como almacén (el archivo de layout tenía un AL-2 de 90 m² que no se dibujó). Solo 'AL-6 pallets vacíos'.
Jaula de gases (exterior, con acceso de camión) | 65 | 48.78 | 11.9 | 16 | -32.78 | Jaula de gases de soldadura 4 × 4 m (norte) + manifold N₂ en S3a.
Depósito de químicos y agentes líquidos (con batea) | 9 | 21.48 | 3.8 | 0 | -21.48 | No dibujado.
Depósito de pintura en polvo (junto a S2) | 2 | 2.600916667 | 1.2 | 0 | -2.600916667 | No dibujado (cajas de pintura junto a la cabina).
TOTAL MATERIAS PRIMAS | 279 | 377.0186417 | 187.64379 | 150 | -227.0186417
3. POSICIONES POR TIPO DE ALMACENAMIENTO
Tipo | Posiciones | m²
Rack selectivo 3 niveles | 71 | 92.33254167
Piso apilado 2 alturas (paquetes/pallets) | 27 | 24.3
Piso 1 altura (rollos de fleje) | 27 | 43.2
Piso big bag apilado 2 | 19 | 20.52
Cantiléver (atados 6 m) | 12 | 30.8
Jaula de gases (baterías) | 11 | 21.78
Jaula de gases (cilindros sueltos) | 54 | 27
Batea antiderrame (tambores/bidones) | 8 | 20.28
Estantería pañol (metro lineal) | 27 | 32.4
Piso pila de pallets vacíos | 8 | 14.4
Piso paquetes de hoja estándar (2 alturas) | 15 | 50.0061
4. UBICACIÓN RECOMENDADA (para debatir; no se modificó el plano)
• PAÑOL DE INSUMOS PESADOS pegado a AL-1 y al portón P1 (recomendación de la cátedra): alambre MIG (pallets de carretes de 15 kg o tambores de 250 kg), granalla, asientos de válvula y cuplas, tapones y consumibles. Se descarga con el mismo autoelevador que la chapa y se reparte con carros a N1–N3.
• PAÑOL DE HERRAMIENTAS Y MANTENIMIENTO: puede quedar en N5 (liviano, contra vale). Hoy concentra todo y queda a ~75 m de P1, en la esquina opuesta.
• DEPÓSITO DE INSUMOS DE TERMINACIÓN (válvulas, manómetros, pescantes, mangueras, cajas, etiquetas, film, separadores, pallets): junto a S3a/AL-3, con acceso por los muelles M1–M2 (también es ingreso de camiones). Hoy no está dibujado.
• POLVO QUÍMICO: seco (HR ≤70 %), en big bags junto a P1 (como hoy) y con un buffer al pie de E-21 y en la sala de polvo. Recomendación: estación de descarga de big bag con polipasto sobre la tolva E-21. Con ~2 t/día en 2035, manipular bolsas de 25 kg a mano no es aceptable.
• GASES: la jaula de Ar/CO₂ al norte está bien (acceso por el camino de servicio). Sumar posiciones para N₂ (junto al manifold de S3a) y CO₂/argón de recargas.
• QUÍMICOS Y AGENTES LÍQUIDOS: depósito con batea junto al túnel de pretratamiento (S2) y otro chico en recargas (AFFF, clase K).
• PINTURA EN POLVO: depósito cerrado, fresco (<30 °C) y lejos de chispas, junto a la cabina.
• SCRAP: contenedor en N2 → montacargas → portón P2 → volquetes (layout v3 ✓). Coincide con la cátedra: el chatarrero no entra a la planta.
5. RECEPCIONES DE MP (2035)
Grupo de entrega (proveedor) | Entregas por año | Entregas por semana | Carga por entrega (t) | Comentario
Metalprisa (caño) | 28.9 | 0.60 | 4.2 | Se supone que los ítems del grupo llegan juntos, con la frecuencia del ítem más frecuente
Pradecon (hojas + fleje 0,9) | 18.1 | 0.38 | 35.3 | Se supone que los ítems del grupo llegan juntos, con la frecuencia del ítem más frecuente
Casquetes (tercerizado) | 4.1 | 0.09 | 5.9 | Se supone que los ítems del grupo llegan juntos, con la frecuencia del ítem más frecuente
Eli-Met (cuplas/asientos) | 5.6 | 0.12 | 3.7 | Se supone que los ítems del grupo llegan juntos, con la frecuencia del ítem más frecuente
Aceros (varilla) | 2.3 | 0.05 | 0.4 | Se supone que los ítems del grupo llegan juntos, con la frecuencia del ítem más frecuente
Soldadura (alambre y consumibles) | 8.1 | 0.17 | 1.9 | Se supone que los ítems del grupo llegan juntos, con la frecuencia del ítem más frecuente
Air Liquide (gases) | 31.3 | 0.65 | 7.6 | Se supone que los ítems del grupo llegan juntos, con la frecuencia del ítem más frecuente
CYM (granalla) | 2.0 | 0.04 | 3.1 | Se supone que los ítems del grupo llegan juntos, con la frecuencia del ítem más frecuente
Químicos pretratamiento | 1.8 | 0.04 | 0.5 | Se supone que los ítems del grupo llegan juntos, con la frecuencia del ítem más frecuente
Pintura | 8.3 | 0.17 | 0.8 | Se supone que los ítems del grupo llegan juntos, con la frecuencia del ítem más frecuente
Polvo (Polvex/DEMSA) | 31.0 | 0.65 | 13.1 | Se supone que los ítems del grupo llegan juntos, con la frecuencia del ítem más frecuente
Agentes para recargas | 8.2 | 0.17 | 2.9 | Se supone que los ítems del grupo llegan juntos, con la frecuencia del ítem más frecuente
Válvulas y componentes | 8.3 | 0.17 | 8.2 | Se supone que los ítems del grupo llegan juntos, con la frecuencia del ítem más frecuente
Carros (estructura y ruedas) | 15.1 | 0.31 | 5.5 | Se supone que los ítems del grupo llegan juntos, con la frecuencia del ítem más frecuente
Imprenta (etiquetas) | 8.2 | 0.17 | 0.1 | Se supone que los ítems del grupo llegan juntos, con la frecuencia del ítem más frecuente
Embalaje | 15.1 | 0.32 | 1.9 | Se supone que los ítems del grupo llegan juntos, con la frecuencia del ítem más frecuente
Pallets | 16.0 | 0.33 | 2.6 | Se supone que los ítems del grupo llegan juntos, con la frecuencia del ítem más frecuente
Pacheco (flejes) | 29.3 | 0.61 | 5.0 | Se supone que los ítems del grupo llegan juntos, con la frecuencia del ítem más frecuente
TOTAL | 241.9069912 | 5.0
6. SCRAP GENERADO (2035) — sale por el portón P2
Origen | t/año | Criterio
Esqueleto de fleje (discos de cúpula y fondo) | 38.7 | Bruto − neto por recipiente × recipientes
Orillas de hoja en la guillotina propia (opción D) | 22.9 | Masa bruta de hoja por cuerpo − masa neta (Geometria filas 87–90)
Despunte de caño (1 kg) | 2.7 | Masa bruta − neta del cuerpo 1 kg
Rechazos (1 % de la masa de recipientes) | 4.6 | EST
TOTAL scrap ferroso | 68.8
Volquetes de 6 m³ por mes (densidad aparente ≈0,8 t/m³, mes pico) | 1.7 | EST

Sheet: Corte Opcion D
OPCIÓN D ELEGIDA — HOJAS ESTÁNDAR EN GUILLOTINA PROPIA + FLEJE A MEDIDA (año de diseño 2035)
Solo los datos de la forma de trabajo elegida. La comparación entre alternativas (bobina por formato, hojas, bobina madre, hojas + fleje) está en Comparacion_corte.xlsx. Cuerpos 2,5–100 kg desde hoja estándar cortada en la guillotina CENA; cúpulas y fondos desde rollos de fleje comprados al ancho de cada disco; cuerpo de 1 kg desde caño.
A. ACERO QUE SE COMPRA — 2035
Código | Materia prima | Proveedor (grupo de entrega) | Consumo 2035 | Unidad | Acero 2035 (t) | USD/kg sin IVA | Costo 2035 (USD) | Stock máx. (t) | Fuente del precio
MP-01 | Caño SAE 1010 c/costura Ø76,2 × 1,25 mm × 6 m (cuerpo 1 kg) | Metalprisa (caño) | 8809.608696 | barra | 122.1 | 1.882 | 229819.1159 | 8.5 | Metalprisa 09/09/2026: $37.044 + IVA por barra de 6 m (D25) al TC de D24
MP-02 | Hoja LAF 1,25 × 1220 × 2440 mm (cuerpos 2,5 kg; 27 por hoja) | Pradecon (hojas + fleje 0,9) | 522 | hoja | 15.2 | 1.290 | 19673.86852 | 4.0 | Pradecon 173195 ($1.993,51/kg a TC 1.545)
MP-03 | Hoja LAF 1,6 × 1000 × 2000 mm (cuerpos 5 kg; 12 por hoja) | Pradecon (hojas + fleje 0,9) | 5305.5 | hoja | 133.3 | 1.328 | 176924.251 | 27.8 | Pradecon 173195 ($2.051,02/kg a TC 1.545)
MP-04 | Hoja LAF 2,0 × 1500 × 3000 mm (cuerpos 10 kg; 15 por hoja) | Pradecon (hojas + fleje 0,9) | 256.8 | hoja | 18.1 | 1.280 | 23230.21824 | 5.9 | Pradecon 173195 ($1.978,22/kg a TC 1.545)
MP-05 | Fleje LAF 0,9 × 114 mm (cúpula 1 kg) | Pradecon (hojas + fleje 0,9) | 18114.42074 | kg | 18.1 | 1.263 | 22875.79623 | 3.0 | Pradecon 173170 (LAF 0,9 flejada sin cargo)
MP-06 | Fleje LAF 1,25 × 200 mm (cúpula Ø179 + fondo Ø148, 2,5 kg) | Pacheco (flejes) | 9210.605175 | kg | 9.2 | 1.186 | 10923.77774 | 2.0 | Pacheco N°42021
MP-07 | Fleje LAF 1,6 × 250 mm (cúpula Ø221, 5 kg) | Pacheco (flejes) | 44780.11776 | kg | 44.8 | 1.186 | 53109.21966 | 4.9 | Pacheco N°42021
MP-08 | Fleje LAF 1,6 × 200 mm (fondo Ø177, 5 kg) | Pacheco (flejes) | 28787.21856 | kg | 28.8 | 1.186 | 34141.64121 | 3.0 | Pacheco N°42021
MP-09 | Fleje LAF 2,0 × 300 mm (cúpula Ø258, 10 kg) | Pacheco (flejes) | 4735.30212 | kg | 4.7 | 1.198 | 5672.89194 | 1.5 | Pacheco N°42021
MP-10 | Fleje LAF 2,0 × 249 mm (fondo Ø205, 10 kg) | Pacheco (flejes) | 3132.193709 | kg | 3.1 | 1.198 | 3752.368063 | 1.0 | Pacheco N°42021
MP-11 | Hoja LAC 3,2 × 1500 × 3000 mm (cuerpos 25 kg: 9 por hoja; 50 kg: 6 por hoja) | Pradecon (hojas + fleje 0,9) | 370.2777778 | hoja | 41.9 | 1.102 | 46122.82326 | 9.6 | Pradecon 173195 ($1.702,49/kg a TC 1.545)
MP-12 | Hoja LAC 4,75 × 1500 × 3000 mm (cuerpos 70 y 100 kg; hoja mixta 3 × 70 + 1 × 100) | Pradecon (hojas + fleje 0,9) | 165.2222222 | hoja | 27.7 | 1.091 | 30245.44453 | 5.5 | Pradecon 173195 ($1.685,56/kg a TC 1.545)
MP-13 | Fleje LAF 0,9 × 106 mm (fondo 1 kg) | Pradecon (hojas + fleje 0,9) | 15629.30659 | kg | 15.6 | 1.263 | 19737.46983 | 2.0 | Pradecon 173170 (LAF 0,9 flejada sin cargo)
MP-15 | Casquete embutido 10" × 3,2 mm (carro 25 kg) | Casquetes (tercerizado) | 1550 | u | 3.8 | — | 0 | 1.5 | Sin cotizar (proveedor a definir)
MP-16 | Casquete embutido 12" × 3,2 mm (carro 50 kg) | Casquetes (tercerizado) | 3410 | u | 11.5 | — | 0 | 4.6 | Sin cotizar (proveedor a definir)
MP-17 | Casquete embutido 15" × 4,75 mm (carros 70 y 100 kg) | Casquetes (tercerizado) | 1240 | u | 8.2 | — | 0 | 3.2 | Sin cotizar (proveedor a definir)
TOTAL ACERO 2035 |  |  |  |  | 506.2 |  | 676228.886 | 87.8
Tipo de cambio (ARS/USD) |  |  | 1420 |  |  |  |  |  | Dólar BNA usado en Comparacion_corte (Pradecon, 28/09/2026)
Caño Ø76,2 × 1,25 — precio por barra (ARS sin IVA) |  |  | 37044 |  |  |  |  |  | Mail Metalprisa 09/09/2026
B. HOJAS: NESTING Y CORTES EN LA GUILLOTINA (por formato)
Formato | Hoja (mm) | Espesor (mm) | Masa de la hoja (kg) | Cuerpos por hoja | Aprovech. | 1er corte: franja (mm) | Franjas por hoja | 2º corte: pieza (mm) | Cortes por hoja | Cota máx. de tope (mm) | ¿Todo con tope? | Hojas 2035 | Hojas por día
2,5 kg | 1220 × 2440 | 1.25 | 29.2 | 27 | 94.2% | 385.5 | 3 | 269.5 | 30 | 385.5 | SÍ | 522 | 2.2
5 kg | 1000 × 2000 | 1.60 | 25.1 | 12 | 94.0% | 330.0 | 3 | 474.5 | 15 | 474.5 | SÍ | 5305.5 | 22.1
10 kg | 1500 × 3000 | 2.00 | 70.7 | 15 | 92.9% | 495.0 | 3 | 563.0 | 18 | 563 | SÍ | 256.8 | 1.1
25 kg | 1500 × 3000 | 3.20 | 113.0 | 9 | 84.1% | 490.0 | 3 | 858.0 | 12 | 858 | SÍ | 86.11111111 | 0.4
50 kg | 1500 × 3000 | 3.20 | 113.0 | 6 | 84.8% | 640.0 | 2 | 994.0 | 8 | 994 | SÍ | 284.1666667 | 1.2
70 kg (hoja mixta 3 × 70 + 1 × 100) | 1500 × 3000 | 4.75 | 167.8 | 3 | 79.2% | 1212.0 | 1 | 680.0 | 5 | 900 | SÍ | 82.88888889 | 0.3
100 kg | 1500 × 3000 | 4.75 | 167.8 | 3 | 72.7% | 1212.0 | 1 | 900.0 | 4 | 900 | SÍ | 82.33333333 | 0.3
TOTAL |  |  |  |  |  |  |  |  |  | 994 |  | 6619.8 | 27.6
Datos en Geometria Acero filas 79–97. En el 4,75 mm la franja de 1212 sale cortando primero la orilla de 288 mm con el tope y la franja queda adelante; las piezas de 900 y 680 mm se cortan con tope. Hojas del 25 y 50 kg = MP-11; del 70 y 100 kg = MP-12.
C. GUILLOTINA SELECCIONADA — CENA 8×3200 E21, tope trasero 1.000 mm
Requisito del proyecto | Cotizado por CENA | Cumple | Nota
Largo de corte 3.200 mm | 3.200 mm | SÍ
Espesor hasta 6 mm en SAE 1010 | 8 mm | SÍ | Margen para el 4,75 mm de los rodantes.
Tope trasero motorizado con control NC y recorrido de 1.000 mm | Control E21, tope 20–1.000 mm | SÍ | Cota máxima que piden los cortes: 994 mm (sección B).
Ángulo de corte regulable | Corte oscilante, ángulo fijo de 1,5° | SUPUESTO | El proyecto supone la versión de ángulo regulable al mismo precio: confirmar con CENA (ver Dudas).
Alimentación 380 V trifásica | No informado | A CONFIRMAR | Pedir la confirmación por escrito junto con el ángulo.
Golpes por minuto | 10 | SÍ | Alcanza: Comparacion_corte supone 3 cortes efectivos por minuto con carga manual.
Entrega | A convenir | — | La versión de 650 mm tiene entrega inmediata, pero no llega a los cortes de 858–994 mm.
Precio (USD sin IVA) | 36800 |  | Tope de 650 mm: USD 32.000 (no cumple). Con sostén trasero neumático y tope de 1.000 mm: USD 45.000.
IVA | 10.5%
Precio con IVA (USD) | 40664 |  | Fuente: cotización CENA en el Drive (Cotizacion guillotina CENA.png).
D. EQUIPOS DE CORTE Y MANIPULACIÓN DE LA OPCIÓN D (USD sin IVA)
Equipo | Cantidad | Precio unitario | Subtotal | Fuente
Guillotina hidráulica CENA 8×3200, control E21, tope 1.000 mm | 1 | 36800 | 36800 | COTIZ: CENA (sección C)
Autoelevador eléctrico 2,5 t (prolongaciones de horquilla y espolón) | 1 | 20000 | 20000 | WEB: MercadoLibre GBA, nuevos 2026, USD 13.700–26.700 (Comparacion_corte)
Mesa elevadora de tijera 1500 × 3000 mm, 3 t, elevación ≈1 m | 1 | 7000 | 7000 | EST: cotizar
Mesa de bolas entre la mesa elevadora y la guillotina | 1 | 1500 | 1500 | EST: no hace falta si la guillotina trae brazos delanteros con bolas
Racks por espesor y carros porta-desarrollos | 1 | 2000 | 2000 | EST
Estantería porta-flejes | 1 | 3000 | 3000 | EST
Desbobinador + enderezador + alimentador servo para la prensa de discos | 1 | 12000 | 12000 | EST: en cotización (Cena, Henli, AEK, King Jime, Segura Llunell)
TOTAL INVERSIÓN OPCIÓN D |  |  | 82300
No lleva puente grúa, línea de corte transversal ni slitter. La prensa de discos y la cilindradora existen en todas las opciones y no se incluyen.
E. MANEJO EN EL PUESTO DE GUILLOTINA (pesos por formato)
Límite de manejo manual por persona (kg) |  | 25 | Referencia de carga manual (Res. MTEySS 295/03). Por encima, se desliza o se usa ayuda mecánica.
Formato | Cómo entra la hoja a la guillotina | Hoja (kg) | Franja (kg) | Pieza (kg) | Cómo sale la pieza
2,5 kg | 2 operarios, deslizando sobre la mesa de bolas | 29.2 | 9.2 | 1.0 | 1 operario → carro porta-desarrollos
5 kg | 2 operarios, deslizando sobre la mesa de bolas | 25.1 | 8.3 | 2.0 | 1 operario → carro porta-desarrollos
10 kg | Solo deslizar sobre la mesa de bolas, entre dos; nunca levantar | 70.7 | 23.3 | 4.4 | 1 operario → carro porta-desarrollos
25 kg | Solo deslizar sobre la mesa de bolas, entre dos; nunca levantar | 113.0 | 36.9 | 10.6 | 1 operario → carro porta-desarrollos
50 kg | Solo deslizar sobre la mesa de bolas, entre dos; nunca levantar | 113.0 | 48.2 | 16.0 | 1 operario → carro porta-desarrollos
70 kg (hoja mixta 3 × 70 + 1 × 100) | Solo deslizar sobre la mesa de bolas, entre dos; nunca levantar | 167.8 | 135.6 | 30.7 | 2 operarios o manipulador → carro a la altura de la roladora
100 kg | Solo deslizar sobre la mesa de bolas, entre dos; nunca levantar | 167.8 | 135.6 | 40.7 | 2 operarios o manipulador → carro a la altura de la roladora
Secuencia de materia prima (opción D)
Paso | Qué se hace
1 | Recepción: el autoelevador descarga los paquetes de hojas (≤2 t) y los rollos de fleje (0,5–1 t, con espolón). Control de recepción: certificado, espesor ±0,1 mm, colada; se pesa en la balanza.
2 | Almacén AL-1: paquetes de hoja apilados de a 2 sobre tacos, un formato y espesor por fila; rollos de fleje parados en la estantería porta-flejes, un SKU por disco; atados de caño en cantiléver.
3 | Entrada a la guillotina: el autoelevador lleva el paquete del formato a cortar a la mesa elevadora de tijera; se corta por tandas del mismo formato y el paquete vuelve al almacén.
4 | Carga: la mesa sube hasta que la hoja de arriba queda a la altura de la guillotina y se desliza por la mesa de bolas sin levantarla (hojas de 25 a 168 kg).
5 | Cortes: 1er corte en franjas con el tope trasero; la franja se gira 90° sobre las bolas y el 2º corte da los desarrollos. En 4,75 mm primero se corta la orilla de 288 mm y la franja de 1212 queda adelante.
6 | Salida: los desarrollos caen atrás sobre el sostén de chapa y pasan a carros porta-desarrollos (≈400 kg) → grabado de lote (tarjeta con la colada) → cilindradora o roladora E-15.
7 | Discos: el rollo va con espolón al desbobinador (3 t) → enderezador → alimentador servo → prensa de corte y embutido. Cambio de formato: rollo y troquel.
8 | Scrap: orillas de hoja (10–290 mm) y esqueleto de fleje a contenedor basculante junto a cada máquina → contenedor en N2 → portón P2 (Almacen MP, sección 6).

Sheet: Fuentes
FUENTES
Tipo | Documento / página | Qué se tomó | Enlace
Drive | Dimensionamiento_Tecnico_con_Recargas (13).xlsx | Volúmenes 2026–2035, parámetros de recargas, stock de PT, capacidades, costos | https://drive.google.com/file/d/1YJXfD9oWbfg4C9TqHuU7o5Kp86kolwBp/view
Drive | INVESTIGACION PROVEEDORES › Materias Primas | Proveedores y precios de chapa, flejes y tubo; lineamientos de planos (masas, discos) | https://docs.google.com/spreadsheets/d/12V2t8Vcv4ZIc4YIS5_sPI6p3lEf2FZrrsZAg0abQJcc
Drive | INVESTIGACION PROVEEDORES › Investigación mercado - maquinarias y MP.xlsx | MP, proveedores, régimen de importación, instalaciones | https://drive.google.com/file/d/1e9vuETc1IyG0qLaEZhqhyKvYxXXCNy2q/view
Drive | INVESTIGACION PROVEEDORES › Investigación maquinaria y MP (doc) | Máquinas por puesto | https://docs.google.com/document/d/1TVTx0AC-oc2T1AbsrU2jKMFJVuXv9NIcqGY6NjUZUqw
Drive | PRESUPUESTOS › Cotizaciones recibidas › Materia Prima › Cotizaciones de MP - wpp | Air Liquide (baterías, precios), Eli-Met (cuplas), varilla | https://docs.google.com/document/d/1zKuOmaDARCu2CbYSbb63t3tyYgBoRZMzhpK0GMRFFC8
Drive | Cotización Pacheco Chapas N°42021 (09/09/2026) | Flejes LAF (rollos ≈0,5–0,74 t), hojas para blanks, precios USD/kg, datos logísticos | https://drive.google.com/file/d/1c15T2ZrZKL4GnL314UPDJ7pd0Mcj78iL/view
Drive | Cotización Pacheco Chapas N°42024 (09/09/2026) | LAC 4,75 mm para carros 70/100 kg | https://drive.google.com/file/d/1mKG9dPQRwgIzSVU597-kJ8yF5p2fxxbL/view
Drive | Cotización Pradecon N°173195 (hojas LAF/LAC) | Hojas 1220×2440, 1000×2000 y 1500×3000 de 1,25 a 4,75 mm; precios en $/kg (TC 1.545) | Ver Comparacion_corte.xlsx › Supuestos (sección 7) (https://drive.google.com/file/d/1B-FbuCHKS_2LvOmALx38vsVNLw8o4mMK/view)
Drive | Mail Metalprisa (09/09/2026) | Caño Ø76,2 × 1,25 = $37.044 por 6 m | https://drive.google.com/file/d/13_F9LOAg_h2cwjrnh4qedQAhrJsK_jto/view
Drive | Cotización Comercial MID N°27626 | Caño Ø76 × 2,6 mm (espesor equivocado) | https://drive.google.com/file/d/1xc3XhcRqLVTw-JEv3ZyyNpFEVmX_JbBq/view
Drive | Agentes extintores › Lista de precios | Polvo ABC/BC (bolsa 25 kg), AFFF (bidón 20 L), acetato K, válvulas HZ | https://drive.google.com/file/d/14zKkcrUgWdd4kiVn95_q9rPUllRxjX1h/view
Drive | Gases › Datos técnicos N₂ y ARCAL | Cilindro 50 L 200 bar = 9,4 m³ (N₂) / 11 m³ (ARCAL); bloques de 12–16 cilindros | https://drive.google.com/file/d/1ns9X5EHENOZwp2L-0OoE818mrmzEGTe8/view
Drive | Embaladora de pallet › mail EDOS | Pallet 1000 × 1200, 600–1.200 kg, 1.000–1.700 mm; bobina de film 500 mm | https://drive.google.com/file/d/1fp9F6fHvxUm3IeHNlfsQcHI51xEysM9s/view
Drive | mails presupuestos.docx | Volúmenes informados a proveedores (con inconsistencias) | https://drive.google.com/file/d/1SKSAHGQSfZuPVcWZ3xOuYUDvSmspnQpw/view
Drive | CONSULTAS - RECOMENDACIONES › RECOMENDACIONES ALE-CATEDRA | Alambre 0,9/1,2 mm, nesting, puente grúa con percha, carros, scrap con acceso exterior | https://docs.google.com/document/d/1CF3m5bUBNqwJoS8wuaPeNZYnDBuIYJCDIrlw4Ps9VGU
Drive | AUXILIAR › BOM-Lista de materiales.xlsx | Componentes por formato (desactualizado en proceso) | https://drive.google.com/file/d/1a1glwcadtmrHWzDhQ2oSFuICid8X3uW4/view
Drive | AUXILIAR › Dimensiones de chapa (registro FADESA) | Medidas reales de discos, planchas y casquetes | https://drive.google.com/file/d/1l9jUNhKRvlg5WkwFjcsd6clLHJcoDwmK/view
Drive | Especificaciones técnicas › ET's Matafuegos | Dimensiones, pesos y palletizado (con errores) | https://docs.google.com/spreadsheets/d/1cAWNQfaxI8y5daphPbP_se-d6l63DShU2S3BCsN-bkM
Drive | AUXILIAR › Corte_chapa.docx | Método de cálculo de discos (paso D₀ + 2 mm, scrap 21–25 %) | https://drive.google.com/file/d/1Va_yL0lv3loGzLTlJGv6WNvD6XRtrACg/view
Drive | AUXILIAR › Costeo MP Abastecimiento | TC 1.420; precio de chapa estimado USD 0,90/kg (la planilla tiene referencias rotas) | https://docs.google.com/spreadsheets/d/1l-HlFknSPMSHWKdzsuLnsSW767uTBu040TymarFg14g
Web | DEMSA — Premium ABC 55 (hoja técnica) | Bolsa 25 kg doble PE; big bag 1.000 kg; pallet no retornable con film | https://demsa.com.ar/assets/pdf/productos/polvoquimicosecoabc55premium.pdf
Web | Mercado Libre — Polvo ABC Polvex bolsa 25 kg | Presentación 25 kg | https://www.mercadolibre.com.ar/polvo-abc-polvex-extintor-multiproposito-bolsa-25-kg-color-verde/p/MLA46255892
Web | 2sonline — Alambre MIG ESAB 70S6 15 kg | Carrete 15 kg | https://www.2sonline.com.ar/productos/alambre-mig-esab-weld-70s6-15-kg/
Web | ESAB — Marathon Pac (bulk wire drums) | Tambor 250 kg ≈ 14 carretes; cambios de 55,6 a 4 por tonelada | https://esab.com/ae/mea_en/esab-university/articles/filler-metal-selection-guide-part-two/
Web | Sinteplast Industria — pintura en polvo | Caja 20 kg con bolsa PE | https://www.sinteplastindustria.com.ar/
Web | El Sitio de la Pintura en Polvo — rendimiento | Rendimiento = 1000/(ρ·e); práctico 25–30 % menor | https://pinturaenpolvo.org/rendimiento-de-la-pintura-en-polvo
Web | Mercado Libre — Granalla S330 saco 25 kg | Bolsa 25 kg; 40 bolsas por pallet; big bag 1 t | https://articulo.mercadolibre.com.mx/MLM-1969010010-granalla-de-acero-esferica-s330-saco-de-25-kgs-_JM
Web | Metalmecánica — Granallado industrial | Consumo de referencia ≈9 kg/h; vida 700–5.000 ciclos | https://www.metalmecanica.com/articles/granallado-industrial-el-primer-paso-hacia-una-superficie-perfecta-y-una-l%C3%ADnea-m%C3%A1s-rentable
Web | Palletec — Pallet ARLOG IRAM 10016 | 1200 × 1000 × 145 mm; 2.000 kg dinámica; 4.000 estática; 1.500 en rack; 35 kg | https://palletec.com.ar/portfolio/pallet-arlog-iram-10016/
Web | Mecalux Argentina — racks selectivos | Pasillo 3,2–3,5 m para contrapesada eléctrica | https://www.mecalux.com.ar/racks-para-pallets/racks-selectivos
Web | Ternium Argentina — laminados en frío | Espesor 0,30–3,0 mm; ancho 600–1.500 mm; bobinas, flejes y hojas | https://ar.ternium.com/es/productos/aceros-planos/laminados-en-frio
Web | Ternium Argentina — tubos de uso general | Largo estándar 6.000 mm | https://ar.ternium.com/es/productos/tuberia/tuberia-para-uso-general
Web | Vinco — calculadora de fleje / bobina | Peso de rollo = π(DE² − DI²)/4 × ancho × ρ | https://www.vinco.es/es/fleje/calculadora/
Web | Carflej — flejes a medida | Anchos 8–1.220 mm, espesores 0,2–4 mm | https://www.carflej.com.ar/
Web | DEMSA / Comercial Argentina — AFFF | Bidón 20 L, tambor 200 L, IBC 1.000 L | https://www.comercialargentina.com.ar/lucha-contra-el-fuego-espumigeno-afff-6-10-c-demsa-bidon-de-200-litros--det--PTE2009
Web | PWENT — bloque 12 × 50 L | Bastidor ≈290 kg; 200 bar | https://pwent.eu/en/products/products/gas-cylinder-bundles/12x50-cylinder-bundle-vertical/
Drive | Cotización CENA — guillotina hidráulica 8×3200 E21 | Tope 20–650 mm USD 32.000; 20–1.000 mm USD 36.800; con sostén neumático USD 45.000 (+ IVA 10,5 %); ángulo 1,5° fijo; 10 golpes/min | https://drive.google.com/file/d/1BQS1JLhY7VGMFoio8I9i6i2jxcJxI5nz/view (https://www.forvis.com.ar/puentes-grua-monovigas)
Excel | Comparacion_corte.xlsx (FLAMA S.A.) | Opción D elegida: formatos de hoja, nesting, cortes, flejes a medida, equipos, precios de acero | Archivo del proyecto (https://www.eurocranedq.com/es/puente-grua/tipos-puente-grua-2-toneladas-precio.html)
Drive | AUXILIAR › Materiales y útiles.xlsx | Válvula pre-armada, manifold N₂ de 4 cilindros, apilador 1,5 t, caño cortado a 225 mm | https://drive.google.com/file/d/1VoWl951SoMNyzpwSTsPSWtiTldMt32a1/view
Drive | AUXILIAR › Modelo_Tecnico_Flama (ago-2026) | Modelo anterior: 100 % de polvo nuevo en recargas; 600 m² de almacenes | https://docs.google.com/spreadsheets/d/16VSTp8eevT2ZlxwgGtlq--_K2mBUWqm5DWvrBdNo0ow
Repo | Layout v3 (v2/plan.py, calc_dimensionamiento.py) | Superficies de AL-1, AL-3, jaula de gases, pañol; puente grúa 5 t (la opción D no lo necesita) | Repositorio local
Drive | Cotización Pradecon N°173170 (bobina LAF flejada) | Fleje 0,9 mm para los discos de 1 kg; flejado sin cargo; USD 1,263/kg | Ver Comparacion_corte.xlsx › Supuestos (sección 7)
Drive | Cotización Hierros Parrotta N°413329 | Hojas LAF/LAC (alternativa a Pradecon) | Ver Comparacion_corte.xlsx › Supuestos (sección 7)
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
