TadeoSinay/planos_industrial_flama/referencias/Costo oportunidad operario-maquina.xlsx

Sheet: PARAMETROS
PARÁMETROS SALARIALES Y FINANCIEROS | CCT N°260/75 UOM — Acta agosto 2026
Editá las celdas con borde grueso. Todo el modelo se recalcula. Los parámetros de cada máquina van en CONSOLIDADO.
A. Salarios — editables
Concepto | Valor | Unidad | Fuente / Nota
Valor hora base ingresante Rama 17 | 4485.97 | ARS/h | Cláusula SEGUNDA, acta agosto 2026 — vigente desde 1/8/2026
Horas mensuales (jornada legal) | 200 | h/mes | 8 hs/día × 25 días — LCT
Gratificación extraordinaria | 40000 | ARS/mes | Cláusula TERCERA — varía por mes según el acta, editable
Compensación extraordinaria | 70000 | ARS/mes | Cláusula CUARTA — cuota 2/3 (agosto, septiembre, octubre 2026)
Contribuciones patronales TOTAL | 24.0% | % | 18% Decreto 814/01 MiPyME industrial + 6% OS = 24%. Agregar ART cuando se cotice (~2,5%).
Recargo hora extra 50% | 50.0% | % | LCT art. 201 — primeras 2 horas extra por día
Recargo hora extra 100% | 100.0% | % | LCT art. 201 — tercera hora en adelante o días inhábiles
Horas extra mensuales estimadas | 40 | h/mes | Referencia: 2 hs extra × 20 días hábiles — editable
B. Costo de capital — editable
Concepto | Valor | Unidad | Fuente / Nota
Tasa costo de capital mensual | 5.0% | % | Costo de oportunidad del dinero inmovilizado. Usar: tasa SGR si hay financiamiento, o tasa plazo fijo si es capital propio. Referencia sep 2026: ~5% mensual. EDITABLE.
C. Categorías salariales (calculado)
Categoría | Factor CCT | Hora (ARS) | Básico/mes | Total bruto/mes | Costo empresa/mes | Descripción
P1 — Ayudante | 1.00 | 4485.97 | 897194 | 1007194 | 1248920.56 | Tareas auxiliares sin calificación.
P2 — Semiespecializado | 1.08 | 4844.8476 | 968969.52 | 1078969.52 | 1337922.205 | Granallado, etiquetado, embalaje.
P3 — Especializado | 1.14 | 5114.0058 | 1022801.16 | 1132801.16 | 1404673.438 | Prensa, rolado, bordoneado, PH, pintura, llenado, ensamblaje. MÁS FRECUENTE EN FLAMA.
P4 — Oficial | 1.23 | 5517.7431 | 1103548.62 | 1213548.62 | 1504800.289 | Soldador MIG/MAG longitudinal y circunferencial.
P5 — Oficial esp. | 1.32 | 5921.4804 | 1184296.08 | 1294296.08 | 1604927.139 | Múltiples procesos complejos.
Agregar ART a las cargas cuando se cotice (~2,5% para metalúrgica). Tasa de capital: ajustar según fuente de financiamiento. Acta vigente hasta 1/10/2026.

Sheet: CONSOLIDADO
CONSOLIDADO — ANÁLISIS COMPLETO POR PUESTO | Máquina vs. Operario vs. Turno Extra
Borde grueso = input. Col C desde PARAMETROS (salarios). Cols D–J: datos de la máquina por puesto. Todo lo demás calculado.
 |  | DECISIÓN
Puesto operativo | Categoría CCT | Costo operario (ARS/mes c/cargas) | Precio (USD) | TC (ARS/USD) | Precio (ARS) | Vida útil (años) | VR % | Energía (ARS/mes) | Mant. (ARS/mes) | Amort.+op. máq. (ARS/mes) | Costo oport. capital (ARS/mes) | COSTO TOTAL máq. (ARS/mes) | Ahorro real (ARS/mes) | PI real (meses) | PI real (años) | Acum. 12m Operario | Acum. 12m Máquina real | Acum. 36m Operario | Acum. 36m Máquina real | Turno extra 50% (ARS/mes) | Turno extra 100% (ARS/mes) | Decisión (PI real)
Operario de prensa (preparacion de cuello) | P2 — Semiespecializado | 1337922.205 | 2000 | 1420 | 2840000 | 10 | 10% | 50000 | 30000 | 101300 | 142000 | 243300 | 1094622.205 | 2.6 | 0.22 | 16055066.46 | 5759600 | 48165199.37 | 11598800 | 333756.168 | 445008.224 | Comprar — PI < 1 año
Operario de prensa (numerado) | P2 — Semiespecializado | 1337922.205 | 2000 | 1420 | 2840000 | 10 | 10% | 50000 | 30000 | 101300 | 142000 | 243300 | 1094622.205 | 2.6 | 0.22 | 16055066.46 | 5759600 | 48165199.37 | 11598800 | 360456.6614 | 480608.8819 | Comprar — PI < 1 año
Operario de prensa (embutido) | P2 — Semiespecializado | 1337922.205 | 39056 | 1420 | 55459520 | 10 | 10% | 50000 | 30000 | 495946.4 | 2772976 | 3268922.4 | -1931000.195 | - | - | 16055066.46 | 94686588.8 | 48165199.37 | 173140726.4 | 380482.0315 | 507309.3754 | Sin precio
Operario de rolado (cilindradora) | P3 — Especializado | 1404673.438 | 6880 | 1420 | 9769600 | 10 | 10% | 50000 | 30000 | 153272 | 488480 | 641752 | 762921.4384 | 12.8 | 1.07 | 16856081.26 | 17470624 | 50568243.78 | 32872672 | 380482.0315 | 507309.3754 | Conveniente — PI < 3 años
Soldador longitudinal MIG/MAG GETWELD | P4 — Oficial | 1504800.289 | 30500 | 1420 | 43310000 | 10 | 10% | 50000 | 30000 | 404825 | 2165500 | 2570325 | -1065524.711 | - | - | 18057603.47 | 74153900 | 54172810.4 | 135841700 | 410520.0866 | 547360.1155 | Sin precio
Soldador longitudinal MIG/MAG MITUSA | P4 — Oficial | 1504800.289 | 166700 | 1420 | 236714000 | 10 | 10% | 50000 | 30000 | 1855355 | 11835700 | 13691055 | -12186254.71 | - | - | 18057603.47 | 401006660 | 54172810.4 | 729591980 | 440558.1418 | 587410.8557 | Sin precio
Soldador longitudinal MIG/MAG Firesafer | P4 — Oficial | 1504800.289 | 22450 | 1420 | 31879000 | 10 | 10% | 50000 | 30000 | 319092.5 | 1593950 | 1913042.5 | -408242.2112 | - | - | 18057603.47 | 54835510 | 54172810.4 | 100748530 | 0 | 0 | Sin precio
Operario Encastre de Fondo | P3 — Especializado | 1404673.438 | 5718 | 1420 | 8119560 | 10 | 10% | 50000 | 30000 | 140896.7 | 405978 | 546874.7 | 857798.7384 | 9.5 | 0.79 | 16856081.26 | 14682056.4 | 50568243.78 | 27807049.2 | 380482.0315 | 507309.3754 | Comprar — PI < 1 año
Soldador circunferencial MIG/MAG | P4 — Oficial | 1504800.289 | 15578 | 1420 | 22120760 | 10 | 10% | 50000 | 30000 | 245905.7 | 1106038 | 1351943.7 | 152856.5888 | 144.7 | 12.06 | 18057603.47 | 38344084.4 | 54172810.4 | 70790733.2 | 410520.0866 | 547360.1155 | No conviene — PI > 5 años
Soldador de cuello MIG | P4 — Oficial | 1504800.289 |  | 1420 | - | 10 | 10% | 50000 | 30000 | - | - | - | - | - | - | 18057603.47 | - | 54172810.4 | - | 410520.0866 | 547360.1155 | Sin precio
Operario de bordoneado | P3 — Especializado | 1404673.438 | 21123 | 1420 | 29994660 | 10 | 10% | 50000 | 30000 | 304959.95 | 1499733 | 1804692.95 | -400019.5116 | - | - | 16856081.26 | 51650975.4 | 50568243.78 | 94963606.2 | 380482.0315 | 507309.3754 | Sin precio
Operario de prueba hidráulica | P3 — Especializado | 1404673.438 | 15578 | 1420 | 22120760 | 10 | 10% | 50000 | 30000 | 245905.7 | 1106038 | 1351943.7 | 52729.7384 | 419.5 | 34.96 | 16856081.26 | 38344084.4 | 50568243.78 | 70790733.2 | 380482.0315 | 507309.3754 | No conviene — PI > 5 años
Operario de granallado | P2 — Semiespecializado | 1337922.205 |  | 1420 | - | 10 | 10% | 50000 | 30000 | - | - | - | - | - | - | 16055066.46 | - | 48165199.37 | - | 360456.6614 | 480608.8819 | Sin precio
Operario de pintura electrostática | P3 — Especializado | 2809346.877 |  | 1420 | - | 10 | 10% | 50000 | 30000 | - | - | - | - | - | - | 33712162.52 | - | 101136487.6 | - | 380482.0315 | 507309.3754 | Sin precio
Operario de llenado de polvo | P3 — Especializado | 1404673.438 | 2500 | 1420 | 3550000 | 10 | 10% | 50000 | 30000 | 106625 | 177500 | 284125 | 1120548.438 | 3.2 | 0.26 | 16856081.26 | 6959500 | 50568243.78 | 13778500 | 380482.0315 | 507309.3754 | Comprar — PI < 1 año
Operario de ensamblaje y presurización | P3 — Especializado | 1404673.438 |  | 1420 | - | 10 | 10% | 50000 | 30000 | - | - | - | - | - | - | 16856081.26 | - | 50568243.78 | - | 380482.0315 | 507309.3754 | Sin precio
Operario de etiquetado y embalaje | P2 — Semiespecializado | 1337922.205 |  | 1420 | - | 10 | 10% | 50000 | 30000 | - | - | - | - | - | - | 16055066.46 | - | 48165199.37 | - | 360456.6614 | 480608.8819 | Sin precio
Operario de cortadora plasma | P3 — Especializado | 1604927.139 | 15731 | 1420 | 22338020 | 10 | 10% | 50000 | 30000 | 247535.15 | 1116901 | 1364436.15 | 240490.9892 | 92.9 | 7.74 | 19259125.67 | 38711253.8 | 57777377.01 | 71457721.4 | 380482.0315 | 507309.3754 | No conviene — PI > 5 años
COSTO OPORTUNIDAD CAPITAL: precio_ARS × tasa mensual (PARAMETROS B financiero). Representa el rendimiento alternativo perdido por inmovilizar ese capital. Es conservador (aplica sobre el total, no el saldo decreciente). Para mayor precisión usar VPN — esta es una aproximación lineal. TURNO EXTRA: costo mensual de cubrir la misma función con horas extra al 50% o 100%, a las horas extra estimadas en PARAMETROS. Comparar col U/V con col C para ver cuánto cuesta el turno extra vs. el operario regular. DECISIÓN: basada en PI real (incluye costo de capital).

Sheet: OPERARIO COMUN P3
COSTO DE OPORTUNIDAD — OPERARIO P3 (Especializado) | CCT N°260/75 Rama 17
Detalle línea por línea del costo mensual del operario P3. Todo referenciado a PARAMETROS.
Concepto | Valor | Unidad | Fuente / Nota
Valor hora base ingresante | 4485.97 | ARS/h | Acta agosto 2026 — cláusula SEGUNDA
Factor categoría P3 | 1.14 |  | CCT N°260/75
Valor hora P3 | 5114.01 | ARS/h | Hora base x factor P3
Horas mensuales | 200 | h/mes | Jornada legal 8 hs × 25 días
Salario básico mensual | 1022801.16 | ARS/mes | Hora P3 x horas mensuales
Gratificación extraordinaria | 40000 | ARS/mes | Cláusula TERCERA del acta
Compensación extraordinaria | 70000 | ARS/mes | Cláusula CUARTA del acta — cuota 2/3
TOTAL BRUTO MENSUAL | 1132801.16 | ARS/mes | Basico + gratificacion + compensacion
Contribuciones patronales (24%) | 271872.2784 | ARS/mes | Total bruto x 24%
COSTO TOTAL EMPRESA | 1404673.438 | ARS/mes | Total bruto x (1 + 24%)
Hora extra 50% (costo empresa) | 9512.05 | ARS/h | Hora P3 x 1.50 x (1 + cargas)
Hora extra 100% (costo empresa) | 12682.73 | ARS/h | Hora P3 x 2.00 x (1 + cargas)
Costo turno extra 50% mensual (40hs est.) | 380482.0315 | ARS/mes | Hora extra 50% x horas estimadas
Costo turno extra 100% mensual (40hs est.) | 507309.3754 | ARS/mes | Hora extra 100% x horas estimadas

Sheet: SOLDADOR P4
COSTO DE OPORTUNIDAD — SOLDADOR OFICIAL P4 | CCT N°260/75 Rama 17
Detalle línea por línea del costo mensual del soldador P4. Todo referenciado a PARAMETROS.
Concepto | Valor | Unidad | Fuente / Nota
Valor hora base ingresante | 4485.97 | ARS/h | Acta agosto 2026 — cláusula SEGUNDA
Factor categoría P4 | 1.23 |  | CCT N°260/75
Valor hora P4 | 5517.74 | ARS/h | Hora base x factor P4
Horas mensuales | 200 | h/mes | Jornada legal 8 hs × 25 días
Salario básico mensual | 1103548.62 | ARS/mes | Hora P4 x horas mensuales
Gratificación extraordinaria | 40000 | ARS/mes | Cláusula TERCERA del acta
Compensación extraordinaria | 70000 | ARS/mes | Cláusula CUARTA del acta — cuota 2/3
TOTAL BRUTO MENSUAL | 1213548.62 | ARS/mes | Basico + gratificacion + compensacion
Contribuciones patronales (24%) | 291251.6688 | ARS/mes | Total bruto x 24%
COSTO TOTAL EMPRESA | 1504800.289 | ARS/mes | Total bruto x (1 + 24%)
Hora extra 50% (costo empresa) | 10263.00 | ARS/h | Hora P4 x 1.50 x (1 + cargas)
Hora extra 100% (costo empresa) | 13684.00 | ARS/h | Hora P4 x 2.00 x (1 + cargas)
Costo turno extra 50% mensual (40hs est.) | 410520.0866 | ARS/mes | Hora extra 50% x horas estimadas
Costo turno extra 100% mensual (40hs est.) | 547360.1155 | ARS/mes | Hora extra 100% x horas estimadas
