TadeoSinay/planos_industrial_flama/(list of files, cad)

Other CAD files:
salida/FL_PI_03.dxf
salida/FL_PI_04.dxf
salida/FL_PI_01.dxf
salida/FL_PI_05.dxf
salida/FL_PI_02.dxf
