TadeoSinay/planos_industrial_flama/salida/FL_PI_01.pdf

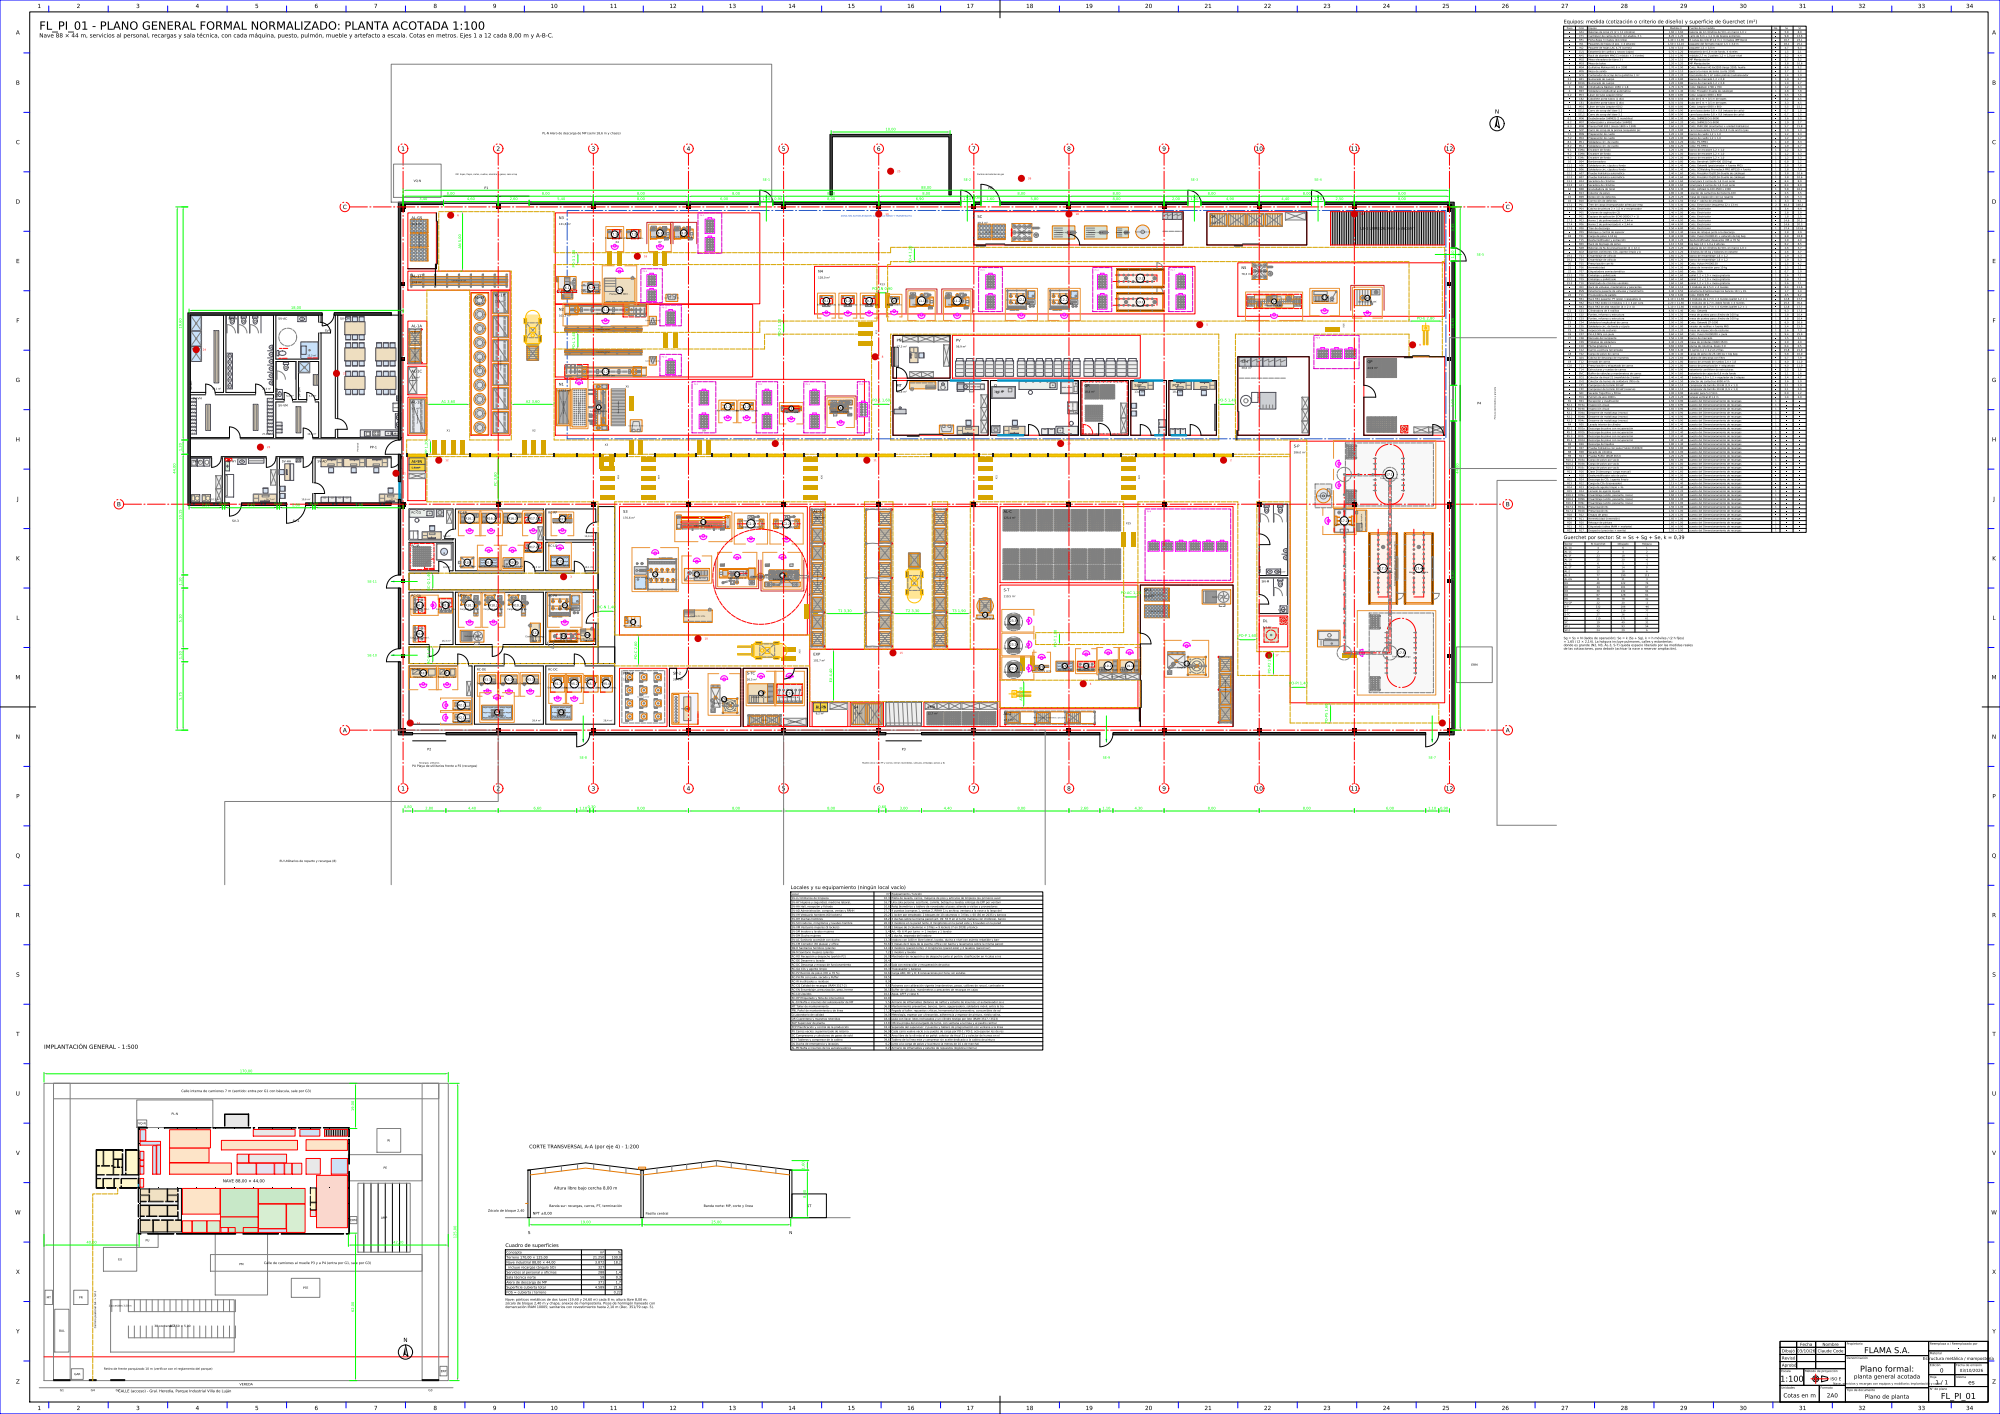
[picture p41: page 1]
