TadeoSinay/planos_industrial_flama/salida/FL_PI_02.pdf

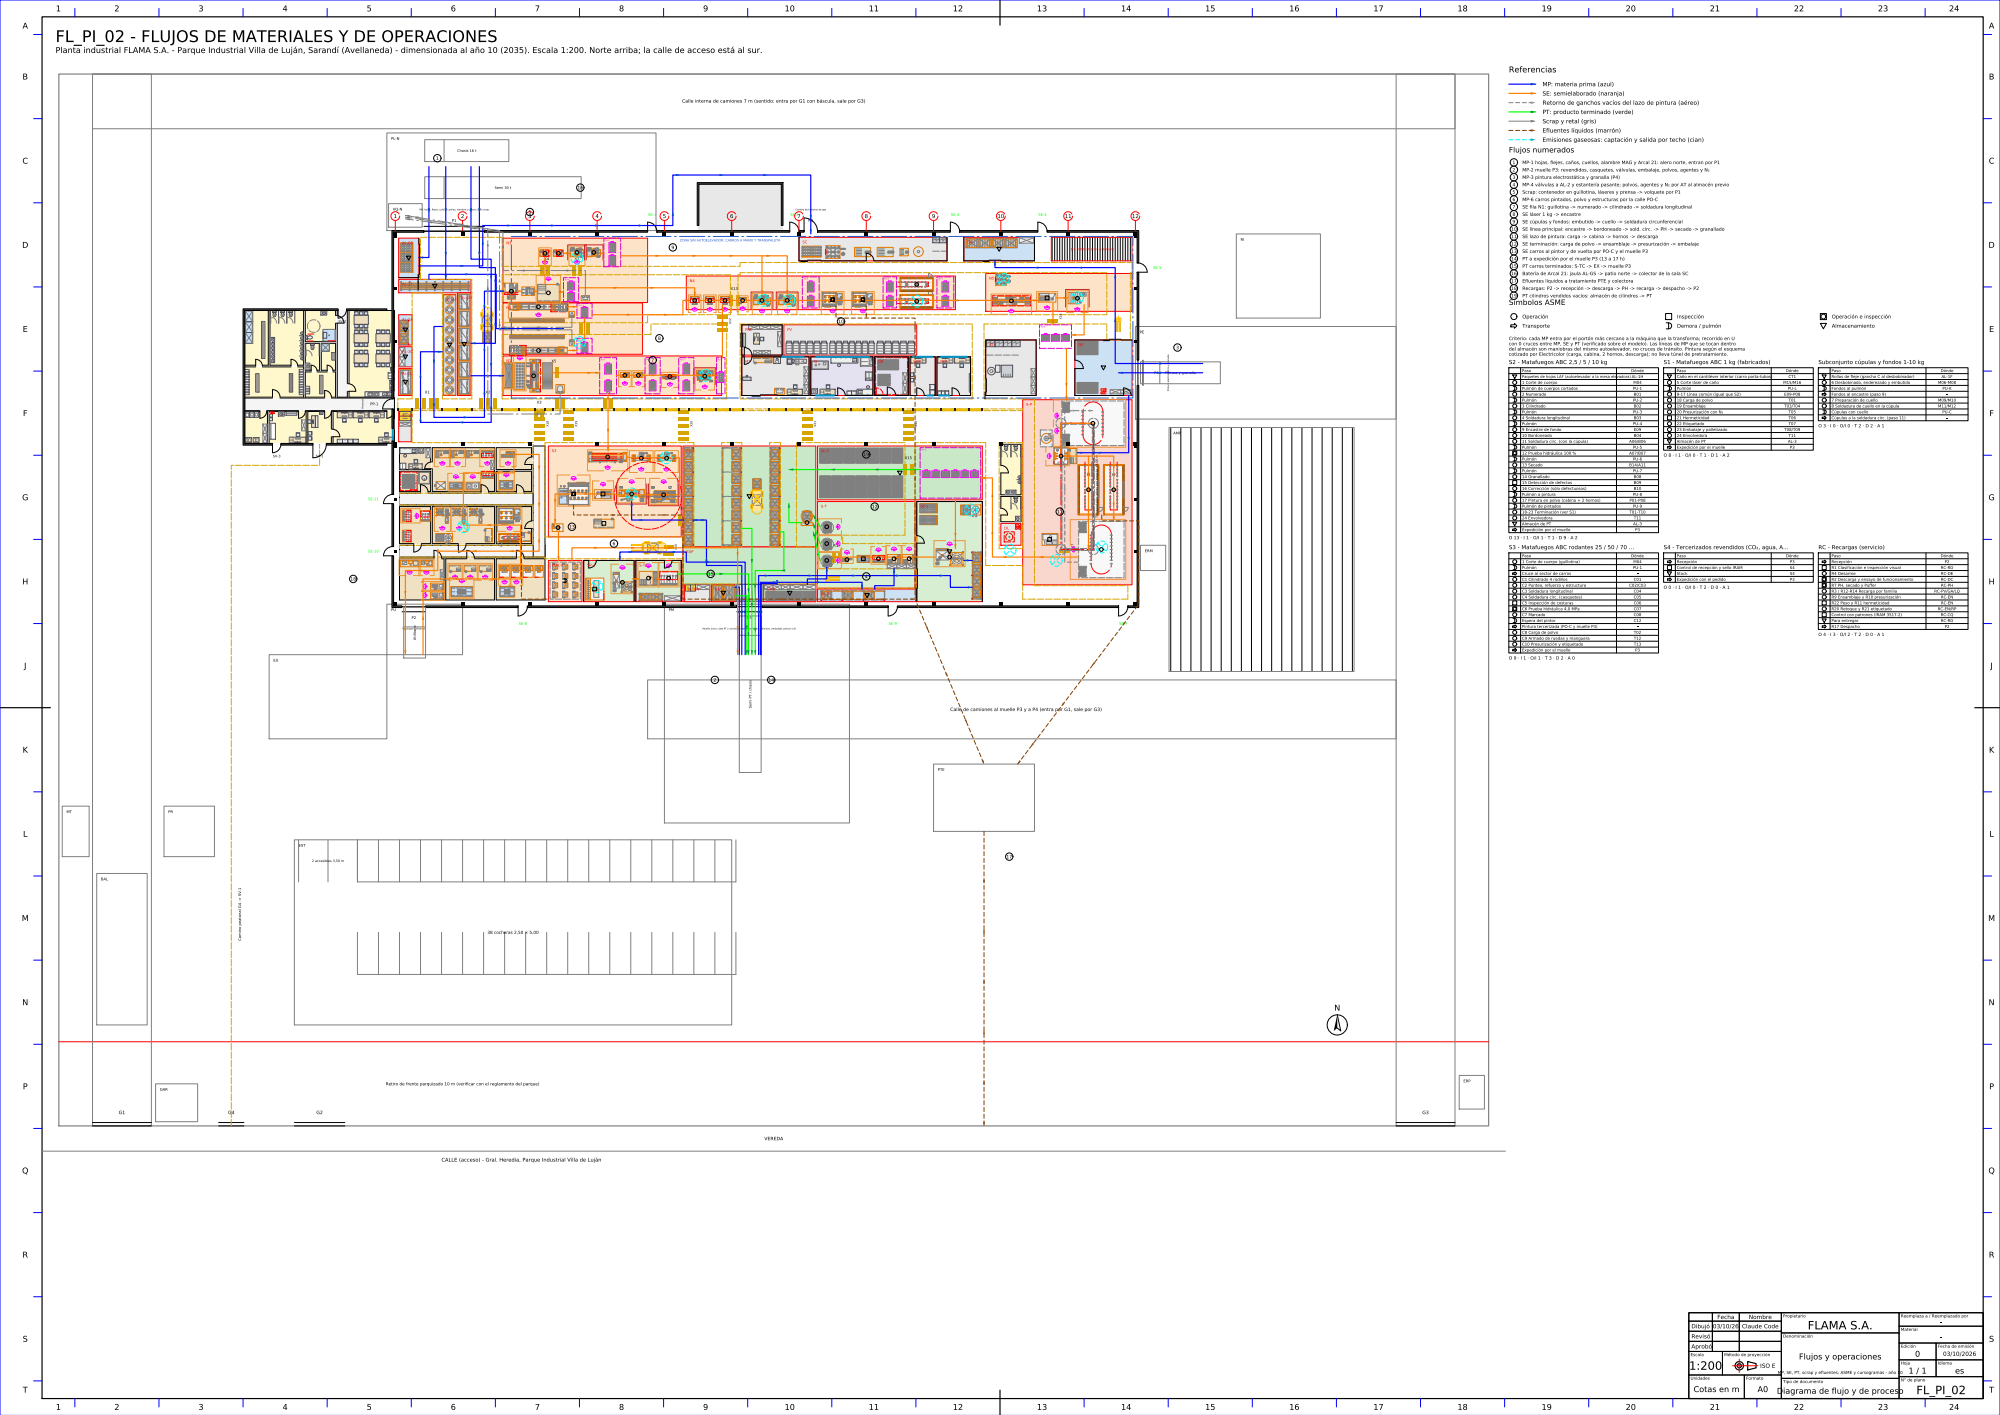
[picture p42: page 1]
