TadeoSinay/planos_industrial_flama/salida/FL_PI_03.pdf

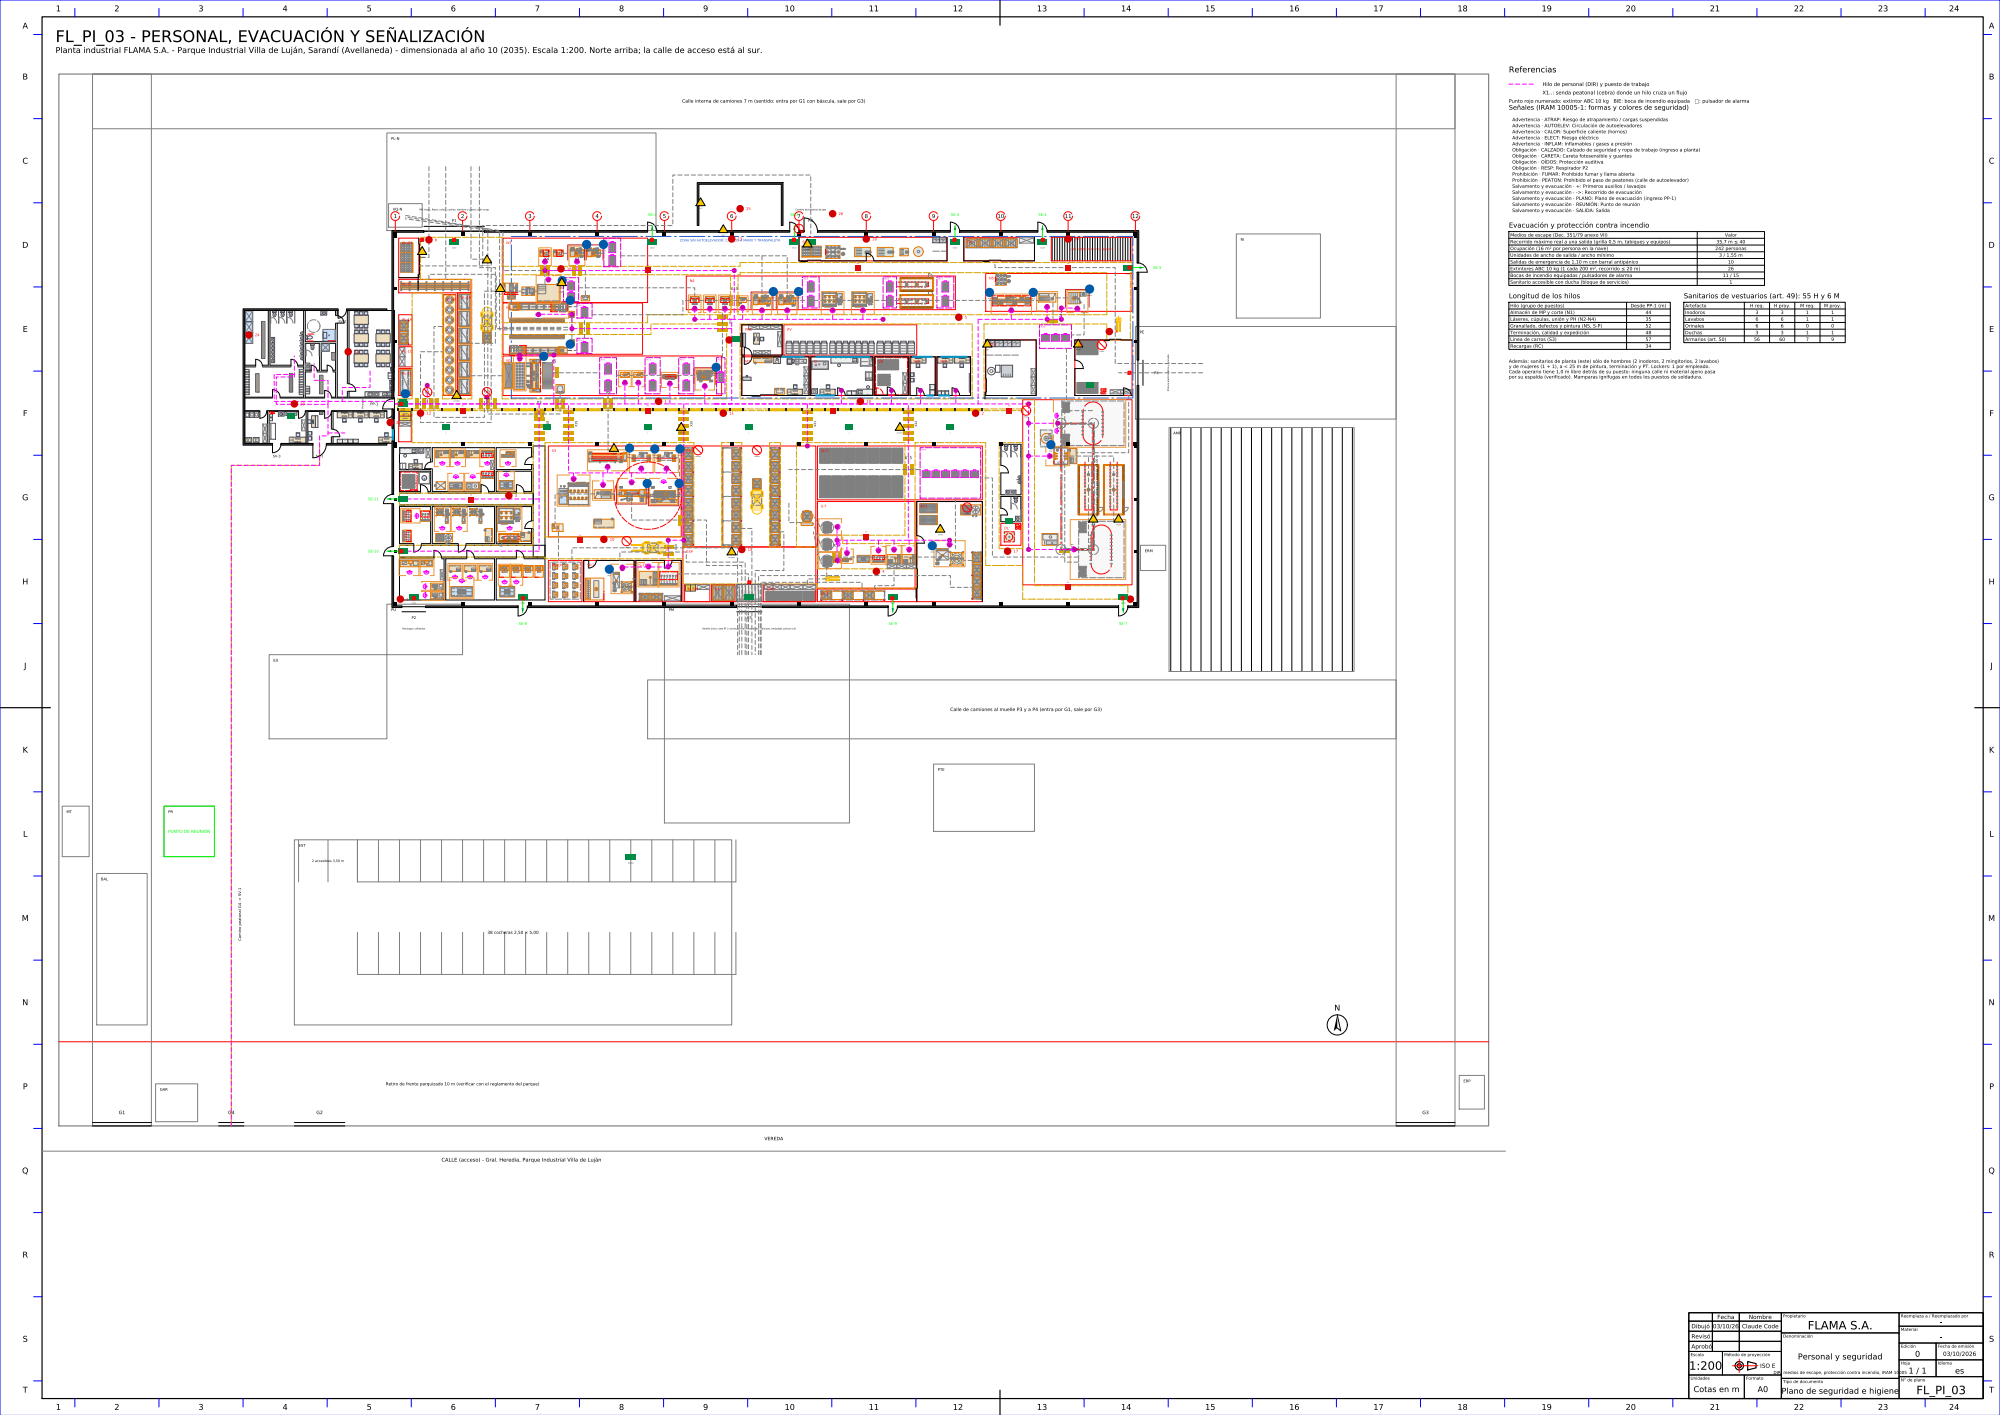
[picture p43: page 1]
