TadeoSinay/planos_industrial_flama/salida/FL_PI_04.pdf

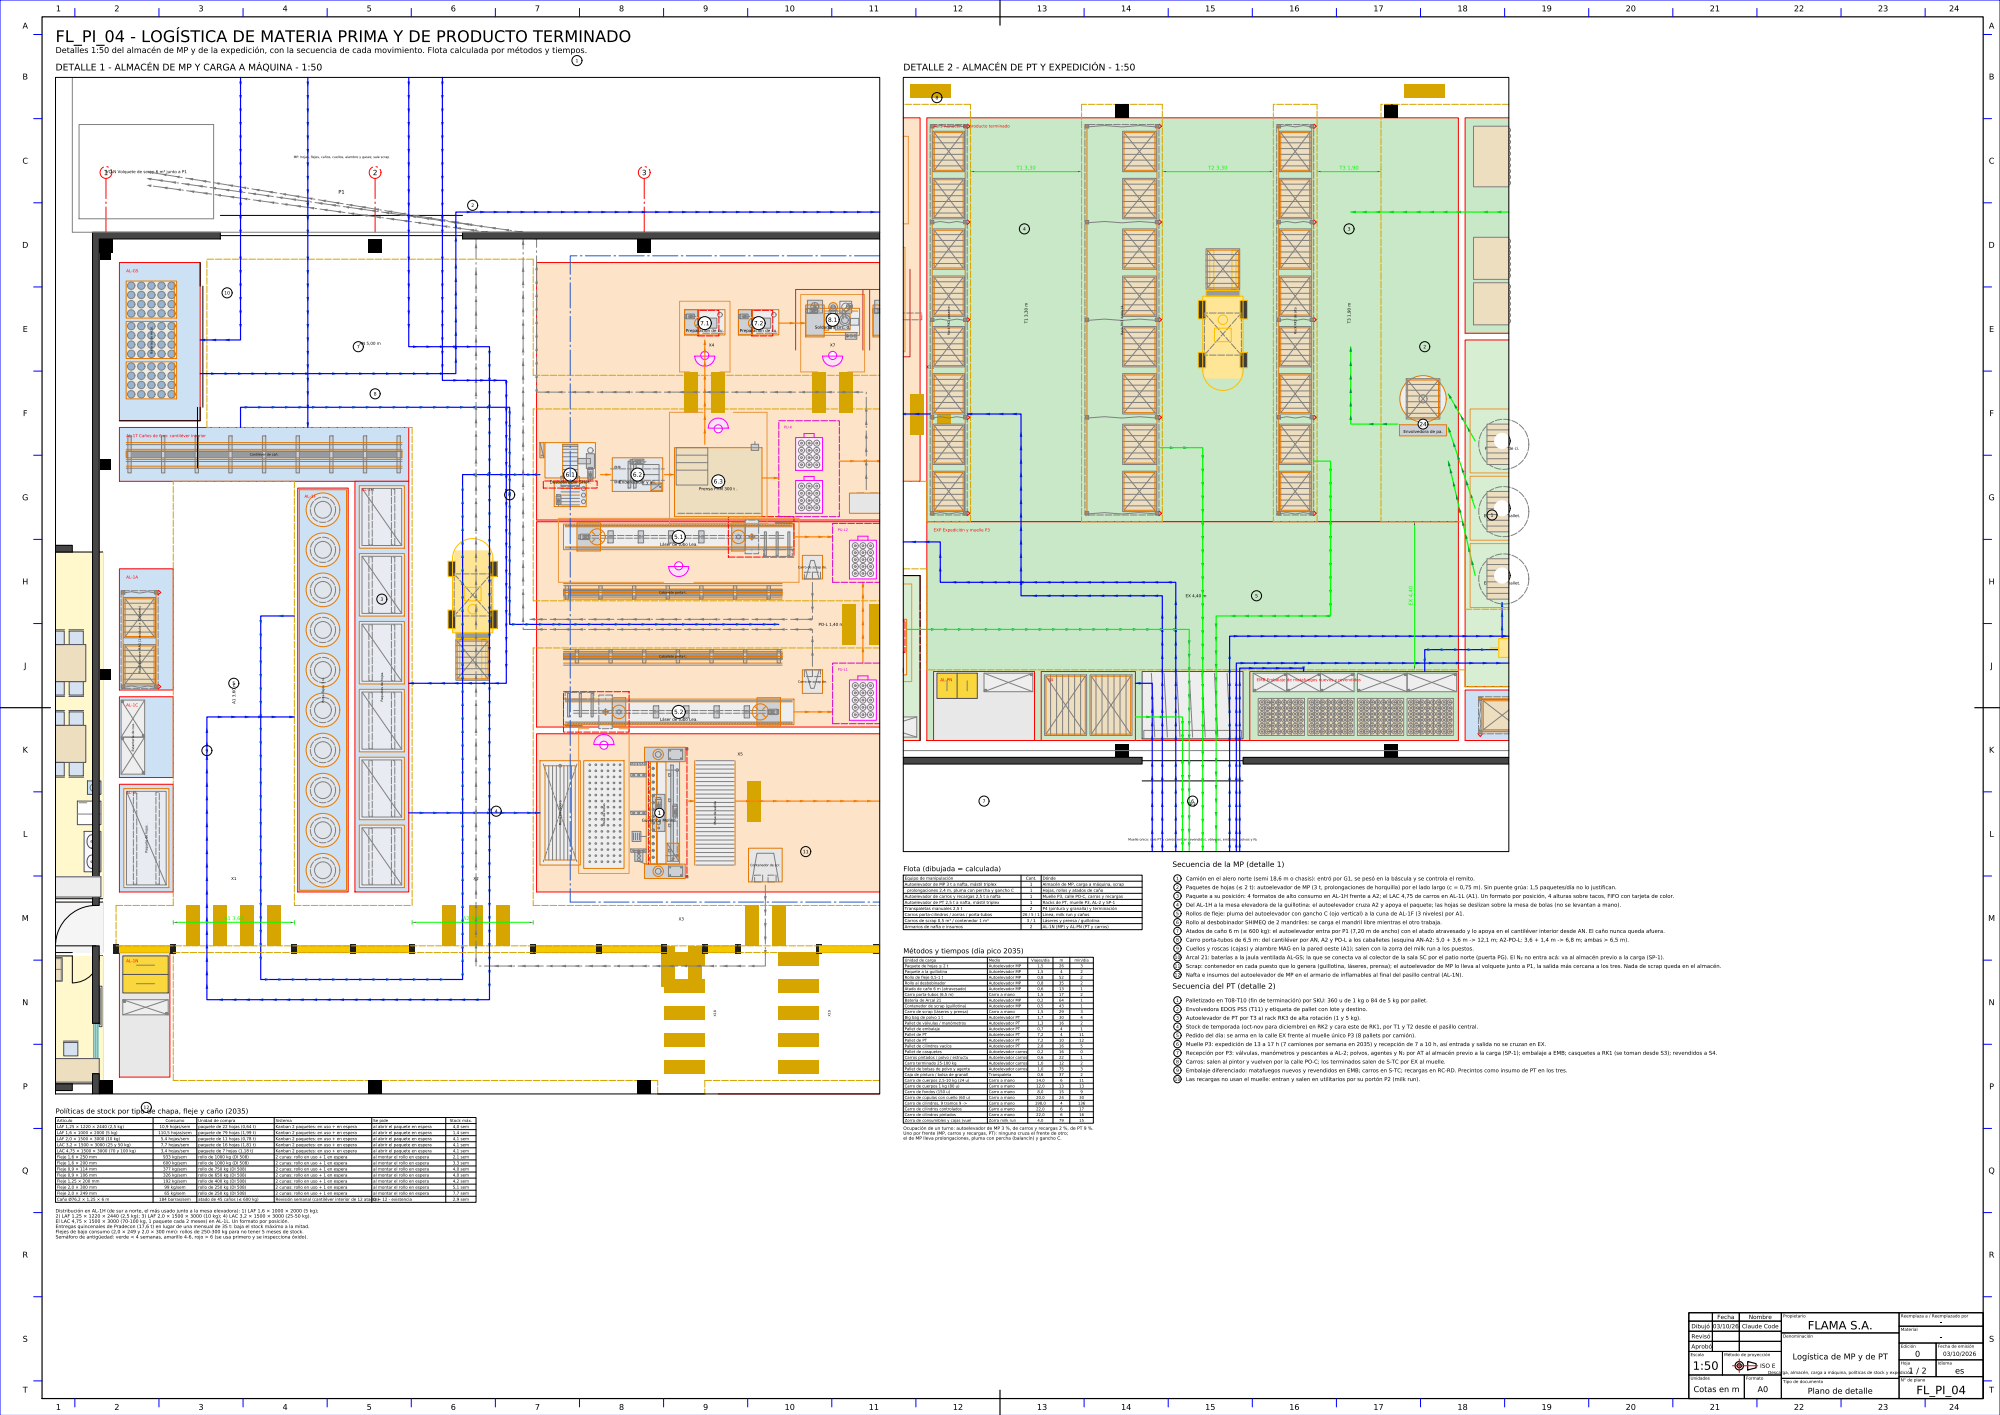
[picture p44: page 1]

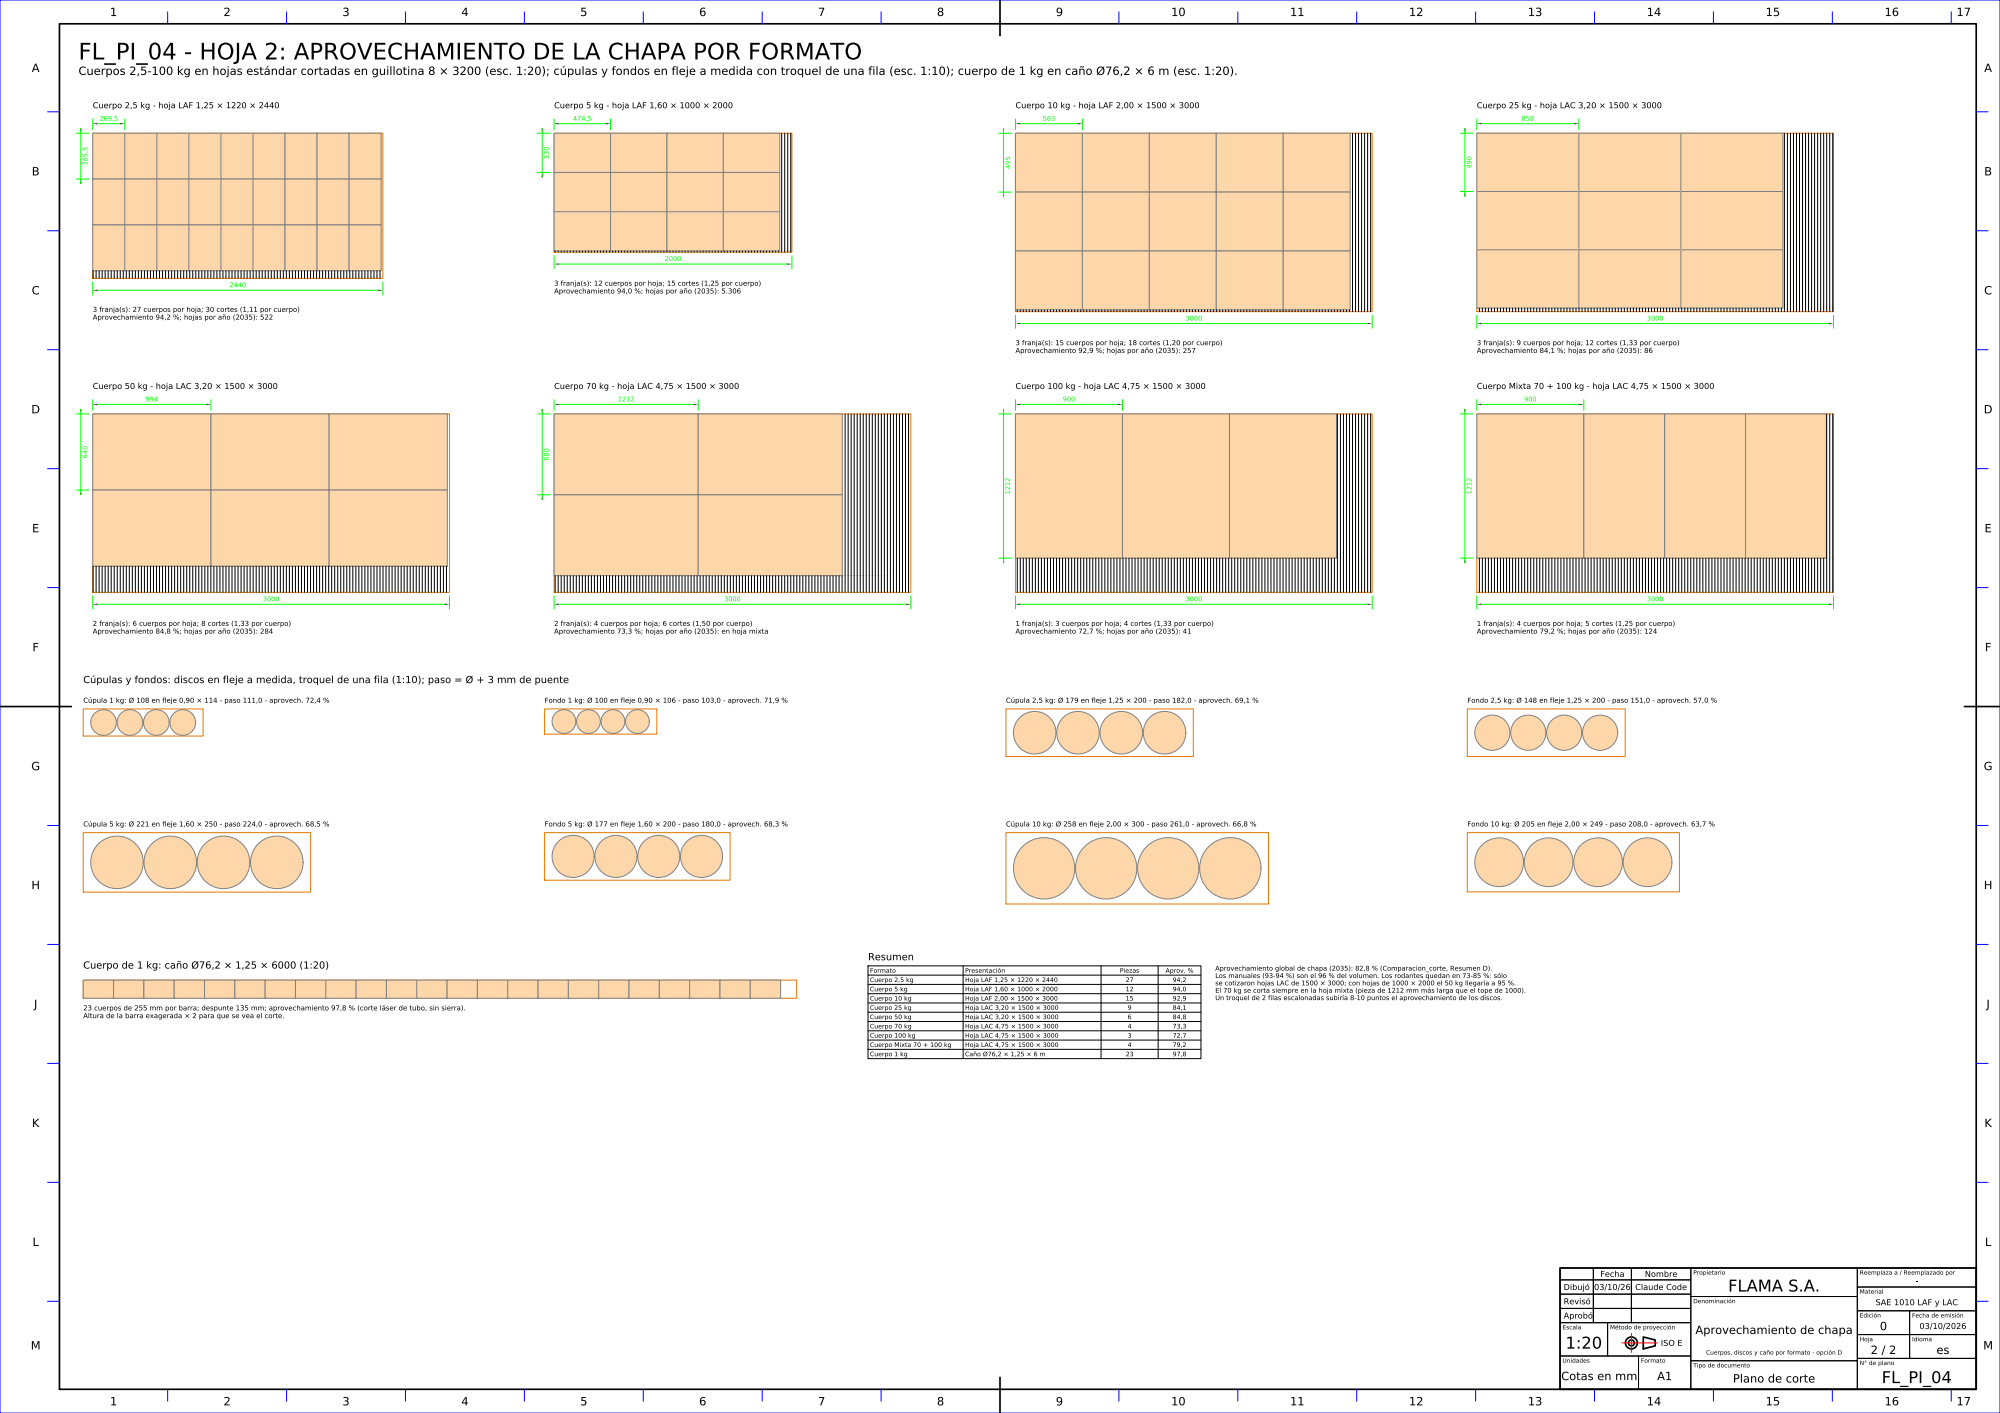
[picture p45: page 2]
