TadeoSinay/planos_industrial_flama/salida/FL_PI_05.pdf

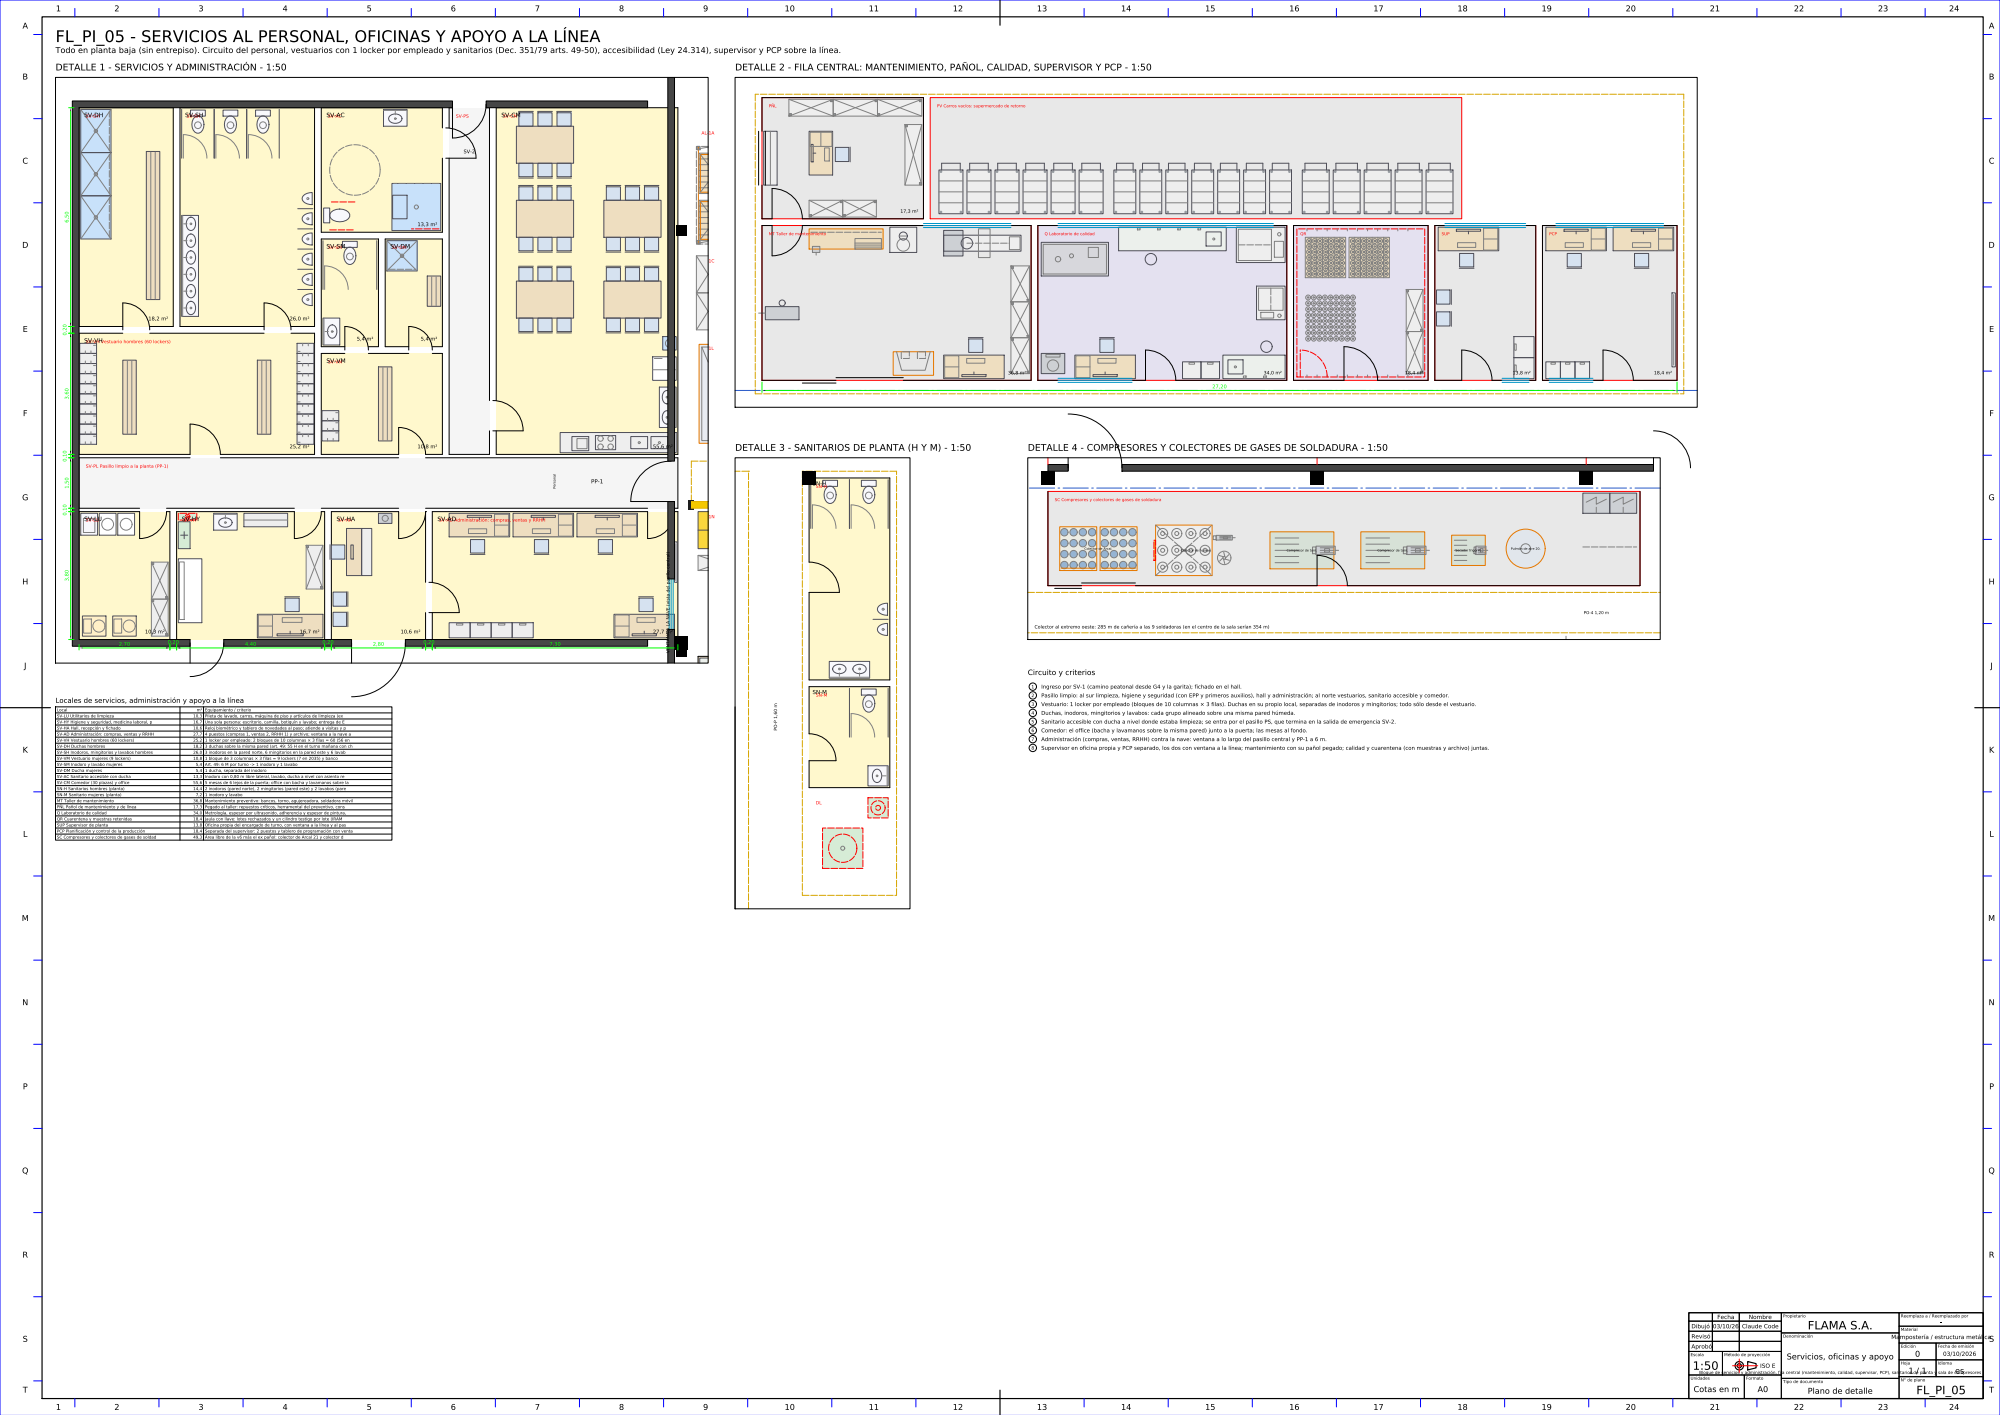
[picture p46: page 1]
