TadeoSinay/planos_industrial_flama/referencias/Layout_Planta_2035_rev4.pdf

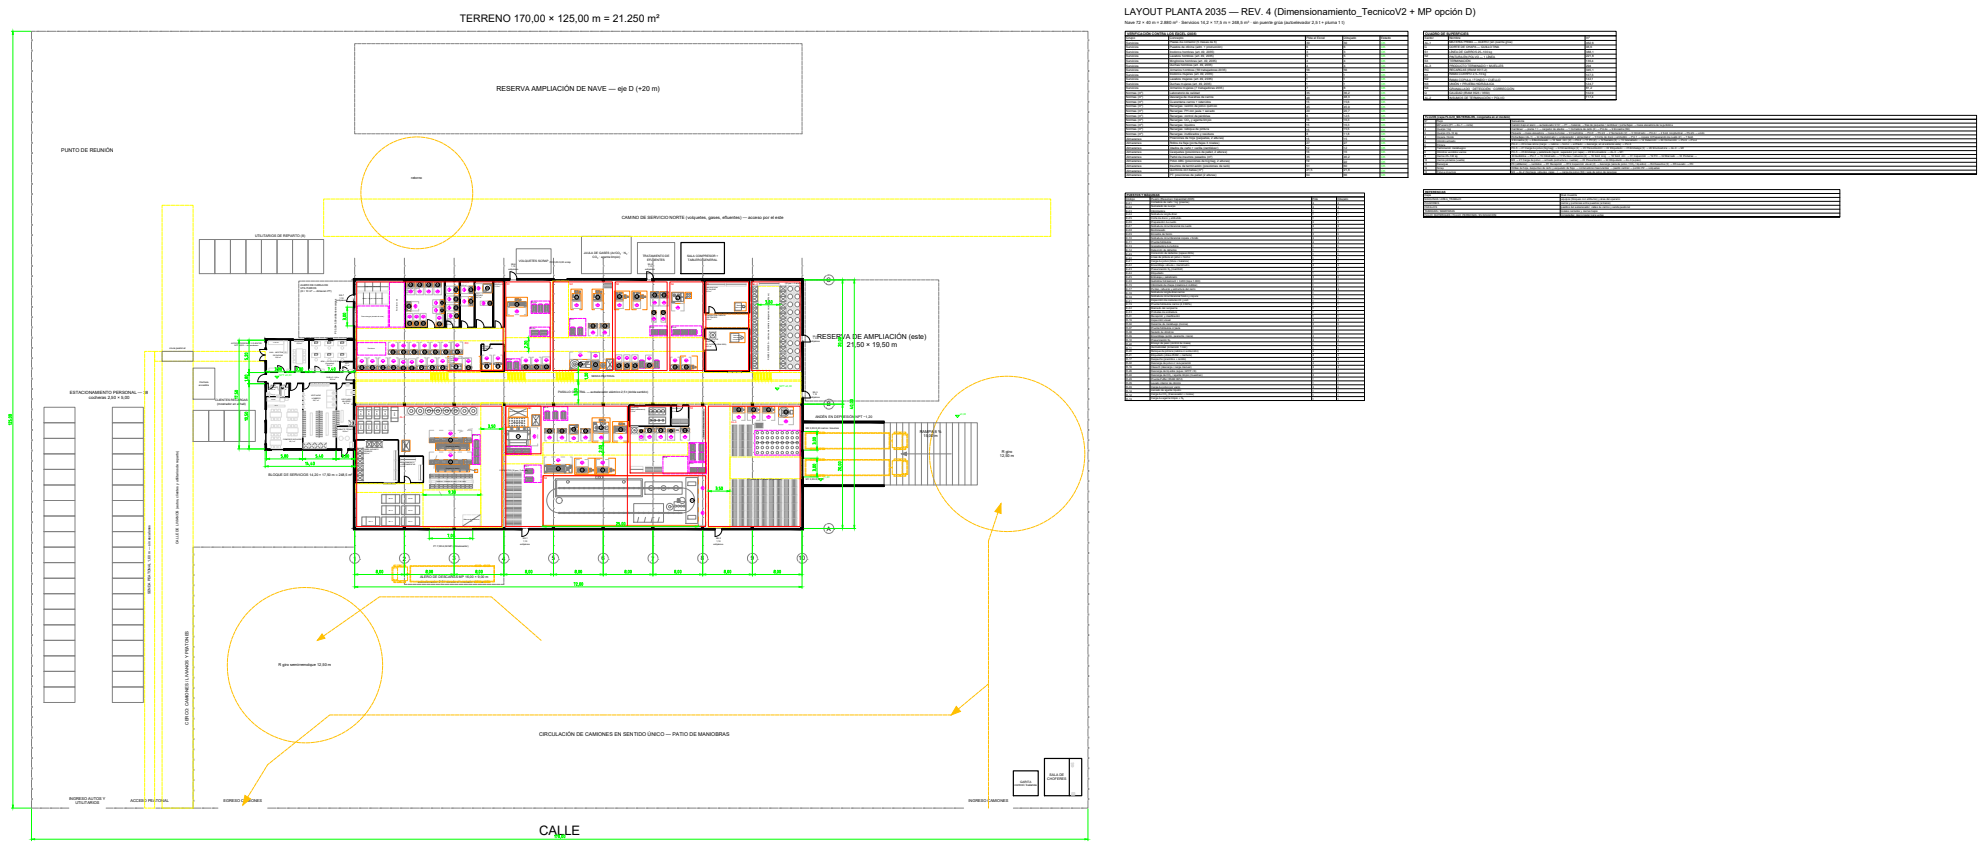
[picture p47: page 1]

LAYOUT PLANTA 2035 — REV. 4 (Dimensionamiento_TecnicoV2 + MP opción D)

RESERVA AMPLIACIÓN DE NAVE — eje D (+20 m)

CAMINO DE SERVICIO NORTE (volquetes, gases, efluentes) — acceso por el este

SALA COMPRESOR + TABLERO GENERAL

BIG BAGS POLVO ABC
(22 pos. × 2 alturas)

ALERO DE CARGA DE UTILITARIOS
antipánico P3 3,00×3,00 utilitarios recargas

RACKS 3 NIVELES — válvulas, manómetros, mangueras, cajas, film (60 pos.)

Jaulas 1 kg por concesionaria

Para entregar (armado de rutas)

DESCARGA DE MUESTRAS DE CARROS (IRAM 3550) 48,3 m²

PASILLO CENTRAL — autoelevador eléctrico 2,5 t (doble sentido)

CLIENTES RECARGAS
(mostrador en el hall)

Porta-flejes 3 niveles: 27 rollos (MP-05…10, 13)

Mesa elevadora de tijera

Estantería: obleas, precintos, O-rings

ANDÉN EN DEPRESIÓN NPT −1,20

Carros terminados + muestras en espera (a piso) · playa M2

CALLE DE LIVIANOS (autos, clientes y utilitarios de reparto)

BLOQUE DE SERVICIOS 14,20 × 17,50 m = 248,5 m²

Cantiléver: 10 atados de caño + 2 de varilla

PT: pallets de a 2 alturas (66 posiciones)

SENDA PEATONAL 1,60 m — sin escalones

ALERO DE DESCARGA MP 16,00 × 9,00 m
autoelevador 2,5 t desde el costado del camión

CIRCULACIÓN DE CAMIONES EN SENTIDO ÚNICO — PATIO DE MANIOBRAS
