TadeoSinay/planos_industrial_flama/referencias/Layout_Planta_2035_rev4_nave.pdf

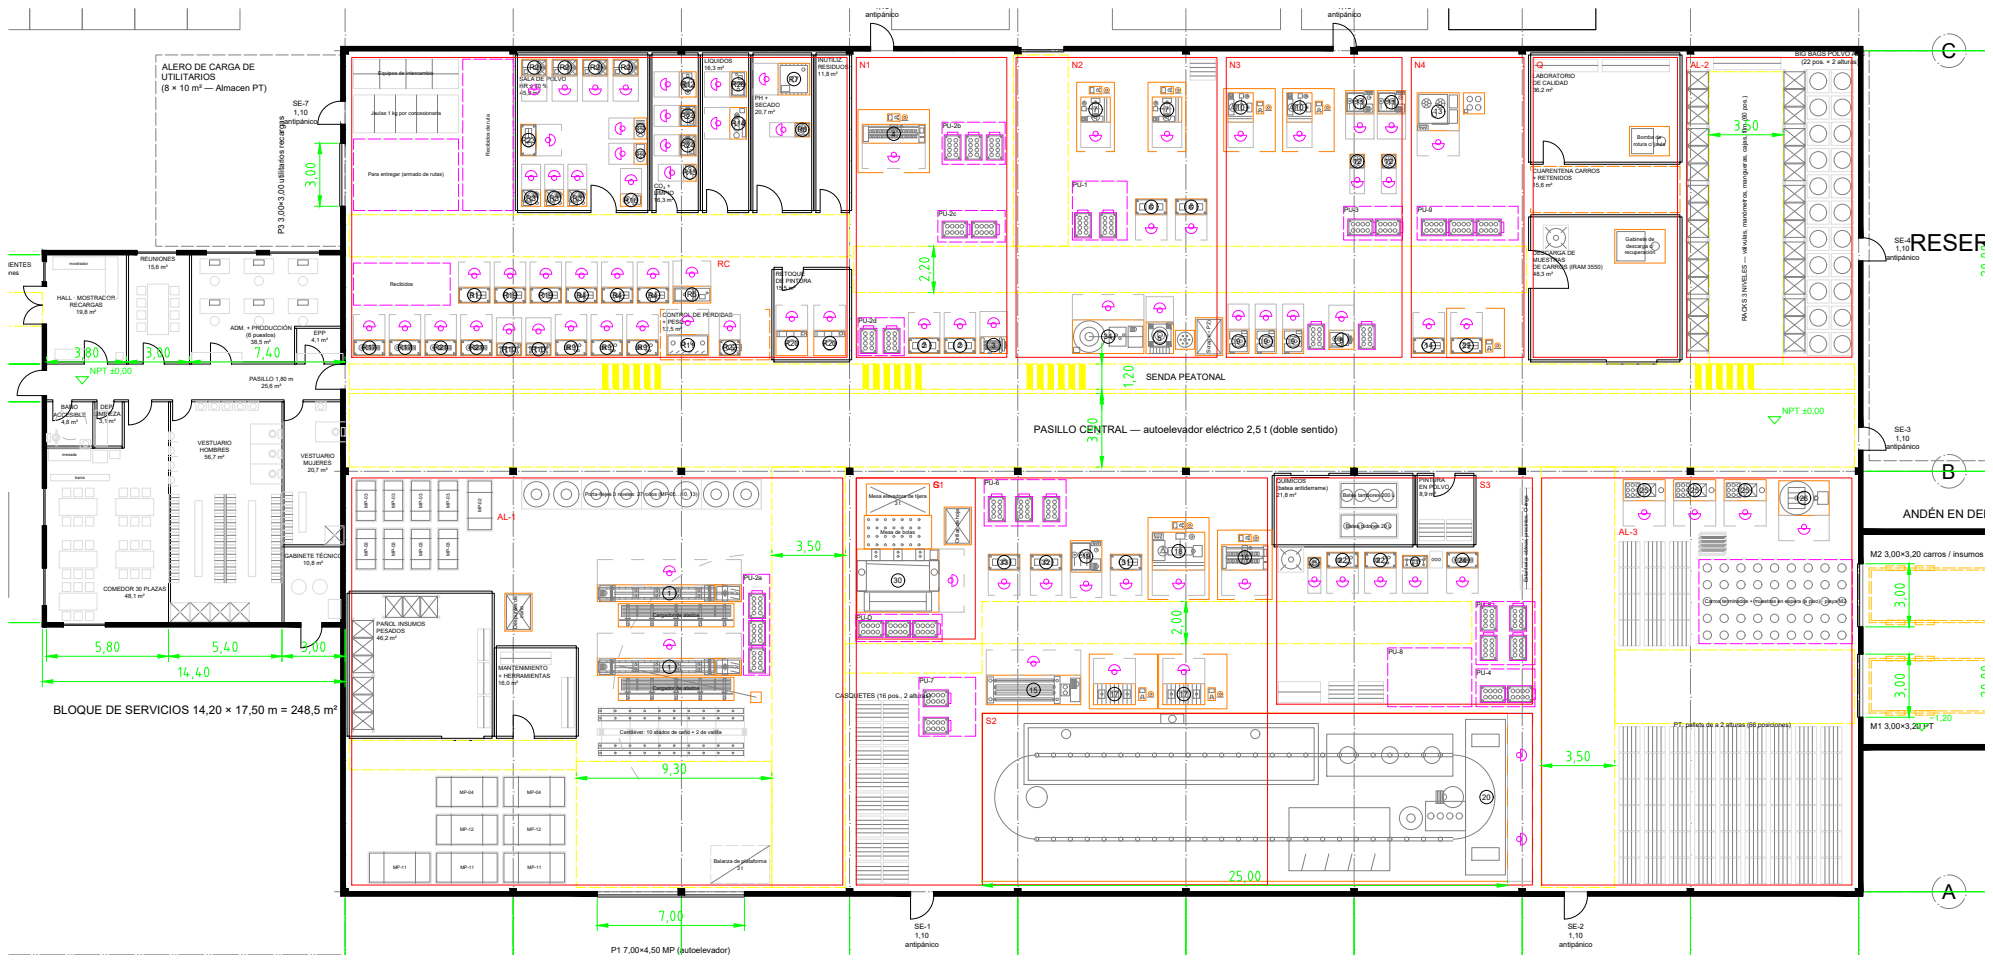
[picture p48: page 1]

BIG BAGS POLVO ABC
(22 pos. × 2 alturas)

ALERO DE CARGA DE
UTILITARIOS
(8 × 10 m² — Almacen PT)
antipánico P3 3,00×3,00 utilitarios recargas

RACKS 3 NIVELES — válvulas, manómetros, mangueras, cajas, film (60 pos.)

Jaulas 1 kg por concesionaria

Para entregar (armado de rutas)

PASILLO CENTRAL — autoelevador eléctrico 2,5 t (doble sentido)

Porta-flejes 3 niveles: 27 rollos (MP-05…10, 13)

Mesa elevadora de tijera

Estantería: obleas, precintos, O-rings

ANDÉN EN DEPRESIÓN NPT −1,20

Carros terminados + muestras en espera (a piso) · playa M2

BLOQUE DE SERVICIOS 14,20 × 17,50 m = 248,5 m²

PT: pallets de a 2 alturas (66 posiciones)

Cantiléver: 10 atados de caño + 2 de varilla
