TadeoSinay/planos_industrial_flama/(commit log)

2026-09-30 Estructura inicial: motor de lámina IRAM, convenciones de los 4 planos y checklist normativo
    Claude-Session: https://claude.ai/code/session_01E33CYXtZ2f33D1RjoRdR65
2026-09-30 Referencias planta
    [Comparacion_corte.xlsx, Costo oportunidad operario-maquina.xlsx, Dimensionamiento_TecnicoV2.xlsx, MP_Abastecimiento_Almacenamiento_FLAMA_OpcionD.xlsx]
2026-09-30 Layout de planta al año 10: 5 planos, memoria de cálculo y diagnóstico del rev4
    Modelo del layout en planta/layout.py (nave 120 × 36 m de una luz, flujo recto
    oeste-este con tren logístico de un sentido, circulaciones de personal y de
    materiales separadas) y cálculos en planta/calculos.py.
    - FL_PI_01 DIR de hilos del personal (A0 1:200)
    - FL_PI_02 flujo de operaciones con símbolos ASME y cursogramas (A0 1:200)
    - FL_PI_03 flujo de materiales con recepción de MP, análisis de peso y
    anti-sobrestock; hoja 2 de redes y efluentes (A0 1:200)
    - FL_PI_04 plano formal: implantación 1:200, planta acotada 1:100 en dos
    hojas, servicios 1:50, sanitario accesible 1:20 y corte 1:100
    - FL_PI_0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
    [FL_PI_01.dxf, FL_PI_02.dxf, FL_PI_03.dxf, FL_PI_04.dxf, FL_PI_05.dxf]
2026-10-02 Biblioteca de símbolos de máquinas en planta a escala real
    Cada equipo se dibuja con su detalle (bastidores, rodillos, mordazas, motores, tableros,
    resguardos y operarios) en lugar de un rectángulo.
    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
2026-10-02 Planos regenerados con máquinas dibujadas en detalle
    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
    [FL_PI_01.dxf, FL_PI_02.dxf, FL_PI_03.dxf, FL_PI_04.dxf, FL_PI_05.dxf]
2026-10-02 Layout en U: nave 96 × 50 m con pasillo central y lazo de pintura
    Banda norte (MP, corte y líneas T, K y G hacia el este), columna este de pintura y banda sur
    (terminación, PT, carros y recargas hacia el oeste). 0 cruces entre flujos de MP, SE y PT; el
    personal sólo cruza en sendas. Planos regenerados con las máquinas en detalle.
    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
    [FL_PI_01.dxf, FL_PI_02.dxf, FL_PI_03.dxf, FL_PI_04.dxf, FL_PI_05.dxf]
2026-10-02 Transportador aéreo del lazo de pintura dibujado en planta
    Viga en trazos, eje, ganchos cada 1,20 m y ruedas de desvío en las esquinas, uniendo carga,
    pretratamiento, hornos, cabina, enfriamiento y descarga.
    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
    [FL_PI_01.dxf, FL_PI_02.dxf, FL_PI_03.dxf, FL_PI_04.dxf, FL_PI_05.dxf]
2026-10-02 Layout v3: línea convergente paso a paso con el estilo gráfico del rev4
    Sigue el diagrama de bloques de FLAMA: guillotina, láser y embutido alimentan una sola línea
    (encastre, bordoneado, soldadura circ., PH, secado, granallado, defectos) que baja a pintura y
    vuelve por la banda sur a terminación, PT, carros y recargas. Nave de 88 x 44 m. Cada máquina
    lleva su número de paso, operario y área de trabajo; pulmones con carros entre pasos.
    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
    [FL_PI_01.dxf, FL_PI_02.dxf, FL_PI_03.dxf, FL_PI_04.dxf, FL_PI_05.dxf]
2026-10-02 Layout factible: carriles separados, acceso a stock y puestos, numeración única
    Pasillo central con carril de autoelevador de 3,8 m, defensa y senda peatonal de 1,2 m, con
    aberturas y sendas donde se cruza. PT con pasillo propio a casquetes y M3; terminación con calle
    de abastecimiento frente al rack; calle entre láseres; corredores de operarios en N3 y recargas.
    Numeración de pasos única (9.1, 9.2, ...; recargas R1-R22 en orden de proceso).
    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
    [FL_PI_01.dxf, FL_PI_02.dxf, FL_PI_03.dxf, FL_PI_04.dxf, FL_PI_05.dxf]
2026-10-02 Layout v4: logística, locales amueblados, servicios con circuito y menos láminas
    - Mobiliario y equipamiento en todos los locales (planta/mobiliario.py); verificación de local vacío
    - Servicios rehechos: hall y fichado, pasillo limpio, vestuarios, sanitarios, comedor, oficinas
    - Zona sin autoelevador, mamparas de soldadura, cruces X1-X16, portones rotulados; P5 suprimido
    - Tabla de manejo de materiales (métodos y tiempos) y función/frecuencia de portones
    - FL_PI_03 en una hoja; FL_PI_04 en una hoja 2A0 1:100 con implantación y corte
    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
    [FL_PI_01.dxf, FL_PI_02.dxf, FL_PI_03.dxf, FL_PI_04.dxf, FL_PI_05.dxf]
2026-10-03 Layout v5: medidas cotizadas, logística de MP/PT, oficinas con vista a la línea y seguridad
    - Equipos con la medida de su cotización (pintura Electricolor 22 x 13 m, láser, guillotina, prensa...)
    - Almacén de MP con calles A1/A2, carga directa a máquina, autoelevador con pluma, percha y gancho C
    - Almacén de PT con calles pasantes y muelles sin columnas; flota dibujada = calculada
    - Entrepiso de oficinas vidriado; núcleo sanitario de planta; tabiques, puertas y ventanas
    - Señalética IRAM 10005, BIE, pulsadores, garita; 1,0 m libre detrás de cada operario
    - Guerchet y políticas de stock; láminas por faceta (01 a 05); script para AutoCAD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
    [FL_PI_01.dxf, FL_PI_02.dxf, FL_PI_03.dxf, FL_PI_04.dxf, FL_PI_05.dxf]
2026-10-03 FL_PI_03: espacio entre la lista de señales y la tabla de evacuación
    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
    [FL_PI_03.dxf]
2026-10-03 v6: red de calles continua sin calles ciegas, cantiléver fuera de la playa de camiones, sin escuelita
    - Calles que se tocan (A1/A2/PO-1/PO-5 a la senda, T1-T3 y RC-N al pasillo central, EX-AT, PO-2-PO-E,
    PO-3/PO-L-A2); contorno único de la red en el dibujo
    - Cada extremo remata en calle, puerta o destino: SE-5 al final de PO-4, SE-10/SE-11 en recargas,
    puerta de SP-1 frente a PO-T, calle de pintura PO-PI, circuito A2 -> A1 del autoelevador
    - Cantiléver CT exterior oeste con patio y portón P7; detalle 1 de FL_PI_04 lo incluye
    - Escuelita eliminada: LB-1 libre a debatir
    - Fuentes de medida con criterio en lugar de 'estimado'
    - verificar.py: extremos de calle sin tolerancia, recorridos/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
    [FL_PI_01.dxf, FL_PI_02.dxf, FL_PI_03.dxf, FL_PI_04.dxf, FL_PI_05.dxf]
2026-10-03 v7: 4 portones, almacén de MP de seis rubros, scrap en el puesto, servicios y oficinas sin entrepiso
    - Camiones con ingreso a cada portón (G1 con garita y báscula, calles norte, sur y este; sale por G3);
    camino peatonal G4 -> SV-1 sin cruzar calles de camiones
    - Portones: P1 MP (7,20 m, caños atravesados), P2 recargas, muelle único P3, P4 pintura y granalla
    - Almacén de MP: Arcal 21, hojas, flejes, caños (cantiléver interior), cuellos y roscas, alambre MAG;
    válvulas/manómetros/pescantes en AL-2 con buffers por línea; polvos, agentes y N2 en SP-1
    - Scrap en guillotina, láseres y prensa al volquete por P1; embalaje diferenciado y precintos;
    3 autoelevadores (MP, carros y reca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
    [FL_PI_01.dxf, FL_PI_02.dxf, FL_PI_03.dxf, FL_PI_04.dxf, FL_PI_05.dxf]
2026-10-14 v8: procesos de los Word, almacenes del MRP, riel aéreo y jaula exterior de gases
    - Puestos en el orden y la disposición de W-MAN, W-CAR y W-REC; máquinas según X-MAN y X-DT.
    - Una sola recepción de MP (P1) con cuarentena; 3 portones (sin P4); calles de 5 m para el Heli CPCD50.
    - Almacenes según X-ALM v5: cantiléver de 31 m², casquetes sobre AN, procesado de 42 pallets (AL-PR, AL-PT,
    AL-PK) con calles PO-8 y PO-9; política de stock leída de la hoja Política de stock.
    - Riel aéreo de pintura con horno de curado 2 y retorno; jaula exterior JG con packs y manifold.
    - Manejo de materiales con los medios de W-MAN (un autoelevador para MP y carros, transpaleta al PT).
    - Láminas, mem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
2026-10-14 v8: auditoría contra los Word (muelle, pasaplatos, balanza, viajes)
    - Revendidos (entrada y salida) y carros al pintor cruzaban el muro sur fuera del muelle P3: van por P3, cada uno en
    su carril; la verificación ahora controla el muro exterior de la nave.
    - Recargas: 3 pasaplatos del recinto de polvo (W-REC) y rama PH -> secado -> carga.
    - Balanza de plataforma 1,20 × 1,20 m (W-MAN y W-CAR) en el depósito de polvo, donde entran los big bags.
    - Cilindrado de carros 33,6 m² (W-CAR ≈ 35 m²).
    - Manejo de materiales con los viajes por día de W-MAN y W-CAR; texto del paso del atado por P1.
    Claude-Session: https://claude.ai/code/se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
2026-10-15 v9: sin recargas, oficinas al SO, administración al este, P1 de 7 m
    - Recargas fuera de la planta: sin sector, equipos, portón P2, insumos ni dotación.
    - Oficinas de planta (mantenimiento, pañol, calidad, supervisor, PCP) en el ángulo SO;
    administración al este con entrada de visitas propia.
    - P1 de 7,00 m entre ejes 1 y 2; toda la MP entra por P1, P3 sólo despacha.
    - Horno único con dos pasadas del riel; pulmones sólo de W-MAN y W-CAR.
    - Carros 2.1 a 17 según W-CAR v9 y X-CAR; un solo autoelevador.
    - Cruces manuales declarados en su senda; verificador OK.
    Claude-Session: https://claude.ai/code/session_01E33CYXtZ2f33D1RjoRd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
2026-10-15 v10: layout rediseñado desde cero sobre el croquis del usuario
    Modelo nuevo (planta10/): almacén de MP al oeste, manuales al norte en tres filas
    y ala este, pintura de norte a sur, terminación y PT sobre el pasillo principal,
    carros al centro y al sur, servicios en el ángulo SO y administración en un anexo
    norte dimensionado con la dotación 2035 sin recargas. Verificador nuevo
    (superposiciones, huecos sin nombre, frentes de operario, autoelevador, columnas,
    puertas, sanitarios). Cinco láminas A0 (DXF + PDF) y planilla de zonas y equipos.
    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
2026-10-15 v10b: relleno de cada área con criterio, carros según demanda 2035, portones P3/P6 y anexo del croquis
    - Lugares de carros rodantes según el pico 2035 de X-CAR (279/mes = 70/semana): pulmón de
    despacho 48, pintados 25, pérdidas 20, retenidos 80 y liberados 80, demarcados por color.
    - Fila de fabricación de carros con todos los elementos de las tablas de espacios de W-CAR.
    - Manuales: columna este (circunferencial, espesor, PH, secado) y granallado, detección y
    cuelgue hacia la pintura; riel con cuelgue al sudoeste.
    - Portones P3 (a la pintura tercerizada) y P6 (regreso de pintados) en el muro sur.
    - Anexo de 27,6 x 14,3 m con la disposición del croquis del usuario y sus accesos.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
2026-10-15 v11: carros y PT de manuales según los Word al pie de la letra
    - Carros (W-CAR): 120 en despacho, 120 pintados, 30 en pérdidas, 180 retenidos,
    100 liberados y la zona de rechazados de 5 x 3 m, en filas demarcadas.
    - PT de manuales (W-MAN 25): rack de PT y rack de cilindros sobre un pasillo de
    5 m, con 80 posiciones (7,9 pallets por día; 40 por semana y 30 para diciembre).
    - Cuarentena de 10 x 2,5 m con jaula de tubos de gas y rack de chapas por espesor.
    - Se agregan los carros y elementos de manuales que nombra el Word, numerado
    junto a la soldadura del cuello y pallet de cajas plegadas.
    - Lámina 02: el panel ya no pisa la burbuja del eje B.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
2026-10-15 v12: Word de carros y de manuales al pie de la letra, marcas del croquis de oficinas, portones y cortes
    - Almacén por secciones de X-ALM v5 (R1 de 80 posiciones pintado por sección), racks propios de
    carros de W-CAR (12 + 8 posiciones), retenidos de 4 x 1,5 m, calle de chapa de 10 x 2 m con el
    paquete por el lado de 3 m, pilas de pallets vacíos, estantería de identificación, 3 carros de
    abastecimiento y franja de descarga de 15 x 5 m frente a P1.
    - Depósito de polvo según W-CAR: big bags en el piso de a 2; revendidos al rack de PT (5 módulos).
    - Manuales: tramos al lado de la cortadora y del encastre, carro porta-matrices, cajones de
    rechazos, rejilla de goteo, estantes de en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
2026-10-15 v13: carros con las reglas de W-CAR y la demanda 2035, banda sur compacta y rótulos sin pisar equipos
    Lugares de carros: 317 en lugar de 550 (despacho 84, pintados 49, sala de pérdidas 17,
    retenidos 74, liberados 70, rechazados 23) con el mes pico de 2035 de X-CAR; reservas
    RV-C1 a RV-C3, entrada de cilindros C-16A, flujos y corte A-A por y = 6,0 m. Franjas sin
    uso unidas a C-03, C-05, C-06 y C-10.
    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
2026-10-16 v14: PH y secado de carros junto a manuales, granallado y detección arriba, terminación compartida y PT unificado al sur
    Pintura vertical con el cuelgue arriba y la descarga en la punta sur; terminación de
    manuales y carga/pérdidas/etiquetado/ensayos de carros cruzando el pasillo; PT de
    manuales (90 posiciones, P4) y de carros con rampa TRAN-IN-240 y furgón Renault
    Master por P2; pulmones 11 y 12 contra el pasillo con el camión de la pintura por P3;
    portón P7 y playa de scrap al norte del almacén.
    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
2026-10-16 v15: PH y secado de carros junto a los de manuales, pulmones con 48 por semana y 2 envíos, pasillos de racks de 3,6 m, administración del plano del usuario y accesorios de los Word
    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
2026-10-16 v16: seguridad e higiene: salidas y recorrido de escape calculados, matafuegos con cobertura de 15 m, residuos especiales, inflamables, limpieza, pañol de EPP y primeros auxilios, gases en jaula y lá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
2026-10-16 Palletizado del PT simplificado: sólo cuentas en 5 hojas
    Sin LEEME, Fuentes ni esquemas; fuentes en la hoja Datos. Datos,
    Produccion, Pallet, Camion y Escenarios (viajes por semana mes a mes y
    frecuencia del mes pico por escenario).
    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
2026-10-16 Palletizado: mix como carga del camión con pallets unitarios por tipo
    El escenario 5 reparte los pallets (o carros) enteros de cada tipo en el
    vehículo según la producción de la semana pico, en vez de un pallet
    promedio.
    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
2026-10-16 Palletizado: mix con 1 kg, por demanda del mes pico y capacidad del pallet
    El escenario 5 de manuales y de cilindros suma el 1 kg. Los pallets de
    cada tipo salen de la demanda del mes pico del grupo dividida por las
    unidades por pallet; la hoja de producción pasa a llamarse Demanda.
    Frecuencia en viajes por mes cuando hay 1 viaje por semana o más.
    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
2026-10-16 Palletizado: camión chico GyL baranda volcable para los manuales
    Carrocería GyL para camión liviano de 4,30 m (6 pallets, 6 t de carga
    útil): el mix de manuales del mes pico sale en 10 viajes por mes. Los
    cilindros siguen en el sider. Fila de pallets por viaje promedio.
    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
2026-10-16 Palletizado: recargas de la planta industrial con sustitutos
    Hojas Recargas y Recargas_camion: recargas de la planta industrial
    (61,5 %), recargados + sustitutos como máximo, jaulas tipo A, tipo B y
    pallets de rodantes del Word de recargas, y viajes del Iveco de 2 t con
    el control del peso de un viaje lleno.
    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
2026-10-16 Palletizado recargas: jaulas B de 2 pisos y comparación de vehículos
    Las jaulas tipo B llevan 2 pisos (el Word admite más de uno). La hoja
    Recargas_camion compara el Iveco del Word, el camión chico y el sider
    por lugares y por peso, y elige el de menos viajes.
    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
2026-10-16 Palletizado recargas: máximo de 3 viajes por día y comparación con la demanda
    Sustituto de 1 kg para el 1 kg (IRAM 3517-2 9.4.5) y jaula tipo A de 2
    pisos: recargados + sustitutos en el sider GyL balancín dan 3 viajes por
    día. Tabla que compara por día la demanda de PT, los recargados y los
    sustitutos con sus viajes.
    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
2026-10-16 Palletizado: vista superior de los vehículos por escenario
    Hoja Vistas y PDF con la carga de cada vehículo en los 5 escenarios:
    manuales en el camión chico, rodantes en la Master (por zona), cilindros
    de manuales y de rodantes en el sider, y el viaje tipo de recargas.
    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
2026-10-18 Dimensionamiento de recargas: planta comercial e industrial
    Un generador para las dos plantas; cada una aplica su % de Proyecciones
    (Indexado V61 71,2 % / V63 28,8 %). PH 1/5 y 1/2, vida util 1/20 y CO2
    1/30 (IRAM 3517-2 Anexo E), cambio de polvo 1/10 (9.9.4 a), usados,
    falla de PH y rotos de Proyecciones, PH anual de mangueras (9.7.1.4),
    perfil mensual con la rampa del crecimiento, maquinas y turnos en 1 y
    accion sugerida indexada a la lista de acciones.
    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
2026-10-18 Dimensionamiento de recargas: hoja sobrestock_sustitutos
    Equipos afuera = retiros por dia del mes pico x dias afuera (ruta +
    cola si la ruta del agente pasa el 100 %), agrupados por sustituto
    equivalente (9.4.5). Stock, sobrestock, alta anual y mantenimiento
    anual del stock, que entra al Plan mensual del ano siguiente y suma al
    aprovechamiento.
    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
2026-10-18 Dimensionamiento de recargas: perfil mensual plano (1/12)
    Se reemplaza la rampa del crecimiento por el perfil plano, que se
    justifica con IRAM 3517-2 9.2.1 y 9.4.14 a): cada equipo vuelve en su
    mes y el crecimiento se toma entre anos.
    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
2026-10-18 Dimensionamiento de recargas: hoja de sustitutos en 4 pasos
    La hoja va antes del Plan mensual y no depende del aprovechamiento:
    paso 1 tipo -> sustituto equivalente, paso 2 stock, paso 3 alta anual
    (ABC a fabricar, revendidos a comprar y kits), paso 4 mantenimiento,
    que entra al Plan mensual. El Resumen muestra el aprovechamiento
    consolidado (clientes + sustitutos).
    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
2026-10-18 Sustitutos del mismo tipo; la comercial compra todos
    Cada tipo lleva sustituto de su mismo tipo (sin agrupar por capacidad).
    Origen segun la planta: la comercial compra todos, la industrial
    fabrica los ABC y compra los revendidos. Notas de la hoja reducidas.
    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
2026-10-18 Sustitutos: ciclo por rubro desde el mix y los tiempos de operacion
    Matriz de recargas 2035 por rubro y tipo de cada planta (hojas
    PROYECCION). Minutos por equipo de cada tipo con la ruta y el tiempo
    tipo de cada puesto; minutos por rubro con su mix; dias de proceso =
    minutos / minutos del turno (minimo 1); ciclo del sustituto = retiro +
    proceso + devolucion, porque va y vuelve en el mismo camion.
    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
2026-10-18 Recargas: IMPORTRANGE, aprovechamiento priorizado y colores por accion
    PROY_Indexado como la del usuario, con IMPORTRANGE a Proyecciones en
    B4 (recargas) y B25 (% zonal). Sin rellenos grises en datos y
    resultados. Fila de horas de planta por rubro en sustitutos. Maquinas
    y turnos cargados con la prioridad de Manuales: antes del ano del 2do
    turno se agrega maquina u operario; desde ese ano, turno. El
    aprovechamiento se colorea segun la accion (turno, maquina, operario,
    tercerizado, revisar).
    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
2026-10-18 Recargas, Manuales y Carros: sustitutos de fábrica, lote por rubro, IMPORTRANGE y aprovechamiento indexado
    - Dimensionamientos de recargas: PBA Interior afuera (V61/V63 importados), lote por rubro con días en planta
    y ciclo según turnos, alta ABC desde la planta industrial (comercial: cilindro vacío por la ruta corta;
    industrial: terminado), perfil de llegada de Manuales/Carros y hoja Links.
    - Manuales y Carros: datos_base con IMPORTRANGE, sustitutos de cada planta en plan y demandas (sin y con
    sobrestock), aprovechamiento leyendo la tabla de turnos (sin /2 a mano) y colores por formato condicional.
    - Recargas.xlsx rearmado: todo importado de los dimensionamientos, perfil plano, ca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
2026-10-18 Recargas: criterios por agente, equivalencia de rodante y límite duro del 90 %
    - parametros_recargas: matriz "qué le pasa al equipo" por agente (norma, Proyecciones o a confirmar), columna
    "Cuándo pasa" por puesto (tabla de operaciones del Word) y equivalencia del rodante con los tiempos de
    Manuales y Carros (IMPORTRANGE).
    - Laboratorio: control diario de la tolva en lugar de un % por equipo.
    - Ningún puesto pasa el umbral: con 2 turnos se agrega máquina (recargas, Manuales y Carros).
    - Links y bloque de sobrestock de Manuales en gris.
    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
2026-10-19 Recargas: estacionalidad por rubro, turnos en un solo año, picos del MRP y Excel compactos
    - Estacionalidad de recargas por rubro con fuente: Automotor con el perfil E01 del MRP (VTV por terminación
    de patente y viajes de verano), Educación con la recarga estatal de febrero antes de clases; el resto
    parejo por IRAM 3517-2 9.2.1 y 9.4.14. Perfil mensual por tipo según el mix de rubros de cada planta.
    - Capacidad: todos los turnos entran en el año del 2° turno y ese año se dimensiona hasta 2035; después
    no se agrega máquina. Ningún puesto pasa el 90 %.
    - Manuales y Carros: estacionalidad por IMPORTRANGE del MRP; sustitutos sumados en las filas del Plan
    mensual del grupo (sin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
2026-10-19 Recargas: automotor por VTV y patentamientos, fuentes de cada rubro sin mes fijo
    - Automotor ya no usa el perfil de ventas del MRP: VTV por terminación de patente (febrero a noviembre)
    para la flota obligada y aniversario de compra (patentamientos ACARA 2025) para los exentos (6,5 %).
    - Edificios, hoteles, industrias, salud y supermercados: fuente de cada uno (CABA Leyes 941, 4631 y
    6116; PBA Ley 14.701, Decretos 4992/90 y 12/2005; Res. SRT 463/09 y 529/09). Ninguna fija un mes: parejo.
    - Datos de la estacionalidad en celdas propias (escuelas estatales, patentamientos, flota, % exento).
    Claude-Session: https://claude.ai/code/sessi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
2026-10-19 Recargas: Excel sin textos largos, tiempos resueltos, lote de Proyecciones y autos con pico en enero y diciembre
    - Excel con referencias cortas (§) al Word de justificación; sin columnas de explicación, desglose ni notas.
    - Automotor: 12 % en enero y en diciembre, resto parejo. Educación: estatales ponderadas por las zonas
    de la planta (CABA 51 %, PBA 72 %).
    - Tiempos por el paso a paso: carga ABC 100 s, pintura 615 s, Clase D 205 s (descarga en el tambor de
    descarte), PH de mangueras 300 s (9.7.5.3). Laboratorio: 1 ensayo por tolva de 240 kg.
    - Lote por cliente = parque ÷ establecimientos de Proyecciones 2033, con el piso del Dec. 351/79.
    - Logística: jaulas de 75 kg, 75 kg por pe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
2026-10-19 Recargas: Word de justificación con el desarrollo de cada decisión y su efecto por puesto
    - salida/Justificacion_Recargas.docx: demanda, estacionalidad por rubro, criterios por agente, tiempos y
    resultado 2035 de los 29 puestos, equivalencia de rodante, sustitutos y lote, capacidad y turnos,
    Manuales y Carros, logística, parámetros de planta, pendientes de la visita y fuentes.
    - Los números se leen de los Excel recalculados; las referencias § de los Excel apuntan a sus secciones.
    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
2026-10-20 Corte de chapa: Excel de alternativas compacto, dos guillotinas en serie y 1 kg en chapa
    - Comparacion_corte.xlsx rearmado en 7 hojas (Resumen, Datos, Links, Demanda, Piezas, Corte, Cálculo),
    todo con fórmulas y la demanda por IMPORTRANGE.
    - Medidas de cuerpos y discos del plano; disco por igualdad de superficie con su relación de embutido.
    - Guillotina 1 CENA 8 × 3200 (franjas) y guillotina 2 QC12Y 6 × 2500 (piezas, franjas en paralelo).
    - Cuerpo de 1 kg en chapa de 0,9 mm en todas las alternativas; bobina madre con patrones por LP.
    - Word de esquemas de corte de todos los formatos y del cuerpo de 1 kg.
    Claude-Session: https://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
2026-10-20 Corte de chapa: tipo de cambio fijo 1420, 20 golpes por minuto confirmados y sin pendientes de planos
    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
2026-10-21 Corte de chapa: 1.er corte por el lado corto, G1 Ermaksan, franjas de hojas enteras por ciclo y un solo Word
    - Excel renombrado a Analisis_alternativas_corte_chapa.xlsx, con la hoja Links primera y todos los IMPORTRANGE ahí
    - G1 Ermaksan CNC HGS 2600-6 (20 golpes/min, tope 1.000 mm); G1 hace solo el 1.er corte y G2 solo el 2.º (u orilla)
    - Franjas en paralelo de hojas enteras, ciclo de hasta 4 hojas con menos tandas por hoja
    - Verificación de cuchilla y tope en las dos guillotinas y masa de la franja
    - Tabla para que Manuales y Carros importen piezas, golpes y tandas por hoja
    - Esquema_de_corte_en_guillotina.docx reemplaza a los dos Word de corte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
2026-10-21 Aprovechamientos: hoja Links primera con todos los IMPORTRANGE y Manuales v4 del grupo indexado
    - Manuales sobre la versión 4 del grupo (26 puestos: G1 Ermaksan, G2 QC12Y, cilindradora y TIG del 1 kg)
    - datos_base con Proyecciones y alta de sustitutos ABC (paso 4); estacionalidad del MRP; corte desde el Excel de corte
    - Máquinas y turnos con la regla del 90 % y 2.° turno en un solo año
    - Carros y recargas con todos los IMPORTRANGE en la hoja Links; equivalencia del rodante con las filas nuevas de Manuales
    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
2026-10-21 Corte: nesting (hojas, 3 etapas, 25+50 kg combinados), esquema de embutido y guillotinas compartidas
    - Hoja Nesting: plan de 3,2 mm P1 + P3/P4 (mínimo de hojas; P2 no suma) y compras de D con hojas combinadas
    - Word: secciones de nesting, fleje y relaciones de embutido, una o dos filas, tiempos W-MAN/W-CAR y carga consolidada
    - Manuales y Carros: carga de carros en G1 y G2 con el modelo de tiempos de W-MAN y W-CAR
    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
2026-10-21 Aprovechamientos: ensayo de pérdidas de W-MAN, estatales en 3 meses y puestos de recargas unidos
    - Manuales: ensayo de pérdidas en tandas de 6 (40 s, W-MAN); el puesto más cargado pasa a ser la pintura
    - Recargas: las escuelas estatales se reparten de febrero a abril (parámetro en B49), en vez de todo en febrero
    - Recargas: BC y Clase D con su equipo exclusivo dentro de los puestos de polvo; CO2 y halogenado recuperan y cargan en
    la misma máquina; descarga y carga de líquidos en un solo puesto (23 puestos)
    - Corte: regenerado con los sustitutos nuevos
    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
2026-10-21 IMPORTRANGE listos para Google Sheets: bloques vacíos salvo la primera celda
    arreglar_dummy ahora también vacía en el XML las celdas COMPUTED_VALUE de
    cada bloque (si tienen algo, Sheets no expande el resultado y da #REF!).
    Los demás valores calculados quedan guardados. Regenerados los 6 Excel;
    Manuales y Carros toman además las piezas por hoja vigentes del corte.
    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
2026-10-21 Balanceo de materiales y de línea con Links e IMPORTRANGE
    Nuevo balanceo/generar_balanceo.py -> salida/Balanceo_Materiales_y_Linea.xlsx:
    - Links: IMPORTRANGE del MRP, los Aprovechamientos (manuales, carros y
    recargas industrial) y el Excel de corte.
    - Resumen: año elegible; demanda, producción y compra del MRP por
    producto, % de sobrestock y checks (producción >= demanda, el MRP
    cubre la producción), y la matriz de todos los años.
    - Materiales: por línea, MP que entra (familia, formato, cantidad),
    semielaborados, scrap/desechos/mermas, PT y balance de acero.
    - MP_detalle: cascada del MRP ítem por ítem (compra contra lo necesario
    para la producción).
    - Linea: balanceo por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
2026-10-21 Balanceo con el MRP alineado y % a CABA en revendidos
    Regenerado con el MRP que compra por la producción de los
    Aprovechamientos: todos los checks en verde. La cascada de revendidos
    aplica el % de unidades que van a CABA (tarjeta AGC), como el MRP.
    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
2026-10-21 Balanceo: marca al final de cada bloque IMPORTRANGE
    Con los bloques vacíos, Google Sheets armaba Links hasta la última celda
    con contenido (fila 2212) y las fórmulas que leen las últimas filas de
    los bloques daban «La referencia no existe». Cada bloque lleva ahora una
    celda ="" justo afuera de su esquina inferior derecha.
    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
2026-10-23 Trazabilidad: Excel corto con el sistema y las solapas del QR
    Nuevo trazabilidad/generar_trazabilidad.py -> salida/Trazabilidad_FLAMA.xlsx:
    resumen (grabado en el cuerpo con la Pannier ADP120160D: texto IRAM 5.1 +
    cuño DPS + DataMatrix), flujo por etapa con lo que queda registrado,
    solapas técnica y comercial del QR con la historia, y qué información da.
    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
2026-10-23 Trazabilidad v3: renders 3D, profundidad a escala, sistema por lote con hoja de ruta, pasos intra/extraplanta, arquitectura e interfaces
    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
2026-10-23 POC app de trazabilidad: recorrido de un lote del Plan mensual en 15 pasos (build desde el Excel, QR reales)
    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
2026-10-23 POC trazabilidad v2: diseño FLAMA, atención al cliente, manual MT-01 y desvíos
    - App en 5 vistas (inicio, recorrido, atención al cliente, manual, desvíos) armada
    desde plantilla.html + js/*.js + img/*.webp por build.py.
    - Recorrido de 16 pasos con la normativa de cada uno: partida DPS, estampilla y
    tarjeta (Res. 349/07), SGM batch (Res. 32-AGC/15), garantía, presupuesto,
    constancia y datos personales (Ley 24.240, Ley 25.326), reclamo con traza.
    - Atención al cliente: portal del QR, bandeja con plazos y matriz normativa.
    - Manual MT-01: responsabilidades, registros, 12 procedimientos, buscador de
    traza, retiro preventivo, contingencias e indicadores.
    - Desvíos: Pareto, carta p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
2026-10-23 Trazabilidad v4: Word con la app, atención al cliente, MT-01 y desvíos; app lista para Vercel
    - Word v4: secciones 11 a 14 (app con capturas, plazos y matriz normativa de
    atención al cliente, manual MT-01, reglas, cartas y registro de desvíos).
    Las tablas salen de app/contenido.json, las mismas que muestra la app.
    - app/capturas.js: capturas de la app (trazabilidad/capturas) y contenido.json.
    - vercel.json: /m/<serie>, /r/<remito> y /p/<pallet> abren la app en la vista
    que corresponde (el QR de la etiqueta abre la página pública del equipo).
    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
2026-10-23 Vercel desde la raíz del repo: publica trazabilidad/app como sitio estático
    Con este vercel.json el proyecto se puede importar con Root Directory ./ y
    Framework Other: no instala nada, publica trazabilidad/app y manda /m/<serie>,
    /r/<remito> y /p/<pallet> a la app.
    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
2026-10-23 App de trazabilidad rehecha como sistema de gestión de FLAMA (sin portada)
    - 13 módulos: tablero, órdenes, calidad, etiquetado, expedición, equipos,
    recargas, reclamos, clientes, desvíos, insumos, reportes y configuración.
    - Datos reales: órdenes y series del año desde el Plan mensual de
    Aprovechamiento_Manuales/_Carros, plan de Aprovechamiento_Recargas, 125
    insumos de FLAMA_MRP (consumo 2026 y plazos) y modelos de FLAMA_BOM.
    Estados, clientes, remitos, stock y reclamos son datos de prueba.
    - Reglas dentro del sistema: partida DPS, contraste de manómetros (bloquea el
    cierre), rechazos bloqueados en etiquetado, plazos de reclamos, archivo batch
    del SGM y libro de actas DP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
2026-10-23 Sistema de gestión v2: tablero intraplanta/extraplanta e historiales
    Tablero técnico partido en trazabilidad intraplanta (WIP por etapa, FPY,
    Cpk por modelo con n >= 5, cartas I y p, Pareto, lotes de insumo, medición)
    y extraplanta (cadena de custodia, tarjetas por jurisdicción, vencimientos,
    lead times, recargas, reclamos y retiros). Historial de lotes y página de
    cada matafuego o cilindro con hoja de ruta, ensayos, custodia y eventos
    encadenados por hash. Instalaciones, traza y retiros, registro de eventos.
    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
2026-10-23 Word de trazabilidad: sección 11 con tableros intra/extraplanta e historiales
    Indicadores de cada tablero con cálculo, meta y fuente; historial de lotes
    y de cada matafuego o cilindro con capturas nuevas. En la app: horas del
    historial en orden de puestos, embalaje hecho al llegar a depósito PT y
    rechazados en PH sin carga ni N2.
    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
2026-10-23 Sistema de gestión v3: AMFE, plan de control, estados de lote y origen de los datos
    AMFE de proceso y de campo con O calculada de los registros (rechazos por
    causa, remitos, recargas, reclamos, retiros) y regla de acción; plan de
    control de DOC-02 y DOC-01 con estado de instrumentos y resultado del mes.
    Estados del lote con Gantt de estadios, tiempo medio y retención; estados
    del equipo, de la OS y del reclamo. Vista de origen de los datos intra y
    extraplanta. Lote con pestañas de estadios y ensayos L1-L5. Word: 11.6 a
    11.8 con las mismas tablas que muestra el sistema.
    Claude-Session: https://claude.ai/code/session_01E33CYXtZ2f33D1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
2026-10-23 Sistema de gestión: solo datos reales, sin simulación
    Todo lo que muestra sale de los archivos del proyecto (plan, capacidad y
    aprovechamiento por puesto, pallets y camiones, zonas, rubros, tasas, MRP,
    BOM, equipos de medición del proyecto) o de lo que se registra en el
    sistema. Los registros arrancan vacíos y se cargan con formularios: etapas
    con firma y lote de insumo, cierre con rechazos, pesadas, L1-L5 y pintura,
    contraste de instrumentos, clientes, remitos, recepción, instalación,
    recargas, bajas y retiros. AMFE con O de registros, tasa del proyecto o
    criterio. Word sin ejemplos inventados.
    Claude-Session: https://claude.ai/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
2026-10-23 Trazabilidad interna simple: kanban de MP con cámaras, PT por zonas, fichas de control y marcado sin QR
    App nueva en trazabilidad/simple con la estructura y el estilo de la app de gestión interna
    (barra de contexto, pestañas, búsqueda, Nueva ficha, layout del plano rev10):
    - Kanban de las 125 MP con seguridad, punto de pedido (seguridad + consumo mientras llega)
    y máximo de MP-FLAMA2035 › Stock_MP; cámaras por almacén con la señal kanban física.
    - Kanban de PT por zonas (rack 15 × 3 × 2, carros, andén, reventa, sustitutos, pintura)
    con mes de fabricación, FIFO y días fijos de despacho (PTPINTADO-FLAMA2035).
    - 16 fichas de control (fabricación, recargas y revendidos) con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
2026-10-23 Vercel: publicar desde dist (app de trazabilidad nueva en / y la anterior en /gestion)
    La compilación no encontraba la salida anidada trazabilidad/app. Ahora el buildCommand copia
    trazabilidad/simple/index.html a dist/index.html y trazabilidad/app/index.html a
    dist/gestion/index.html, y outputDirectory es dist. Sin las redirecciones /m, /r y /p del
    sistema con QR, que ya no se usa.
    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
2026-10-23 Trazabilidad: arranca con datos de ejemplo, menos texto y foto por cámara
    - Datos de ejemplo marcados (banda amarilla, «Empezar en limpio») armados con los
    parámetros reales: stock entre seguridad y máximo de cada MP, pallets del PT con sus
    unidades por pallet y un lote recorrido por sus fichas.
    - El kanban compara la posición (stock + pedido en camino) con el punto de pedido; la
    columna «Bien» arranca plegada.
    - Textos de cada pantalla en una línea; fuentes en un desplegable.
    - Cámaras con lugar para la foto del almacén: se sube desde la app o se incrusta desde
    trazabilidad/simple/fotos al armar.
    Claude-Session: htt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
2026-10-23 Trazabilidad: kanban sin cámaras con planilla de conteo, lugares del almacén y layout de la app de gestión
    - Se sacan las cámaras: el stock de MP se carga con la planilla de conteo (Excel o CSV, o pegado
    desde Excel), con vista previa antes de aplicar; la app descarga la planilla entera o por almacén.
    - salida/Planilla_conteo_MP.xlsx: una hoja por almacén, lugares en orden, stock contado y estado.
    - Pestaña Almacén MP: cada almacén con sus lugares reales (Almacenes, col. E) y el lugar fijo de
    cada código (reparto por la columna U de Stock_MP); racks por módulo y nivel.
    - Layout igual al de la app de gestión: mismos puestos y recorridos, zoom, filtros por línea y
    recorrido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
2026-10-23 Trazabilidad: semáforo por almacén, despacho con n° de serie y formato de almacenamiento
    - Pestaña Semáforo: cada almacén con sus luces, la regla de la tarjeta kanban de su formato y cada
    código en bultos (rojo hasta la seguridad, amarillo hasta el punto de pedido, verde hasta el máximo).
    - Pestaña Despacho: el número del marcado a la etiqueta de serie, al pallet y al remito; despacho
    parcial por rango de series; semáforo del PT; últimos despachos.
    - Cada lugar del almacén y cada tarjeta del kanban se dibujan en su formato de almacenamiento.
    - FAB-11: control de etiqueta de serie igual al marcado y estampillas IRAM.
    - Word con las secciones 2.3 y 3.2.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
2026-10-23 Trazabilidad: días de stock en el semáforo y en todas las vistas
    Días de stock = stock ÷ consumo por día (Stock_MP, col. G; en el PT, venta por día, Stock_PT col. F).
    Se muestran en el semáforo (por código, con seguridad, punto de pedido y máximo en días, y el
    código con menos días de cada almacén), en las tarjetas del kanban, el detalle de cada MP, los
    lugares del almacén, la vista previa de la planilla, el semáforo y el kanban de PT y el dashboard.
    La planilla de conteo suma «Consumo por día» y «Días de stock» (fórmula). Word actualizado.
    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
2026-10-23 Trazabilidad: nombres completos en lugar de siglas
    - Entradas y salidas: el día con su nombre completo y la fecha (Lunes 12/10) en lugar de L, M, M…
    - Días de stock como «15 días»; seguridad y máximo sin abreviar; «Punto de pedido» y «Máximo» en
    las tablas; etapas del mapa de flujo con el nombre completo de cada control; «Insumos manuales,
    recargas y carros» en vez de «Ins.».
    - Lugares del PT con el producto completo (Nuevo / Cilindro / Carro / Cilindro de carro / Sustituto).
    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
2026-10-23 Trazabilidad: layout sobre el plano rev22 (planta integrada carros + manuales)
    - El layout usa de fondo el plano_carros_rev22 en metros (WebP), con zoom y arrastre.
    - 73 puestos ubicados sobre el plano (recargas, MP, corte y marcado, manuales, carros, PT) y
    recorridos según sus circuitos; paredes y portones sacados del PDF para que los tramos vayan
    por los pasillos (caminos.js).
    - Fichas asignadas a los puestos del rev22 (marcadora 1 y 2, M3/M3b, PH manuales y de carros,
    13 carga y presurización, 16 y 16c, R8/R20/R21, trazabilidad de MP y de PT).
    - Se reemplazan layout_rev10.json y catalogo_gestion.json por rev22/ (generar_rev22.py).
    - Word: sección 6 con el plano rev22.
    Co-Authore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
